BrownSpaceEngineering/EquiSat-EAGLE/projects/EQUiSat/ProgrammerBoard/OutputFiles/ProgrammerBoardV1_1_BRD.pdf

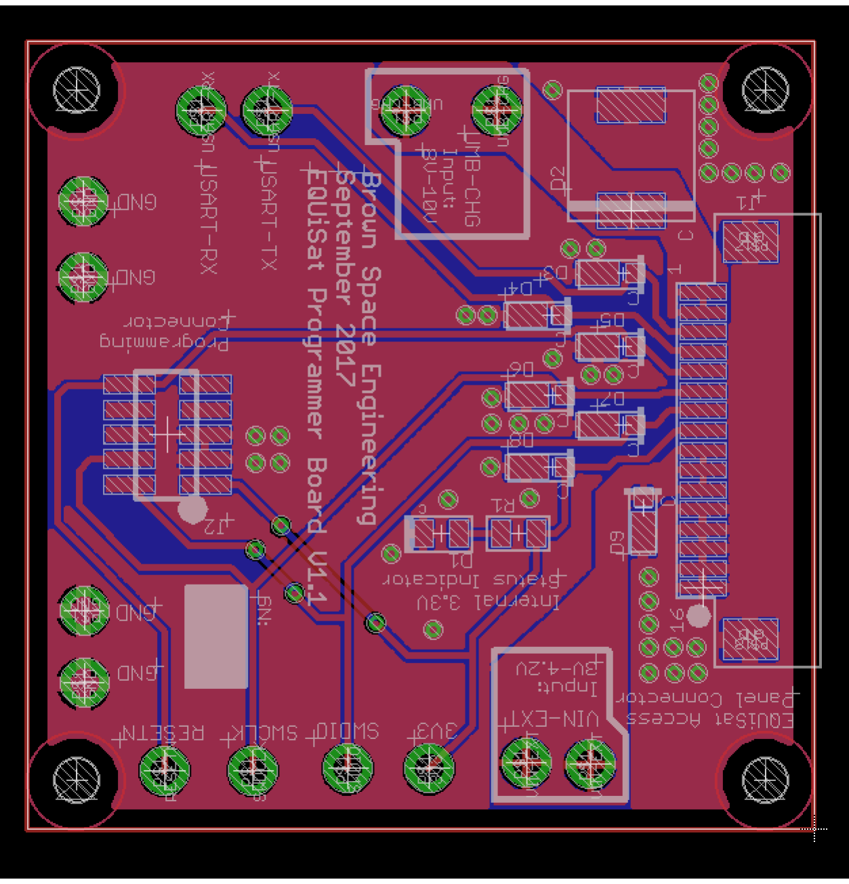
[picture p2: page 1]
