BrownSpaceEngineering/EquiSat-EAGLE/doc/EagleIDFExporterInstructions.pdf

## EAGLE

## IDF

## Exporter

## Instructions

1.

Open

.brd

file

in

the

EAGLE

application.

Run

EagleIDFExporter.ulp.

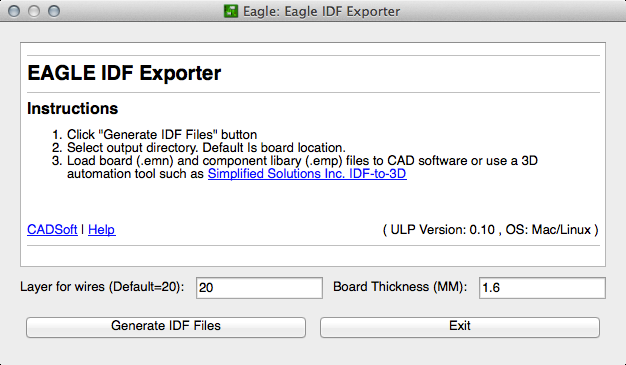
[picture p63: figure]

Update

“Layer

for

wires”

and

“Board

Thickness”

options if

you

do

not

want

to

use
the

default

values.

2.

Click

“Generate

IDF

Files.” You

will

prompted

to

select

the

directory

to

write

the
.emn

and

.emp

IDF

files.

Once

the

files

are

written

you

will

receive

a

confirmation

messages

for

the

files
written.

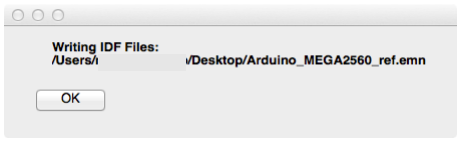
[picture p64: figure]

3.

After

writing

files

the

ULP

will

also

show

you

a

table

with the

packages written
out

to

the

files.

A

default

height

value

is

given

for

the

output

heights

of

the

packages
and

colored

in

yellow.

If

you

set

a

custom

height

the

value

will

be

shown

in

white.

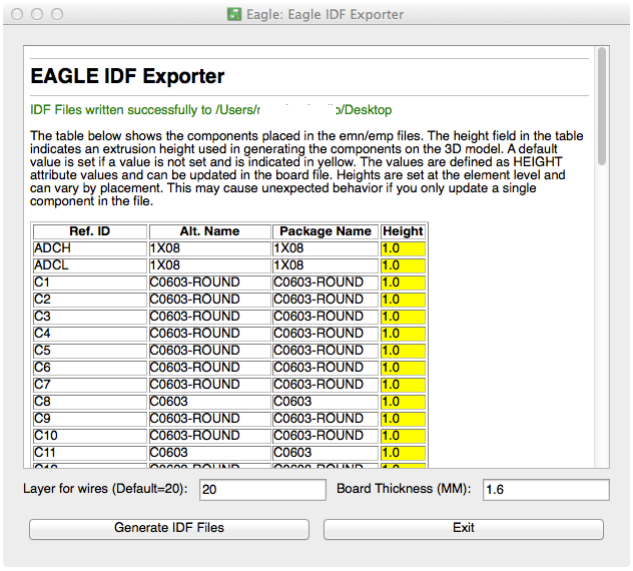
[picture p65: figure]

To

set

custom

heights

select

the

Attribute

Tool

and

then

click

on

a

package.

Create

a
new

attributed

named

HEIGHT

and

set

the

value

the

height

you

would

like

to
extrude

the

package

to.

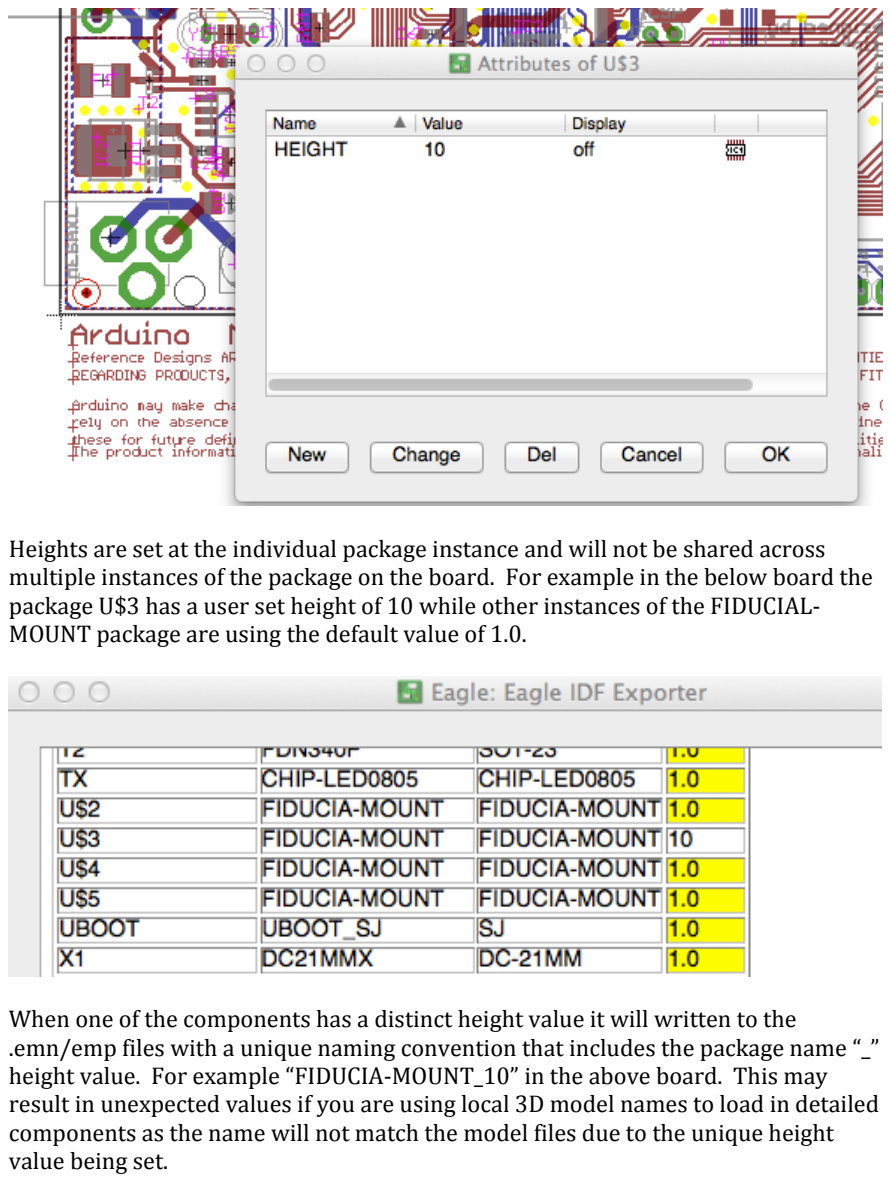
[picture p66: page 3]

Heights

are

set

at

the

individual

package

instance

and

will

not

be

shared

across
multiple

instances

of

the

package

on

the

board.

For

example

in

the

below

board

the
package

U$3

has

a

user

set

height

of

10

while

other

instances

of

the

FIDUCIAL-‐
MOUNT

package

are

using

the

default

value

of

1.0.

When

one

of

the

components

has

a

distinct

height

value

it

will

written

to

the
.emn/emp

files

with

a

unique

naming

convention

that

includes

the

package

name

“_”
height

value.

For

example

“FIDUCIA-‐MOUNT_10”

in

the

above

board.

This

may
result

in

unexpected

values

if

you

are

using

local

3D

model

names to

load

in

detailed
components

as

the

name

will

not

match

the

model

files

due

to

the

unique

height
value

being

set.
