BrownSpaceEngineering/EquiSat-EAGLE/projects/EQUiSat/ControlBoard/Gerbers/ProcessorTestBoardV2.TXT

%
M48
M72
T01C0.01575
T02C0.01969
T03C0.02000
T04C0.02400
T05C0.03150
T06C0.06000
T07C0.10000
T08C0.12500
%
T01
X55202Y103272
X113272Y135753
X163485Y111894
X177265Y84335
X199902Y103020
X223635Y78178
X191603Y58446
X203855Y146375
X176170Y196808
X162485Y212524
X171343Y231225
X194526Y213898
X209729Y212524
X207761Y227288
X236304Y207603
X146737Y229257
X126068Y197761
X133942Y195792
X104336Y209728
X67776Y225288
X44902Y205635
X66713Y191855
T02
X87217Y176312
X91217Y195312
X126217Y162312
X149217Y149312
X157217Y144312
X163217Y142312
X160217Y122312
X146737Y107209
X157217Y98312
X148217Y92312
X148217Y78312
X162217Y79312
X177217Y92312
X186217Y72312
X196217Y63312
X200217Y53312
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
