BrownSpaceEngineering/EquiSat-EAGLE/projects/EQUiSat/BatteryBoard/BatteryBoardV3OutputFiles/BatteryBoardV3_SCH.pdf

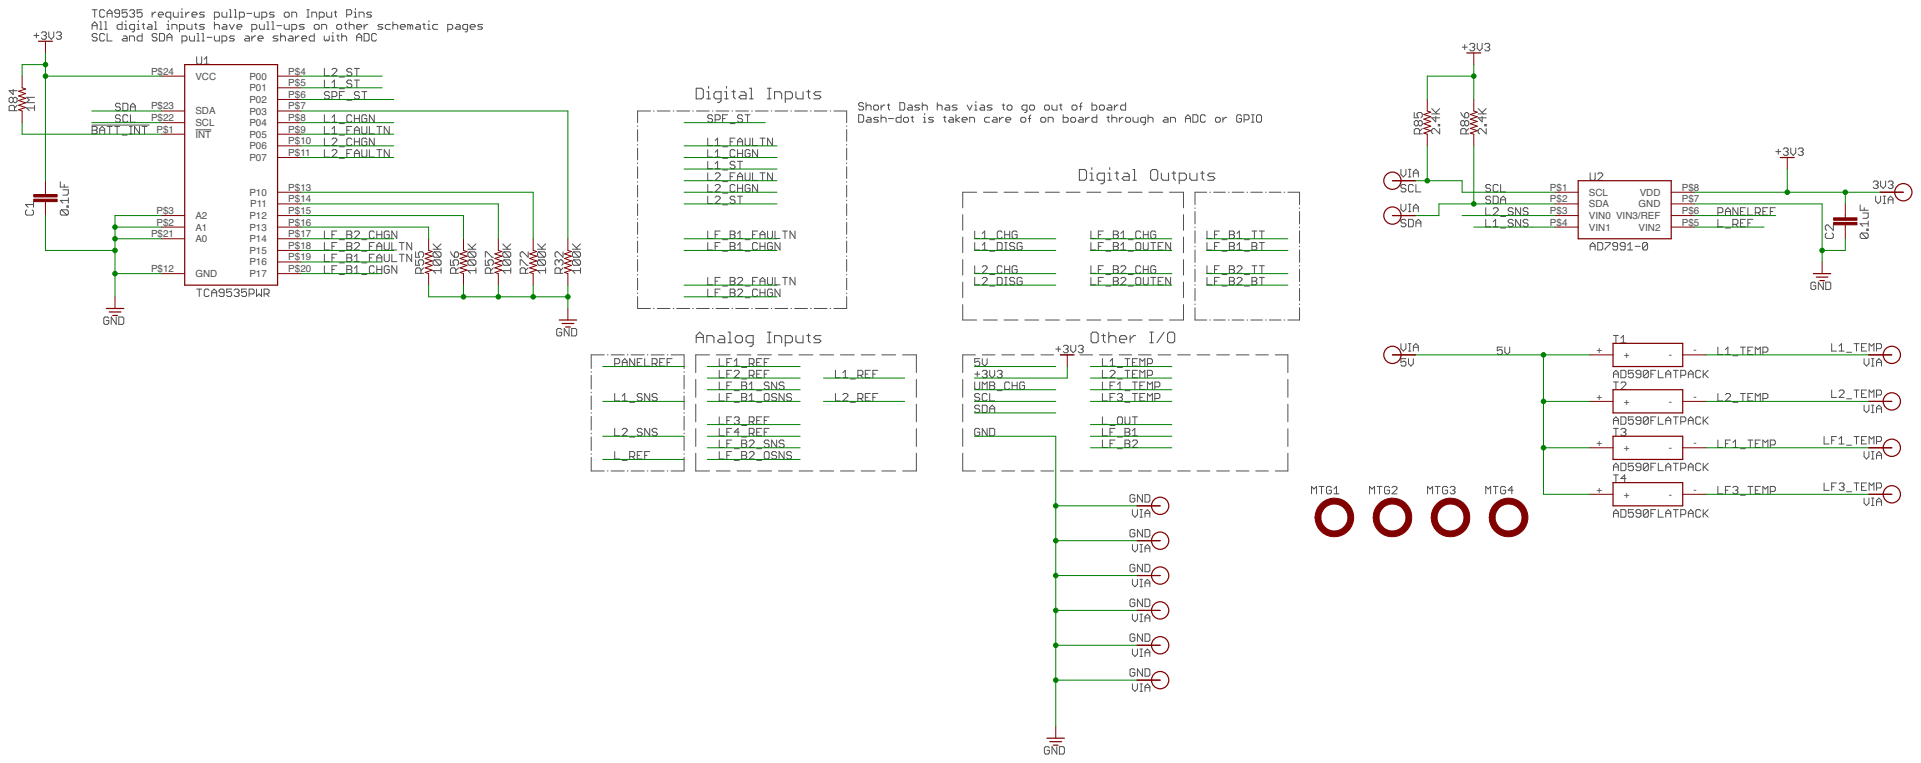
[picture p90: page 1]

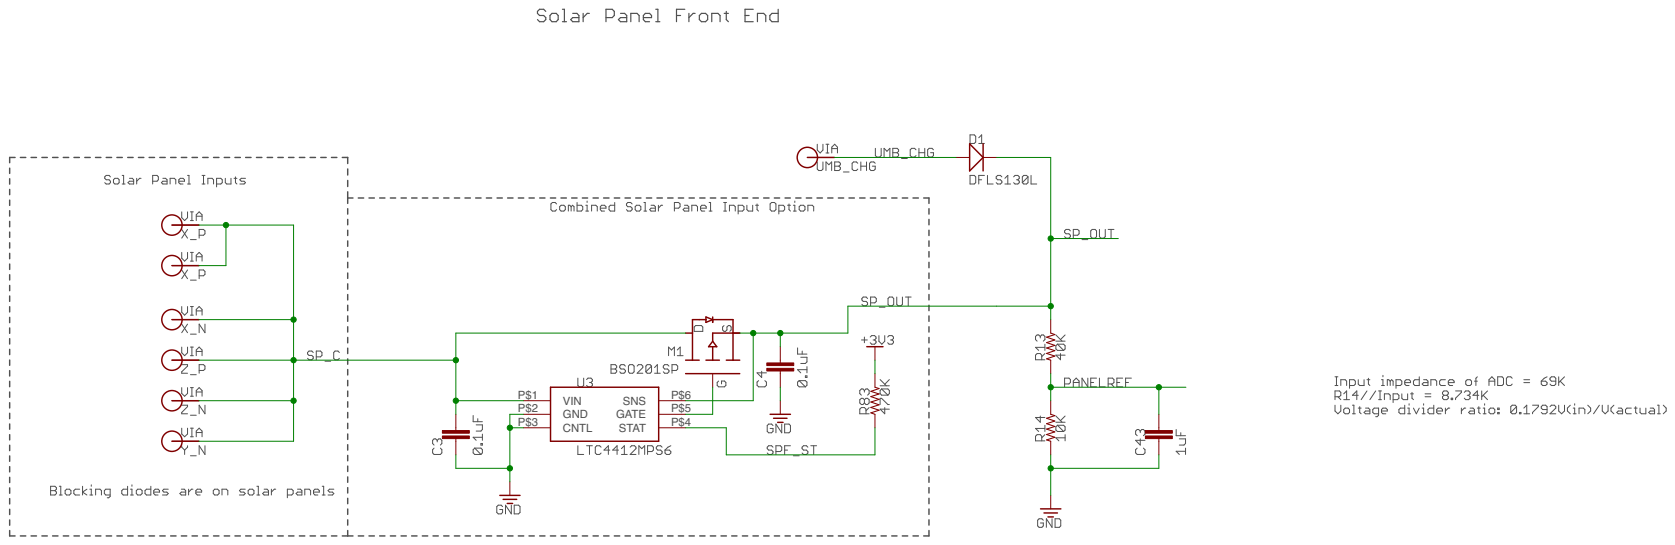
[picture p91: page 2]

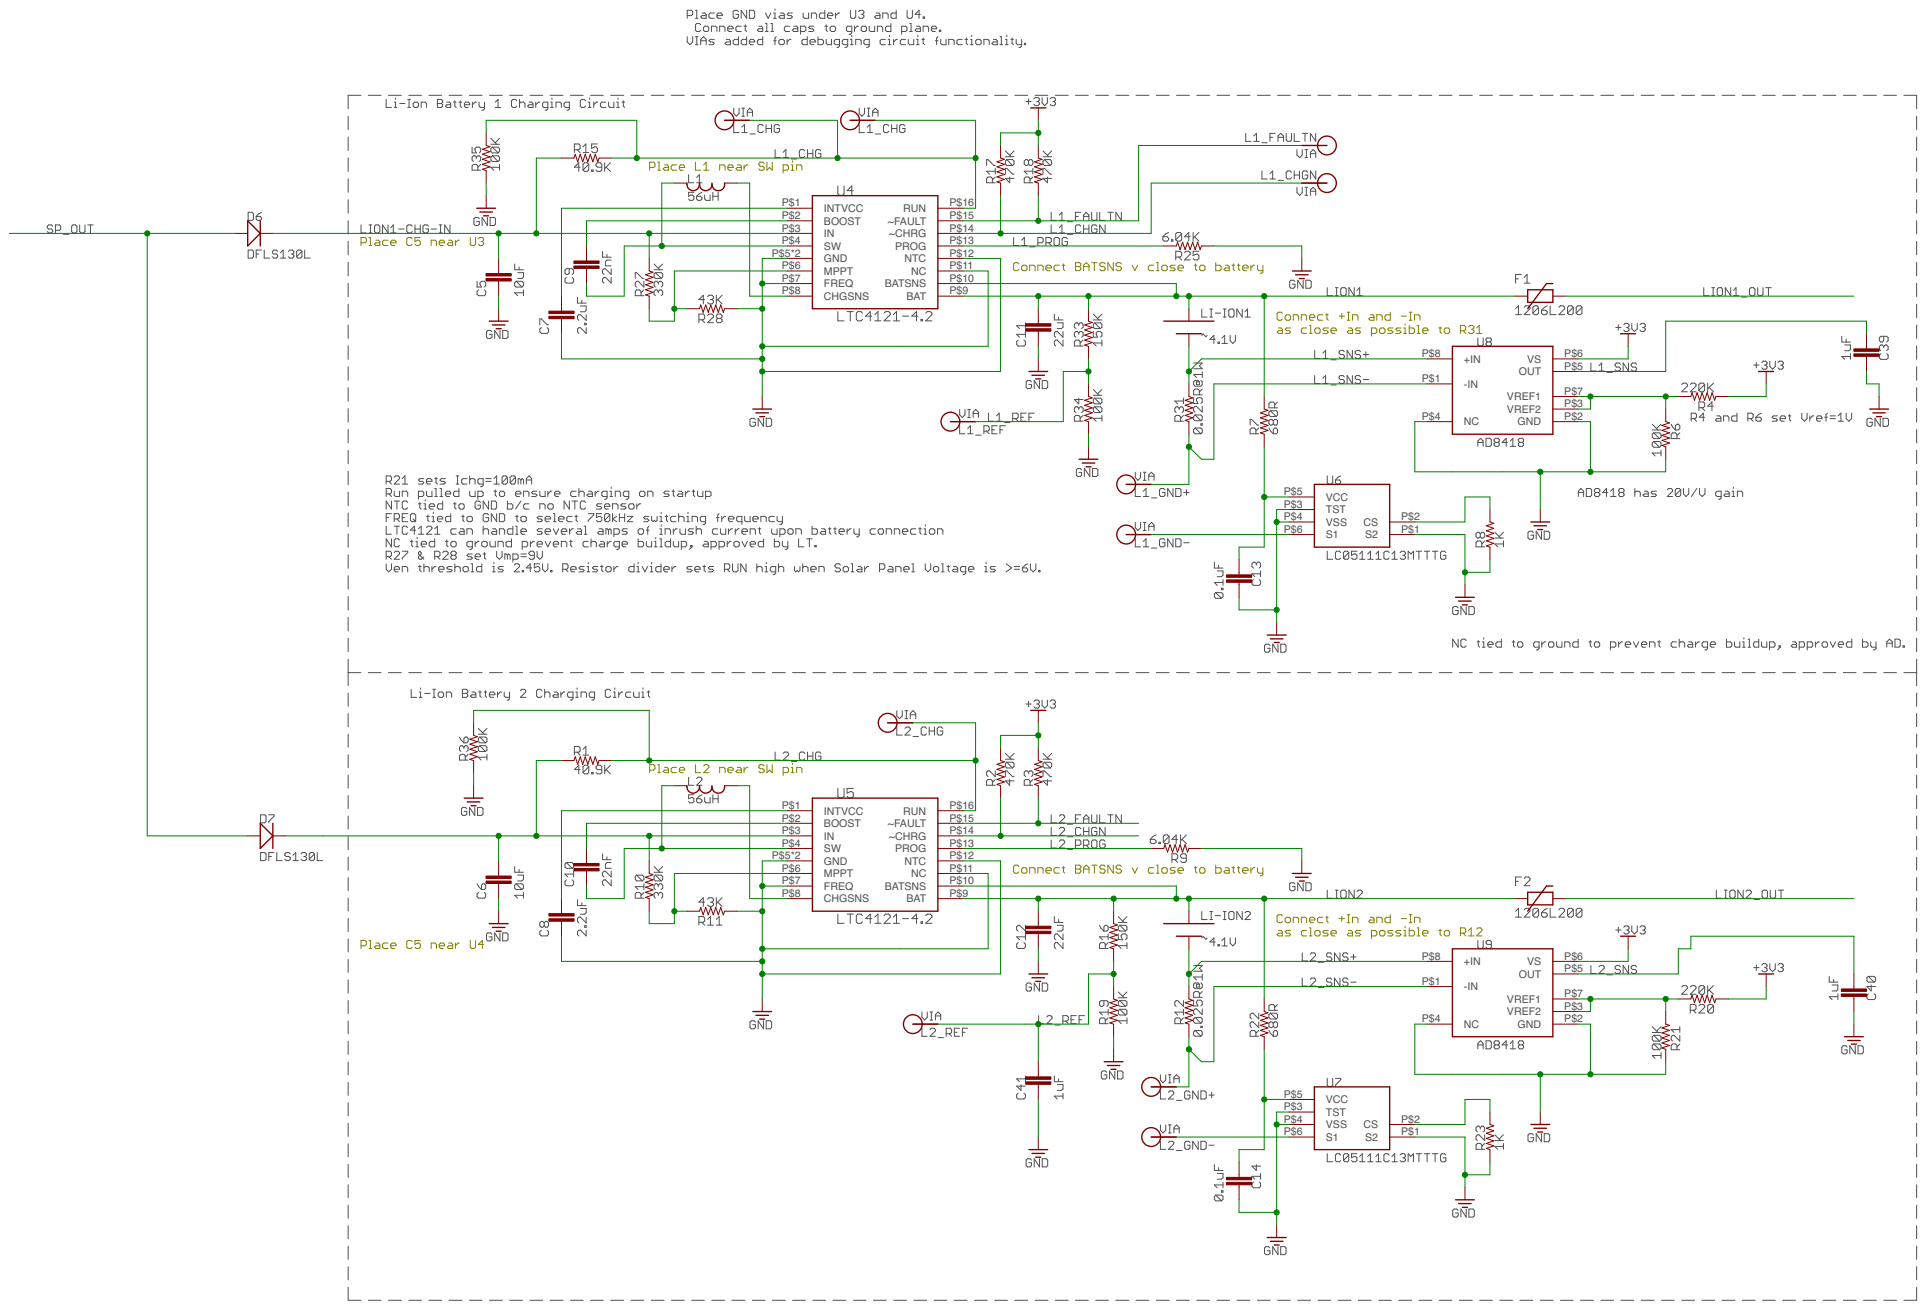
[picture p92: page 3]

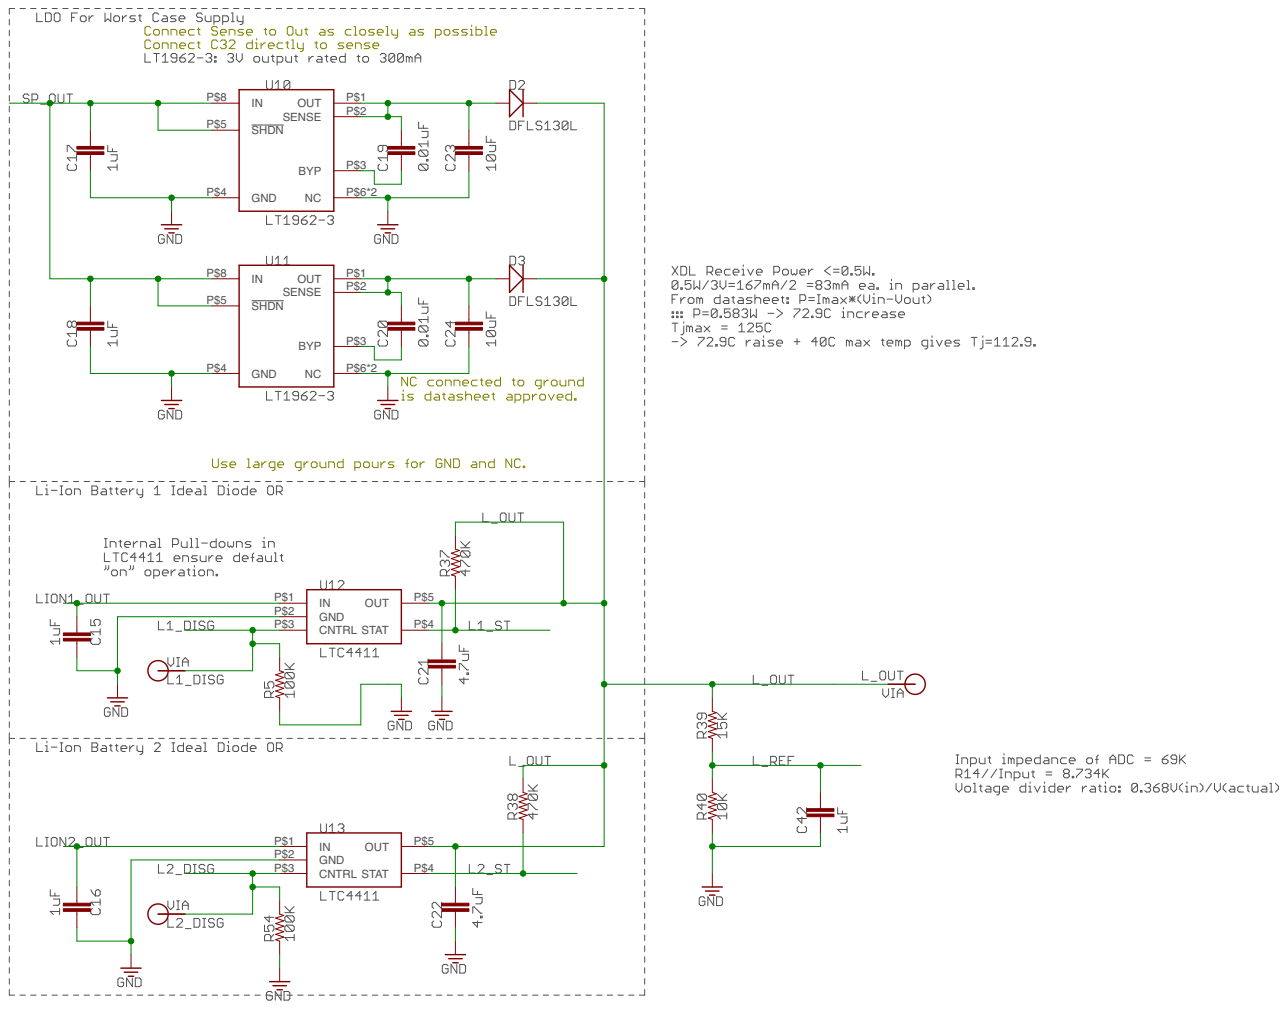
[picture p93: page 4]

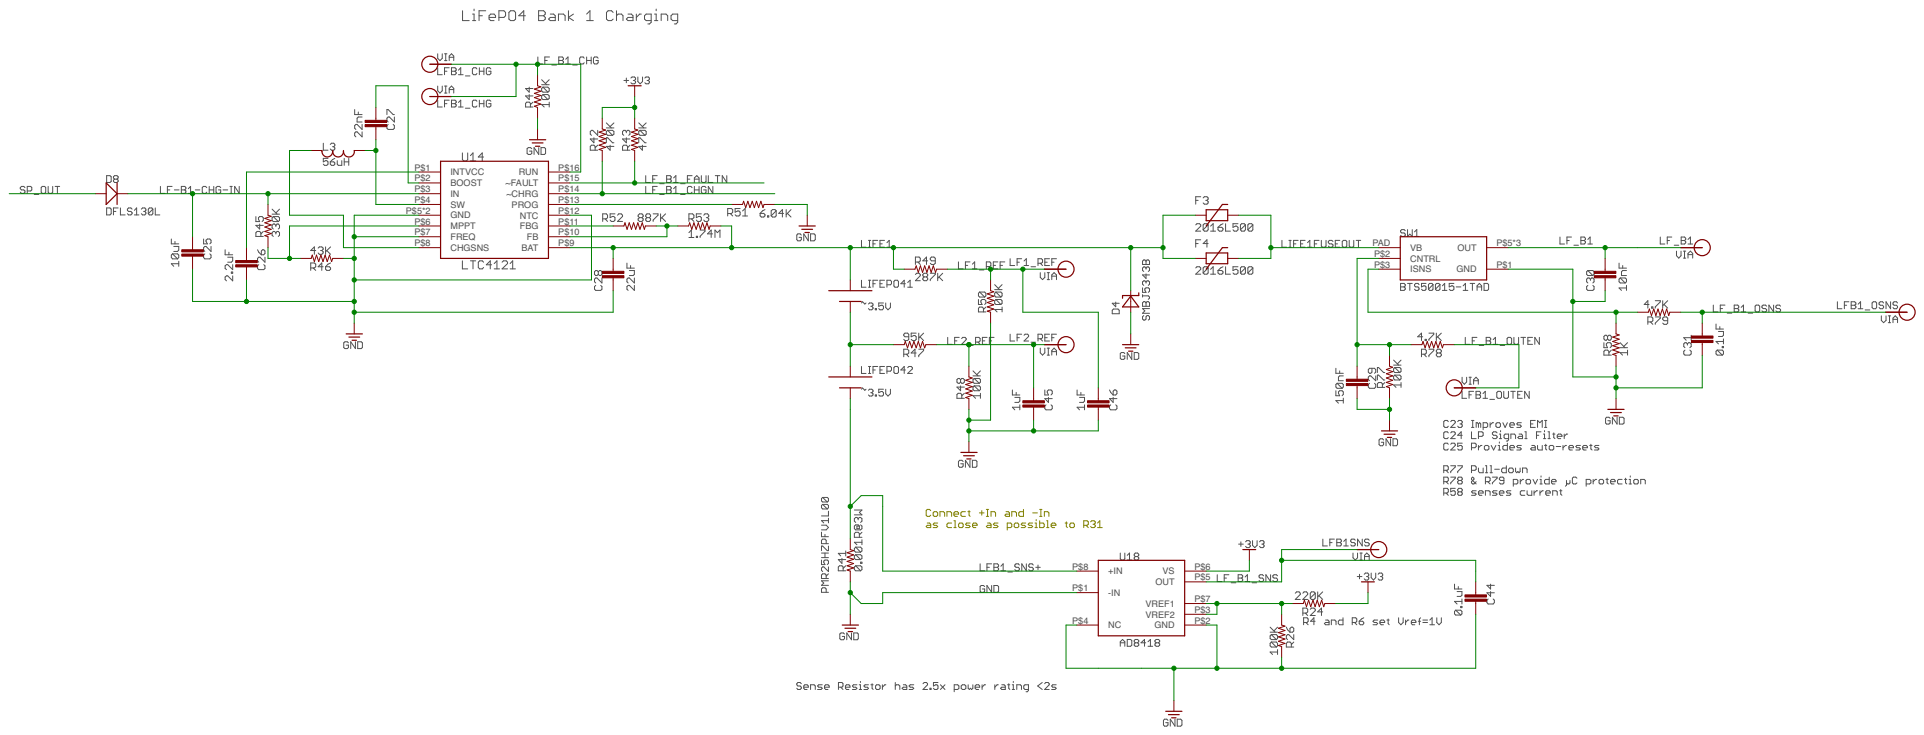
[picture p94: page 5]

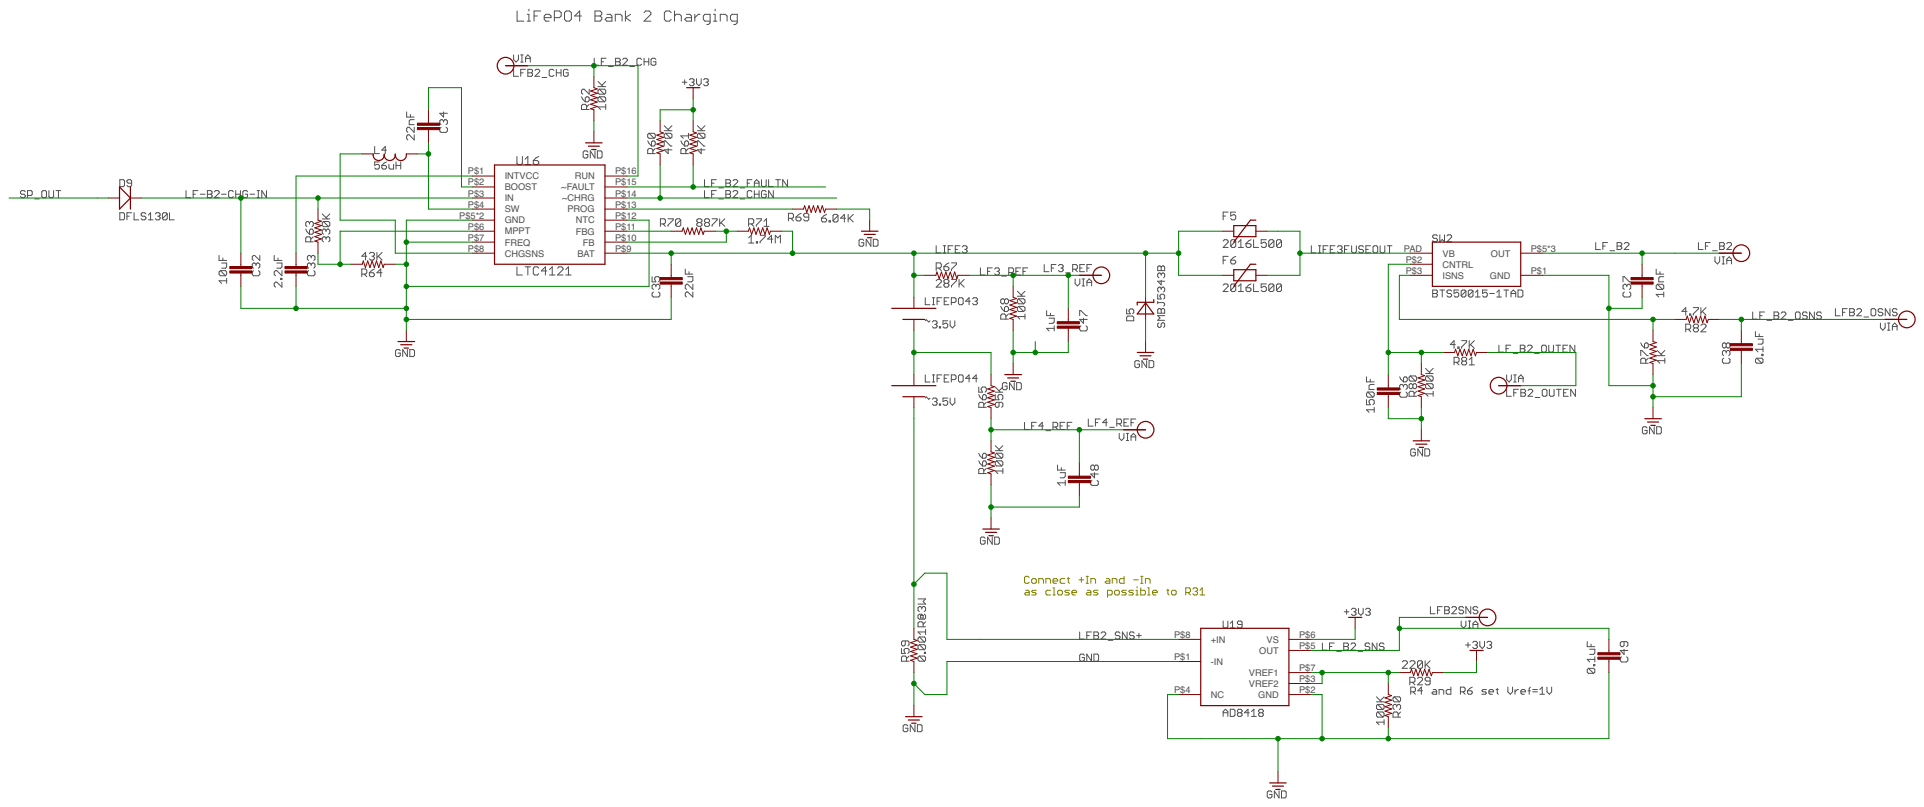
[picture p95: page 6]
