BrownSpaceEngineering/EquiSat-EAGLE/projects/EQUiSat/ProgrammerBoard/OutputFiles/ProgrammerBoardV1_1.pdf

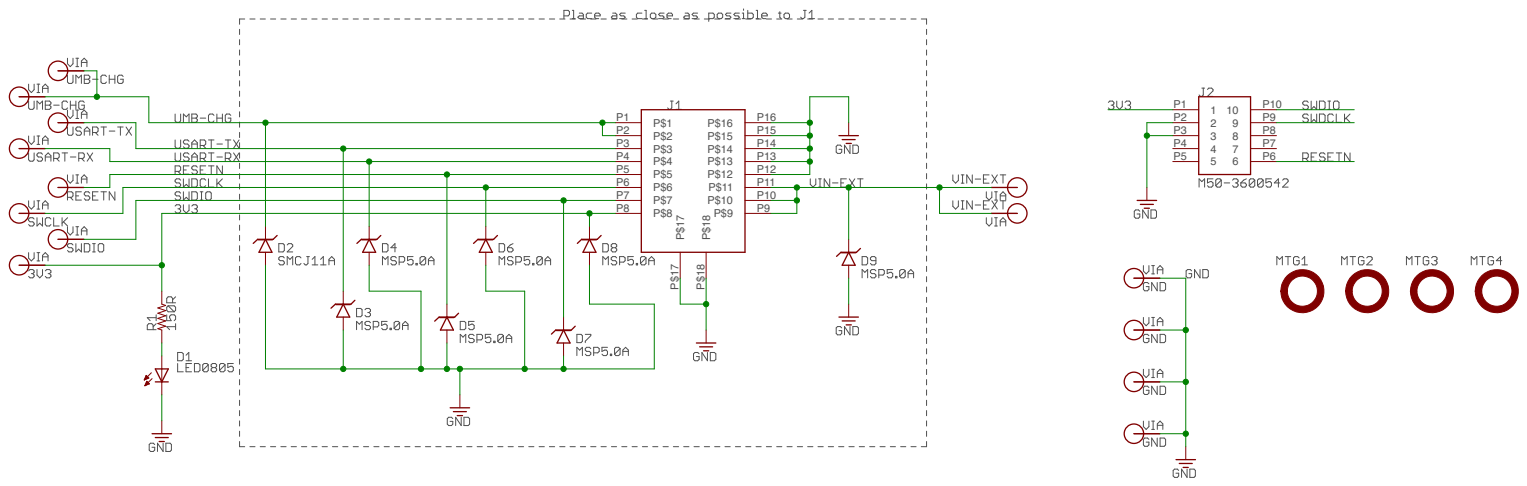
[picture p102: page 1]
