BrownSpaceEngineering/EquiSat-EAGLE/projects/EAGLETutorials/Completed Tutorial/Tutorial1.brd

## EAGLE design projects/EAGLETutorials/Completed Tutorial/Tutorial1.brd (2016-07-10)

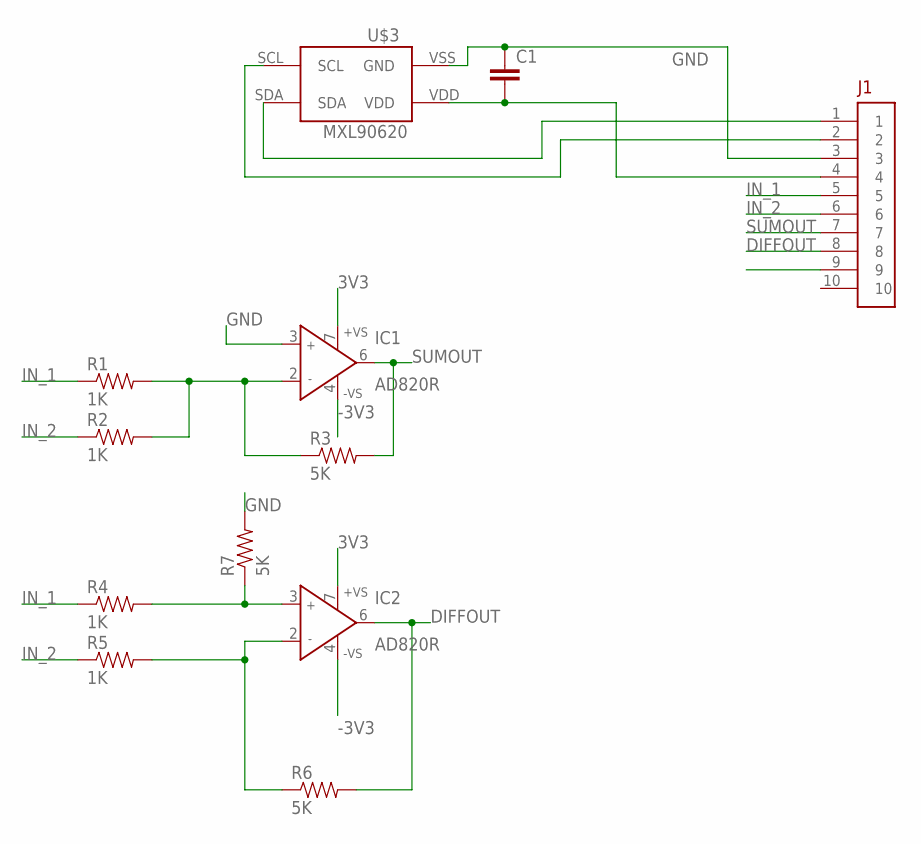
[picture p103: schematic Tutorial1.sch]

Parts:
C1: CAP0805; 0805
IC1, IC2: AD820R; SO8
J1: M50-3120545; 10PINFEMALE
R1, R2, R4, R5: 1K; 0805
R3, R6, R7: 5K; 0805
U$3: MXL90620

Connections:
3V3: C1.2, IC1.7 (+VS), IC2.7 (+VS), J1.4, U$3.VDD
-3V3: IC1.4 (-VS), IC2.4 (-VS), J1.9
DIFFOUT: IC2.6 (OUT), J1.8, R6.2
GND: C1.1, IC1.3 (IN+), J1.3, R7.2, U$3.VSS (GND)
IN_1: J1.5, R1.1, R4.1
IN_2: J1.6, R2.1, R5.1
unnamed: IC1.2 (IN-), R1.2, R2.2, R3.1
unnamed: J1.1, U$3.SDA
unnamed: J1.2, U$3.SCL
unnamed: IC2.2 (IN-), R5.2, R6.1
unnamed: IC2.3 (IN+), R4.2, R7.1
SUMOUT: IC1.6 (OUT), J1.7, R3.2

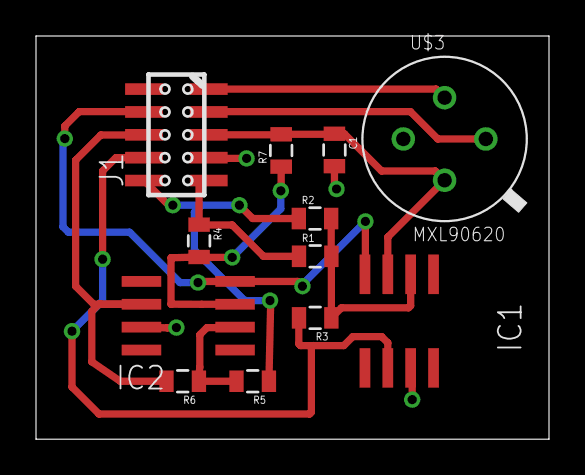
[picture p104: board Tutorial1.brd from above]

Board: 2 copper layers, 28.5 x 22.4 mm, 12 parts (0 on the bottom side), 12 nets.
