BrownSpaceEngineering/EquiSat-EAGLE/projects/EQUiSat/ControlBoard/CntrlBoardV3B.brd

## EAGLE design projects/EQUiSat/ControlBoard/CntrlBoardV3B.brd (2017-10-26)

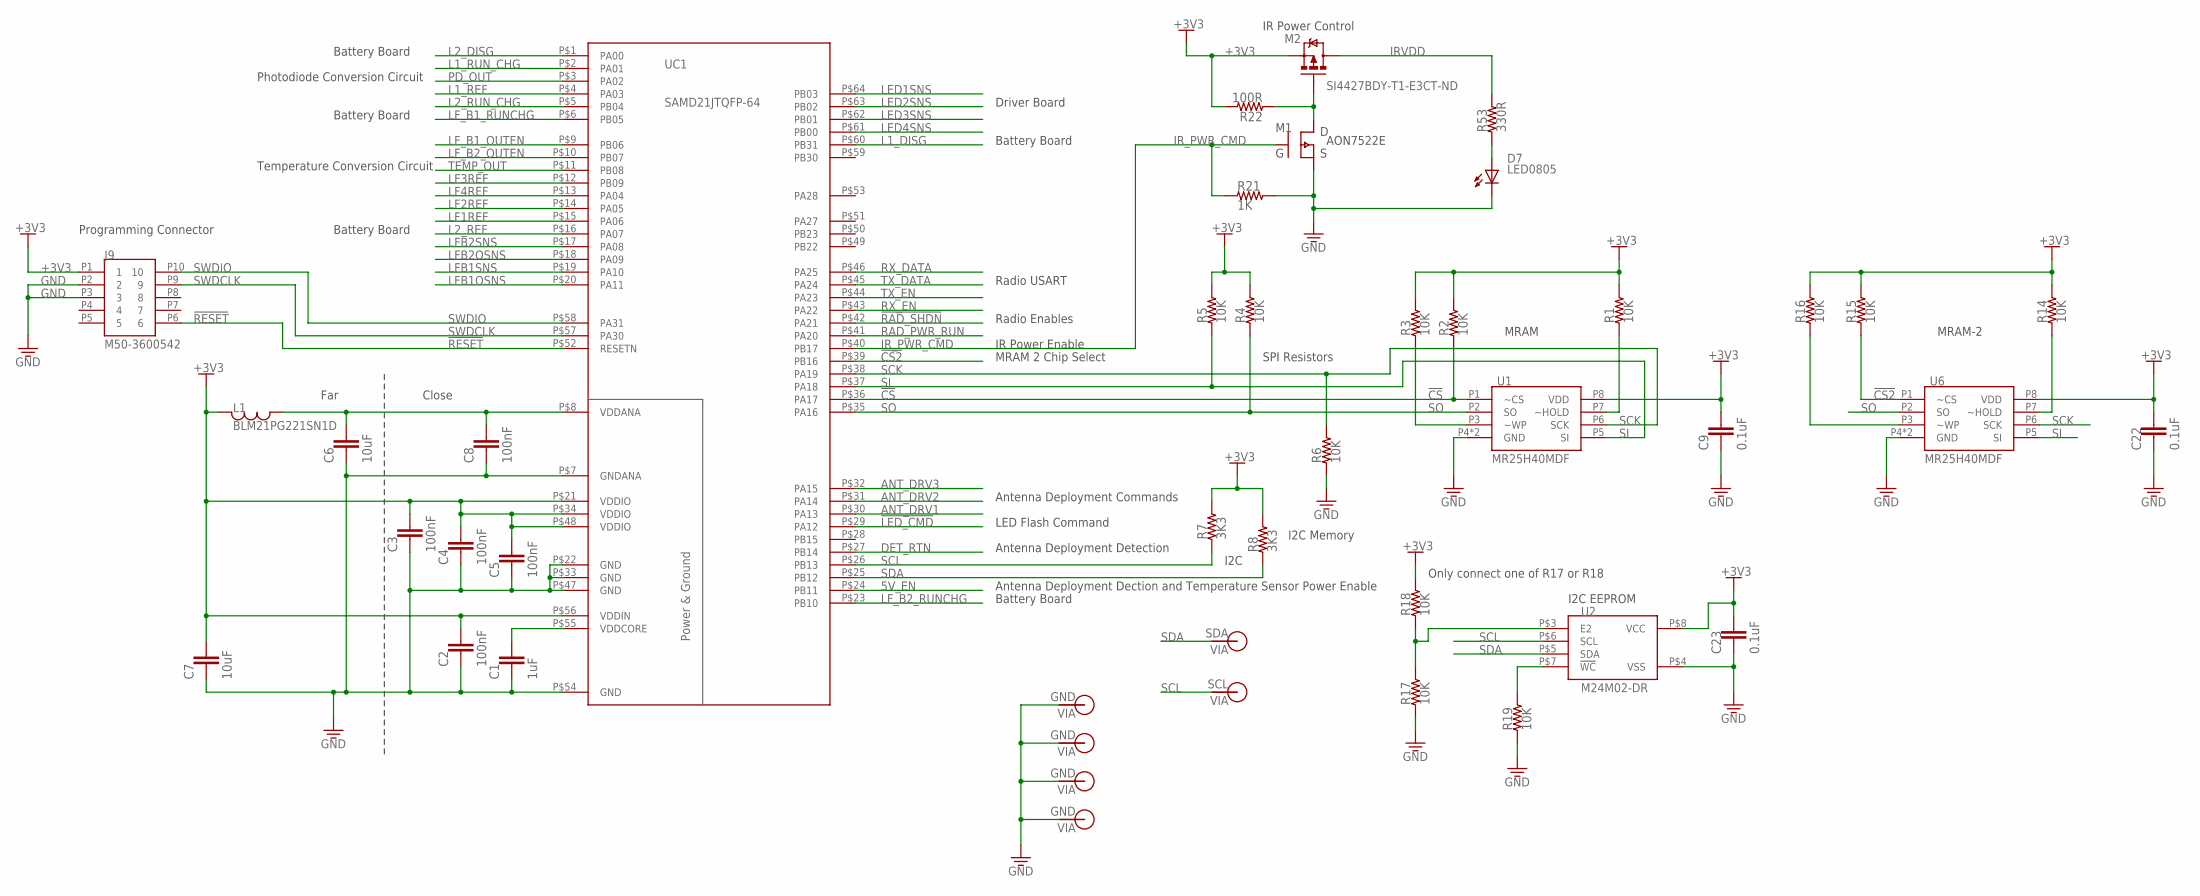
[picture p105: schematic CntrlBoardV3B.sch, sheet 1, µC, MRAM, I2C Memory, and Peripherals]

Parts:
C1: 1uF; 0805
C2, C3, C4, C5, C8: 100nF; 0805
C6, C7: 10uF; 0805
C9, C22, C23: 0.1uF; 0805
D7: LED0805; 0805-D
J9: M50-3600542; 10PINMALE
L1: BLM21PG221SN1D; 0805
M1: AON7522E; DFN-3X3-8
M2: SI4427BDY-T1-E3CT-ND; SO08
R1, R2, R3, R4, R5, R6, R14, R15, R16, R17, R18, R19: 10K; 0805
R7, R8: 3K3; 0805
R21: 1K; 0805
R22: 100R; 0805
R53: 330R; 0805
U1, U6: MR25H40MDF; 8PXMO-229
U2: M24M02-DR; SO-8
UC1: SAMD21JTQFP-64; TQFP-64
V4: SDA; VIA-60MIL-SQ
V5: SCL; VIA-60MIL-SQ
V9, V10, V11, V12: GND; VIA-60MIL-SQ

Connections:
5V_EN: UC1.P$24 (PB11); also elsewhere on the board
!CS2!: R15.1, U6.P1 (~CS), UC1.P$39 (PB16)
!CS!: R2.1, U1.P1 (~CS), UC1.P$36 (PA17)
!LED_CMD!: UC1.P$29 (PA12); also elsewhere on the board
!RAD_SHDN!: UC1.P$42 (PA21); also elsewhere on the board
!RESET!: J9.P6 (6), UC1.P$52 (RESETN); also elsewhere on the board
+3V3: C2.1, C3.1, C4.1, C5.1, C7.1, C9.1, C22.1, C23.1, J9.P1 (1), L1.1, M2.1 (S), M2.2 (S), M2.3 (S), R1.2, R2.2, R3.2, R4.2, R5.2, R7.2, R8.2, R14.2, R15.2, R16.2, R18.2, R22.2, U1.P8 (VDD), U2.P$8 (VCC), U6.P8 (VDD), UC1.P$21 (VDDIO), UC1.P$34 (VDDIO), UC1.P$48 (VDDIO), UC1.P$56 (VDDIN); also elsewhere on the board
ANT_DRV1: UC1.P$30 (PA13); also elsewhere on the board
ANT_DRV2: UC1.P$31 (PA14); also elsewhere on the board
ANT_DRV3: UC1.P$32 (PA15); also elsewhere on the board
DET_RTN: UC1.P$27 (PB14); also elsewhere on the board
GND: C1.2, C2.2, C3.2, C4.2, C5.2, C6.2, C7.2, C8.2, C9.2, C22.2, C23.2, D7.C, J9.P2 (2), J9.P3 (3), M1.P$1 (S), M1.P$2 (S), M1.P$3 (S), R6.1, R17.1, R19.1, R21.2, U1.P4 (GND), U1.P9 (GND), U2.P$4 (VSS), U6.P4 (GND), U6.P9 (GND), UC1.P$7 (GNDANA), UC1.P$22 (GND), UC1.P$33 (GND), UC1.P$47 (GND), UC1.P$54 (GND), V9.P$1, V10.P$1, V11.P$1, V12.P$1; also elsewhere on the board
IRVDD: M2.5 (D), M2.6 (D), M2.7 (D), M2.8 (D), R53.2; also elsewhere on the board
IR_PWR_CMD: M1.P$4 (G), R21.1, UC1.P$40 (PB17)
L1_DISG: UC1.P$60 (PB31); also elsewhere on the board
L1_REF: UC1.P$4 (PA03); also elsewhere on the board
L1_RUN_CHG: UC1.P$2 (PA01); also elsewhere on the board
L2_DISG: UC1.P$1 (PA00); also elsewhere on the board
L2_REF: UC1.P$16 (PA07); also elsewhere on the board
L2_RUN_CHG: UC1.P$5 (PB04); also elsewhere on the board
LED1SNS: UC1.P$64 (PB03); also elsewhere on the board
LED2SNS: UC1.P$63 (PB02); also elsewhere on the board
LED3SNS: UC1.P$62 (PB01); also elsewhere on the board
LED4SNS: UC1.P$61 (PB00); also elsewhere on the board
LF1REF: UC1.P$15 (PA06); also elsewhere on the board
LF2REF: UC1.P$14 (PA05); also elsewhere on the board
LF3REF: UC1.P$12 (PB09); also elsewhere on the board
LF4REF: UC1.P$13 (PA04); also elsewhere on the board
LFB1OSNS: UC1.P$20 (PA11); also elsewhere on the board
LFB1SNS: UC1.P$19 (PA10); also elsewhere on the board
LFB2OSNS: UC1.P$18 (PA09); also elsewhere on the board
LFB2SNS: UC1.P$17 (PA08); also elsewhere on the board
LF_B1_OUTEN: UC1.P$9 (PB06); also elsewhere on the board
LF_B1_RUNCHG: UC1.P$6 (PB05); also elsewhere on the board
LF_B2_OUTEN: UC1.P$10 (PB07); also elsewhere on the board
LF_B2_RUNCHG: UC1.P$23 (PB10); also elsewhere on the board
unnamed: C6.1, C8.1, L1.2, UC1.P$8 (VDDANA)
unnamed: C1.1, UC1.P$55 (VDDCORE)
unnamed: R3.1, U1.P3 (~WP)
unnamed: R1.1, U1.P7 (~HOLD)
unnamed: R16.1, U6.P3 (~WP)
unnamed: R14.1, U6.P7 (~HOLD)
unnamed: R17.2, R18.1, U2.P$3 (E2)
unnamed: R19.2, U2.P$7 (!WC!)
unnamed: M1.P$5 (D), M1.P$6 (D), M1.P$7 (D), M1.P$8 (D), M1.PAD (D), M2.4 (G), R22.1
unnamed: D7.A, R53.1
PD_OUT: UC1.P$3 (PA02); also elsewhere on the board
RAD_PWR_RUN: UC1.P$41 (PA20); also elsewhere on the board
RX_DATA: UC1.P$46 (PA25); also elsewhere on the board
RX_EN: UC1.P$43 (PA22); also elsewhere on the board
SCK: R6.2, U1.P6 (SCK), U6.P6 (SCK), UC1.P$38 (PA19)
SCL: R7.1, U2.P$6 (SCL), UC1.P$26 (PB13), V5.P$1; also elsewhere on the board
SDA: R8.1, U2.P$5 (SDA), UC1.P$25 (PB12), V4.P$1; also elsewhere on the board
SI: R5.1, U1.P5 (SI), U6.P5 (SI), UC1.P$37 (PA18)
SO: R4.1, U1.P2 (SO), U6.P2 (SO), UC1.P$35 (PA16)
SWDCLK: J9.P9 (9), UC1.P$57 (PA30); also elsewhere on the board
SWDIO: J9.P10 (10), UC1.P$58 (PA31); also elsewhere on the board
TEMP_OUT: UC1.P$11 (PB08); also elsewhere on the board
TX_DATA: UC1.P$45 (PA24); also elsewhere on the board
TX_EN: UC1.P$44 (PA23); also elsewhere on the board

Notes on the sheet:
Close
Far
Programming Connector
MRAM
I2C Memory
I2C
Battery Board
Temperature Conversion Circuit
Photodiode Conversion Circuit
Radio USART
IR Power Enable
Radio Enables
Antenna Deployment Commands
LED Flash Command
Antenna Deployment Detection
Antenna Deployment Dection and Temperature Sensor Power Enable
MRAM-2
MRAM 2 Chip Select
SPI Resistors
Only connect one of R17 or R18
I2C EEPROM
IR Power Control
Driver Board

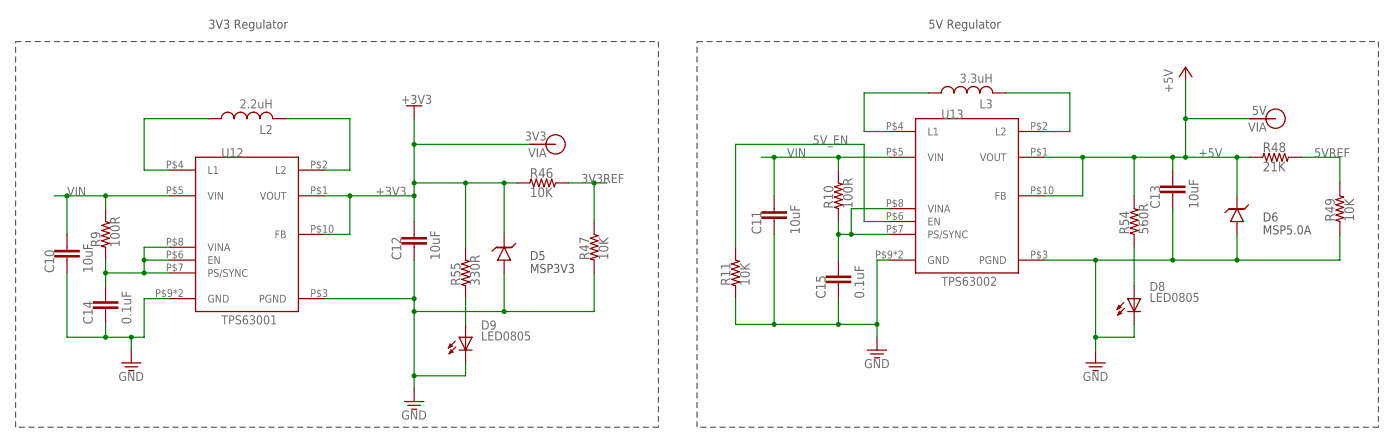
[picture p106: schematic CntrlBoardV3B.sch, sheet 2, Power Regulation]

Parts:
C10, C11, C12, C13: 10uF; 0805
C14, C15: 0.1uF; 0805
D5: MSP3V3; MICROSMP
D6: MSP5.0A; MICROSMP
D8, D9: LED0805; 0805-D
L2: 2.2uH; L3225M
L3: 3.3uH; L3225M
R9, R10: 100R; 0805
R11, R46, R47, R49: 10K; 0805
R48: 21K; 0805
R54: 560R; 0805
R55: 330R; 0805
U12: TPS63001; QFN10_POWERPAD
U13: TPS63002; QFN10_POWERPAD
V13: 3V3; VIA-60MIL-SQ
V14: 5V; VIA-60MIL-SQ

Connections:
3V3REF: R46.2, R47.2; also elsewhere on the board
5VREF: R48.2, R49.2; also elsewhere on the board
5V_EN: R11.2, U13.P$6 (EN); also elsewhere on the board
+3V3: C12.1, D5.C, R46.1, R55.2, U12.P$1 (VOUT), U12.P$10 (FB), V13.P$1; also elsewhere on the board
+5V: C13.1, D6.C, R48.1, R54.2, U13.P$1 (VOUT), U13.P$10 (FB), V14.P$1; also elsewhere on the board
GND: C10.2, C11.2, C12.2, C13.2, C14.2, C15.2, D5.A, D6.A, D8.C, D9.C, R11.1, R47.1, R49.1, U12.P$3 (PGND), U12.P$9 (GND), U12.PAD (GND), U13.P$3 (PGND), U13.P$9 (GND), U13.PAD (GND); also elsewhere on the board
unnamed: L2.1, U12.P$4 (L1)
unnamed: L2.2, U12.P$2 (L2)
unnamed: L3.1, U13.P$4 (L1)
unnamed: L3.2, U13.P$2 (L2)
unnamed: C14.1, R9.1, U12.P$6 (EN), U12.P$7 (PS/SYNC), U12.P$8 (VINA)
unnamed: C15.1, R10.1, U13.P$7 (PS/SYNC), U13.P$8 (VINA)
unnamed: D8.A, R54.1
unnamed: D9.A, R55.1
VIN: C10.1, C11.1, R9.2, R10.2, U12.P$5 (VIN), U13.P$5 (VIN); also elsewhere on the board

Notes on the sheet:
3V3 Regulator
5V Regulator

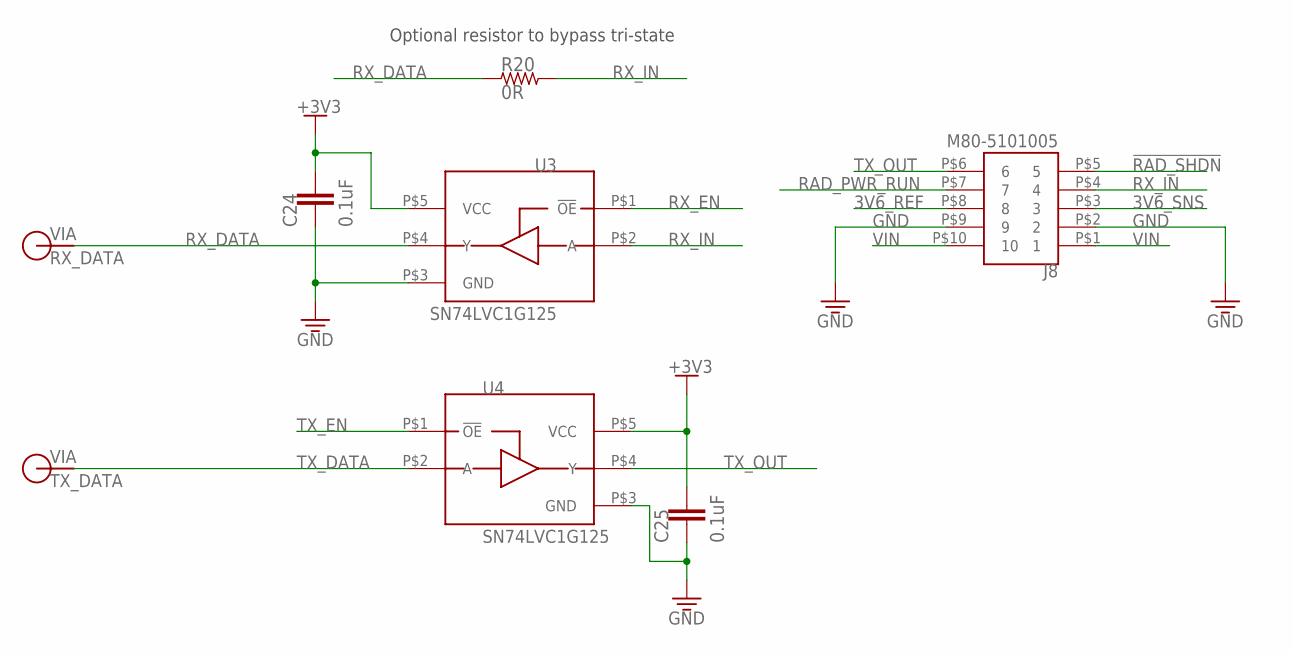
[picture p107: schematic CntrlBoardV3B.sch, sheet 3, Radio]

Parts:
C24, C25: 0.1uF; 0805
J8: M80-5101005; M80-510
R20: 0R; 0805
U3, U4: SN74LVC1G125; TSOT23-5
V1: RX_DATA; VIA-60MIL-SQ
V2: TX_DATA; VIA-60MIL-SQ

Connections:
3V6_REF: J8.P$8 (8); also elsewhere on the board
3V6_SNS: J8.P$3 (3); also elsewhere on the board
!RAD_SHDN!: J8.P$5 (5); also elsewhere on the board
+3V3: C24.1, C25.1, U3.P$5 (VCC), U4.P$5 (VCC); also elsewhere on the board
GND: C24.2, C25.2, J8.P$2 (2), J8.P$9 (9), U3.P$3 (GND), U4.P$3 (GND); also elsewhere on the board
RAD_PWR_RUN: J8.P$7 (7); also elsewhere on the board
RX_DATA: R20.1, U3.P$4 (Y), V1.P$1; also elsewhere on the board
RX_EN: U3.P$1 (!OE!); also elsewhere on the board
RX_IN: J8.P$4 (4), R20.2, U3.P$2 (A)
TX_DATA: U4.P$2 (A), V2.P$1; also elsewhere on the board
TX_EN: U4.P$1 (!OE!); also elsewhere on the board
TX_OUT: J8.P$6 (6), U4.P$4 (Y)
VIN: J8.P$1 (1), J8.P$10 (10); also elsewhere on the board

Notes on the sheet:
Optional resistor to bypass tri-state

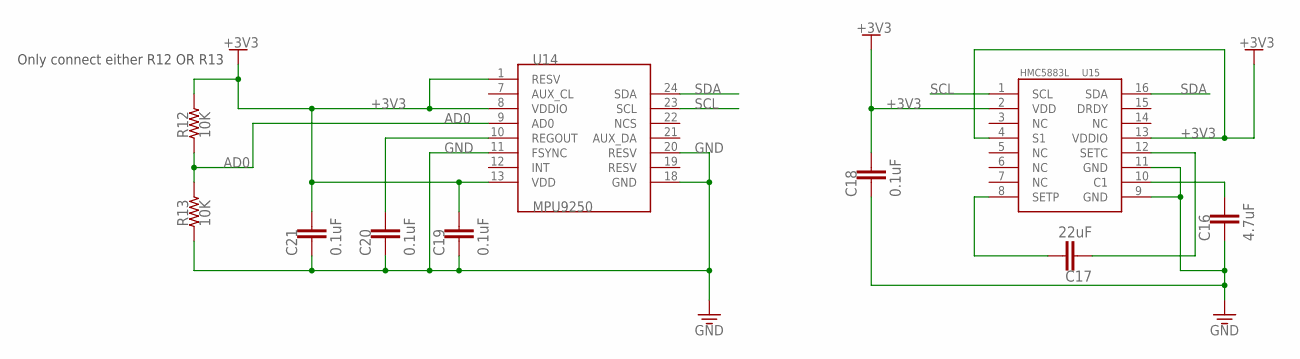
[picture p108: schematic CntrlBoardV3B.sch, sheet 4, Control Board Sensors]

Parts:
C16: 4.7uF; 0805
C17: 22uF; 0805
C18, C19, C20, C21: 0.1uF; 0805
R12, R13: 10K; 0805
U14: MPU9250; QFN-24-3X3
U15: HMC5883L

Connections:
+3V3: C18.1, C19.1, C21.1, R12.2, U14.1 (RESV), U14.8 (VDDIO), U14.13 (VDD), U15.2 (VDD), U15.4 (S1), U15.13 (VDDIO); also elsewhere on the board
AD0: R12.1, R13.2, U14.9 (AD0)
GND: C16.2, C18.2, C19.2, C20.2, C21.2, R13.1, U14.11 (FSYNC), U14.18 (GND), U14.20 (RESV), U15.9 (GND), U15.11 (GND); also elsewhere on the board
unnamed: C16.1, U15.10 (C1)
unnamed: C20.1, U14.10 (REGOUT)
unnamed: C17.2, U15.12 (SETC)
unnamed: C17.1, U15.8 (SETP)
SCL: U14.23 (SCL), U15.1 (SCL); also elsewhere on the board
SDA: U14.24 (SDA), U15.16 (SDA); also elsewhere on the board

Notes on the sheet:
Only connect either R12 OR R13

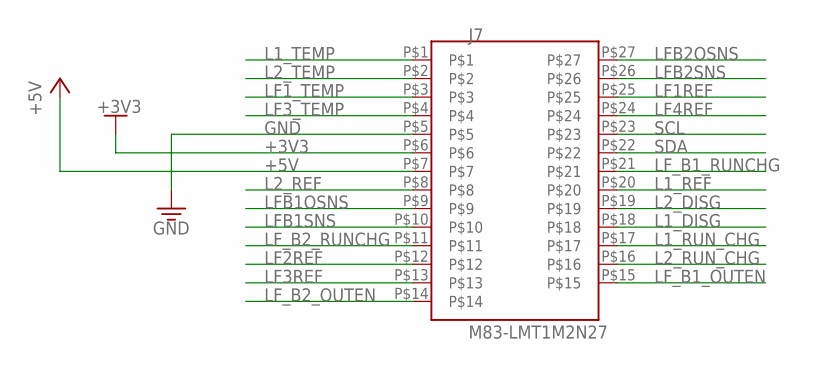
[picture p109: schematic CntrlBoardV3B.sch, sheet 5, Battery Board]

Parts:
J7: M83-LMT1M2N27

Connections:
+3V3: J7.P$6; also elsewhere on the board
+5V: J7.P$7; also elsewhere on the board
GND: J7.P$5; also elsewhere on the board
L1_DISG: J7.P$18; also elsewhere on the board
L1_REF: J7.P$20; also elsewhere on the board
L1_RUN_CHG: J7.P$17; also elsewhere on the board
L1_TEMP: J7.P$1; also elsewhere on the board
L2_DISG: J7.P$19; also elsewhere on the board
L2_REF: J7.P$8; also elsewhere on the board
L2_RUN_CHG: J7.P$16; also elsewhere on the board
L2_TEMP: J7.P$2; also elsewhere on the board
LF1REF: J7.P$25; also elsewhere on the board
LF1_TEMP: J7.P$3; also elsewhere on the board
LF2REF: J7.P$12; also elsewhere on the board
LF3REF: J7.P$13; also elsewhere on the board
LF3_TEMP: J7.P$4; also elsewhere on the board
LF4REF: J7.P$24; also elsewhere on the board
LFB1OSNS: J7.P$9; also elsewhere on the board
LFB1SNS: J7.P$10; also elsewhere on the board
LFB2OSNS: J7.P$27; also elsewhere on the board
LFB2SNS: J7.P$26; also elsewhere on the board
LF_B1_OUTEN: J7.P$15; also elsewhere on the board
LF_B1_RUNCHG: J7.P$21; also elsewhere on the board
LF_B2_OUTEN: J7.P$14; also elsewhere on the board
LF_B2_RUNCHG: J7.P$11; also elsewhere on the board
SCL: J7.P$23; also elsewhere on the board
SDA: J7.P$22; also elsewhere on the board

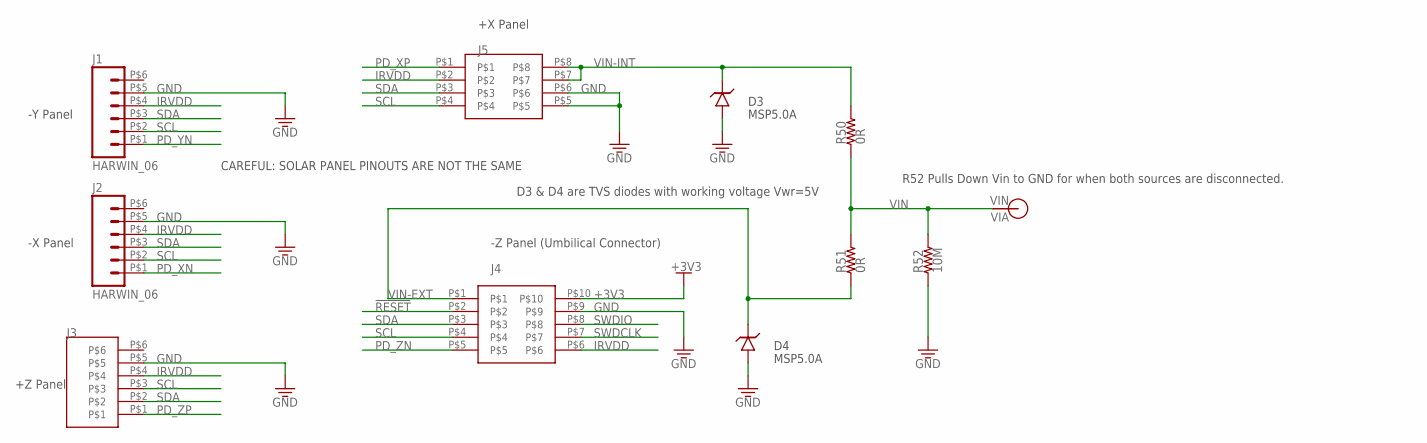
[picture p110: schematic CntrlBoardV3B.sch, sheet 6, Solar Panels]

Parts:
D3, D4: MSP5.0A; MICROSMP
J1, J2: HARWIN_06; HARWIN_DATAMATE_6
J3: M80-54006
J4: M80-54010
J5: M80-54008
R50, R51: 0R; 1210
R52: 10M; 0805
V3: VIN; VIA-60MIL-SQ

Connections:
!RESET!: J4.P$2; also elsewhere on the board
+3V3: J4.P$10; also elsewhere on the board
GND: D3.A, D4.A, J1.P$5 (5), J2.P$5 (5), J3.P$5, J4.P$9, J5.P$5, J5.P$6, R52.1; also elsewhere on the board
IRVDD: J1.P$4 (4), J2.P$4 (4), J3.P$4, J4.P$6, J5.P$2; also elsewhere on the board
PD_XN: J2.P$1 (1); also elsewhere on the board
PD_XP: J5.P$1; also elsewhere on the board
PD_YN: J1.P$1 (1); also elsewhere on the board
PD_ZN: J4.P$5; also elsewhere on the board
PD_ZP: J3.P$1; also elsewhere on the board
SCL: J1.P$2 (2), J2.P$2 (2), J3.P$3, J4.P$4, J5.P$4; also elsewhere on the board
SDA: J1.P$3 (3), J2.P$3 (3), J3.P$2, J4.P$3, J5.P$3; also elsewhere on the board
SWDCLK: J4.P$7; also elsewhere on the board
SWDIO: J4.P$8; also elsewhere on the board
VIN: R50.P$1 (1), R51.P$2 (2), R52.2, V3.P$1; also elsewhere on the board
VIN-EXT: D4.C, J4.P$1, R51.P$1 (1)
VIN-INT: D3.C, J5.P$7, J5.P$8, R50.P$2 (2)

Notes on the sheet:
-Y Panel
-X Panel
+Z Panel
+X Panel
-Z Panel (Umbilical Connector)
R52 Pulls Down Vin to GND for when both sources are disconnected.
D3 & D4 are TVS diodes with working voltage Vwr=5V
CAREFUL: SOLAR PANEL PINOUTS ARE NOT THE SAME

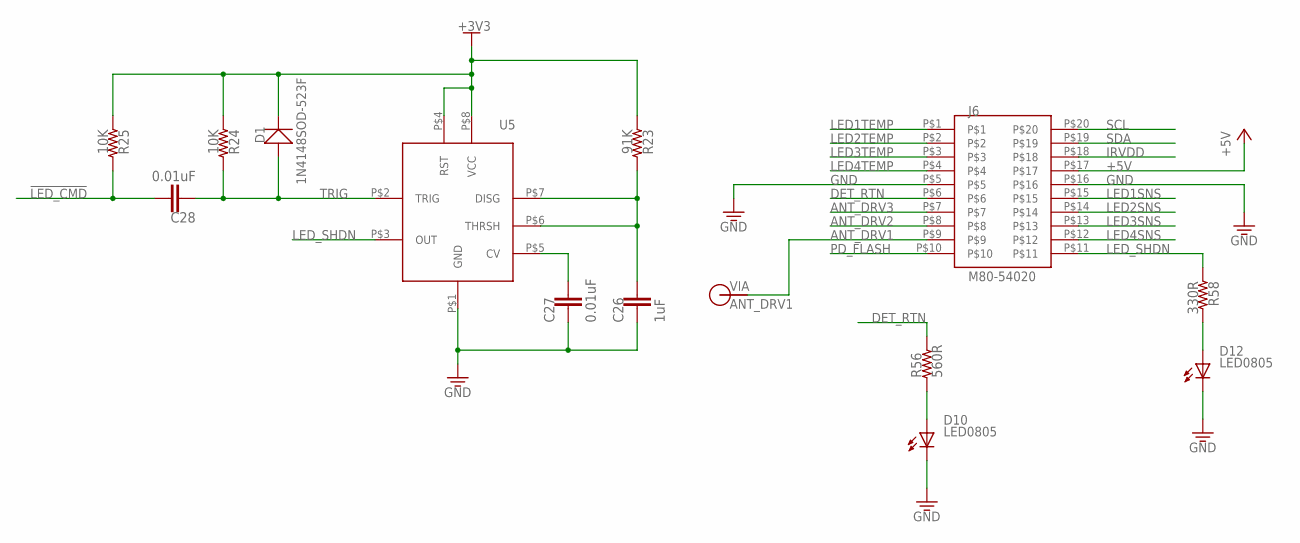
[picture p111: schematic CntrlBoardV3B.sch, sheet 7, Driver Board]

Parts:
C26: 1uF; 0805
C27, C28: 0.01uF; 0805
D1: 1N4148SOD-523F; SOD-523F
D10, D12: LED0805; 0805-D
J6: M80-54020
R23: 91K; 0805
R24, R25: 10K; 0805
R56: 560R; 0805
R58: 330R; 0805
U5: TLC555; SO-8
V6: ANT_DRV1; VIA-60MIL-SQ

Connections:
!LED_CMD!: C28.1, R25.2; also elsewhere on the board
+3V3: D1.C, R23.1, R24.1, R25.1, U5.P$4 (RST), U5.P$8 (VCC); also elsewhere on the board
+5V: J6.P$17; also elsewhere on the board
ANT_DRV1: J6.P$9, V6.P$1; also elsewhere on the board
ANT_DRV2: J6.P$8; also elsewhere on the board
ANT_DRV3: J6.P$7; also elsewhere on the board
DET_RTN: J6.P$6, R56.2; also elsewhere on the board
GND: C26.2, C27.2, D10.C, D12.C, J6.P$5, J6.P$16, U5.P$1 (GND); also elsewhere on the board
IRVDD: J6.P$18; also elsewhere on the board
LED1SNS: J6.P$15; also elsewhere on the board
LED1TEMP: J6.P$1; also elsewhere on the board
LED2SNS: J6.P$14; also elsewhere on the board
LED2TEMP: J6.P$2; also elsewhere on the board
LED3SNS: J6.P$13; also elsewhere on the board
LED3TEMP: J6.P$3; also elsewhere on the board
LED4SNS: J6.P$12; also elsewhere on the board
LED4TEMP: J6.P$4; also elsewhere on the board
LED_SHDN: J6.P$11, R58.1, U5.P$3 (OUT)
unnamed: C26.1, R23.2, U5.P$6 (THRSH), U5.P$7 (DISG)
unnamed: C27.1, U5.P$5 (CV)
unnamed: D10.A, R56.1
unnamed: D12.A, R58.2
PD_FLASH: J6.P$10; also elsewhere on the board
SCL: J6.P$20; also elsewhere on the board
SDA: J6.P$19; also elsewhere on the board
TRIG: C28.2, D1.A, R24.2, U5.P$2 (TRIG)

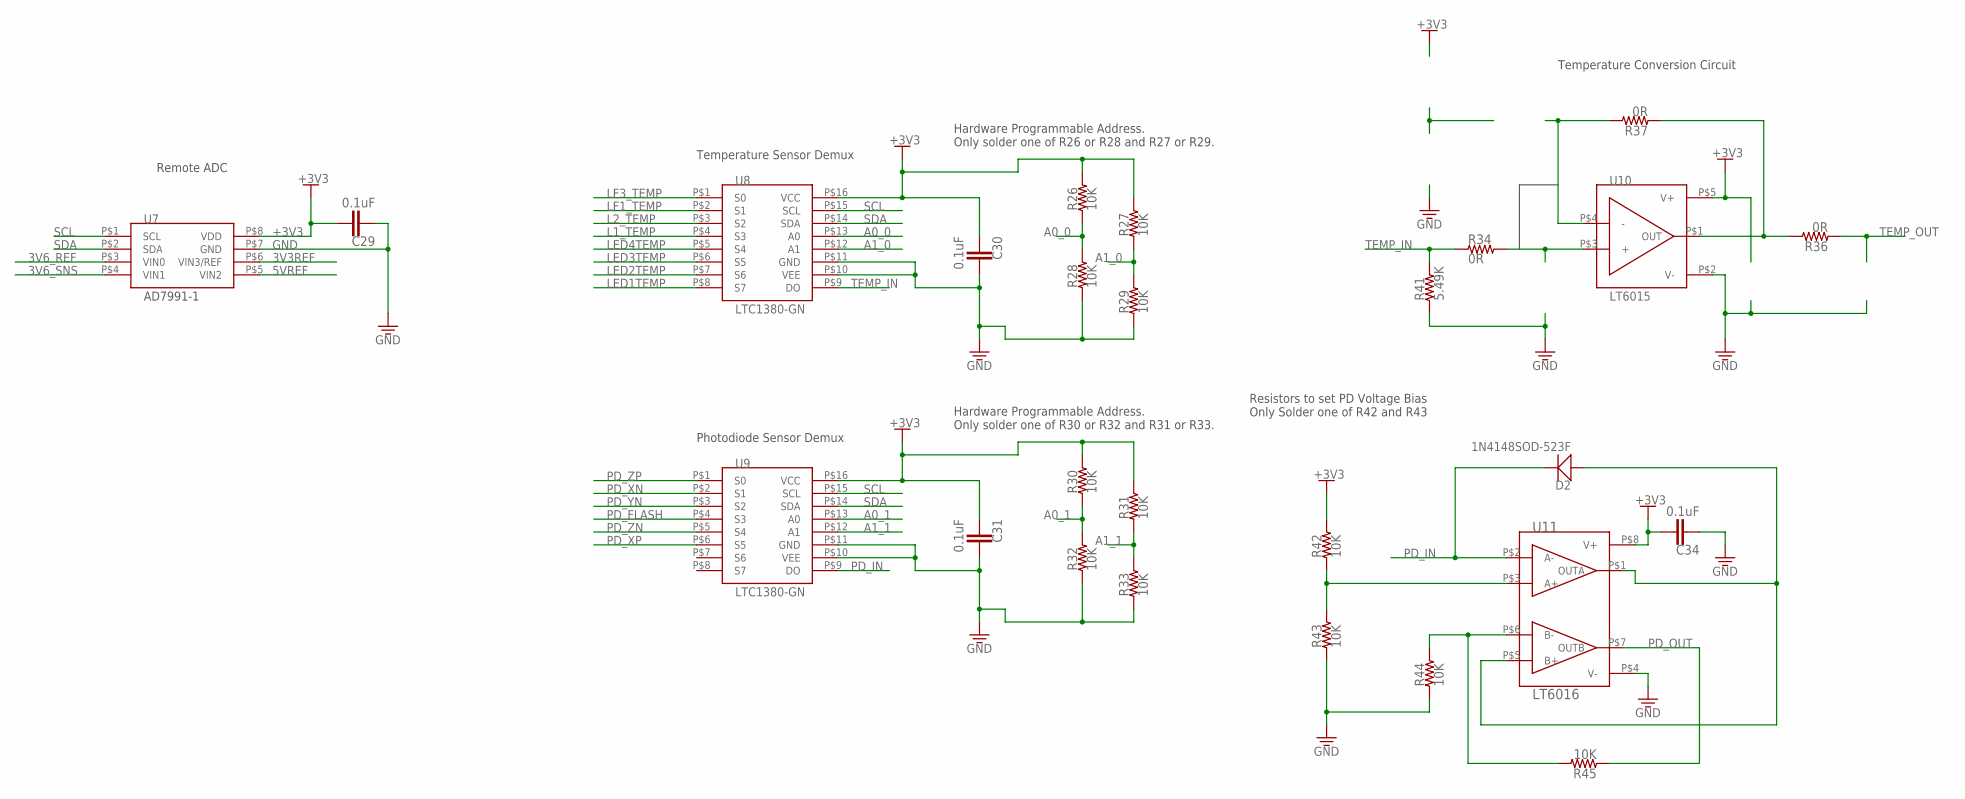
[picture p112: schematic CntrlBoardV3B.sch, sheet 8, Multiplexing, Conversion, and Remote ADC]

Parts:
C29, C30, C31, C34: 0.1uF; 0805
D2: 1N4148SOD-523F; SOD-523F
R26, R27, R28, R29, R30, R31, R32, R33, R42, R43, R44, R45: 10K; 0805
R34, R36, R37: 0R; 0805
R41: 5.49K; 0805
U7: AD7991-1; SOT-23-8
U8, U9: LTC1380-GN; SSOP-16-NARROW
U10: LT6015; TSOT23-5
U11: LT6016; MSOP-8

Connections:
3V3REF: U7.P$6 (VIN3/REF); also elsewhere on the board
3V6_REF: U7.P$3 (VIN0); also elsewhere on the board
3V6_SNS: U7.P$4 (VIN1); also elsewhere on the board
5VREF: U7.P$5 (VIN2); also elsewhere on the board
+3V3: C29.1, C30.2, C31.2, C34.1, R26.2, R27.2, R30.2, R31.2, R42.2, U7.P$8 (VDD), U8.P$16 (VCC), U9.P$16 (VCC), U10.P$5 (V+), U11.P$8 (V+); also elsewhere on the board
A0_0: R26.1, R28.2, U8.P$13 (A0)
A0_1: R30.1, R32.2, U9.P$13 (A0)
A1_0: R27.1, R29.2, U8.P$12 (A1)
A1_1: R31.1, R33.2, U9.P$12 (A1)
GND: C29.2, C30.1, C31.1, C34.2, R28.1, R29.1, R32.1, R33.1, R41.1, R43.1, R44.1, U7.P$7 (GND), U8.P$10 (VEE), U8.P$11 (GND), U9.P$10 (VEE), U9.P$11 (GND), U10.P$2 (V-), U11.P$4 (V-); also elsewhere on the board
L1_TEMP: U8.P$4 (S3); also elsewhere on the board
L2_TEMP: U8.P$3 (S2); also elsewhere on the board
LED1TEMP: U8.P$8 (S7); also elsewhere on the board
LED2TEMP: U8.P$7 (S6); also elsewhere on the board
LED3TEMP: U8.P$6 (S5); also elsewhere on the board
LED4TEMP: U8.P$5 (S4); also elsewhere on the board
LF1_TEMP: U8.P$2 (S1); also elsewhere on the board
LF3_TEMP: U8.P$1 (S0); also elsewhere on the board
unnamed: R34.2, U10.P$3 (+)
unnamed: R37.2, U10.P$4 (-)
unnamed: R36.2, R37.1, U10.P$1 (OUT)
unnamed: D2.A, U11.P$1 (OUTA), U11.P$5 (B+)
unnamed: R42.1, R43.2, U11.P$3 (A+)
unnamed: R44.2, R45.2, U11.P$6 (B-)
PD_FLASH: U9.P$4 (S3); also elsewhere on the board
PD_IN: D2.C, U9.P$9 (DO), U11.P$2 (A-)
PD_OUT: R45.1, U11.P$7 (OUTB); also elsewhere on the board
PD_XN: U9.P$2 (S1); also elsewhere on the board
PD_XP: U9.P$6 (S5); also elsewhere on the board
PD_YN: U9.P$3 (S2); also elsewhere on the board
PD_ZN: U9.P$5 (S4); also elsewhere on the board
PD_ZP: U9.P$1 (S0); also elsewhere on the board
SCL: U7.P$1 (SCL), U8.P$15 (SCL), U9.P$15 (SCL); also elsewhere on the board
SDA: U7.P$2 (SDA), U8.P$14 (SDA), U9.P$14 (SDA); also elsewhere on the board
TEMP_IN: R34.1, R41.2, U8.P$9 (DO)
TEMP_OUT: R36.1; also elsewhere on the board

Notes on the sheet:
Hardware Programmable Address. Only solder one of R26 or R28 and R27 or R29.
Temperature Sensor Demux
Hardware Programmable Address. Only solder one of R30 or R32 and R31 or R33.
Photodiode Sensor Demux
Temperature Conversion Circuit
Resistors to set PD Voltage Bias Only Solder one of R42 and R43
Remote ADC

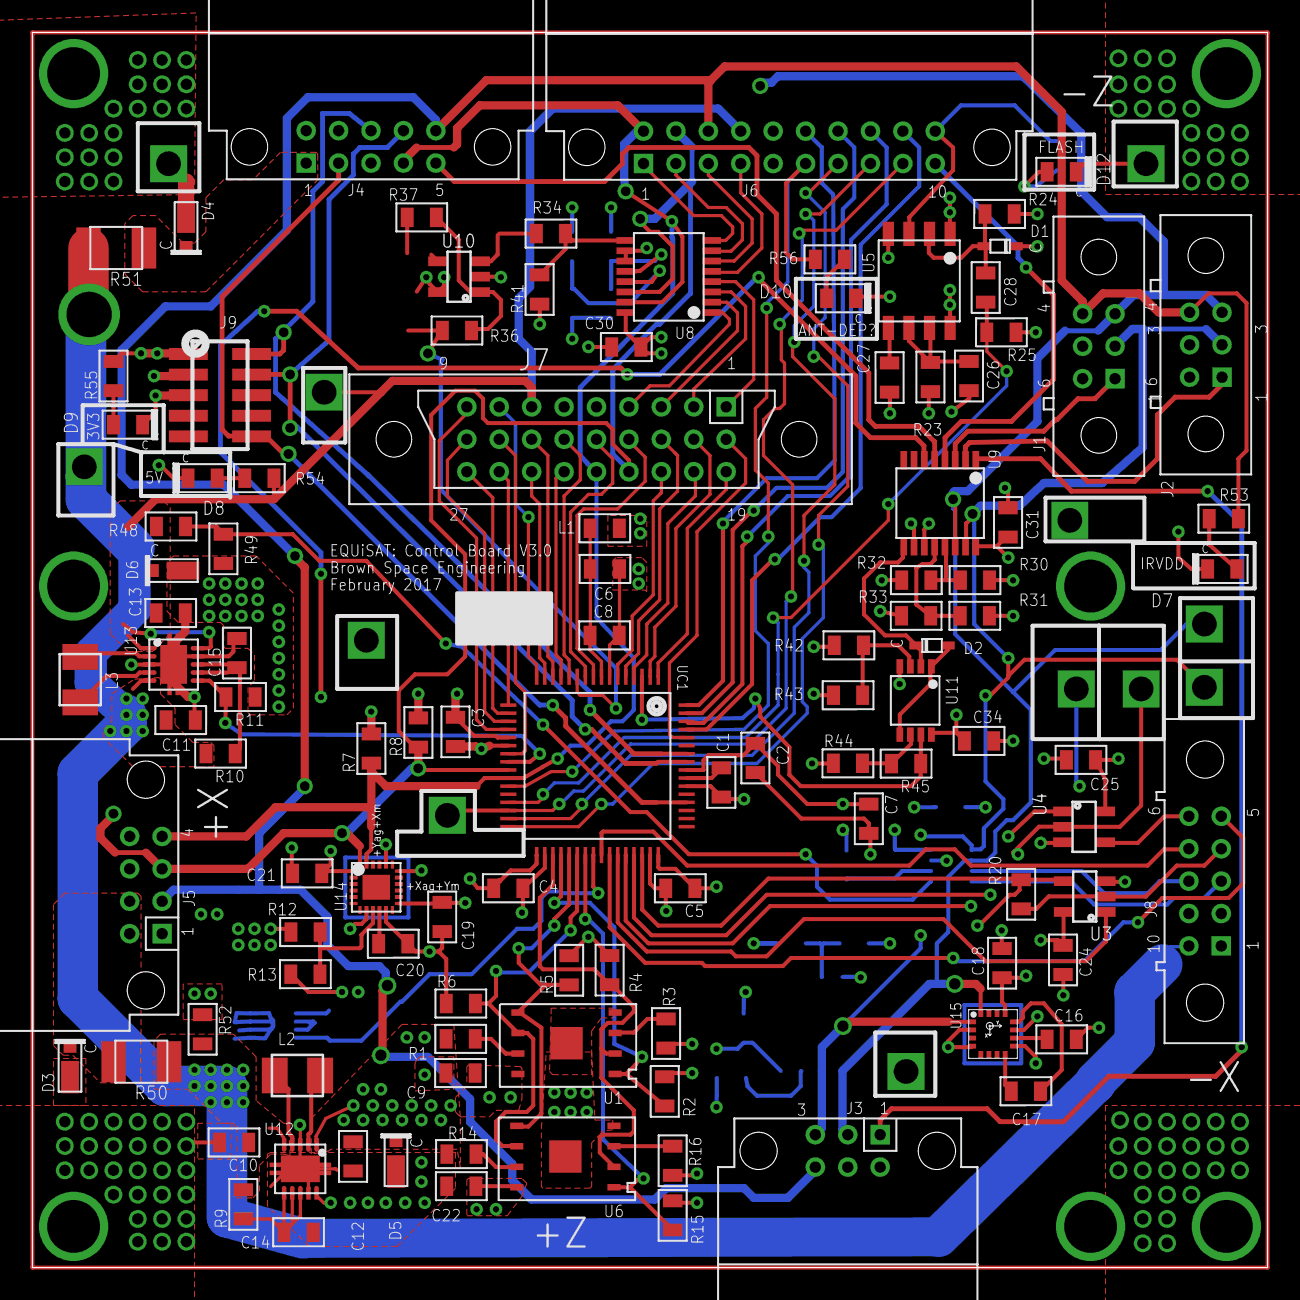
[picture p113: board CntrlBoardV3B.brd from above]

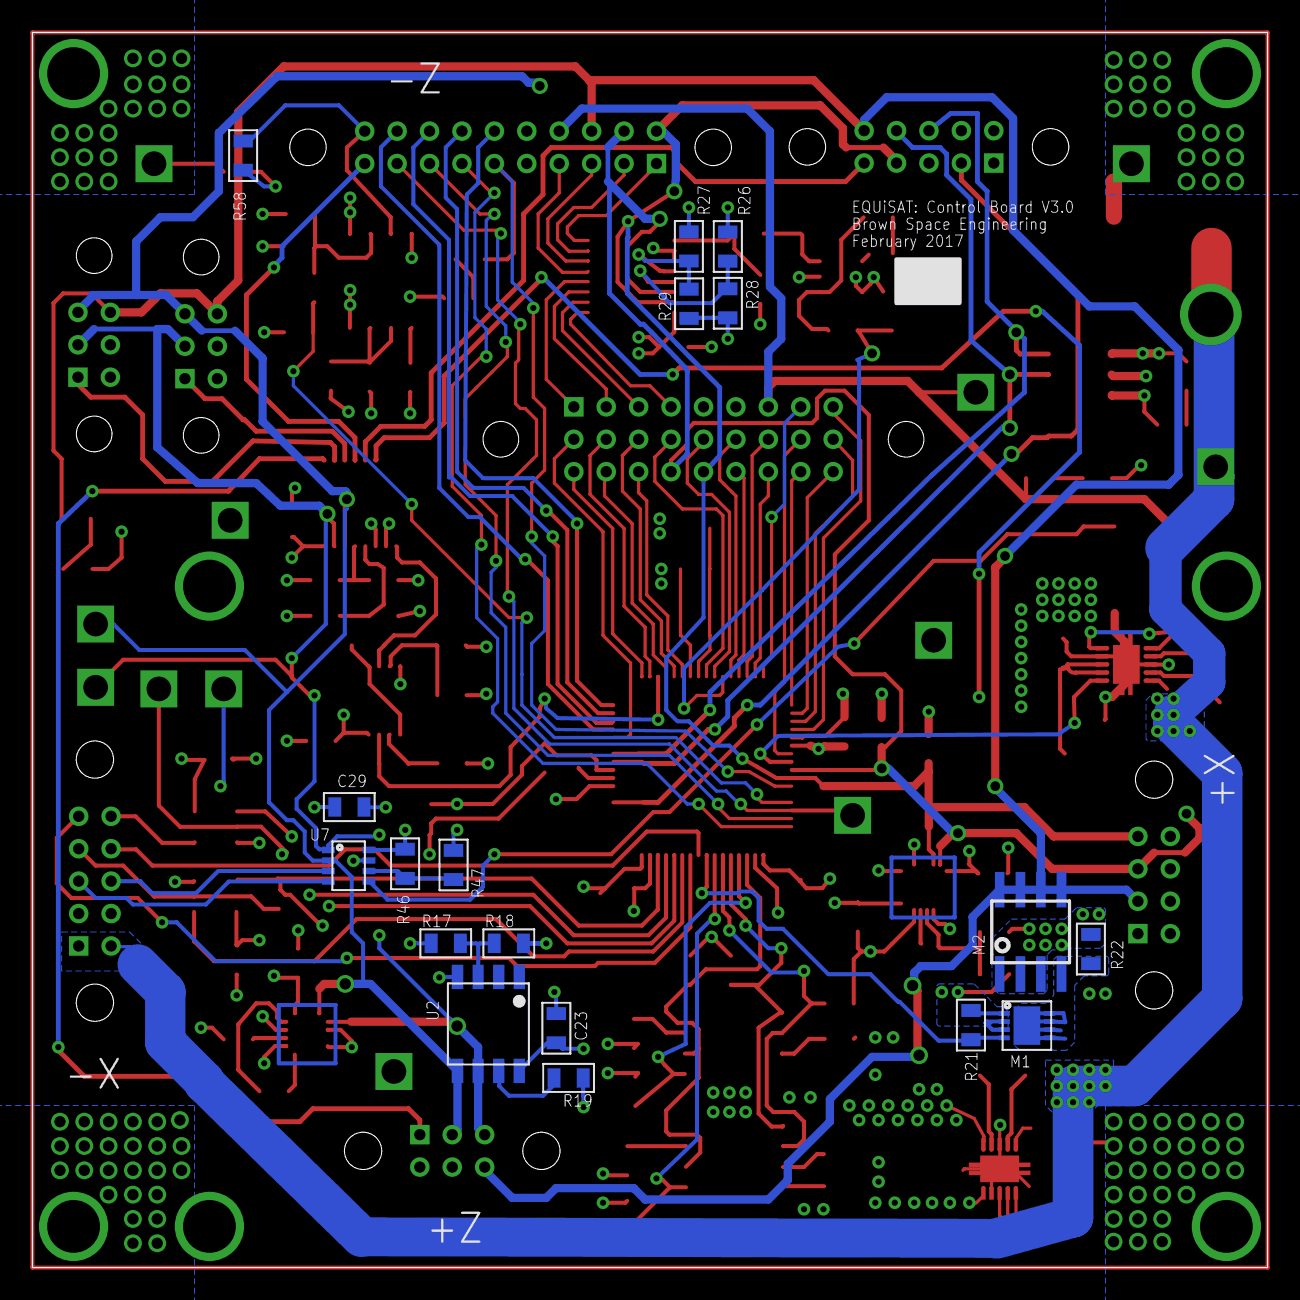
[picture p114: board CntrlBoardV3B.brd from below]

Board: 4 copper layers, 76.2 x 76.2 mm, 138 parts (18 on the bottom side), 115 nets.
