BrownSpaceEngineering/EquiSat-EAGLE/projects/EQUiSat/SolarPanels/AccessPanel/AccessPanelV4.brd

## EAGLE design projects/EQUiSat/SolarPanels/AccessPanel/AccessPanelV4.brd (2017-08-29)

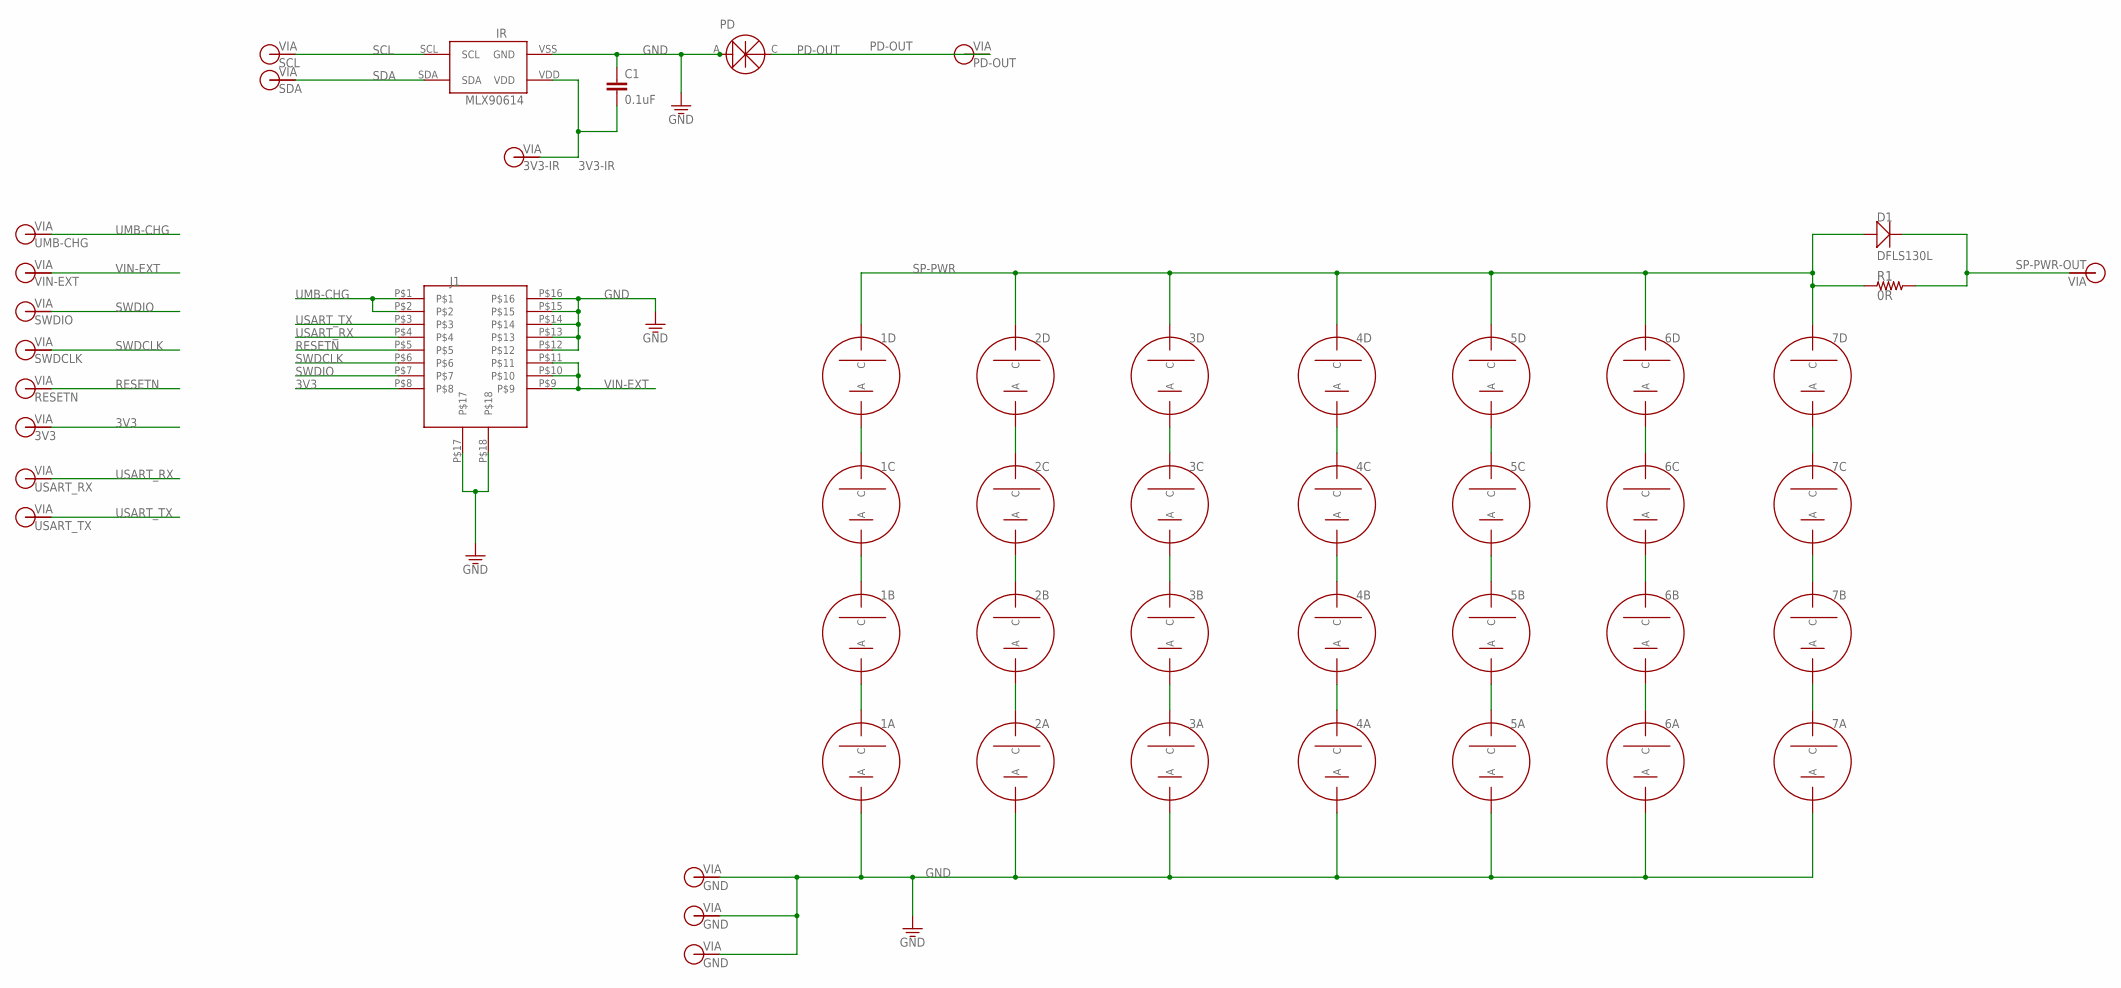
[picture p115: schematic AccessPanelV4.sch]

Parts:
1A, 1B, 1C, 1D, 2A, 2B, 2C, 2D, 3A, 3B, 3C, 3D, 4A, 4B, 4C, 4D, 5A, 5B, 5C, 5D, 6A, 6B, 6C, 6D, 7A, 7B, 7C, 7D: SOLARCELLV3; TRISOLX-V3
C1: 0.1uF; 0805
D1: DFLS130L; PWRDI-123
IR: MXL90614; MXL90620
J1: FFC-16; 68611614422
PD: TEMD6200
R1: 0R; 1210
SCL: SCL; VIA-60MIL
SDA: SDA; VIA-60MIL
V1: SP-PWR-OUT; VIA-60MIL
V2, V4, V5: GND; VIA-60MIL
V3: 3V3-IR; VIA-60MIL
V6: PD-OUT; VIA-60MIL
V7: UMB-CHG; VIA-60MIL
V8: VIN-EXT; VIA-60MIL
V9: SWDIO; VIA-60MIL
V10: SWDCLK; VIA-60MIL
V11: RESETN; VIA-60MIL
V14: USART_RX; VIA-60MIL
V15: USART_TX; VIA-60MIL
V16: 3V3; VIA-60MIL

Connections:
3V3: J1.P$8, V16.P$1
3V3-IR: C1.2, IR.VDD, V3.P$1
GND: 1A.ANODE (A), 2A.ANODE (A), 3A.ANODE (A), 4A.ANODE (A), 5A.ANODE (A), 6A.ANODE (A), 7A.ANODE (A), C1.1, IR.VSS (GND), J1.P$12, J1.P$13, J1.P$14, J1.P$15, J1.P$16, J1.P$17, J1.P$18, PD.A, V2.P$1, V4.P$1, V5.P$1
unnamed: 1C.CATHODE (C), 1D.ANODE (A)
unnamed: 2C.CATHODE (C), 2D.ANODE (A)
unnamed: 3C.CATHODE (C), 3D.ANODE (A)
unnamed: 4C.CATHODE (C), 4D.ANODE (A)
unnamed: 5C.CATHODE (C), 5D.ANODE (A)
unnamed: 1A.CATHODE (C), 1B.ANODE (A)
unnamed: 2A.CATHODE (C), 2B.ANODE (A)
unnamed: 3A.CATHODE (C), 3B.ANODE (A)
unnamed: 4A.CATHODE (C), 4B.ANODE (A)
unnamed: 5A.CATHODE (C), 5B.ANODE (A)
unnamed: 1B.CATHODE (C), 1C.ANODE (A)
unnamed: 2B.CATHODE (C), 2C.ANODE (A)
unnamed: 3B.CATHODE (C), 3C.ANODE (A)
unnamed: 4B.CATHODE (C), 4C.ANODE (A)
unnamed: 5B.CATHODE (C), 5C.ANODE (A)
unnamed: 6C.CATHODE (C), 6D.ANODE (A)
unnamed: 6A.CATHODE (C), 6B.ANODE (A)
unnamed: 6B.CATHODE (C), 6C.ANODE (A)
unnamed: 7C.CATHODE (C), 7D.ANODE (A)
unnamed: 7A.CATHODE (C), 7B.ANODE (A)
unnamed: 7B.CATHODE (C), 7C.ANODE (A)
PD-OUT: PD.C, V6.P$1
RESETN: J1.P$5, V11.P$1
SCL: IR.SCL, SCL.P$1
SDA: IR.SDA, SDA.P$1
SP-PWR: 1D.CATHODE (C), 2D.CATHODE (C), 3D.CATHODE (C), 4D.CATHODE (C), 5D.CATHODE (C), 6D.CATHODE (C), 7D.CATHODE (C), D1.A, R1.P$1 (1)
SP-PWR-OUT: D1.C, R1.P$2 (2), V1.P$1
SWDCLK: J1.P$6, V10.P$1
SWDIO: J1.P$7, V9.P$1
UMB-CHG: J1.P$1, J1.P$2, V7.P$1
USART_RX: J1.P$4, V14.P$1
USART_TX: J1.P$3, V15.P$1
VIN-EXT: J1.P$9, J1.P$10, J1.P$11, V8.P$1

Notes on the sheet:
GND
PD-OUT

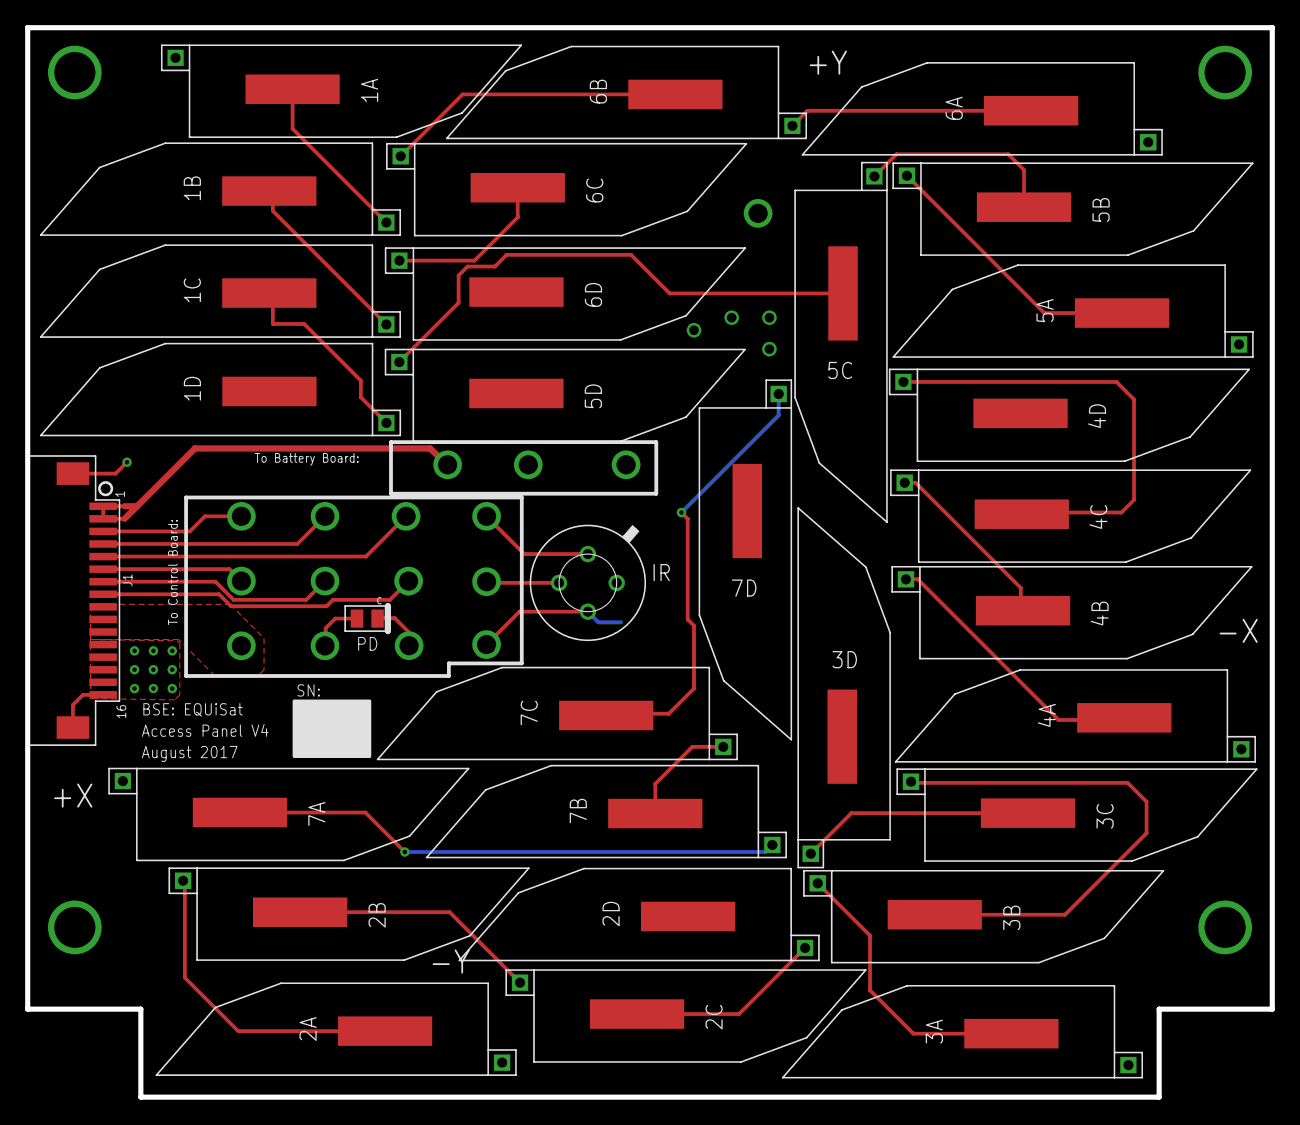
[picture p116: board AccessPanelV4.brd from above]

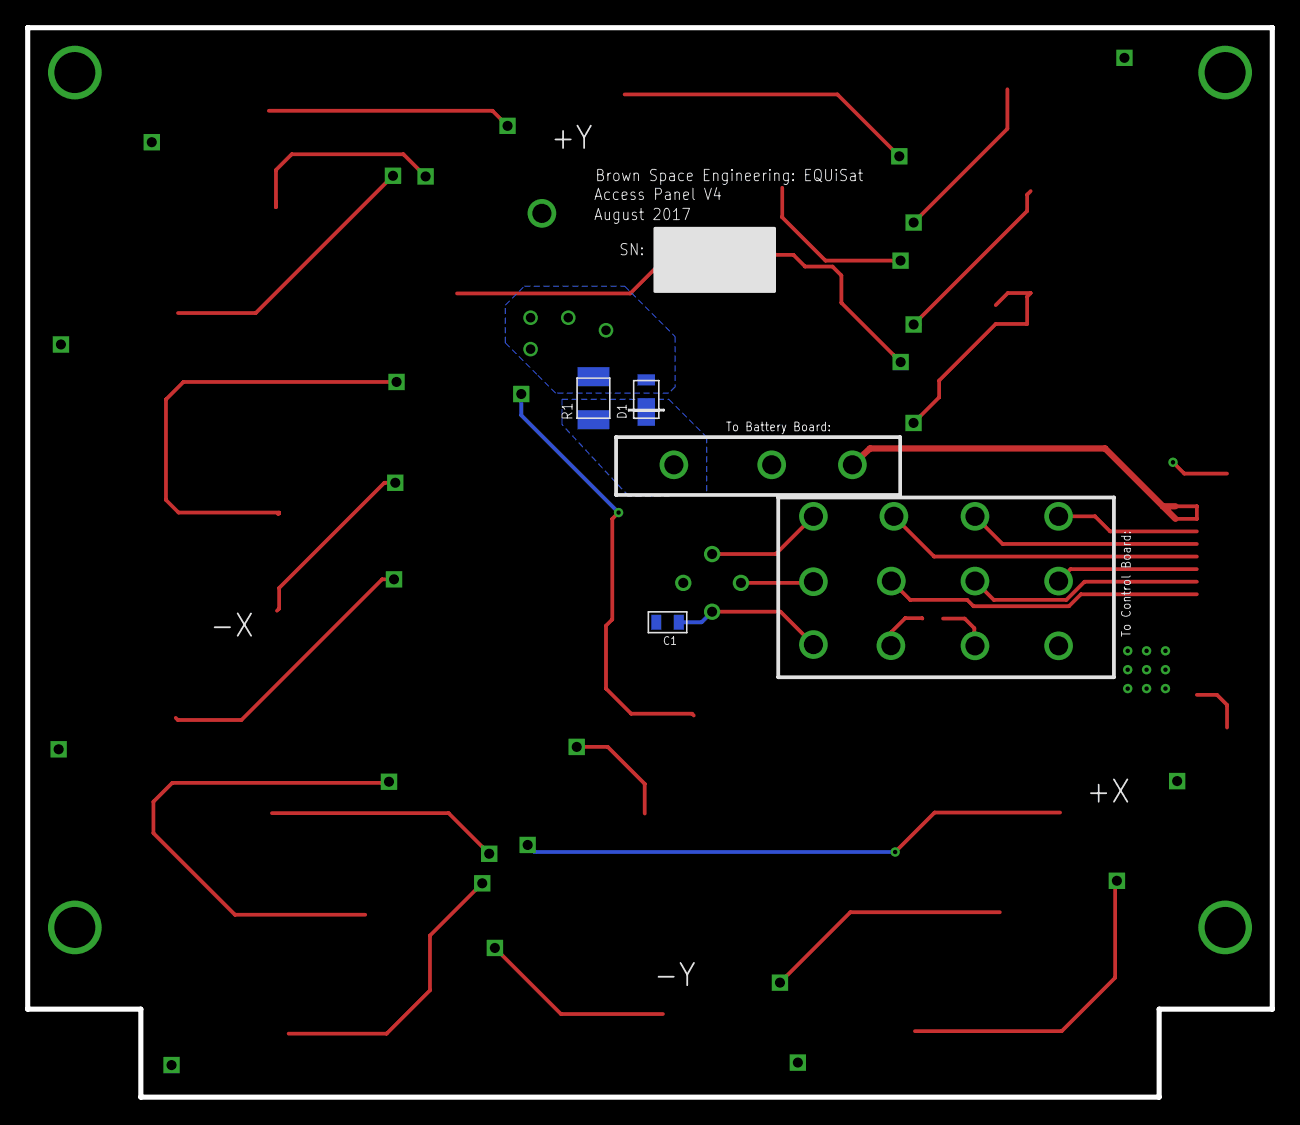
[picture p117: board AccessPanelV4.brd from below]

Board: 2 copper layers, 99.0 x 85.1 mm, 50 parts (3 on the bottom side), 36 nets.
