BrownSpaceEngineering/EquiSat-EAGLE/projects/EQUiSat/SolarPanels/Side Panel/SIDEPANELV4.brd

## EAGLE design projects/EQUiSat/SolarPanels/Side Panel/SIDEPANELV4.brd (2016-09-07)

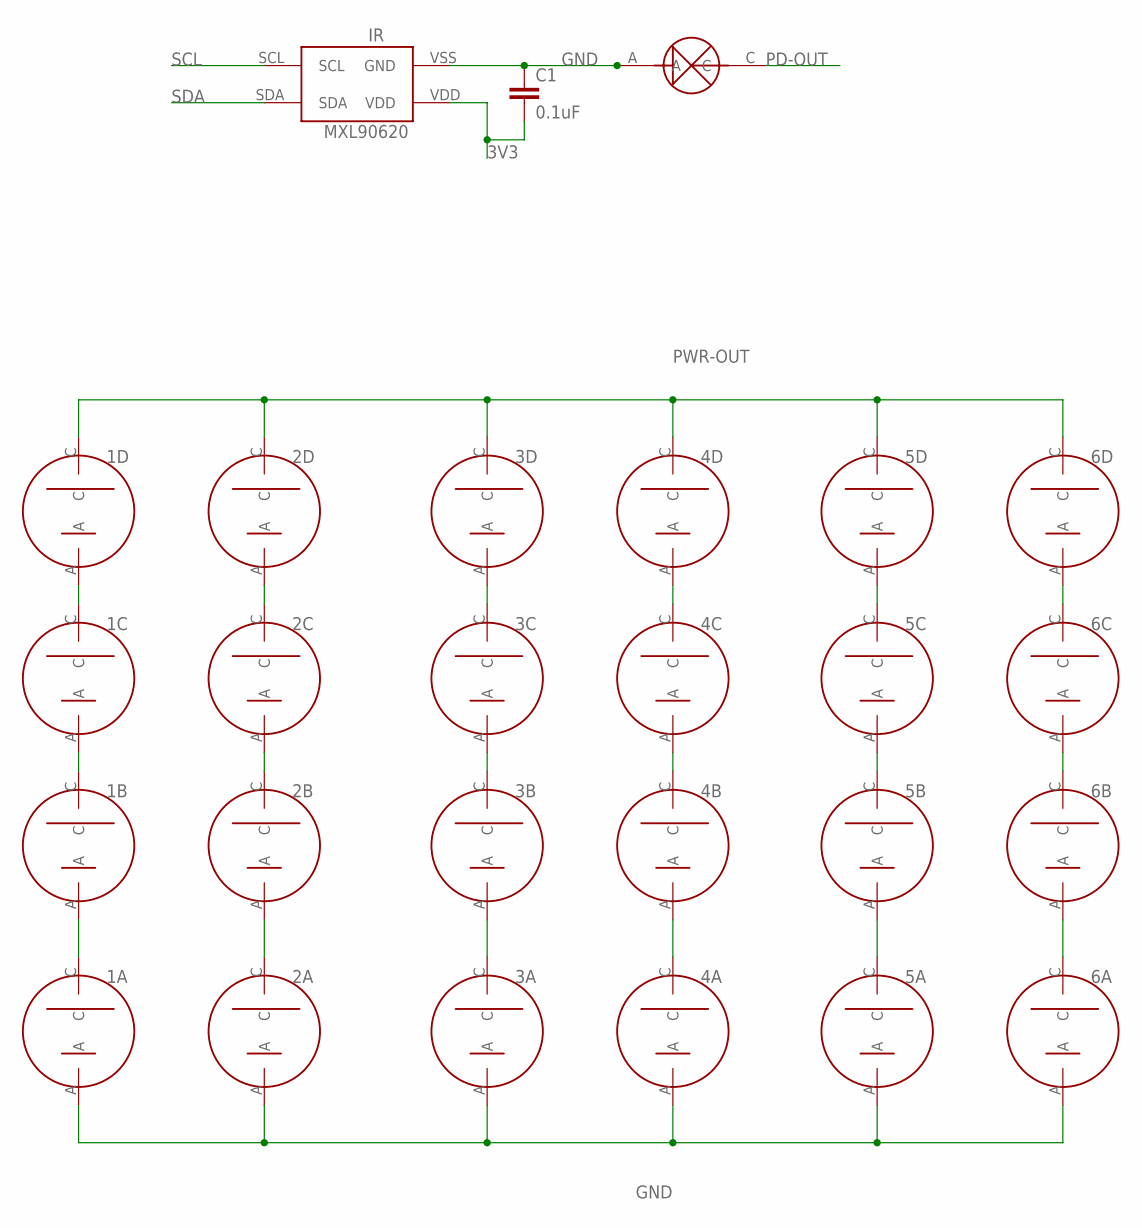
[picture p120: schematic SIDEPANELV4.sch]

Parts:
1A, 1B, 1C, 1D, 2A, 2B, 2C, 2D, 3A, 3B, 3C, 3D, 4A, 4B, 4C, 4D, 5A, 5B, 5C, 5D, 6A, 6B, 6C, 6D: NEWSOLARPANEL; SOLARCELL2
C1: 0.1uF; 0805
IR: MXL90620
PD: PHOTODETECTOR; PHOTODECTORDEVICE2

Connections:
2C: 2B.C, 2C.A
3V3: C1.2, IR.VDD
GND: 1A.A, 2A.A, 3A.A, 4A.A, 5A.A, 6A.A, C1.1, IR.VSS (GND), PD.A
unnamed: 1C.C, 1D.A
unnamed: 2C.C, 2D.A
unnamed: 3C.C, 3D.A
unnamed: 4C.C, 4D.A
unnamed: 5C.C, 5D.A
unnamed: 6C.C, 6D.A
unnamed: 6B.C, 6C.A
unnamed: 6A.C, 6B.A
unnamed: 5B.C, 5C.A
unnamed: 5A.C, 5B.A
unnamed: 4A.C, 4B.A
unnamed: 4B.C, 4C.A
unnamed: 3B.C, 3C.A
unnamed: 1B.C, 1C.A
unnamed: 1A.C, 1B.A
unnamed: 2A.C, 2B.A
unnamed: 3A.C, 3B.A
PD-OUT: PD.C
PWR-OUT: 1D.C, 2D.C, 3D.C, 4D.C, 5D.C, 6D.C
SCL: IR.SCL
SDA: IR.SDA

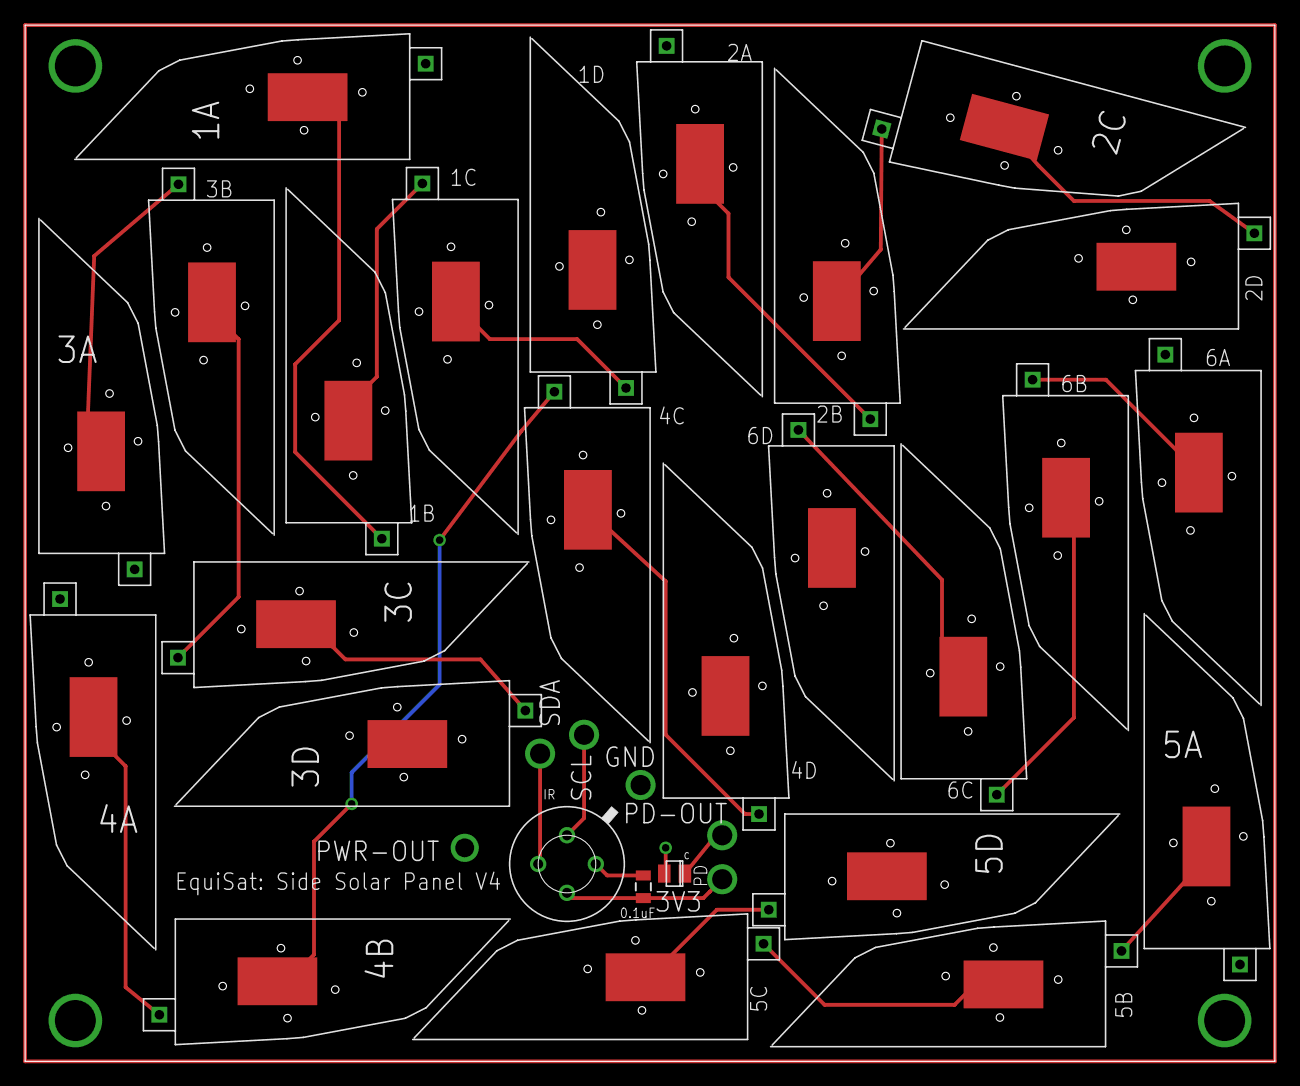
[picture p121: board SIDEPANELV4.brd from above]

Board: 2 copper layers, 99.5 x 82.5 mm, 27 parts (0 on the bottom side), 21 nets.
