BrownSpaceEngineering/EquiSat-EAGLE/projects/EQUiSat/ControlBoard/EngineeringModelBoard.brd

## EAGLE design projects/EQUiSat/ControlBoard/EngineeringModelBoard.brd (2016-07-10)

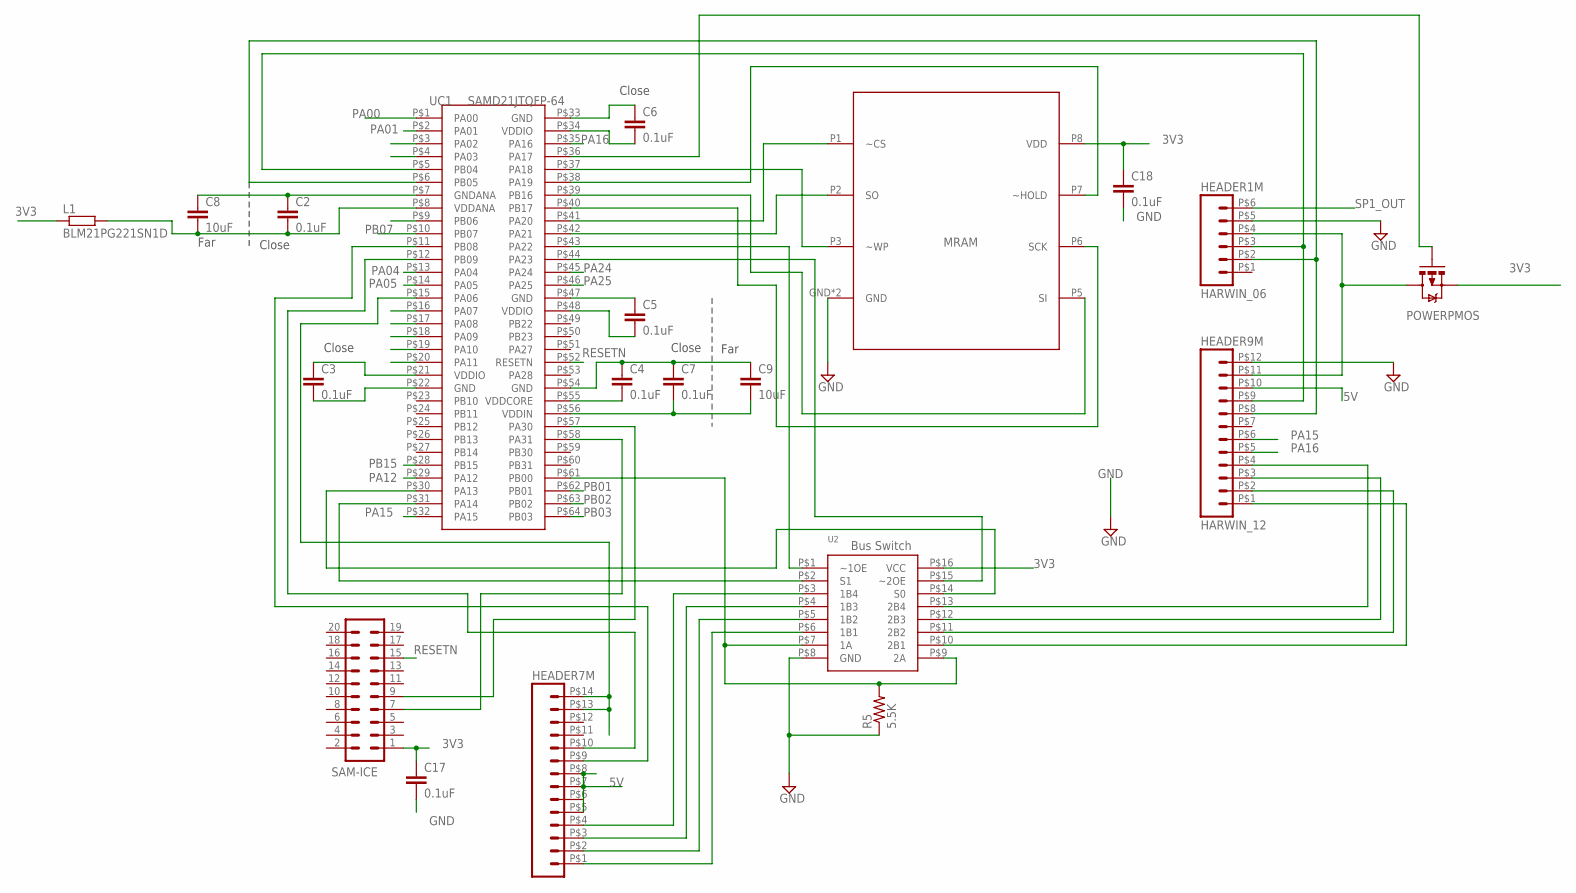
[picture p122: schematic EngineeringModelBoard.sch, sheet 1, µC and Programming]

Parts:
C2, C3, C4, C5, C6, C7, C17, C18: 0.1uF; 0805; MPN 0603YC104JAT2A
C8, C9: 10uF; 0805; MPN 08056D106KAT2A
HEADER1M: HARWIN_06; HARWIN_DATAMATE_6
HEADER7M: HARWIN_14; HARWIN_DATAMATE_14
HEADER9M: HARWIN_12; HARWIN_DATAMATE_12
L1: BLM21PG221SN1D; R0805; MPN BLM21PG221SN1D
R5: 5.5K; 0805
SAM-ICE: IDC_JTAG_CONNECTOR; 2X10
U2: SN74CBTLV3253; SOIC16R
U$3: MRAM; 8PXMO-229
U$14: POWERPMOS; SO08
UC1: SAMD21JTQFP-64; TQFP-64

Connections:
3V3: C3.1, C5.2, C6.2, C7.2, C9.2, C17.1, C18.1, L1.1, SAM-ICE.1, U2.P$16 (VCC), U$3.P8 (VDD), U$14.1 (S), U$14.2 (S), U$14.3 (S), UC1.P$21 (VDDIO), UC1.P$34 (VDDIO), UC1.P$48 (VDDIO), UC1.P$56 (VDDIN); also elsewhere on the board
3V3D: HEADER1M.P$4 (4), HEADER9M.P$11 (11), U$14.5 (D), U$14.6 (D), U$14.7 (D), U$14.8 (D)
5V: HEADER7M.P$5 (5), HEADER7M.P$6 (6), HEADER7M.P$7 (7), HEADER7M.P$8 (8), HEADER9M.P$10 (10); also elsewhere on the board
GND: C2.1, C4.1, C5.1, C6.1, C7.1, C8.1, C9.1, C17.2, C18.2, HEADER1M.P$5 (5), HEADER9M.P$12 (12), R5.1, U2.P$8 (GND), U$3.GND, U$3.P4 (GND), UC1.P$7 (GNDANA), UC1.P$33 (GND), UC1.P$47 (GND), UC1.P$54 (GND); also elsewhere on the board
unnamed: U$3.P1 (~CS), UC1.P$41 (PA20)
unnamed: U$3.P2 (SO), UC1.P$42 (PA21)
unnamed: U$3.P3 (~WP), UC1.P$37 (PA18)
unnamed: HEADER9M.P$1 (1), U2.P$10 (2B1)
unnamed: HEADER9M.P$2 (2), U2.P$11 (2B2)
unnamed: HEADER9M.P$3 (3), U2.P$12 (2B3)
unnamed: HEADER9M.P$4 (4), U2.P$13 (2B4)
unnamed: HEADER7M.P$1 (1), U2.P$6 (1B1)
unnamed: HEADER7M.P$2 (2), U2.P$5 (1B2)
unnamed: HEADER7M.P$3 (3), U2.P$4 (1B3)
unnamed: HEADER7M.P$4 (4), U2.P$3 (1B4)
unnamed: U2.P$14 (S0), UC1.P$30 (PA13)
unnamed: U2.P$2 (S1), UC1.P$31 (PA14)
unnamed: U2.P$1 (~1OE), UC1.P$43 (PA22)
unnamed: U2.P$15 (~2OE), UC1.P$44 (PA23)
unnamed: U$3.P7 (~HOLD), UC1.P$38 (PA19)
unnamed: U$3.P6 (SCK), UC1.P$40 (PB17)
unnamed: C3.2, UC1.P$22 (GND)
unnamed: U$3.P5 (SI), UC1.P$39 (PB16)
unnamed: C2.2, C8.2, L1.2, UC1.P$8 (VDDANA)
unnamed: C4.2, UC1.P$55 (VDDCORE)
unnamed: U$14.4 (G), UC1.P$36 (PA17)
PA00: UC1.P$1 (PA00); also elsewhere on the board
PA01: UC1.P$2 (PA01); also elsewhere on the board
PA02: UC1.P$3 (PA02)
PA03: UC1.P$4 (PA03)
PA04: UC1.P$13 (PA04); also elsewhere on the board
PA05: UC1.P$14 (PA05); also elsewhere on the board
PA06: HEADER7M.P$13 (13), HEADER7M.P$14 (14), UC1.P$15 (PA06)
PA07: UC1.P$16 (PA07)
PA08: UC1.P$17 (PA08)
PA09: UC1.P$18 (PA09)
PA10: UC1.P$19 (PA10)
PA11: UC1.P$20 (PA11)
PA12: UC1.P$29 (PA12); also elsewhere on the board
PA15: HEADER9M.P$6 (6), UC1.P$32 (PA15)
PA16: HEADER9M.P$5 (5), UC1.P$35 (PA16)
PA24: UC1.P$45 (PA24); also elsewhere on the board
PA25: UC1.P$46 (PA25); also elsewhere on the board
PA30: SAM-ICE.9, UC1.P$57 (PA30)
PA31: SAM-ICE.7, UC1.P$58 (PA31)
PB00: R5.2, U2.P$7 (1A), U2.P$9 (2A), UC1.P$61 (PB00)
PB01: UC1.P$62 (PB01); also elsewhere on the board
PB02: UC1.P$63 (PB02); also elsewhere on the board
PB03: UC1.P$64 (PB03); also elsewhere on the board
PB04: HEADER1M.P$3 (3), HEADER9M.P$9 (9), UC1.P$5 (PB04)
PB05: HEADER1M.P$2 (2), HEADER9M.P$8 (8), UC1.P$6 (PB05)
PB06: UC1.P$9 (PB06)
PB07: UC1.P$10 (PB07); also elsewhere on the board
PB08: HEADER7M.P$9 (9), UC1.P$11 (PB08)
PB09: HEADER7M.P$10 (10), UC1.P$12 (PB09)
PB15: UC1.P$28 (PB15); also elsewhere on the board
RESETN: SAM-ICE.15, UC1.P$52 (RESETN)
SP1_OUT: HEADER1M.P$6 (6)

Notes on the sheet:
Close
Far
MRAM
Bus Switch

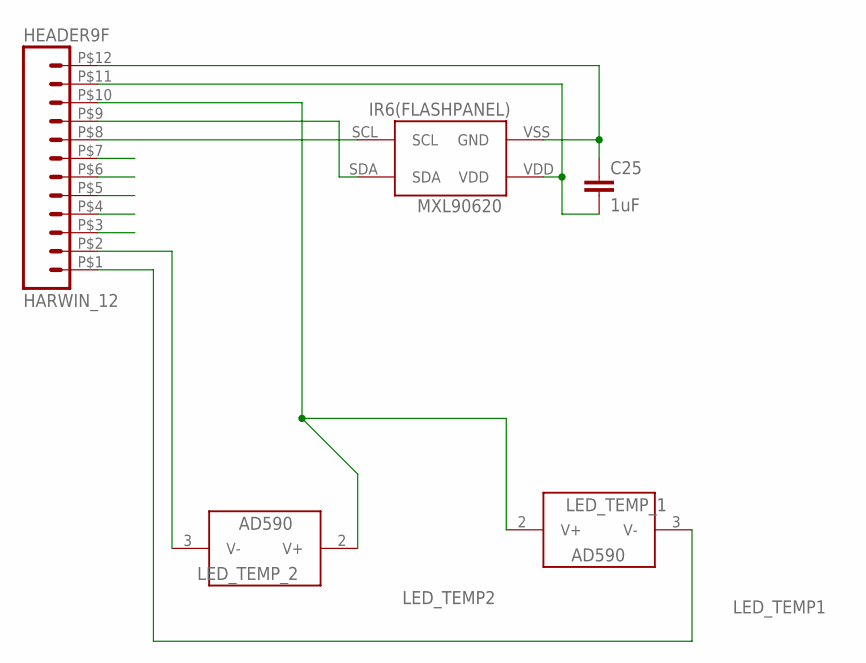
[picture p123: schematic EngineeringModelBoard.sch, sheet 2, Flash Panel]

Parts:
C25: 1uF; 0805; MPN 0805ZC105KAT2A
HEADER9F: HARWIN_12; HARWIN_DATAMATE_12
IR6(FLASHPANEL): MXL90620
LED_TEMP_1, LED_TEMP_2: AD590-SOIC-8; 8SOIC; MPN AD590JRZ

Connections:
3V3IR: C25.2, HEADER9F.P$11 (11), IR6(FLASHPANEL).VDD
GNDIR: C25.1, HEADER9F.P$12 (12), IR6(FLASHPANEL).VSS (GND)
H9.1: HEADER9F.P$1 (1), LED_TEMP_1.3 (V-)
H9.2: HEADER9F.P$2 (2), LED_TEMP_2.3 (V-)
H9.3: HEADER9F.P$3 (3)
H9.4: HEADER9F.P$4 (4)
H9.5: HEADER9F.P$5 (5)
H9.6: HEADER9F.P$6 (6)
H9.7: HEADER9F.P$7 (7)
H9.10: HEADER9F.P$10 (10), LED_TEMP_1.2 (V+), LED_TEMP_2.2 (V+)
SCLIR: HEADER9F.P$8 (8), IR6(FLASHPANEL).SCL
SDAIR: HEADER9F.P$9 (9), IR6(FLASHPANEL).SDA

Notes on the sheet:
LED_TEMP1
LED_TEMP2

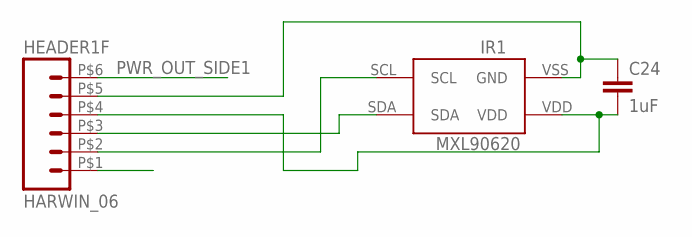
[picture p124: schematic EngineeringModelBoard.sch, sheet 3, Side 1]

Parts:
C24: 1uF; 0805; MPN 0805ZC105KAT2A
HEADER1F: HARWIN_06; HARWIN_DATAMATE_6
IR1: MXL90620

Connections:
H1.1: HEADER1F.P$1 (1)
H1.2: HEADER1F.P$2 (2), IR1.SCL
H1.3: HEADER1F.P$3 (3), IR1.SDA
H1.4: C24.2, HEADER1F.P$4 (4), IR1.VDD
H1.5: C24.1, HEADER1F.P$5 (5), IR1.VSS (GND)
PWR_OUT_SIDE1: HEADER1F.P$6 (6)
