BrownSpaceEngineering/EquiSat-EAGLE/projects/EQUiSat/ControlBoard/EngineeringModelBoard.brd

## EAGLE design projects/EQUiSat/ControlBoard/EngineeringModelBoard.brd (continued)

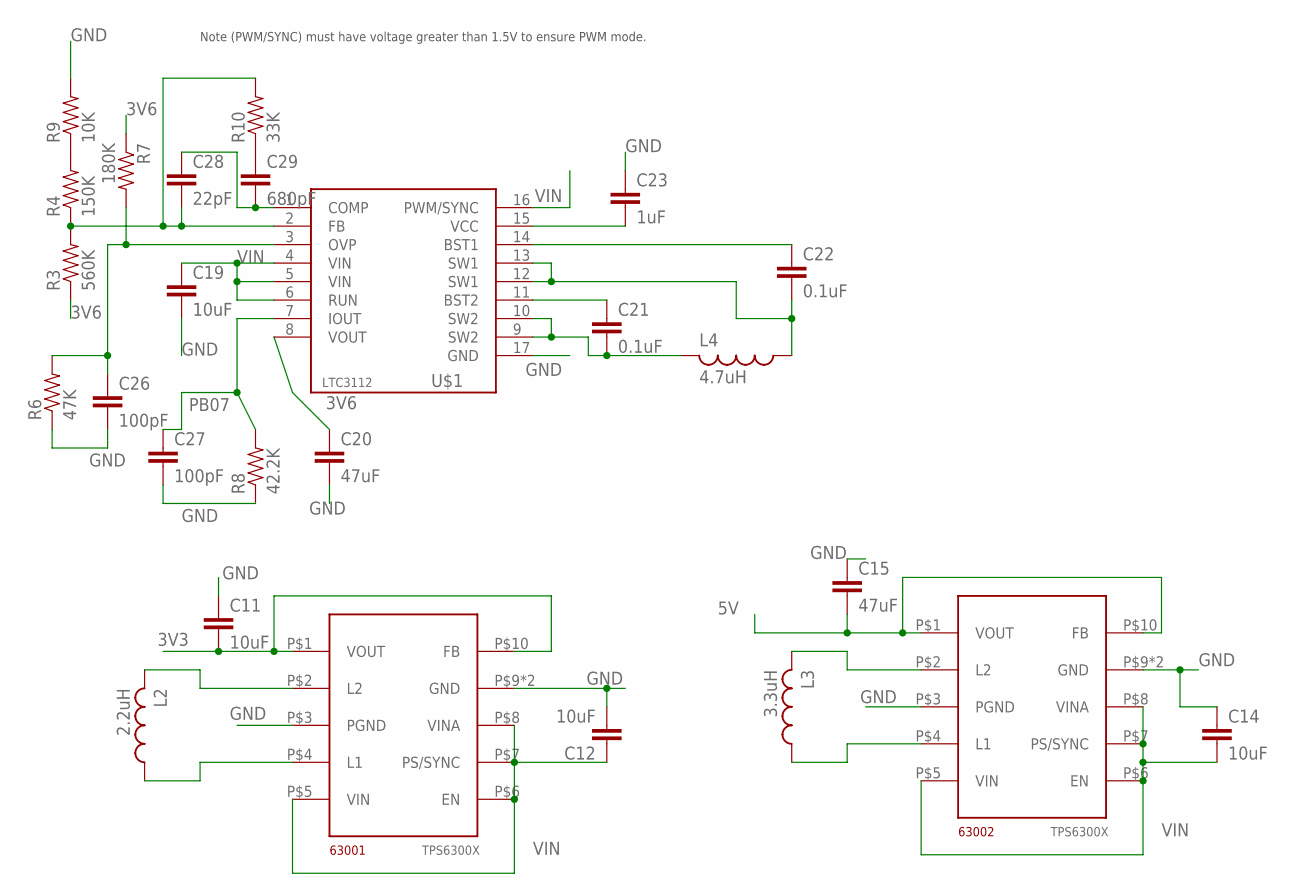
[picture p125: schematic EngineeringModelBoard.sch, sheet 4, Power Regulation]

Parts:
63001, 63002: TPS6300X; QFN10_POWERPAD
C11, C12, C19: 10uF; 0603-CAP
C14: 10uF; 0603-CAP; MPN C1608X5R1A225K080AC
C15: 47uF; 0603-CAP; MPN EMK107B7474KA-T
C20: 47uF; 0805; MPN EMK107B7474KA-T
C21, C22: 0.1uF; 0603-CAP; MPN 0603YC104JAT2A
C23: 1uF; 0603-CAP
C26, C27: 100pF; 0805; MPN 08051A101J4T4A
C28: 22pF; 0805; MPN 08051A220JAT2A
C29: 680pF; 0805; MPN 08055C681KAT2A
L2: 2.2uH; L3225M
L3: 3.3uH; L3225M; MPN JMK212BJ335KG-T
L4: 4.7uH; L3225M
R3: 560K; 0805; MPN MC01W08051560K
R4: 150K; 0805
R6: 47K; 0805
R7: 180K; 0805; MPN ERJ-6GEYJ184V
R8: 42.2K; 0805
R9: 10K; 0805
R10: 33K; 0805
U$1: LTC3112; DHD16; MPN LTC3112EFE#PBF

Connections:
3V3: 63001.P$1 (VOUT), 63001.P$10 (FB), C11.2; also elsewhere on the board
3V6: C20.1, R3.1, R7.1, U$1.8 (VOUT); also elsewhere on the board
5V: 63002.P$1 (VOUT), 63002.P$10 (FB), C15.2; also elsewhere on the board
GND: 63001.P$3 (PGND), 63001.P$9 (GND), 63001.PAD (GND), 63002.P$3 (PGND), 63002.P$9 (GND), 63002.PAD (GND), C11.1, C12.2, C14.1, C15.1, C19.2, C20.2, C23.1, C26.2, C27.2, R6.1, R8.1, R9.2, U$1.17 (GND); also elsewhere on the board
unnamed: C21.1, U$1.11 (BST2)
unnamed: C22.1, U$1.14 (BST1)
unnamed: C23.2, U$1.15 (VCC)
unnamed: C22.2, L4.1, U$1.12 (SW1), U$1.13 (SW1)
unnamed: 63002.P$2 (L2), L3.2
unnamed: 63002.P$4 (L1), L3.1
unnamed: 63001.P$2 (L2), L2.2
unnamed: 63001.P$4 (L1), L2.1
unnamed: C21.2, L4.2, U$1.9 (SW2), U$1.10 (SW2)
unnamed: C28.2, R3.2, R4.1, R10.2, U$1.2 (FB)
unnamed: C26.1, R6.2, R7.2, U$1.3 (OVP)
unnamed: C29.1, R10.1
unnamed: C28.1, C29.2, U$1.1 (COMP)
unnamed: R4.2, R9.1
PB07: C27.1, R8.2, U$1.7 (IOUT); also elsewhere on the board
VIN: 63001.P$5 (VIN), 63001.P$6 (EN), 63001.P$7 (PS/SYNC), 63001.P$8 (VINA), 63002.P$5 (VIN), 63002.P$6 (EN), 63002.P$7 (PS/SYNC), 63002.P$8 (VINA), C12.1, C14.2, C19.1, U$1.4 (VIN), U$1.5 (VIN), U$1.6 (RUN), U$1.16 (PWM/SYNC); also elsewhere on the board

Notes on the sheet:
Note (PWM/SYNC) must have voltage greater than 1.5V to ensure PWM mode.

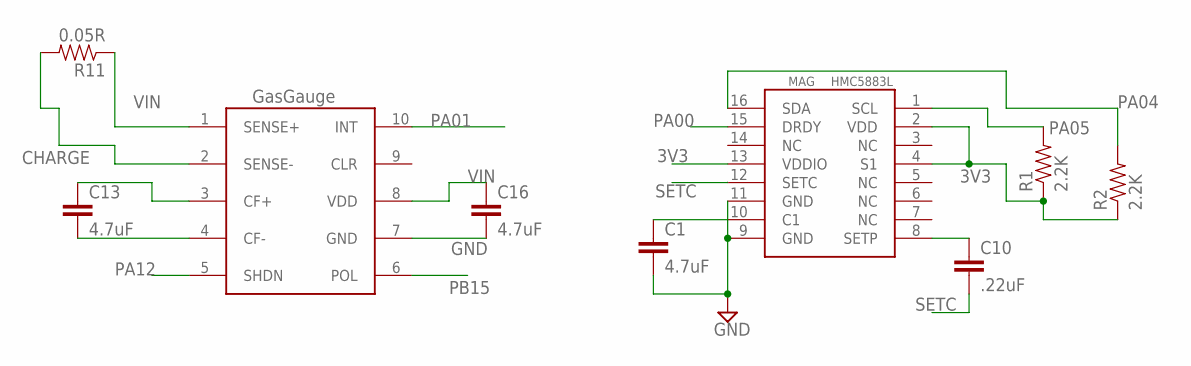
[picture p126: schematic EngineeringModelBoard.sch, sheet 5, Sensors]

Parts:
C1, C13, C16: 4.7uF; 0805; MPN 08056D475KAT2A
C10: .22uF; 0805; MPN 08053C224KAT2A
MAG: HMC5883L; MPN HMC5883L-TR
R1, R2: 2.2K; 0805; MPN SR1-0805-222
R11: 0.05R; 0805
U$2: LTC4150; MSOP10; MPN LTC4150CMS#PBF

Connections:
3V3: MAG.2 (VDD), MAG.4 (S1), MAG.13 (VDDIO), R1.1, R2.1; also elsewhere on the board
CHARGE: R11.2, U$2.2 (SENSE-)
GND: C1.2, C16.2, MAG.9 (GND), MAG.11 (GND), U$2.7 (GND); also elsewhere on the board
unnamed: C1.1, MAG.10 (C1)
unnamed: C10.1, MAG.8 (SETP)
unnamed: C13.1, U$2.3 (CF+)
unnamed: C13.2, U$2.4 (CF-)
PA00: MAG.15 (DRDY); also elsewhere on the board
PA01: U$2.10 (INT); also elsewhere on the board
PA04: MAG.16 (SDA), R2.2; also elsewhere on the board
PA05: MAG.1 (SCL), R1.2; also elsewhere on the board
PA12: U$2.5 (SHDN); also elsewhere on the board
PB15: U$2.6 (POL); also elsewhere on the board
SETC: C10.2, MAG.12 (SETC)
VIN: C16.1, R11.1, U$2.1 (SENSE+), U$2.8 (VDD); also elsewhere on the board

Notes on the sheet:
GasGauge

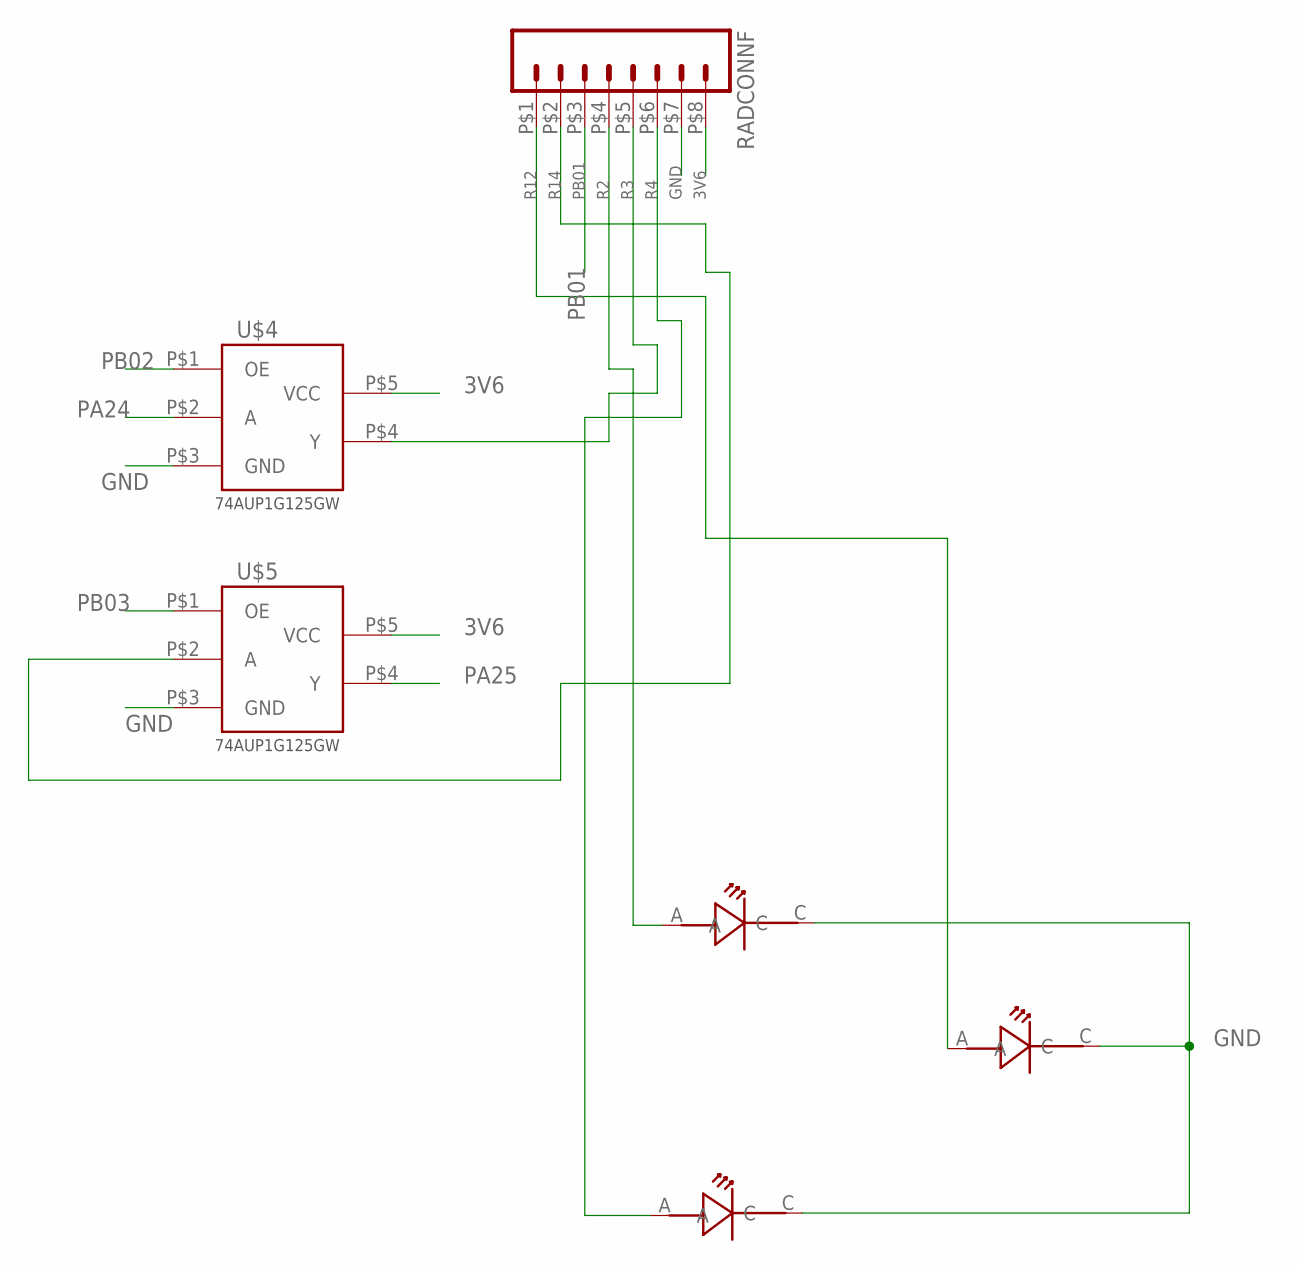
[picture p127: schematic EngineeringModelBoard.sch, sheet 6, Radio]

Parts:
RADCONNF: HARWIN_08; HARWIN_DATAMATE_08
U$4, U$5: 74AUP1G125GW; TSSOP-5; MPN 74AUP1G125GW
U$11, U$12, U$13: LT-T673-Q1R2-25-Z; PLCC-2

Connections:
3V6: RADCONNF.P$8 (8), U$4.P$5 (VCC), U$5.P$5 (VCC); also elsewhere on the board
GND: RADCONNF.P$7 (7), U$4.P$3 (GND), U$5.P$3 (GND), U$11.C, U$12.C, U$13.C; also elsewhere on the board
PA24: U$4.P$2 (A); also elsewhere on the board
PA25: U$5.P$4 (Y); also elsewhere on the board
PB01: RADCONNF.P$3 (3); also elsewhere on the board
PB02: U$4.P$1 (OE); also elsewhere on the board
PB03: U$5.P$1 (OE); also elsewhere on the board
R2: RADCONNF.P$4 (4), U$13.A
R3: RADCONNF.P$5 (5), U$4.P$4 (Y)
R4: RADCONNF.P$6 (6), U$12.A
R12: RADCONNF.P$1 (1), U$11.A
R14: RADCONNF.P$2 (2), U$5.P$2 (A)

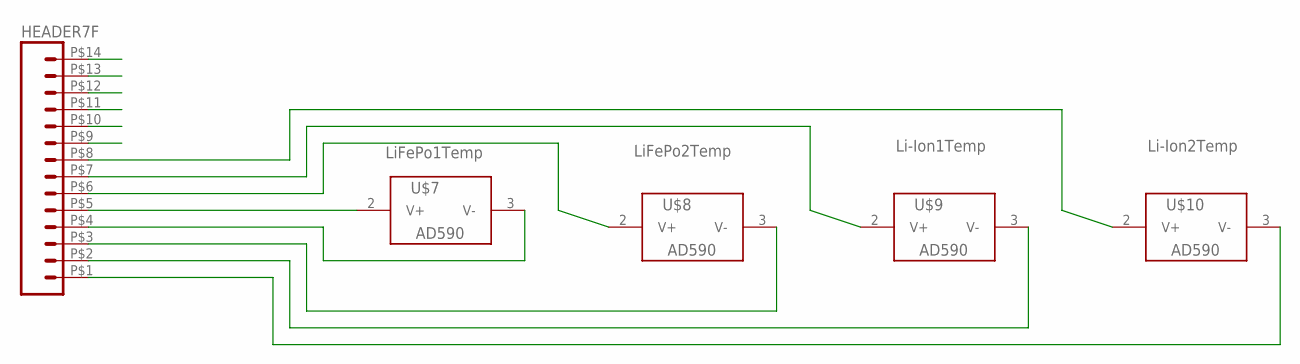
[picture p128: schematic EngineeringModelBoard.sch, sheet 7, Batteries]

Parts:
HEADER7F: HARWIN_14; HARWIN_DATAMATE_14
U$7, U$8, U$9, U$10: AD590-SOIC-8; 8SOIC; MPN AD590JRZ

Connections:
H7.1: HEADER7F.P$1 (1), U$10.3 (V-)
H7.2: HEADER7F.P$2 (2), U$9.3 (V-)
H7.3: HEADER7F.P$3 (3), U$8.3 (V-)
H7.4: HEADER7F.P$4 (4), U$7.3 (V-)
H7.5: HEADER7F.P$5 (5), U$7.2 (V+)
H7.6: HEADER7F.P$6 (6), U$8.2 (V+)
H7.7: HEADER7F.P$7 (7), U$9.2 (V+)
H7.8: HEADER7F.P$8 (8), U$10.2 (V+)
H7.9: HEADER7F.P$9 (9)
H7.10: HEADER7F.P$10 (10)
H7.11: HEADER7F.P$11 (11)
H7.12: HEADER7F.P$12 (12)
H7.13: HEADER7F.P$13 (13)
H7.14: HEADER7F.P$14 (14)

Notes on the sheet:
LiFePo1Temp
LiFePo2Temp
Li-Ion1Temp
Li-Ion2Temp

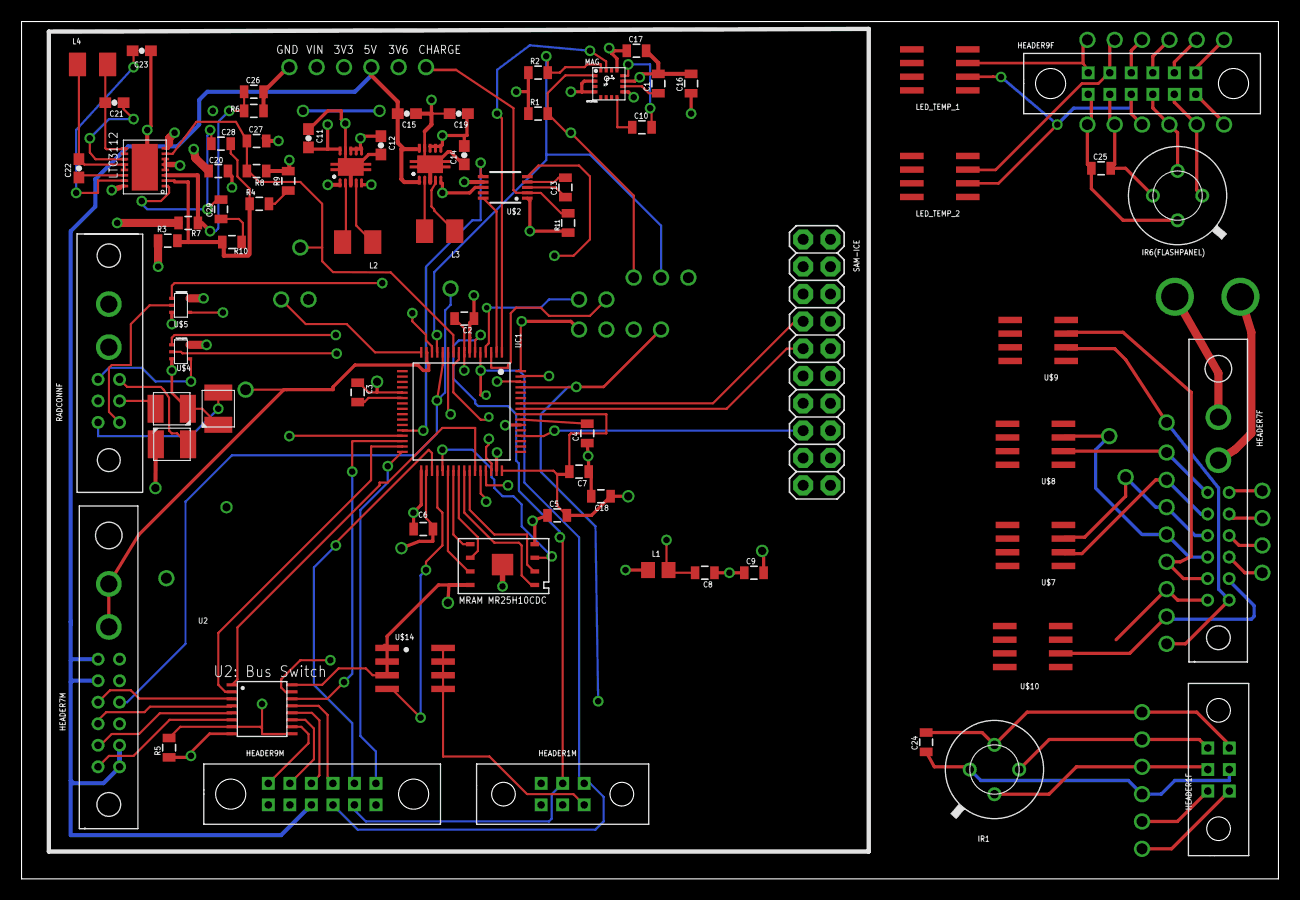
[picture p129: board EngineeringModelBoard.brd from above]

Board: 4 copper layers, 116.8 x 79.7 mm, 74 parts (0 on the bottom side), 95 nets.
