BrownSpaceEngineering/EquiSat-EAGLE/projects/EQUiSat/RomeBoard/RomeBoardV1.2.brd

## EAGLE design projects/EQUiSat/RomeBoard/RomeBoardV1.2.brd (2018-07-19)

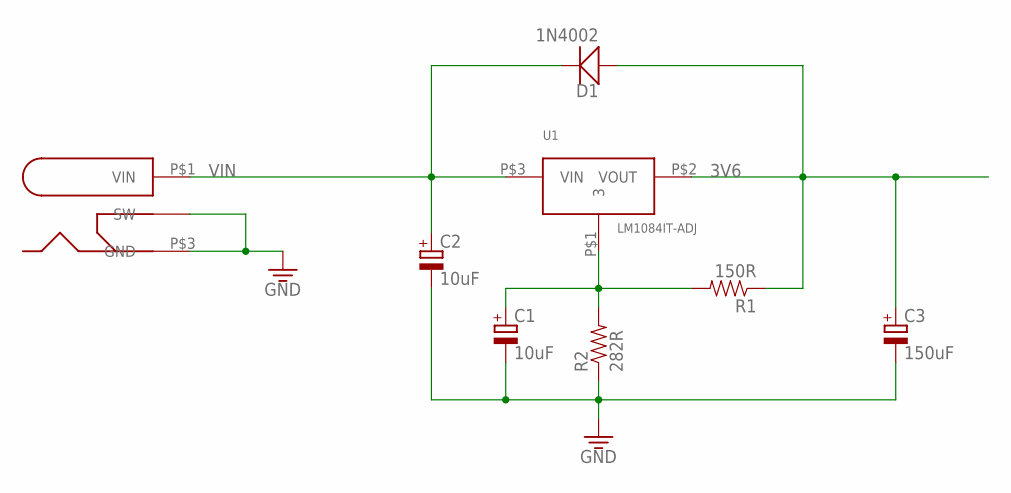
[picture p130: schematic RomeBoardV1.2.sch, sheet 1, Power and Regulation]

Parts:
C1, C2: 10uF; E2,5-7
C3: 150uF; E5-13
D1: 1N4002; DO-201AD
R1: 150R; AXIAL-0.4
R2: 282R; AXIAL-0.4
U1: LM1084IT-ADJ; TO-220-507302B00000G
U$2: PJ-002A

Connections:
3V6: C3.+, D1.P$1 (A), R1.1, U1.P$2 (VOUT); also elsewhere on the board
GND: C1.-, C2.-, C3.-, R2.1, U$2.P$2 (SW), U$2.P$3 (GND); also elsewhere on the board
unnamed: C1.+, R1.2, R2.2, U1.P$1 (3)
VIN: C2.+, D1.P$2 (C), U1.P$3 (VIN), U$2.P$1 (VIN); also elsewhere on the board

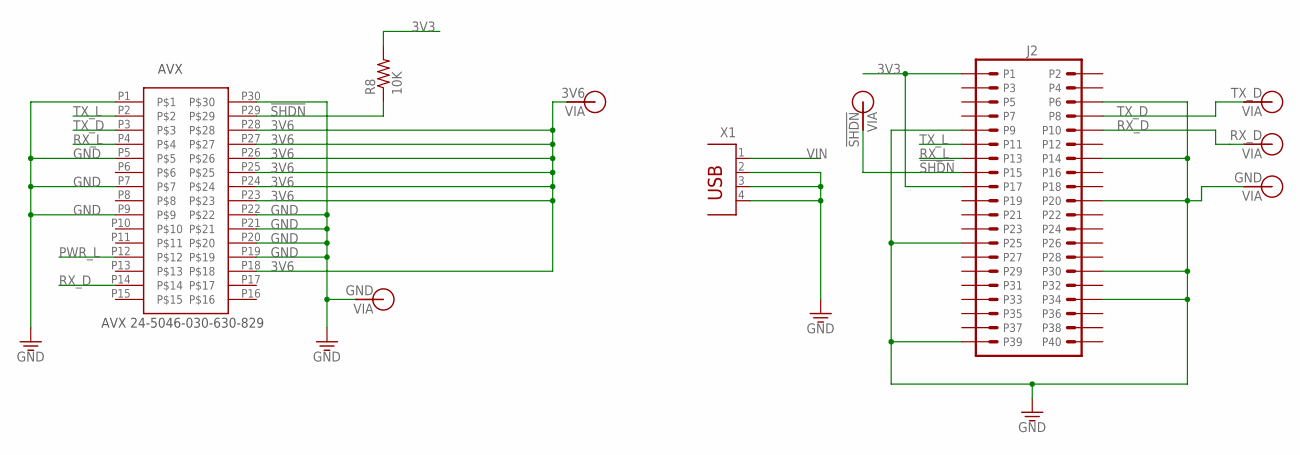
[picture p131: schematic RomeBoardV1.2.sch, sheet 2, Connectors]

Parts:
AVX: AVX-24-5046-030-630-829; AVX-24-5046-630-829
J2: RASPBERRY-PI-HEADER; HEADER-20X02
R8: 10K; AXIAL-0.4
V1: TX_D; VIA-60MIL
V2: RX_D; VIA-60MIL
V3: GND; VIA-60MIL
V4: GND; VIA-120MIL
V5: 3V6; VIA-120MIL
V6: !SHDN; VIA-60MIL
X1: PN87520

Connections:
3V3: J2.P1, J2.P17, R8.2
3V6: AVX.P18, AVX.P23, AVX.P24, AVX.P25, AVX.P26, AVX.P27, AVX.P28, V5.P$1; also elsewhere on the board
!SHDN: AVX.P29, J2.P15, R8.1, V6.P$1
GND: AVX.P1, AVX.P5, AVX.P7, AVX.P9, AVX.P19, AVX.P20, AVX.P21, AVX.P22, AVX.P30, J2.P6, J2.P9, J2.P14, J2.P20, J2.P25, J2.P30, J2.P34, J2.P39, V3.P$1, V4.P$1, X1.2, X1.3, X1.4; also elsewhere on the board
PWR_L: AVX.P12; also elsewhere on the board
RX_D: AVX.P14, J2.P10, V2.P$1
RX_L: AVX.P4, J2.P13; also elsewhere on the board
TX_D: AVX.P3, J2.P8, V1.P$1
TX_L: AVX.P2, J2.P11; also elsewhere on the board
VIN: X1.1; also elsewhere on the board

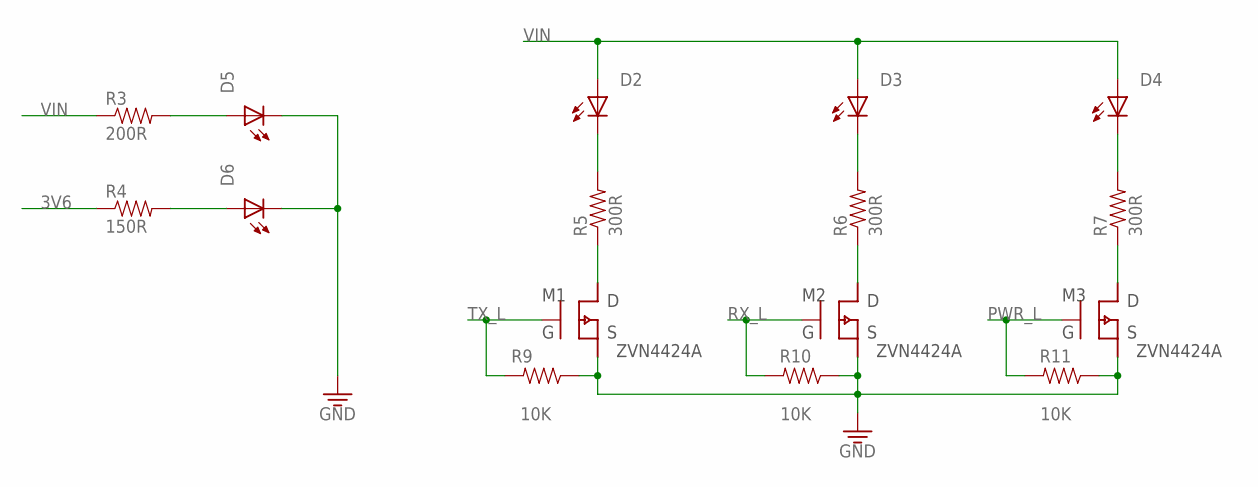
[picture p132: schematic RomeBoardV1.2.sch, sheet 3, LEDs]

Parts:
D2, D3, D4, D5, D6: LEDTHRU-HOLE-CONNECTOR; 1X2-POL
M1, M2, M3: ZVN4424A; TO-923-MOS
R3: 200R; AXIAL-0.4
R4: 150R; AXIAL-0.4
R5, R6, R7: 300R; AXIAL-0.4
R9, R10, R11: 10K; AXIAL-0.4

Connections:
3V6: R4.1; also elsewhere on the board
GND: D5.2 (C), D6.2 (C), M1.3 (S), M2.3 (S), M3.3 (S), R9.1, R10.1, R11.1; also elsewhere on the board
unnamed: D5.1 (A), R3.2
unnamed: D6.1 (A), R4.2
unnamed: D3.2 (C), R6.2
unnamed: M1.1 (D), R5.1
unnamed: M2.1 (D), R6.1
unnamed: M3.1 (D), R7.1
unnamed: D4.2 (C), R7.2
unnamed: D2.2 (C), R5.2
PWR_L: M3.2 (G), R11.2; also elsewhere on the board
RX_L: M2.2 (G), R10.2; also elsewhere on the board
TX_L: M1.2 (G), R9.2; also elsewhere on the board
VIN: D2.1 (A), D3.1 (A), D4.1 (A), R3.1; also elsewhere on the board

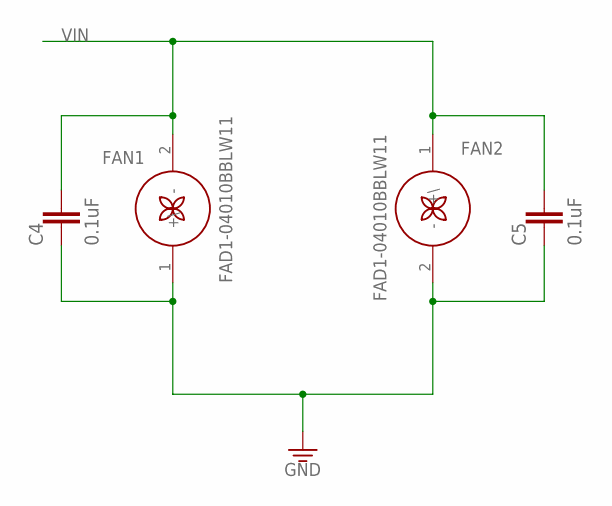
[picture p133: schematic RomeBoardV1.2.sch, sheet 4, Fans]

Parts:
C4, C5: 0.1uF; C050-025X075
FAN1, FAN2: FAD1-04010BBLW11; 1X2-POL

Connections:
GND: C4.2, C5.2, FAN1.1 (+\), FAN2.2 (-); also elsewhere on the board
VIN: C4.1, C5.1, FAN1.2 (-), FAN2.1 (+\); also elsewhere on the board

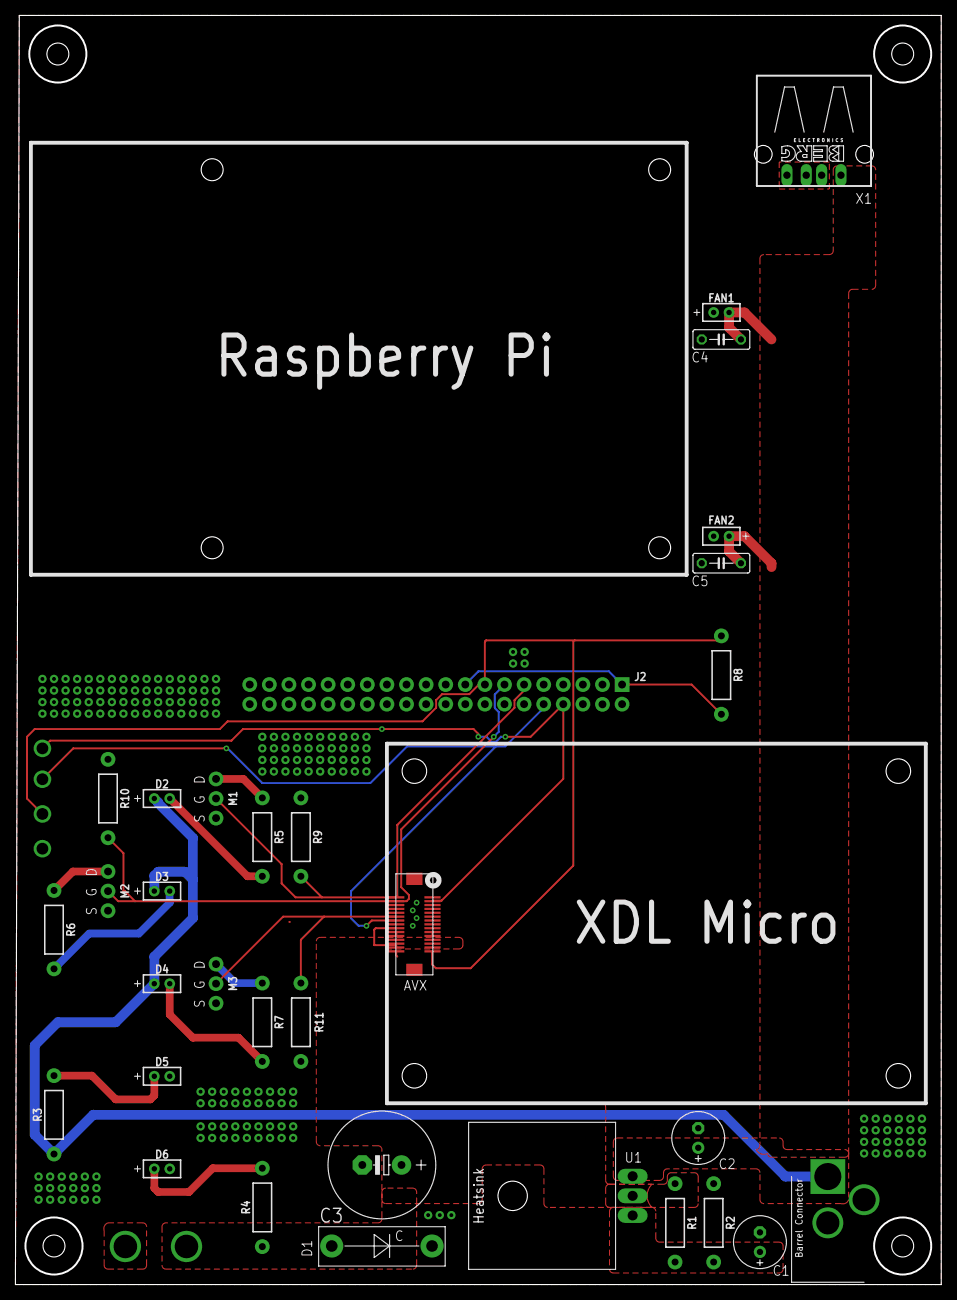
[picture p134: board RomeBoardV1.2.brd from above]

Board: 2 copper layers, 120.0 x 164.5 mm, 38 parts (0 on the bottom side), 19 nets.
