BrownSpaceEngineering/EquiSat-EAGLE/projects/EQUiSat/BatteryBoard/BatteryBoardV2.brd

## EAGLE design projects/EQUiSat/BatteryBoard/BatteryBoardV2.brd (2019-03-11, an earlier design)

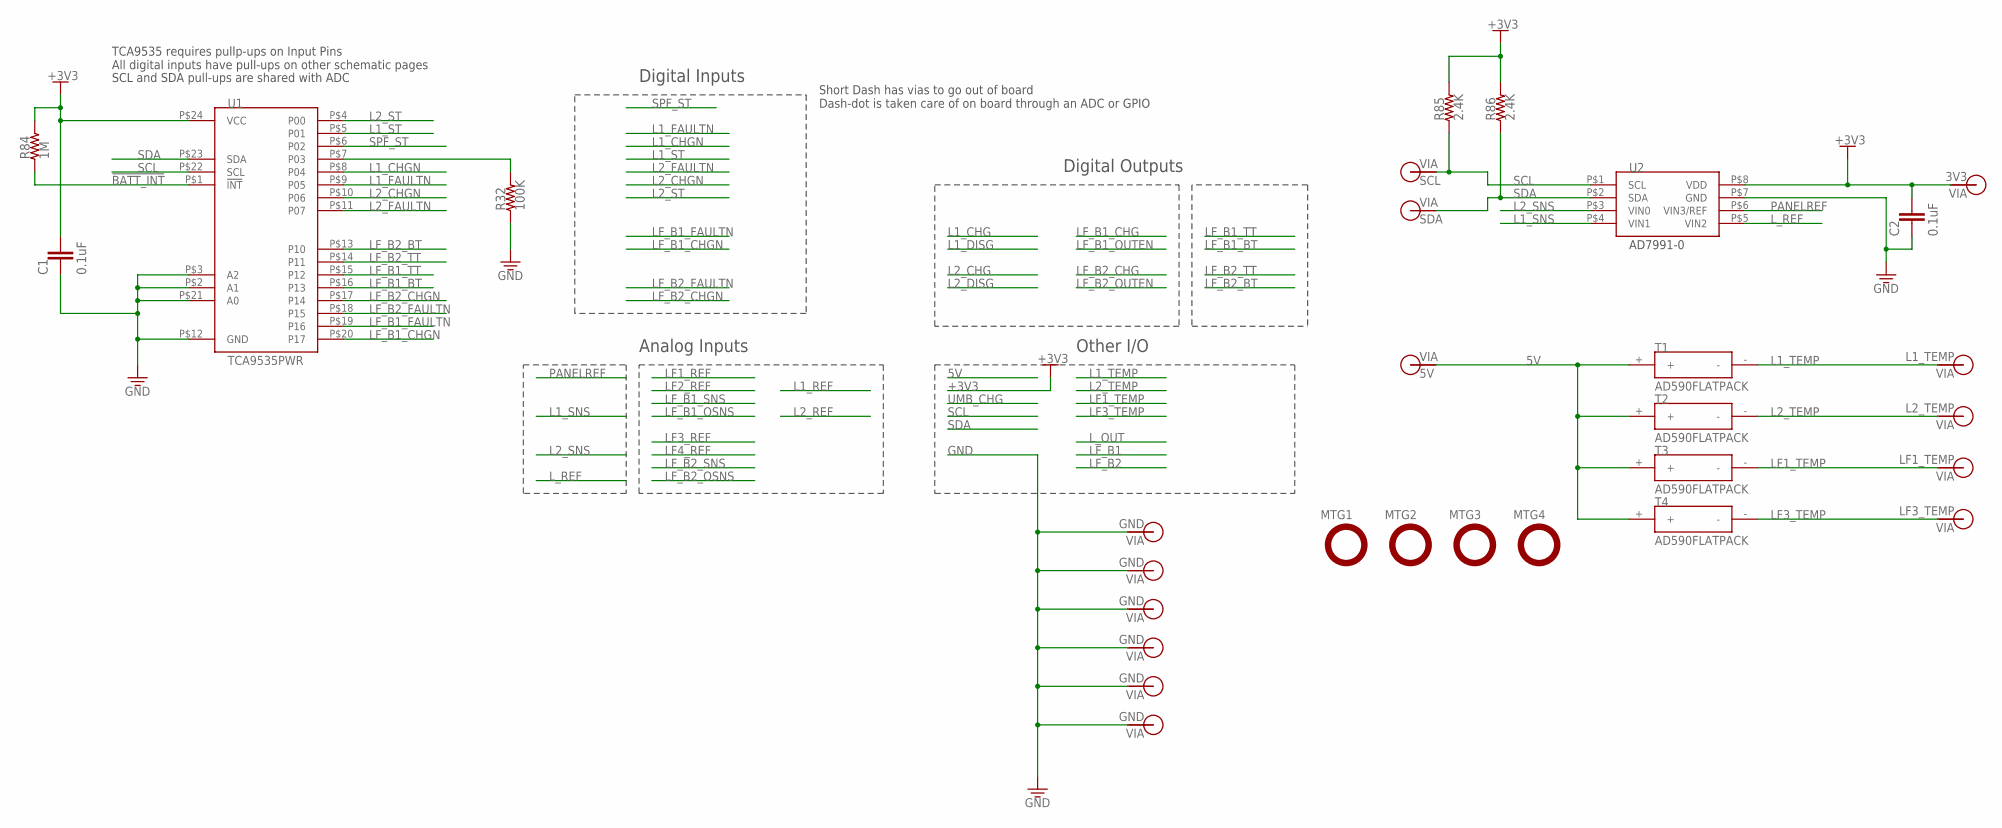
[picture p135: schematic BatteryBoardV2.sch, sheet 1, Data and I/O]

Parts:
C1, C2: 0.1uF; 0805
MTG1, MTG2, MTG3, MTG4: MTG-NPTH-#2-CLOSE; #2-CLOSE-NPTH
R32: 100K; 0805
R84: 1M; 0805
R85, R86: 2.4K; 0805
T1, T2, T3, T4: AD590FLATPACK; FLATPACK
U1: TCA9535PWR; TSSOP-24
U2: AD7991-0; SOT-23-8
V1, V2, V4: GND; VIA-120MIL
V3, V28, V36: GND; VIA-60MIL-SQ
V5: SCL; VIA-60MIL
V6: SDA; VIA-60MIL
V7: 5V; VIA-60MIL
V8: L1_TEMP; VIA-60MIL
V9: L2_TEMP; VIA-60MIL
V10: LF1_TEMP; VIA-60MIL
V11: LF3_TEMP; VIA-60MIL
V12: 3V3; VIA-60MIL

Connections:
5V: T1.+, T2.+, T3.+, T4.+, V7.P$1
!BATT_INT!: R84.1, U1.P$1 (!INT!)
+3V3: C1.1, C2.1, R84.2, R85.2, R86.2, U1.P$24 (VCC), U2.P$8 (VDD), V12.P$1; also elsewhere on the board
GND: C1.2, C2.2, R32.1, U1.P$2 (A1), U1.P$3 (A2), U1.P$12 (GND), U1.P$21 (A0), U2.P$7 (GND), V1.P$1, V2.P$1, V3.P$1, V4.P$1, V28.P$1, V36.P$1; also elsewhere on the board
L1_CHGN: U1.P$8 (P04); also elsewhere on the board
L1_FAULTN: U1.P$9 (P05); also elsewhere on the board
L1_SNS: U2.P$4 (VIN1); also elsewhere on the board
L1_ST: U1.P$5 (P01); also elsewhere on the board
L1_TEMP: T1.-, V8.P$1
L2_CHGN: U1.P$10 (P06); also elsewhere on the board
L2_FAULTN: U1.P$11 (P07); also elsewhere on the board
L2_SNS: U2.P$3 (VIN0); also elsewhere on the board
L2_ST: U1.P$4 (P00); also elsewhere on the board
L2_TEMP: T2.-, V9.P$1
LF1_TEMP: T3.-, V10.P$1
LF3_TEMP: T4.-, V11.P$1
LF_B1_BT: U1.P$16 (P13); also elsewhere on the board
LF_B1_CHGN: U1.P$20 (P17); also elsewhere on the board
LF_B1_FAULTN: U1.P$19 (P16); also elsewhere on the board
LF_B1_TT: U1.P$15 (P12); also elsewhere on the board
LF_B2_BT: U1.P$13 (P10); also elsewhere on the board
LF_B2_CHGN: U1.P$17 (P14); also elsewhere on the board
LF_B2_FAULTN: U1.P$18 (P15); also elsewhere on the board
LF_B2_TT: U1.P$14 (P11); also elsewhere on the board
L_REF: U2.P$5 (VIN2); also elsewhere on the board
unnamed: R32.2, U1.P$7 (P03)
PANELREF: U2.P$6 (VIN3/REF); also elsewhere on the board
SCL: R85.1, U1.P$22 (SCL), U2.P$1 (SCL), V5.P$1
SDA: R86.1, U1.P$23 (SDA), U2.P$2 (SDA), V6.P$1
SPF_ST: U1.P$6 (P02); also elsewhere on the board

Notes on the sheet:
Digital Inputs
Digital Outputs
Analog Inputs
Other I/O
Short Dash has vias to go out of board Dash-dot is taken care of on board through an ADC or GPIO
SCL and SDA pull-ups are shared with ADC
TCA9535 requires pullp-ups on Input Pins All digital inputs have pull-ups on other schematic pages

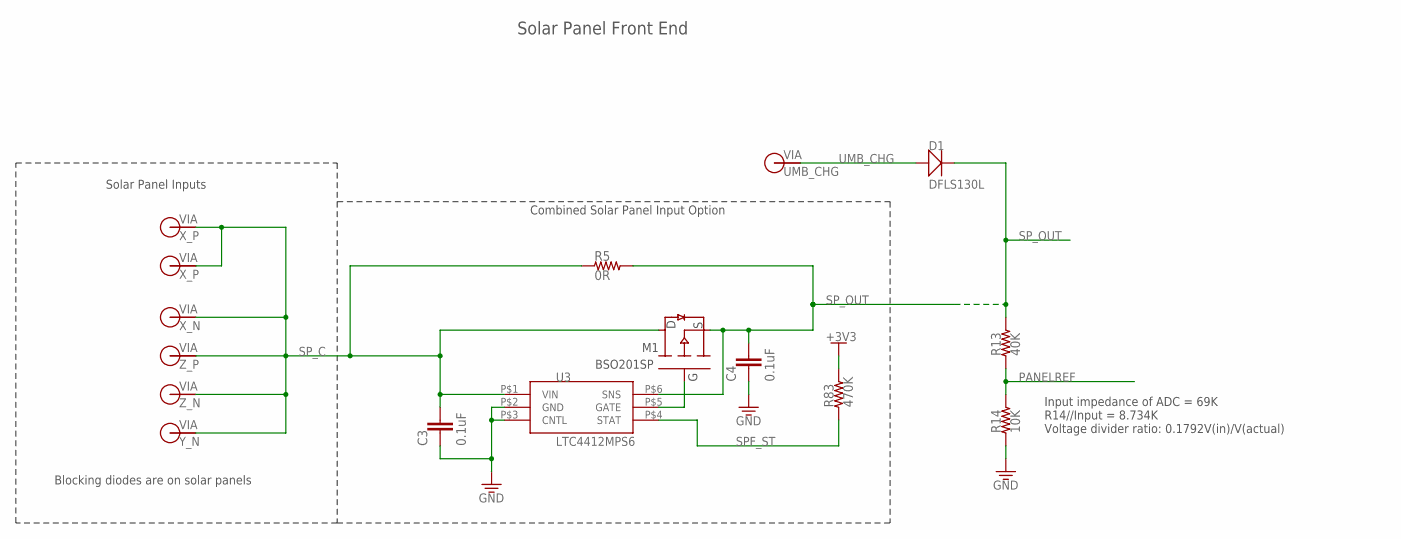
[picture p136: schematic BatteryBoardV2.sch, sheet 2, Solar Panel Front End]

Parts:
C3, C4: 0.1uF; 0805
D1: DFLS130L; PWRDI-123
M1: BSO201SP; SO-8
R5: 0R; 0805
R13: 40K; 0805
R14: 10K; 0805
R83: 470K; 0805
U3: LTC4412MPS6; TSOT23-6
V13: X_P; VIA-60MIL
V14: X_P; VIA-60MIL-SQ
V15: X_N; VIA-60MIL
V16: Z_P; VIA-60MIL
V17: Z_N; VIA-60MIL
V18: Y_N; VIA-60MIL
V19: UMB_CHG; VIA-60MIL

Connections:
+3V3: R83.2; also elsewhere on the board
GND: C3.2, C4.2, R14.1, U3.P$2 (GND), U3.P$3 (CNTL); also elsewhere on the board
unnamed: M1.P$4 (G), U3.P$5 (GATE)
PANELREF: R13.1, R14.2; also elsewhere on the board
SPF_ST: R83.1, U3.P$4 (STAT); also elsewhere on the board
SP_C: C3.1, M1.P$5 (D), M1.P$6 (D), M1.P$7 (D), M1.P$8 (D), R5.1, U3.P$1 (VIN), V13.P$1, V14.P$1, V15.P$1, V16.P$1, V17.P$1, V18.P$1
SP_OUT: C4.1, D1.C, M1.P$1 (S), M1.P$2 (S), M1.P$3 (S), R5.2, R13.2, U3.P$6 (SNS); also elsewhere on the board
UMB_CHG: D1.A, V19.P$1

Notes on the sheet:
Solar Panel Inputs
Combined Solar Panel Input Option
Solar Panel Front End
Blocking diodes are on solar panels
Input impedance of ADC = 69K R14//Input = 8.734K Voltage divider ratio: 0.1792V(in)/V(actual)

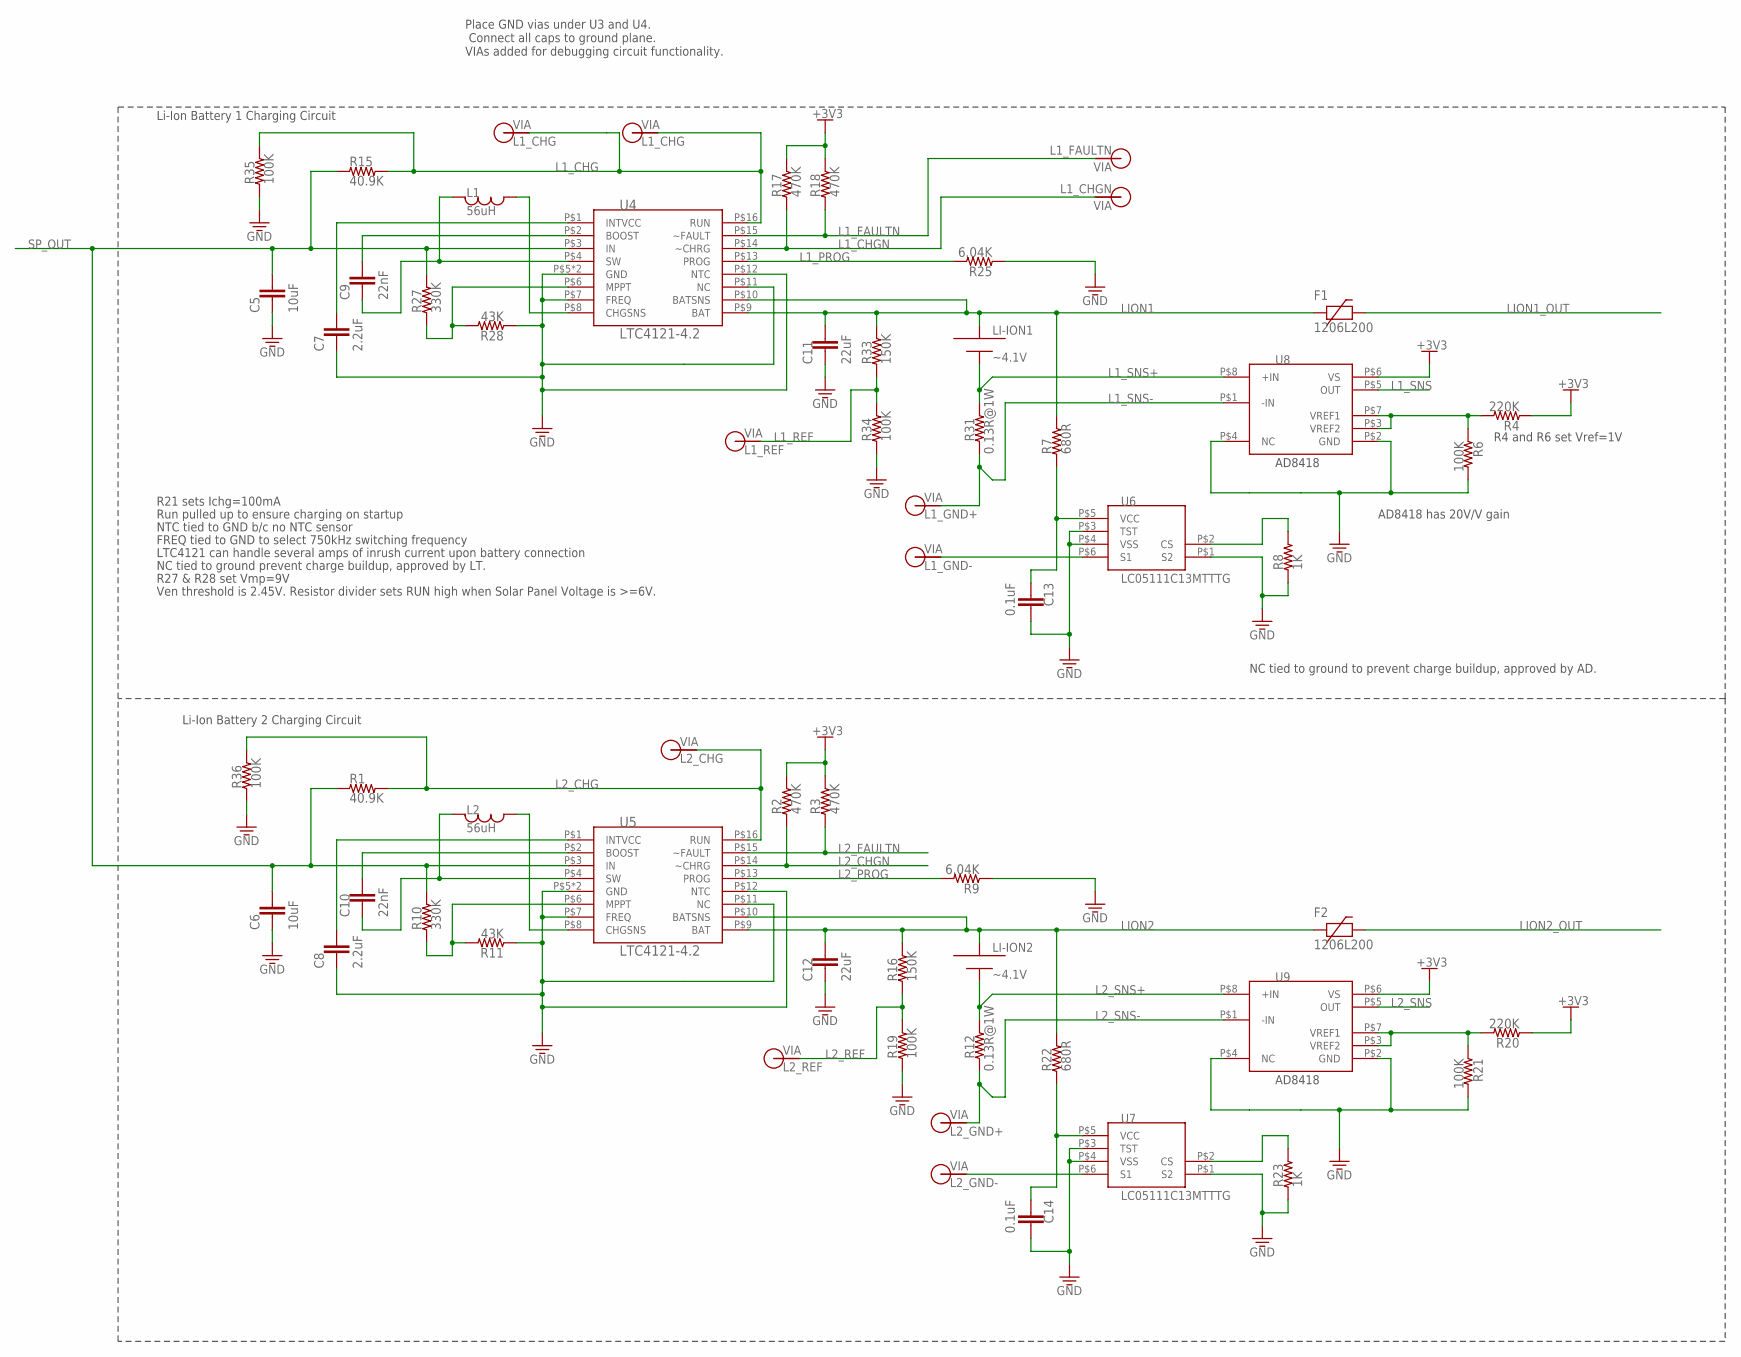
[picture p137: schematic BatteryBoardV2.sch, sheet 3, Li-Ion Charging]

Parts:
C5, C6: 10uF; 0805
C7, C8: 2.2uF; 0805
C9, C10: 22nF; 0805
C11, C12: 22uF; 0805
C13, C14: 0.1uF; 0805
F1, F2: 1206L200; 1206
L1, L2: 56uH; 1812
LI-ION1, LI-ION2: ~4.1V; EQUISAT-BATTERY-VA
R1, R15: 40.9K; 0805
R2, R3, R17, R18: 470K; 0805
R4, R20: 220K; 0805
R6, R19, R21, R34, R35, R36: 100K; 0805
R7, R22: 680R; 0805
R8, R23: 1K; 0805
R9, R25: 6.04K; 0805
R10, R27: 330K; 0805
R11, R28: 43K; 0805
R12, R31: 0.13R@1W; 1210
R16, R33: 150K; 0805
U4, U5: LTC4121-4.2; QFN-16-PAD
U6, U7: LC05111C13MTTTG; WDFN6
U8, U9: AD8418; MSOP-8
V20: L1_CHG; VIA-60MIL
V21: L1_REF; VIA-60MIL
V22: L1_GND+; VIA-60MIL
V23: L1_GND-; VIA-60MIL
V24: L2_GND+; VIA-60MIL
V25: L2_GND-; VIA-60MIL
V26: L1_FAULTN; VIA-60MIL-SQ
V27: L1_CHGN; VIA-60MIL-SQ
V31: L2_REF; VIA-60MIL
V33: L2_CHG; VIA-60MIL
V48: L1_CHG; VIA-60MIL-SQ

Connections:
+3V3: R2.2, R3.2, R4.1, R17.2, R18.2, R20.1, U8.P$6 (VS), U9.P$6 (VS); also elsewhere on the board
GND: C5.2, C6.2, C7.2, C8.2, C11.2, C12.2, C13.1, C14.1, R6.2, R8.1, R9.1, R11.1, R19.1, R21.2, R23.1, R25.1, R28.1, R34.1, R35.1, R36.1, U4.P$5 (GND), U4.P$7 (FREQ), U4.P$11 (NC), U4.P$12 (NTC), U4.P$17 (GND), U5.P$5 (GND), U5.P$7 (FREQ), U5.P$11 (NC), U5.P$12 (NTC), U5.P$17 (GND), U6.P$1 (S2), U6.P$3 (TST), U6.P$4 (VSS), U7.P$1 (S2), U7.P$3 (TST), U7.P$4 (VSS), U8.P$2 (GND), U8.P$4 (NC), U9.P$2 (GND), U9.P$4 (NC); also elsewhere on the board
L1_CHG: R15.2, R35.2, U4.P$16 (RUN), V20.P$1, V48.P$1
L1_CHGN: R17.1, U4.P$14 (~CHRG), V27.P$1; also elsewhere on the board
L1_FAULTN: R18.1, U4.P$15 (~FAULT), V26.P$1; also elsewhere on the board
L1_PROG: R25.2, U4.P$13 (PROG)
L1_REF: R33.1, R34.2, V21.P$1
L1_SNS: U8.P$5 (OUT); also elsewhere on the board
L1_SNS+: LI-ION1.MINUS, R31.P$2 (2), U8.P$8 (+IN)
L1_SNS-: R31.P$1 (1), U8.P$1 (-IN), V22.P$1
L2_CHG: R1.2, R36.2, U5.P$16 (RUN), V33.P$1
L2_CHGN: R2.1, U5.P$14 (~CHRG); also elsewhere on the board
L2_FAULTN: R3.1, U5.P$15 (~FAULT); also elsewhere on the board
L2_PROG: R9.2, U5.P$13 (PROG)
L2_REF: R16.1, R19.2, V31.P$1
L2_SNS: U9.P$5 (OUT); also elsewhere on the board
L2_SNS+: LI-ION2.MINUS, R12.P$2 (2), U9.P$8 (+IN)
L2_SNS-: R12.P$1 (1), U9.P$1 (-IN), V24.P$1
LION1: C11.1, F1.1, LI-ION1.PLUS, R7.2, R33.2, U4.P$9 (BAT), U4.P$10 (BATSNS)
LION1_OUT: F1.2; also elsewhere on the board
LION2: C12.1, F2.1, LI-ION2.PLUS, R16.2, R22.2, U5.P$9 (BAT), U5.P$10 (BATSNS)
LION2_OUT: F2.2; also elsewhere on the board
unnamed: C10.2, L2.P$1, U5.P$4 (SW)
unnamed: C9.2, L1.P$1, U4.P$4 (SW)
unnamed: C9.1, U4.P$2 (BOOST)
unnamed: C7.1, U4.P$1 (INTVCC)
unnamed: C10.1, U5.P$2 (BOOST)
unnamed: U6.P$6 (S1), V23.P$1
unnamed: C8.1, U5.P$1 (INTVCC)
unnamed: L1.P$2, U4.P$8 (CHGSNS)
unnamed: R27.1, R28.2, U4.P$6 (MPPT)
unnamed: R4.2, R6.1, U8.P$3 (VREF2), U8.P$7 (VREF1)
unnamed: C13.2, R7.1, U6.P$5 (VCC)
unnamed: R8.2, U6.P$2 (CS)
unnamed: R10.1, R11.2, U5.P$6 (MPPT)
unnamed: L2.P$2, U5.P$8 (CHGSNS)
unnamed: R20.2, R21.1, U9.P$3 (VREF2), U9.P$7 (VREF1)
unnamed: U7.P$6 (S1), V25.P$1
unnamed: R23.2, U7.P$2 (CS)
unnamed: C14.2, R22.1, U7.P$5 (VCC)
SP_OUT: C5.1, C6.1, R1.1, R10.2, R15.1, R27.2, U4.P$3 (IN), U5.P$3 (IN); also elsewhere on the board

Notes on the sheet:
FREQ tied to GND to select 750kHz switching frequency
R21 sets Ichg=100mA
R27 & R28 set Vmp=9V
Place GND vias under U3 and U4. Connect all caps to ground plane. VIAs added for debugging circuit functionality.
Li-Ion Battery 1 Charging Circuit
Li-Ion Battery 2 Charging Circuit
Run pulled up to ensure charging on startup
NTC tied to GND b/c no NTC sensor
LTC4121 can handle several amps of inrush current upon battery connection
NC tied to ground prevent charge buildup, approved by LT.
R4 and R6 set Vref=1V
NC tied to ground to prevent charge buildup, approved by AD.
AD8418 has 20V/V gain
Ven threshold is 2.45V. Resistor divider sets RUN high when Solar Panel Voltage is >=6V.
