BrownSpaceEngineering/EquiSat-EAGLE/projects/EQUiSat/BatteryBoard/BatteryBoardV2.brd

## EAGLE design projects/EQUiSat/BatteryBoard/BatteryBoardV2.brd (continued)

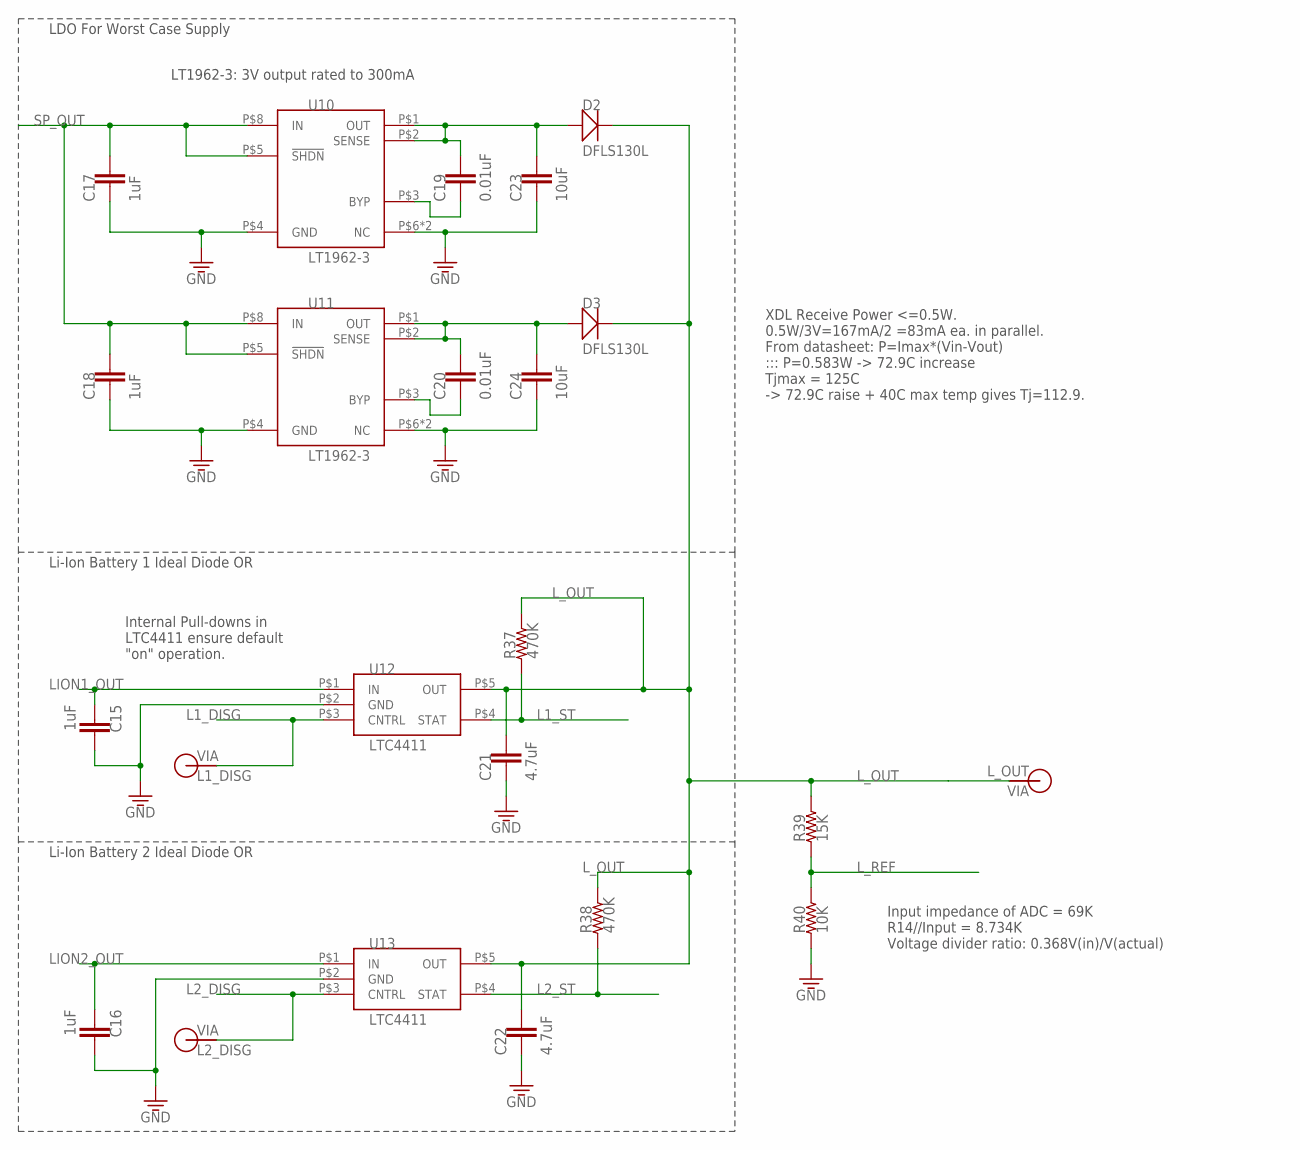
[picture p138: schematic BatteryBoardV2.sch, sheet 4, Li-Ion Diode Or'ing]

Parts:
C15, C16, C17, C18: 1uF; 0805
C19, C20: 0.01uF; 0805
C21, C22: 4.7uF; 0805
C23, C24: 10uF; 0805
D2, D3: DFLS130L; PWRDI-123
R37, R38: 470K; 0805
R39: 15K; 0805
R40: 10K; 0805
U10, U11: LT1962-3; MSOP-8
U12, U13: LTC4411; TSOT23-5
V29: L1_DISG; VIA-60MIL
V30: L2_DISG; VIA-60MIL
V34: L_OUT; VIA-120MIL

Connections:
GND: C15.1, C16.1, C17.2, C18.2, C21.2, C22.2, C23.2, C24.2, R40.1, U10.P$4 (GND), U10.P$6 (NC), U10.P$7 (NC), U11.P$4 (GND), U11.P$6 (NC), U11.P$7 (NC), U12.P$2 (GND), U13.P$2 (GND); also elsewhere on the board
L1_DISG: U12.P$3 (CNTRL), V29.P$1
L1_ST: R37.1, U12.P$4 (STAT); also elsewhere on the board
L2_DISG: U13.P$3 (CNTRL), V30.P$1
L2_ST: R38.1, U13.P$4 (STAT); also elsewhere on the board
LION1_OUT: C15.2, U12.P$1 (IN); also elsewhere on the board
LION2_OUT: C16.2, U13.P$1 (IN); also elsewhere on the board
L_OUT: C21.1, C22.1, D2.C, D3.C, R37.2, R38.2, R39.2, U12.P$5 (OUT), U13.P$5 (OUT), V34.P$1
L_REF: R39.1, R40.2; also elsewhere on the board
unnamed: C20.1, C24.1, D3.A, U11.P$1 (OUT), U11.P$2 (SENSE)
unnamed: C19.1, C23.1, D2.A, U10.P$1 (OUT), U10.P$2 (SENSE)
unnamed: C20.2, U11.P$3 (BYP)
unnamed: C19.2, U10.P$3 (BYP)
SP_OUT: C17.1, C18.1, U10.P$5 (!SHDN!), U10.P$8 (IN), U11.P$5 (!SHDN!), U11.P$8 (IN); also elsewhere on the board

Notes on the sheet:
Internal Pull-downs in LTC4411 ensure default "on" operation.
Li-Ion Battery 1 Ideal Diode OR
Li-Ion Battery 2 Ideal Diode OR
LDO For Worst Case Supply
LT1962-3: 3V output rated to 300mA
XDL Receive Power <=0.5W. 0.5W/3V=167mA/2 =83mA ea. in parallel. From datasheet: P=Imax*(Vin-Vout) ::: P=0.583W -> 72.9C increase Tjmax = 125C -> 72.9C raise + 40C max temp gives Tj=112.9.
Input impedance of ADC = 69K R14//Input = 8.734K Voltage divider ratio: 0.368V(in)/V(actual)

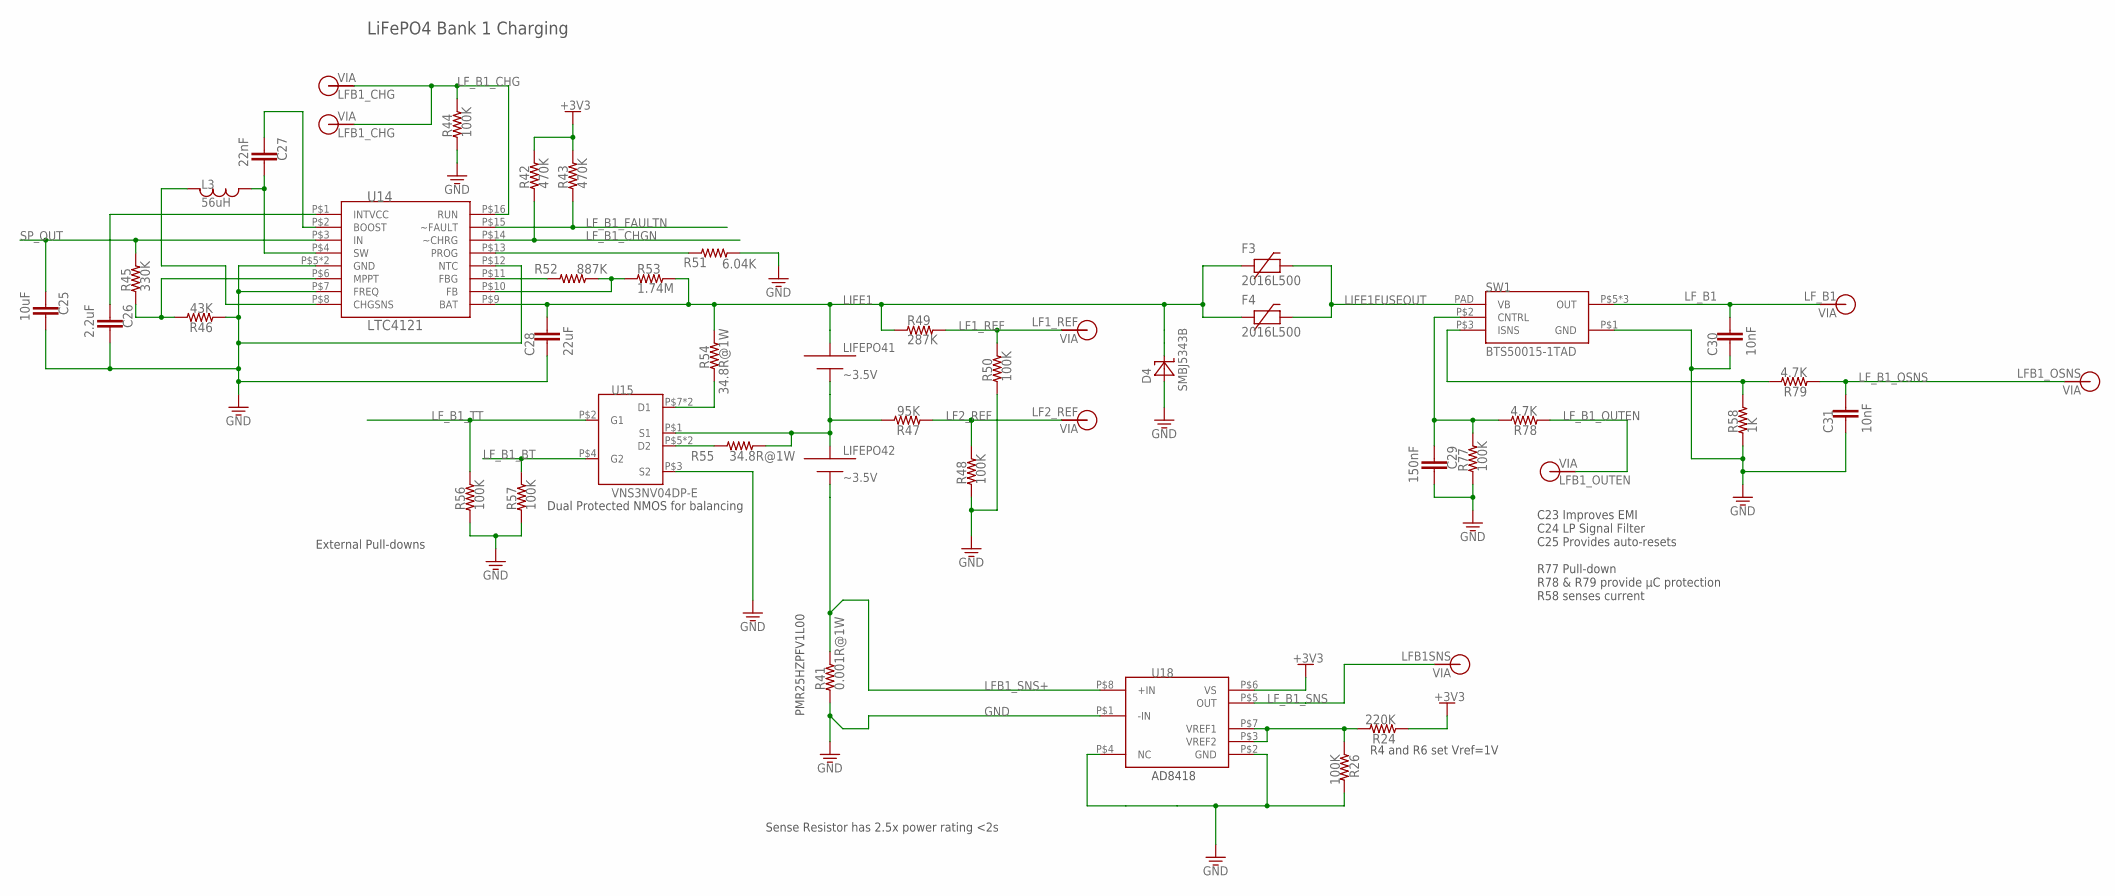
[picture p139: schematic BatteryBoardV2.sch, sheet 5, LiFePO4 Bank 1 Charging]

Parts:
C25: 10uF; 0805
C26: 2.2uF; 0805
C27: 22nF; 0805
C28: 22uF; 0805
C29: 150nF; 0805
C30, C31: 10nF; 0805
D4: SMBJ5343B; DO214AA
F3, F4: 2016L500; 2016
L3: 56uH; 1812
LIFEPO41: ~3.5V; EQUISAT-BATTERY-VA
LIFEPO42: ~3.5V; EQUISAT-BATTERY-VB
R24: 220K; 0805
R26, R44, R48, R50, R56, R57, R77: 100K; 0805
R41: 0.001R@1W; 1210
R42, R43: 470K; 0805
R45: 330K; 0805
R46: 43K; 0805
R47: 95K; 0805
R49: 287K; 0805
R51: 6.04K; 0805
R52: 887K; 0805
R53: 1.74M; 0805
R54, R55: 34.8R@1W; 1210
R58: 1K; 0805
R78, R79: 4.7K; 0805
SW1: BTS50015-1TAD; TO-263-7-8
U14: LTC4121; QFN-16-PAD
U15: VNS3NV04DP-E; SO-8
U18: AD8418; MSOP-8
V32: LFB1_CHG; VIA-60MIL-SQ
V35: LFB1_CHG; VIA-60MIL
V40: LFB1SNS; VIA-60MIL
V41: LF1_REF; VIA-60MIL
V42: LF2_REF; VIA-60MIL
V43: LFB1_OUTEN; VIA-60MIL
V45: LF_B1; VIA-120MIL
V46: LFB1_OSNS; VIA-60MIL

Connections:
+3V3: R24.1, R42.2, R43.2, U18.P$6 (VS); also elsewhere on the board
GND: C25.1, C26.1, C28.2, C29.1, C30.2, C31.2, D4.A, R26.2, R41.P$1 (1), R44.1, R46.1, R48.1, R50.1, R51.2, R56.1, R57.1, R58.1, R77.1, SW1.P$1 (GND), U14.P$5 (GND), U14.P$7 (FREQ), U14.P$12 (NTC), U14.P$17 (GND), U15.P$3 (S2), U18.P$1 (-IN), U18.P$2 (GND), U18.P$4 (NC); also elsewhere on the board
LF1_REF: R49.2, R50.2, V41.P$1
LF2_REF: R47.1, R48.2, V42.P$1
LFB1_SNS+: LIFEPO42.MINUS, R41.P$2 (2), U18.P$8 (+IN)
LF_B1: C30.1, SW1.P$5 (OUT), SW1.P$6 (OUT), SW1.P$7 (OUT), V45.P$1
LF_B1_BT: R57.2, U15.P$4 (G2); also elsewhere on the board
LF_B1_CHG: R44.2, U14.P$16 (RUN), V32.P$1, V35.P$1
LF_B1_CHGN: R42.1, U14.P$14 (~CHRG); also elsewhere on the board
LF_B1_FAULTN: R43.1, U14.P$15 (~FAULT); also elsewhere on the board
LF_B1_OSNS: C31.1, R79.1, V46.P$1
LF_B1_OUTEN: R78.1, V43.P$1
LF_B1_SNS: U18.P$5 (OUT), V40.P$1
LF_B1_TT: R56.2, U15.P$2 (G1); also elsewhere on the board
LIFE1: C28.1, D4.C, F3.P$1, F4.P$1, LIFEPO41.PLUS, R49.1, R53.2, R54.P$2 (2), U14.P$9 (BAT)
LIFE1FUSEOUT: F3.P$2, F4.P$2, SW1.PAD (VB)
LIFE2: LIFEPO41.MINUS, LIFEPO42.PLUS, R47.2, R55.P$1 (1), U15.P$1 (S1)
unnamed: R51.1, U14.P$13 (PROG)
unnamed: R24.2, R26.1, U18.P$3 (VREF2), U18.P$7 (VREF1)
unnamed: R54.P$1 (1), U15.P$7 (D1), U15.P$8 (D1)
unnamed: R55.P$2 (2), U15.P$5 (D2), U15.P$6 (D2)
unnamed: R52.1, U14.P$11 (FBG)
unnamed: R45.1, R46.2, U14.P$6 (MPPT)
unnamed: R52.2, R53.1, U14.P$10 (FB)
unnamed: C26.2, U14.P$1 (INTVCC)
unnamed: C27.1, L3.P$2, U14.P$4 (SW)
unnamed: C27.2, U14.P$2 (BOOST)
unnamed: L3.P$1, U14.P$8 (CHGSNS)
unnamed: C29.2, R77.2, R78.2, SW1.P$2 (CNTRL)
unnamed: R58.2, R79.2, SW1.P$3 (ISNS)
SP_OUT: C25.2, R45.2, U14.P$3 (IN); also elsewhere on the board

Notes on the sheet:
LiFePO4 Bank 1 Charging
External Pull-downs
Dual Protected NMOS for balancing
C23 Improves EMI C24 LP Signal Filter C25 Provides auto-resets R77 Pull-down R78 & R79 provide µC protection R58 senses current
R4 and R6 set Vref=1V
PMR25HZPFV1L00
Sense Resistor has 2.5x power rating <2s

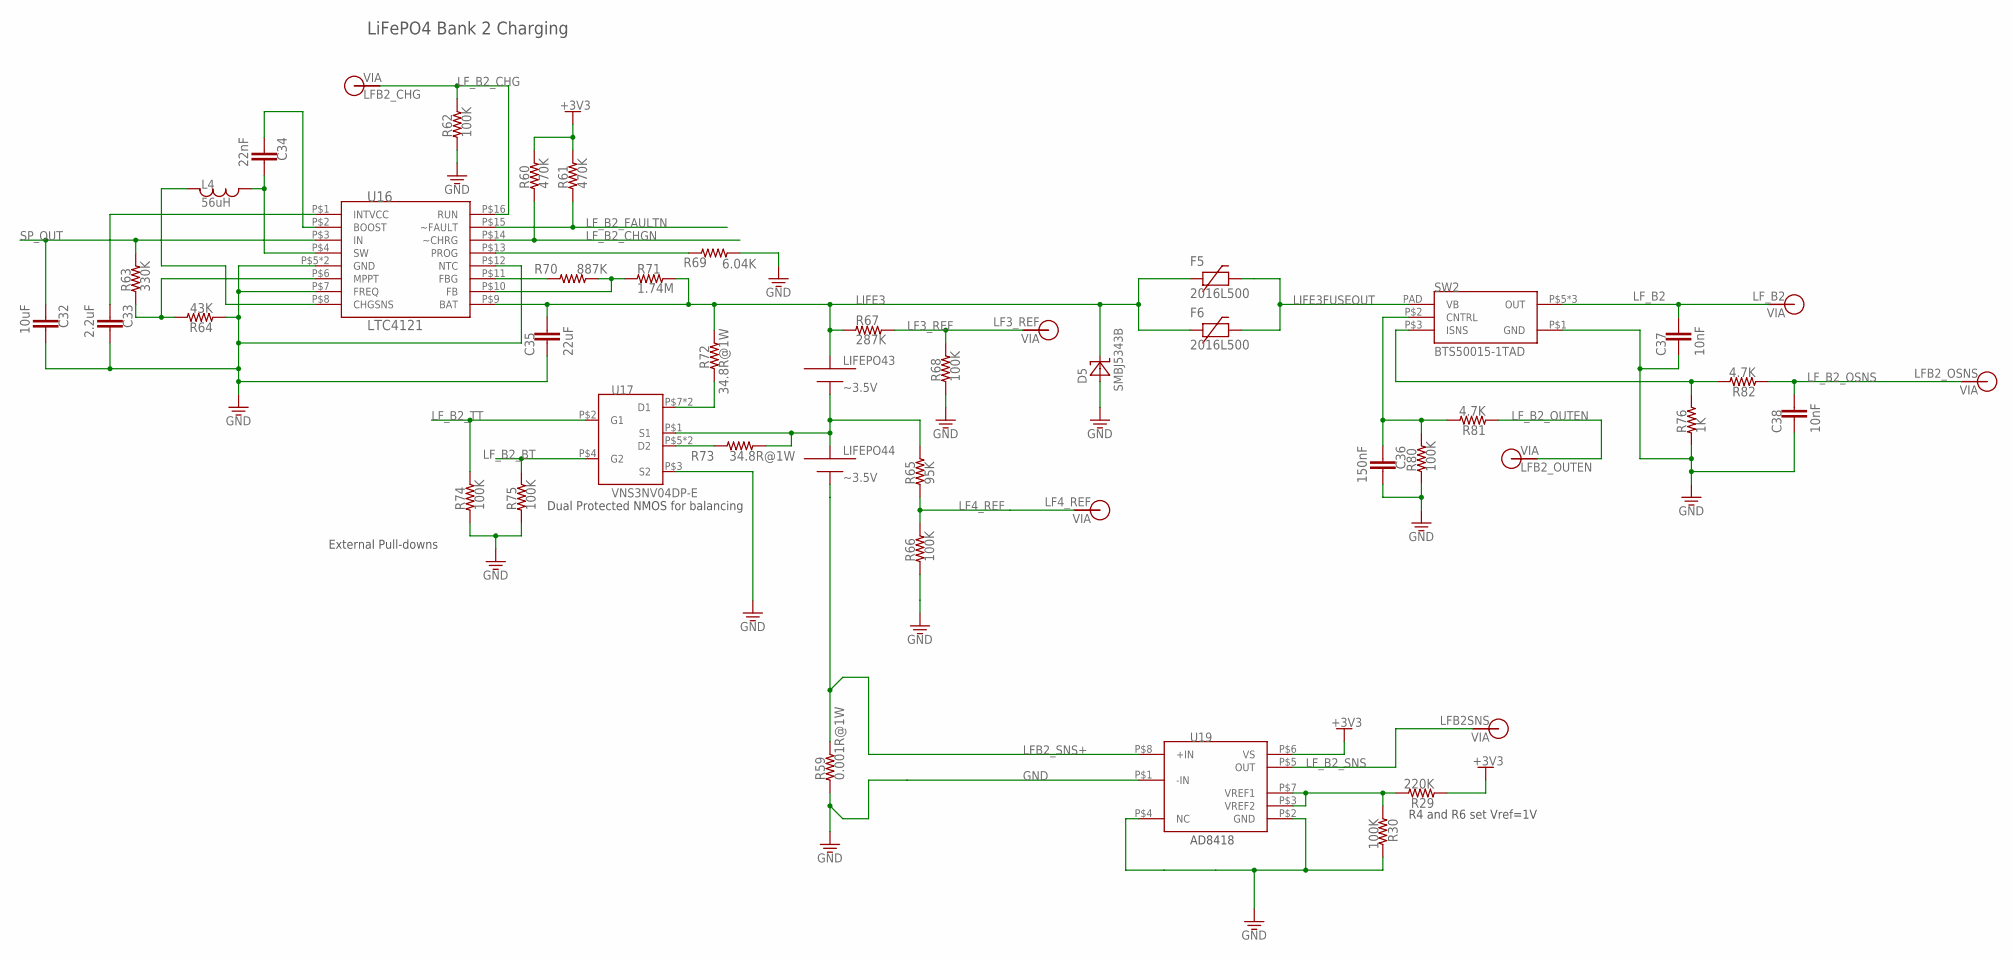
[picture p140: schematic BatteryBoardV2.sch, sheet 6, LiFePO4 Bank 2 Charging]

Parts:
C32: 10uF; 0805
C33: 2.2uF; 0805
C34: 22nF; 0805
C35: 22uF; 0805
C36: 150nF; 0805
C37, C38: 10nF; 0805
D5: SMBJ5343B; DO214AA
F5, F6: 2016L500; 2016
L4: 56uH; 1812
LIFEPO43: ~3.5V; EQUISAT-BATTERY-VA
LIFEPO44: ~3.5V; EQUISAT-BATTERY-VB
R29: 220K; 0805
R30, R62, R66, R68, R74, R75, R80: 100K; 0805
R59: 0.001R@1W; 1210
R60, R61: 470K; 0805
R63: 330K; 0805
R64: 43K; 0805
R65: 95K; 0805
R67: 287K; 0805
R69: 6.04K; 0805
R70: 887K; 0805
R71: 1.74M; 0805
R72, R73: 34.8R@1W; 1210
R76: 1K; 0805
R81, R82: 4.7K; 0805
SW2: BTS50015-1TAD; TO-263-7-8
U16: LTC4121; QFN-16-PAD
U17: VNS3NV04DP-E; SO-8
U19: AD8418; MSOP-8
V44: LFB2SNS; VIA-60MIL
V47: LFB2_CHG; VIA-60MIL
V49: LF3_REF; VIA-60MIL
V50: LF4_REF; VIA-60MIL
V51: LFB2_OUTEN; VIA-60MIL
V53: LF_B2; VIA-120MIL
V99: LFB2_OSNS; VIA-60MIL

Connections:
+3V3: R29.1, R60.2, R61.2, U19.P$6 (VS); also elsewhere on the board
GND: C32.1, C33.1, C35.2, C36.1, C37.2, C38.2, D5.A, R30.2, R59.P$1 (1), R62.1, R64.1, R66.1, R68.1, R69.2, R74.1, R75.1, R76.1, R80.1, SW2.P$1 (GND), U16.P$5 (GND), U16.P$7 (FREQ), U16.P$12 (NTC), U16.P$17 (GND), U17.P$3 (S2), U19.P$1 (-IN), U19.P$2 (GND), U19.P$4 (NC); also elsewhere on the board
LF3_REF: R67.2, R68.2, V49.P$1
LF4_REF: R65.1, R66.2, V50.P$1
LFB2_SNS+: LIFEPO44.MINUS, R59.P$2 (2), U19.P$8 (+IN)
LF_B2: C37.1, SW2.P$5 (OUT), SW2.P$6 (OUT), SW2.P$7 (OUT), V53.P$1
LF_B2_BT: R75.2, U17.P$4 (G2); also elsewhere on the board
LF_B2_CHG: R62.2, U16.P$16 (RUN), V47.P$1
LF_B2_CHGN: R60.1, U16.P$14 (~CHRG); also elsewhere on the board
LF_B2_FAULTN: R61.1, U16.P$15 (~FAULT); also elsewhere on the board
LF_B2_OSNS: C38.1, R82.1, V99.P$1
LF_B2_OUTEN: R81.1, V51.P$1
LF_B2_SNS: U19.P$5 (OUT), V44.P$1
LF_B2_TT: R74.2, U17.P$2 (G1); also elsewhere on the board
LIFE3: C35.1, D5.C, F5.P$1, F6.P$1, LIFEPO43.PLUS, R67.1, R71.2, R72.P$2 (2), U16.P$9 (BAT)
LIFE3FUSEOUT: F5.P$2, F6.P$2, SW2.PAD (VB)
LIFE4: LIFEPO43.MINUS, LIFEPO44.PLUS, R65.2, R73.P$1 (1), U17.P$1 (S1)
unnamed: R29.2, R30.1, U19.P$3 (VREF2), U19.P$7 (VREF1)
unnamed: R63.1, R64.2, U16.P$6 (MPPT)
unnamed: R69.1, U16.P$13 (PROG)
unnamed: R70.1, U16.P$11 (FBG)
unnamed: R70.2, R71.1, U16.P$10 (FB)
unnamed: C33.2, U16.P$1 (INTVCC)
unnamed: C34.1, L4.P$2, U16.P$4 (SW)
unnamed: C34.2, U16.P$2 (BOOST)
unnamed: L4.P$1, U16.P$8 (CHGSNS)
unnamed: R72.P$1 (1), U17.P$7 (D1), U17.P$8 (D1)
unnamed: R73.P$2 (2), U17.P$5 (D2), U17.P$6 (D2)
unnamed: R76.2, R82.2, SW2.P$3 (ISNS)
unnamed: C36.2, R80.2, R81.2, SW2.P$2 (CNTRL)
SP_OUT: C32.2, R63.2, U16.P$3 (IN); also elsewhere on the board

Notes on the sheet:
LiFePO4 Bank 2 Charging
External Pull-downs
Dual Protected NMOS for balancing
R4 and R6 set Vref=1V

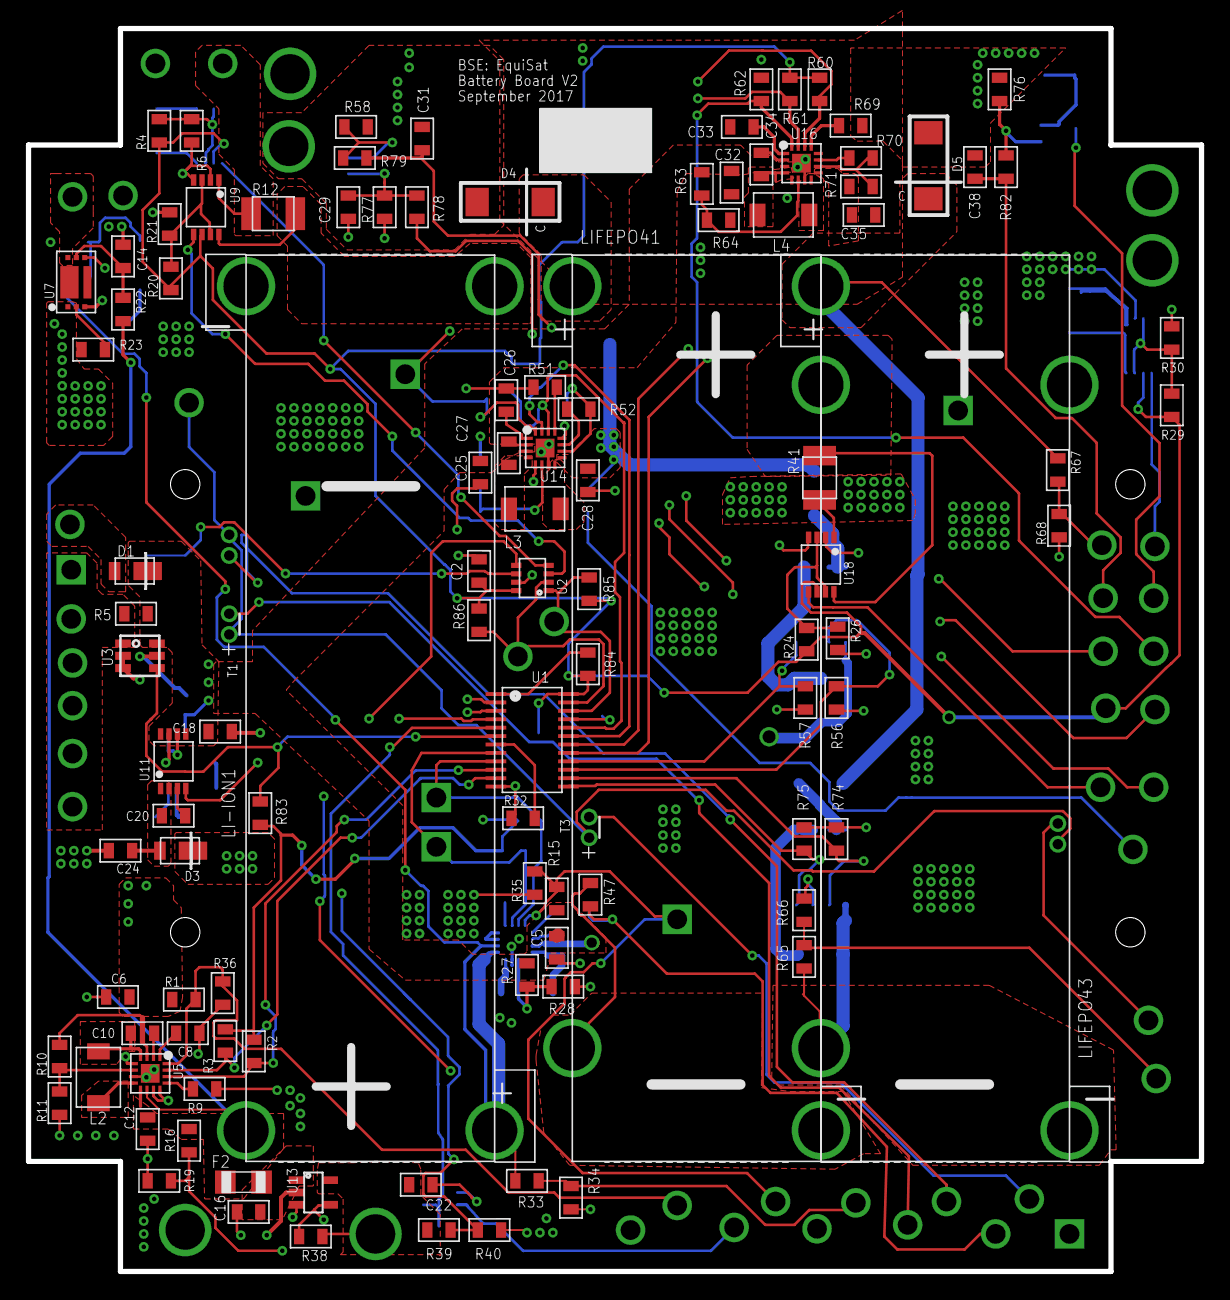
[picture p141: board BatteryBoardV2.brd from above]

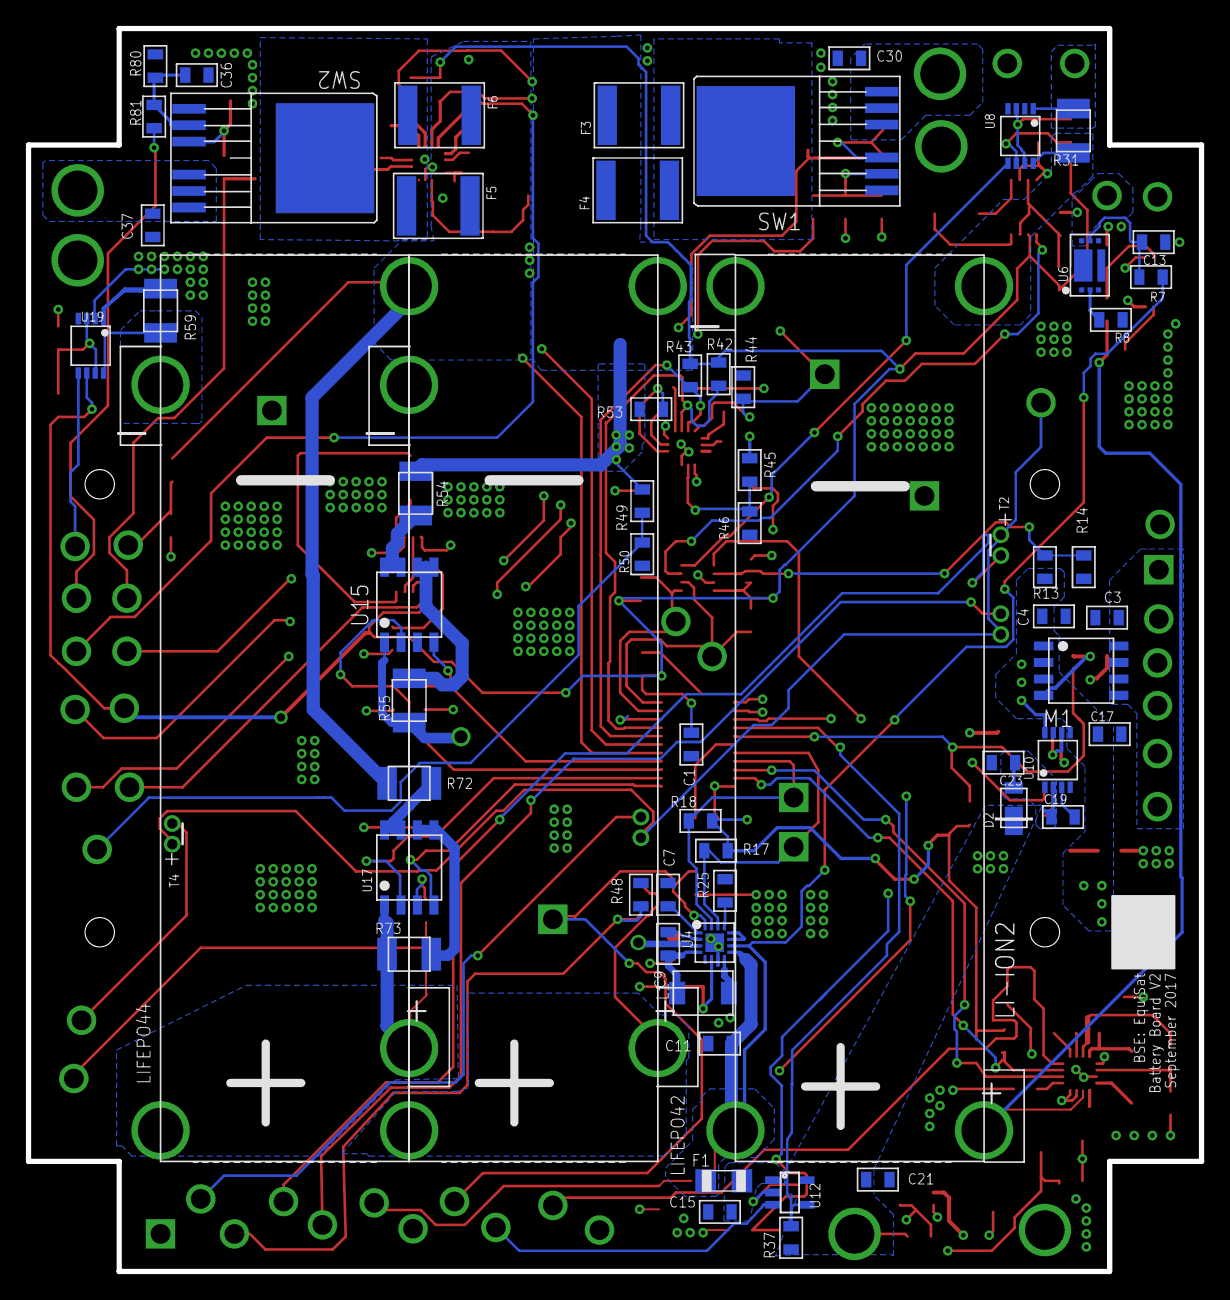
[picture p142: board BatteryBoardV2.brd from below]

Board: 4 copper layers, 90.6 x 96.0 mm, 225 parts (63 on the bottom side), 121 nets.
