BrownSpaceEngineering/EquiSat-EAGLE/projects/EQUiSat/ProgrammerBoard/ProgrammerBoardV1_1.brd

## EAGLE design projects/EQUiSat/ProgrammerBoard/ProgrammerBoardV1_1.brd (2017-09-05)

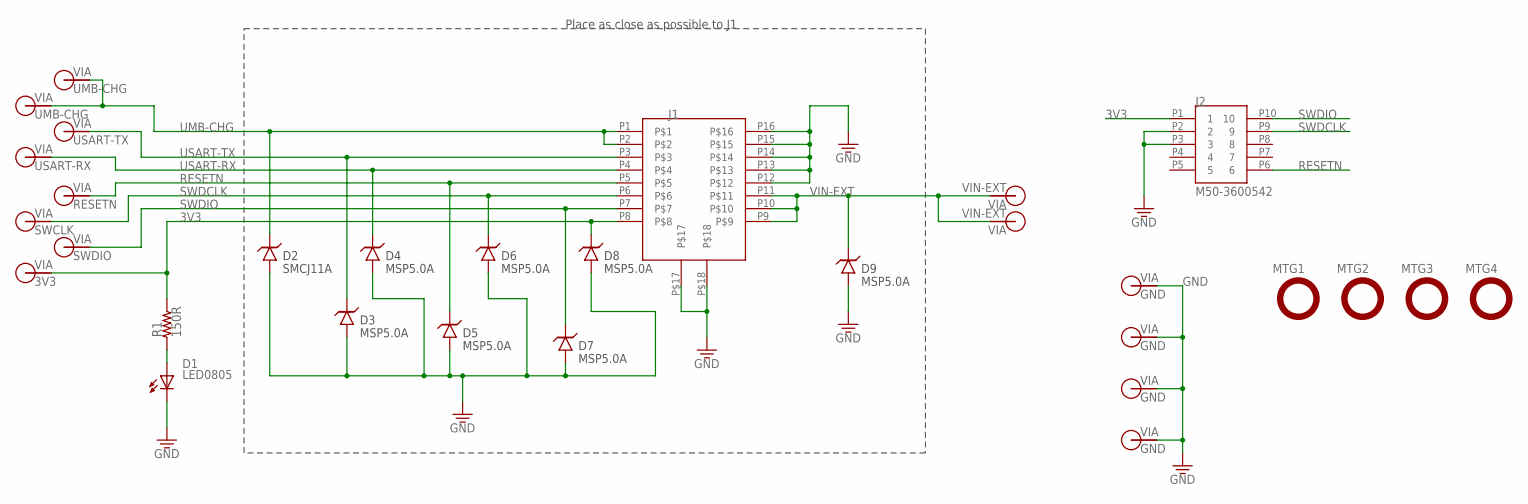
[picture p143: schematic ProgrammerBoardV1_1.sch]

Parts:
D1: LED0805; 0805-D
D2: SMCJ11A; DO-214AB
D3, D4, D5, D6, D7, D8, D9: MSP5.0A; MICROSMP
J1: FFC-16REVERSE; 68611614422-REVERSE
J2: M50-3600542; 10PINMALE
MTG1, MTG2, MTG3, MTG4: MTG-NPTH-M2; M2-NPTH
R1: 150R; 0805
V1, V2, V3, V4: GND; VIA-60MIL
V5: SWDIO; VIA-60MIL
V6, V7: UMB-CHG; VIA-60MIL
V8: RESETN; VIA-60MIL
V9: SWCLK; VIA-60MIL
V10: 3V3; VIA-60MIL
V11, V12: VIN-EXT; VIA-60MIL
V13: USART-RX; VIA-60MIL
V14: USART-TX; VIA-60MIL

Connections:
3V3: D8.C, J1.P8, J2.P1 (1), R1.2, V10.P$1
GND: D1.C, D2.A, D3.A, D4.A, D5.A, D6.A, D7.A, D8.A, D9.A, J1.P12, J1.P13, J1.P14, J1.P15, J1.P16, J1.P$17, J1.P$18, J2.P2 (2), J2.P3 (3), V1.P$1, V2.P$1, V3.P$1, V4.P$1
unnamed: D1.A, R1.1
RESETN: D5.C, J1.P5, J2.P6 (6), V8.P$1
SWDCLK: D6.C, J1.P6, J2.P9 (9), V9.P$1
SWDIO: D7.C, J1.P7, J2.P10 (10), V5.P$1
UMB-CHG: D2.C, J1.P1, J1.P2, V6.P$1, V7.P$1
USART-RX: D4.C, J1.P4, V13.P$1
USART-TX: D3.C, J1.P3, V14.P$1
VIN-EXT: D9.C, J1.P9, J1.P10, J1.P11, V11.P$1, V12.P$1

Notes on the sheet:
Place as close as possible to J1

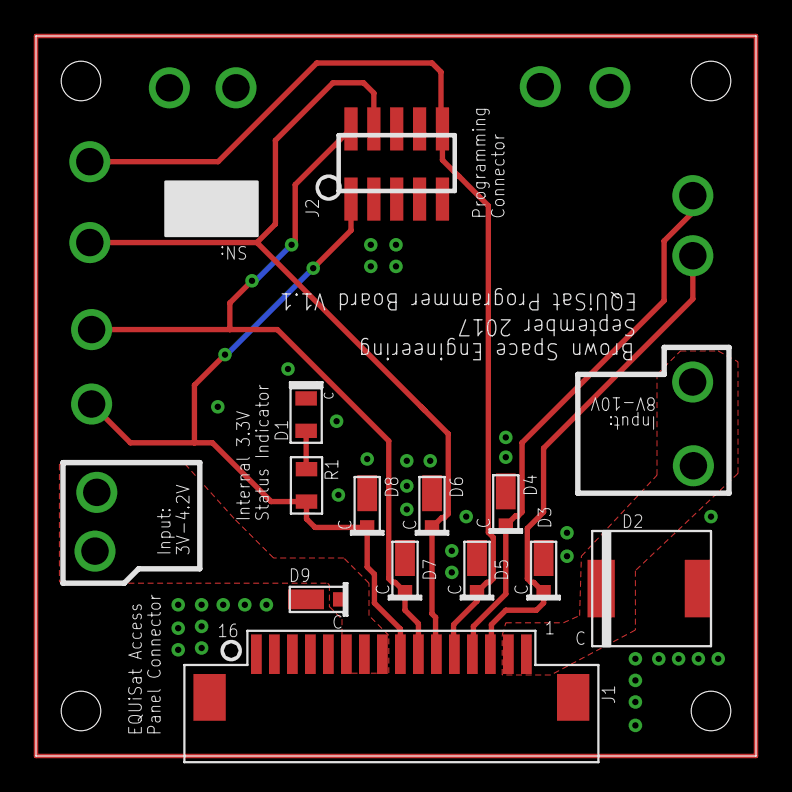
[picture p144: board ProgrammerBoardV1_1.brd from above]

Board: 2 copper layers, 40.0 x 40.0 mm, 30 parts (0 on the bottom side), 10 nets.
