BrownSpaceEngineering/EquiSat-EAGLE/projects/EQUiSat/DriverBoard/LEDDriverBoardV1_0.brd

## EAGLE design projects/EQUiSat/DriverBoard/LEDDriverBoardV1_0.brd (continued)

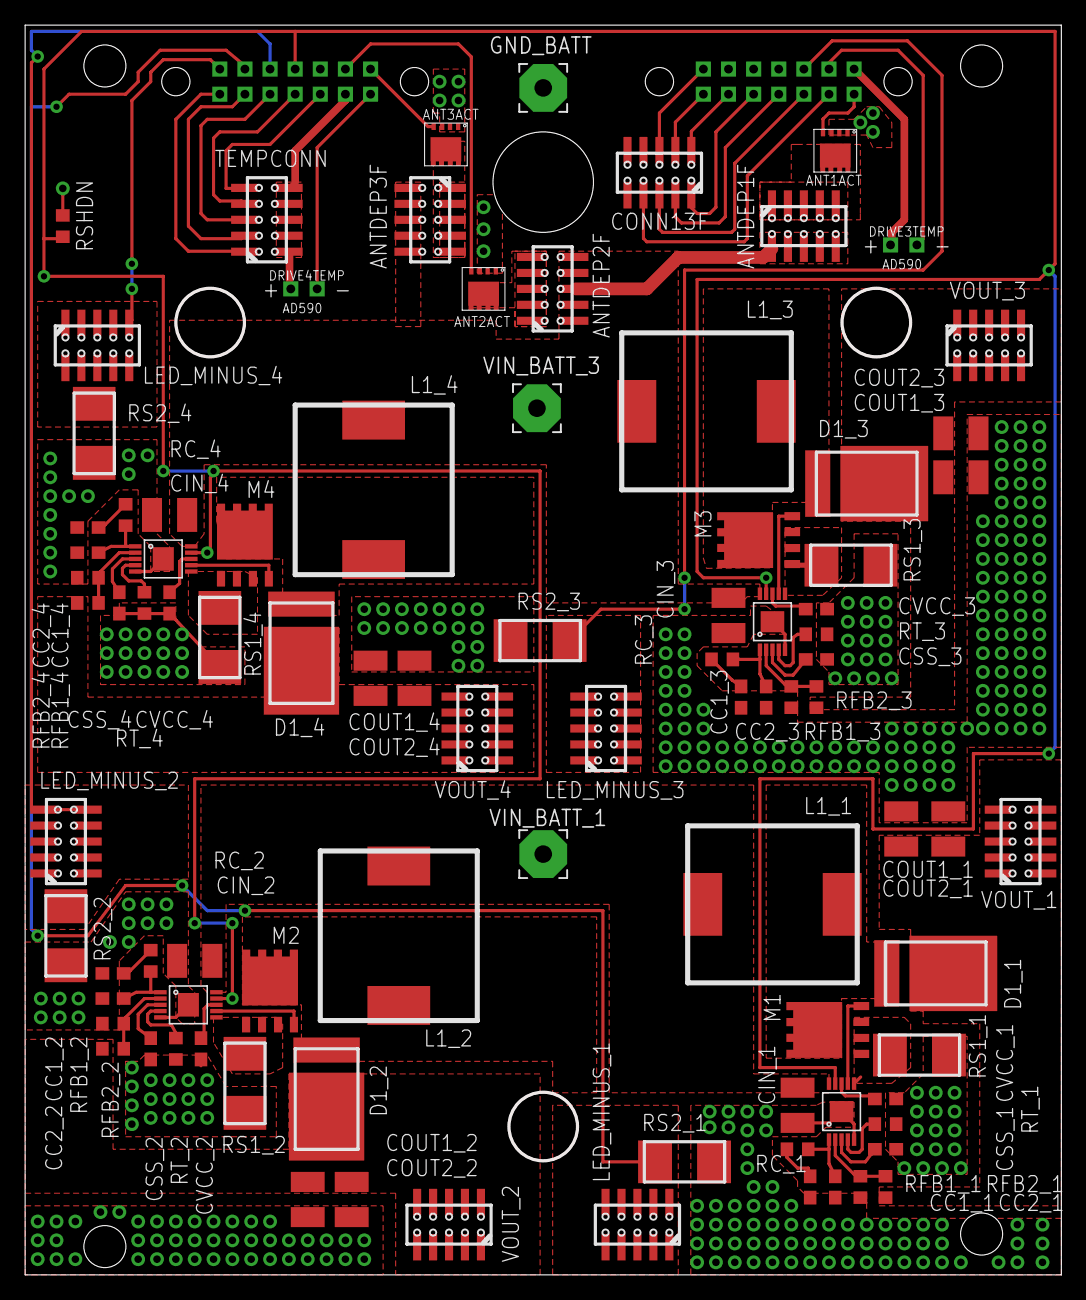
[picture p146: board LEDDriverBoardV1_0.brd from above]

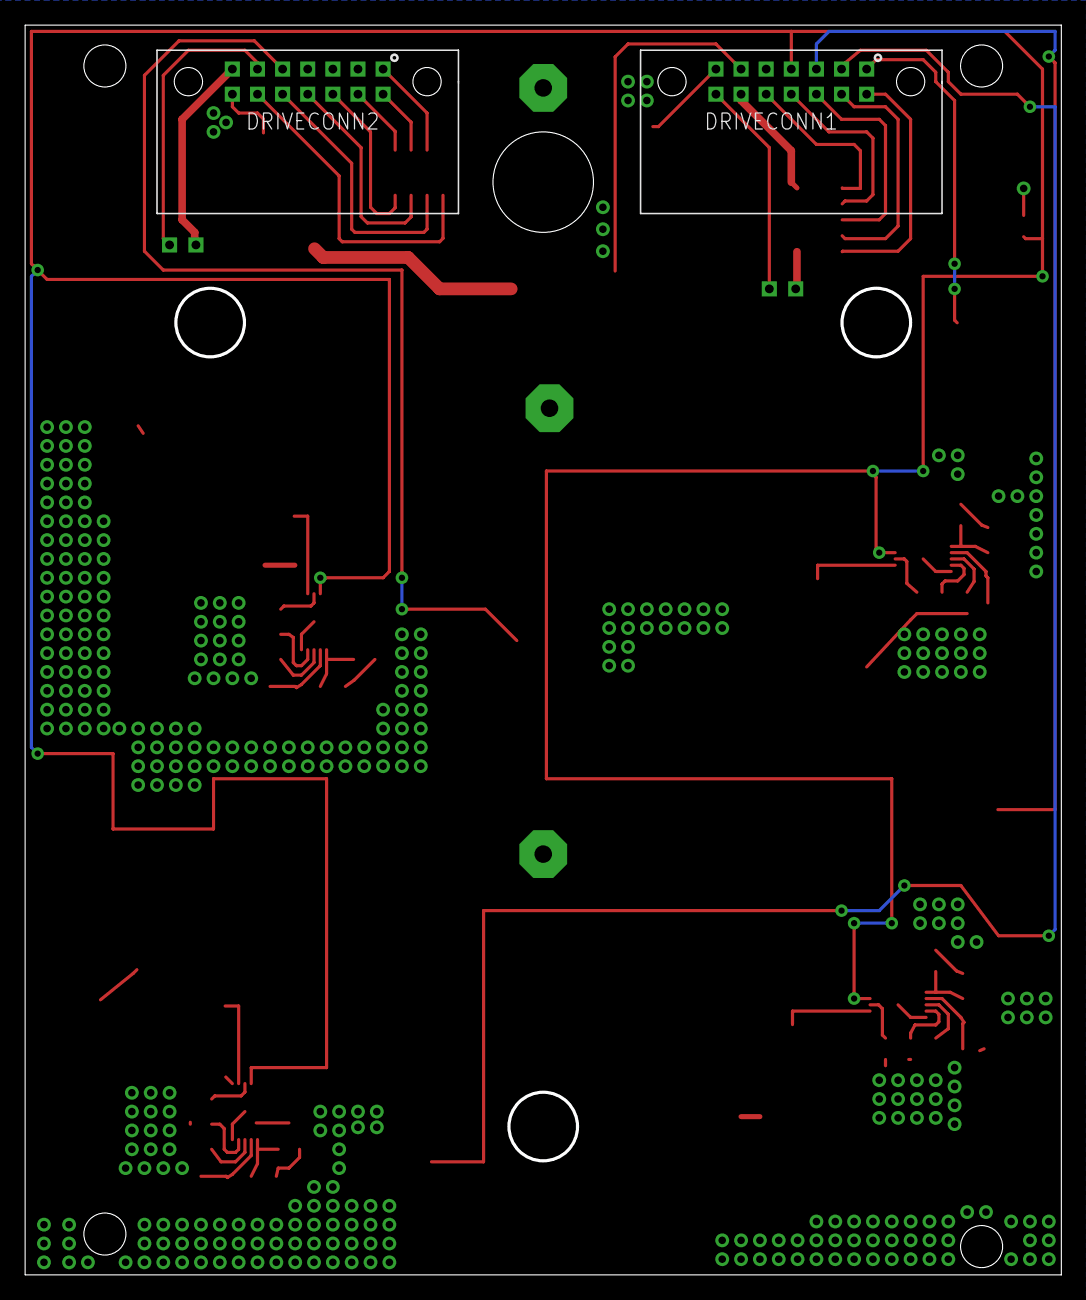
[picture p147: board LEDDriverBoardV1_0.brd from below]

Board: 2 copper layers, 82.5 x 99.5 mm, 92 parts (2 on the bottom side), 69 nets.
