BrownSpaceEngineering/EquiSat-EAGLE/projects/EQUiSat/ProgrammerBoard/ProgrammerBoardV1.brd

## EAGLE design projects/EQUiSat/ProgrammerBoard/ProgrammerBoardV1.brd (2017-08-08, an earlier design)

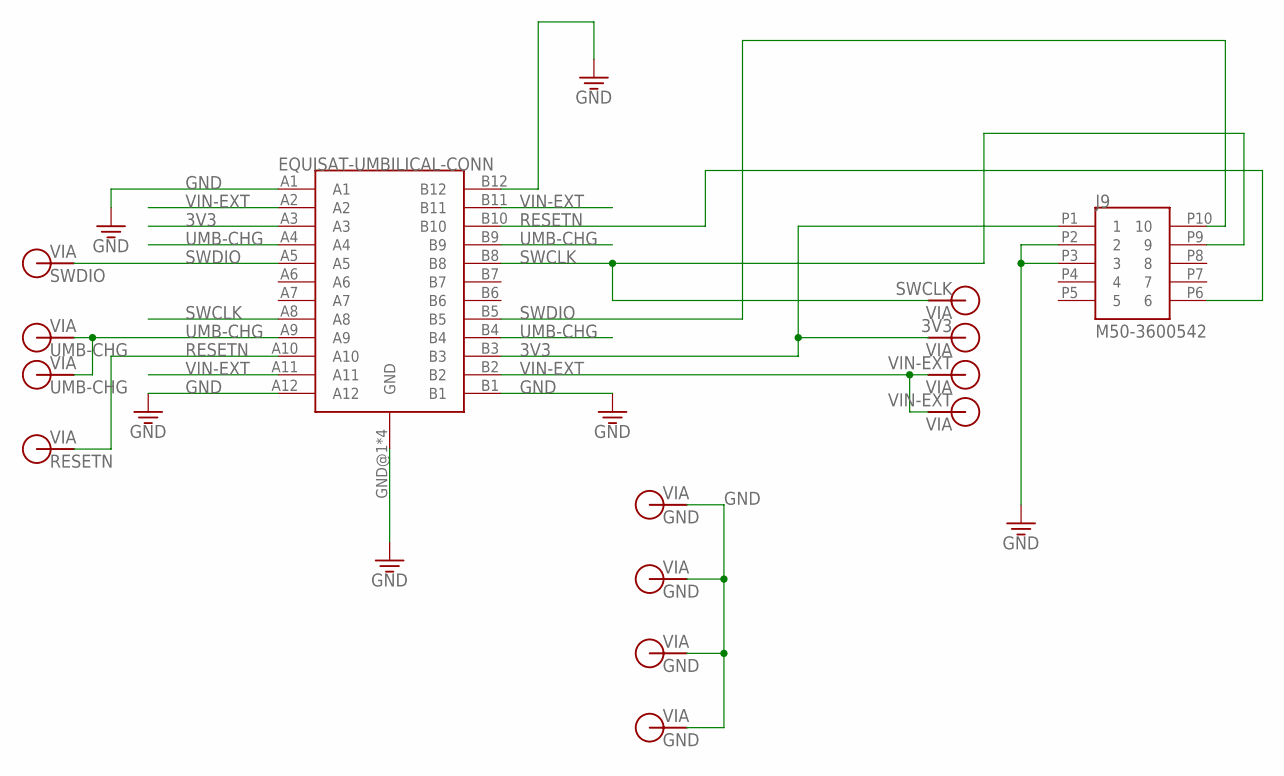
[picture p148: schematic ProgrammerBoardV1.sch]

Parts:
J9: M50-3600542; 10PINMALE
U$1: EQUISAT-UMBILICAL-CONN; USB-C-RCPT-SMT
V1, V2, V3, V4: GND; VIA-60MIL
V5: SWDIO; VIA-60MIL
V6, V7: UMB-CHG; VIA-60MIL
V8: RESETN; VIA-60MIL
V9: SWCLK; VIA-60MIL
V10: 3V3; VIA-60MIL
V11, V12: VIN-EXT; VIA-60MIL

Connections:
3V3: J9.P1 (1), U$1.A3, U$1.B3, V10.P$1
GND: J9.P2 (2), J9.P3 (3), U$1.A1, U$1.A12, U$1.B1, U$1.B12, U$1.GND@1 (GND), U$1.GND@2 (GND), U$1.GND@3 (GND), U$1.GND@4 (GND), V1.P$1, V2.P$1, V3.P$1, V4.P$1
RESETN: J9.P6 (6), U$1.A10, U$1.B10, V8.P$1
SWCLK: J9.P9 (9), U$1.A8, U$1.B8, V9.P$1
SWDIO: J9.P10 (10), U$1.A5, U$1.B5, V5.P$1
UMB-CHG: U$1.A4, U$1.A9, U$1.B4, U$1.B9, V6.P$1, V7.P$1
VIN-EXT: U$1.A2, U$1.A11, U$1.B2, U$1.B11, V11.P$1, V12.P$1

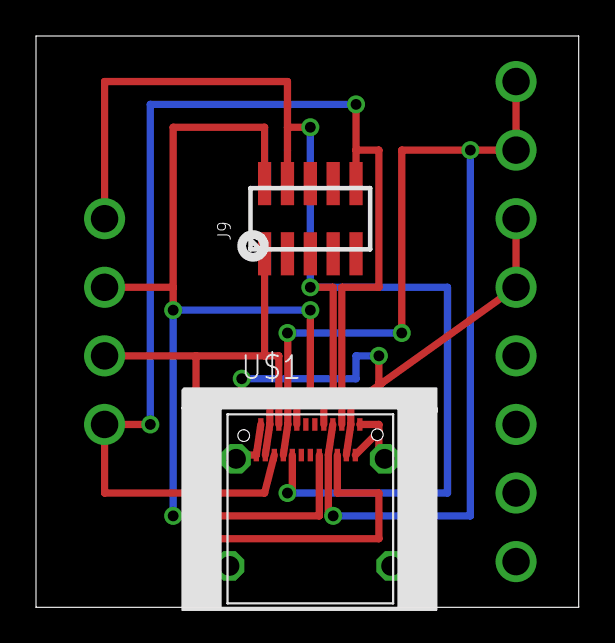
[picture p149: board ProgrammerBoardV1.brd from above]

Board: 2 copper layers, 30.1 x 31.7 mm, 14 parts (0 on the bottom side), 7 nets.
