BrownSpaceEngineering/EquiSat-EAGLE/projects/EQUiSat/FlashPanel/FlashPanelV6_0.brd

## EAGLE design projects/EQUiSat/FlashPanel/FlashPanelV6_0.brd (2016-07-10, an earlier design)

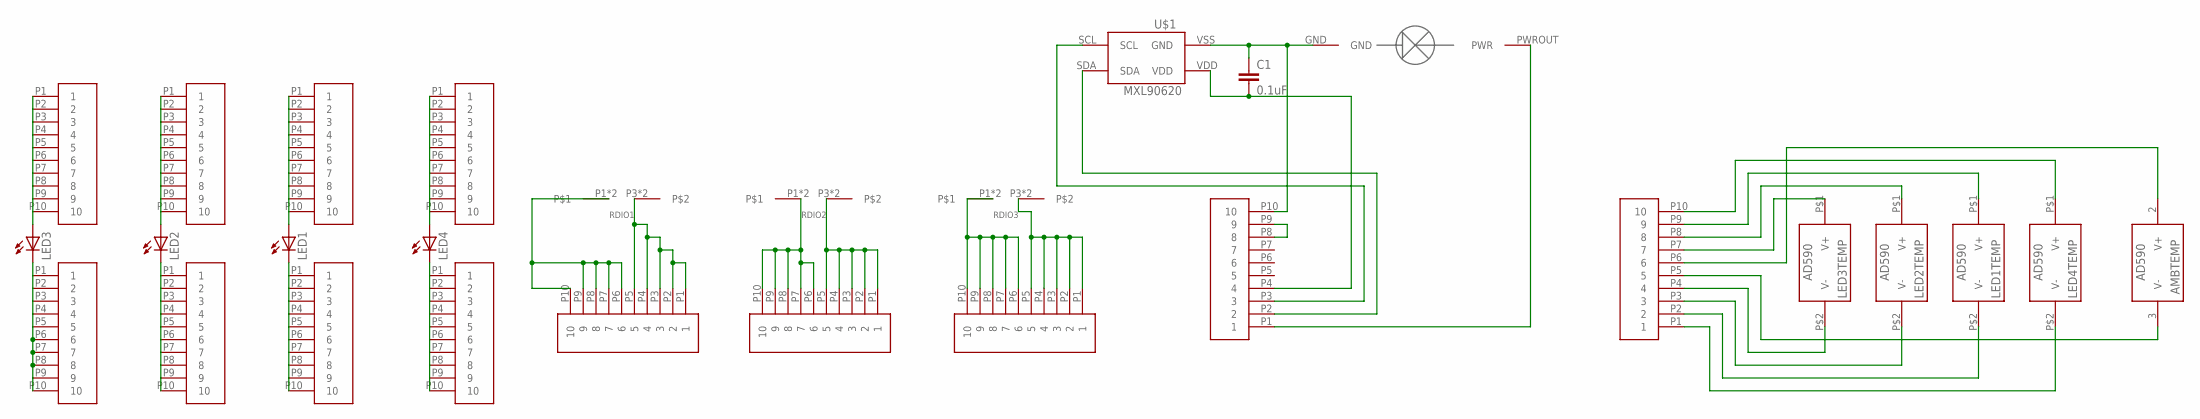
[picture p150: schematic FlashPanelV6_0.sch]

Parts:
AMBTEMP: AD590; 8SOIC
ANTDEP1M, ANTDEP2M, ANTDEP3M: 10PINMALE
C1: 0.1uF; 0805
CONN13M: 10PINMALE
LED1, LED2, LED3, LED4: CXM27
LED1+M, LED1-M, LED2+M, LED2-M, LED3+M, LED3-M, LED4+M, LED4-M: 10PINMALE
LED1TEMP, LED2TEMP, LED3TEMP, LED4TEMP: AD590-TH; AD590TH
RDIO1, RDIO2, RDIO3: RDIO; RDIO_DPLY
TEMPCONNM: 10PINMALE
U$1: MXL90620
U$2: PHOTODETECTBOTTOM

Connections:
3V3: C1.2, CONN13M.P4 (4), U$1.VDD
GND: C1.1, CONN13M.P10 (10), U$1.VSS (GND), U$2.GND
unnamed: LED3.ANODE (A), LED3+M.P1 (1), LED3+M.P2 (2), LED3+M.P3 (3), LED3+M.P4 (4), LED3+M.P5 (5), LED3+M.P6 (6), LED3+M.P7 (7), LED3+M.P8 (8), LED3+M.P9 (9), LED3+M.P10 (10)
unnamed: LED3.CATHODE (C), LED3-M.P1 (1), LED3-M.P2 (2), LED3-M.P3 (3), LED3-M.P4 (4), LED3-M.P5 (5), LED3-M.P6 (6), LED3-M.P7 (7), LED3-M.P8 (8), LED3-M.P9 (9), LED3-M.P10 (10)
unnamed: LED2.CATHODE (C), LED2+M.P1 (1), LED2+M.P2 (2), LED2+M.P3 (3), LED2+M.P4 (4), LED2+M.P5 (5), LED2+M.P6 (6), LED2+M.P7 (7), LED2+M.P8 (8), LED2+M.P9 (9), LED2+M.P10 (10)
unnamed: LED2.ANODE (A), LED2-M.P1 (1), LED2-M.P2 (2), LED2-M.P3 (3), LED2-M.P4 (4), LED2-M.P5 (5), LED2-M.P6 (6), LED2-M.P7 (7), LED2-M.P8 (8), LED2-M.P9 (9), LED2-M.P10 (10)
unnamed: LED1.CATHODE (C), LED1+M.P1 (1), LED1+M.P2 (2), LED1+M.P3 (3), LED1+M.P4 (4), LED1+M.P5 (5), LED1+M.P6 (6), LED1+M.P7 (7), LED1+M.P8 (8), LED1+M.P9 (9), LED1+M.P10 (10)
unnamed: LED1.ANODE (A), LED1-M.P1 (1), LED1-M.P2 (2), LED1-M.P3 (3), LED1-M.P4 (4), LED1-M.P5 (5), LED1-M.P6 (6), LED1-M.P7 (7), LED1-M.P8 (8), LED1-M.P9 (9), LED1-M.P10 (10)
unnamed: LED4.CATHODE (C), LED4-M.P1 (1), LED4-M.P2 (2), LED4-M.P3 (3), LED4-M.P4 (4), LED4-M.P5 (5), LED4-M.P6 (6), LED4-M.P7 (7), LED4-M.P8 (8), LED4-M.P9 (9), LED4-M.P10 (10)
unnamed: LED4.ANODE (A), LED4+M.P1 (1), LED4+M.P2 (2), LED4+M.P3 (3), LED4+M.P4 (4), LED4+M.P5 (5), LED4+M.P6 (6), LED4+M.P7 (7), LED4+M.P8 (8), LED4+M.P9 (9), LED4+M.P10 (10)
unnamed: ANTDEP1M.P1 (1), ANTDEP1M.P2 (2), ANTDEP1M.P3 (3), ANTDEP1M.P4 (4), ANTDEP1M.P5 (5), RDIO1.P3, RDIO1.P4
unnamed: ANTDEP2M.P6 (6), ANTDEP2M.P7 (7), ANTDEP2M.P8 (8), ANTDEP2M.P9 (9), ANTDEP2M.P10 (10), RDIO2.P1, RDIO2.P2
unnamed: ANTDEP2M.P1 (1), ANTDEP2M.P2 (2), ANTDEP2M.P3 (3), ANTDEP2M.P4 (4), ANTDEP2M.P5 (5), RDIO2.P3, RDIO2.P4
unnamed: ANTDEP3M.P6 (6), ANTDEP3M.P7 (7), ANTDEP3M.P8 (8), ANTDEP3M.P9 (9), ANTDEP3M.P10 (10), RDIO3.P1, RDIO3.P2
unnamed: ANTDEP3M.P1 (1), ANTDEP3M.P2 (2), ANTDEP3M.P3 (3), ANTDEP3M.P4 (4), ANTDEP3M.P5 (5), RDIO3.P3, RDIO3.P4
unnamed: LED4TEMP.P$2 (V-), TEMPCONNM.P1 (1)
unnamed: LED1TEMP.P$2 (V-), TEMPCONNM.P2 (2)
unnamed: LED2TEMP.P$2 (V-), TEMPCONNM.P3 (3)
unnamed: LED3TEMP.P$2 (V-), TEMPCONNM.P4 (4)
unnamed: LED4TEMP.P$1 (V+), TEMPCONNM.P10 (10)
unnamed: LED1TEMP.P$1 (V+), TEMPCONNM.P9 (9)
unnamed: LED2TEMP.P$1 (V+), TEMPCONNM.P8 (8)
unnamed: LED3TEMP.P$1 (V+), TEMPCONNM.P7 (7)
unnamed: AMBTEMP.3 (V-), TEMPCONNM.P5 (5)
unnamed: AMBTEMP.2 (V+), TEMPCONNM.P6 (6)
PDOUT: CONN13M.P1 (1), U$2.PWROUT (PWR)
RDIO1: ANTDEP1M.P6 (6), ANTDEP1M.P7 (7), ANTDEP1M.P8 (8), ANTDEP1M.P9 (9), ANTDEP1M.P10 (10), RDIO1.P1, RDIO1.P2
SCL: CONN13M.P3 (3), U$1.SCL
SDA: CONN13M.P2 (2), U$1.SDA
TEST: CONN13M.P8 (8), CONN13M.P9 (9)

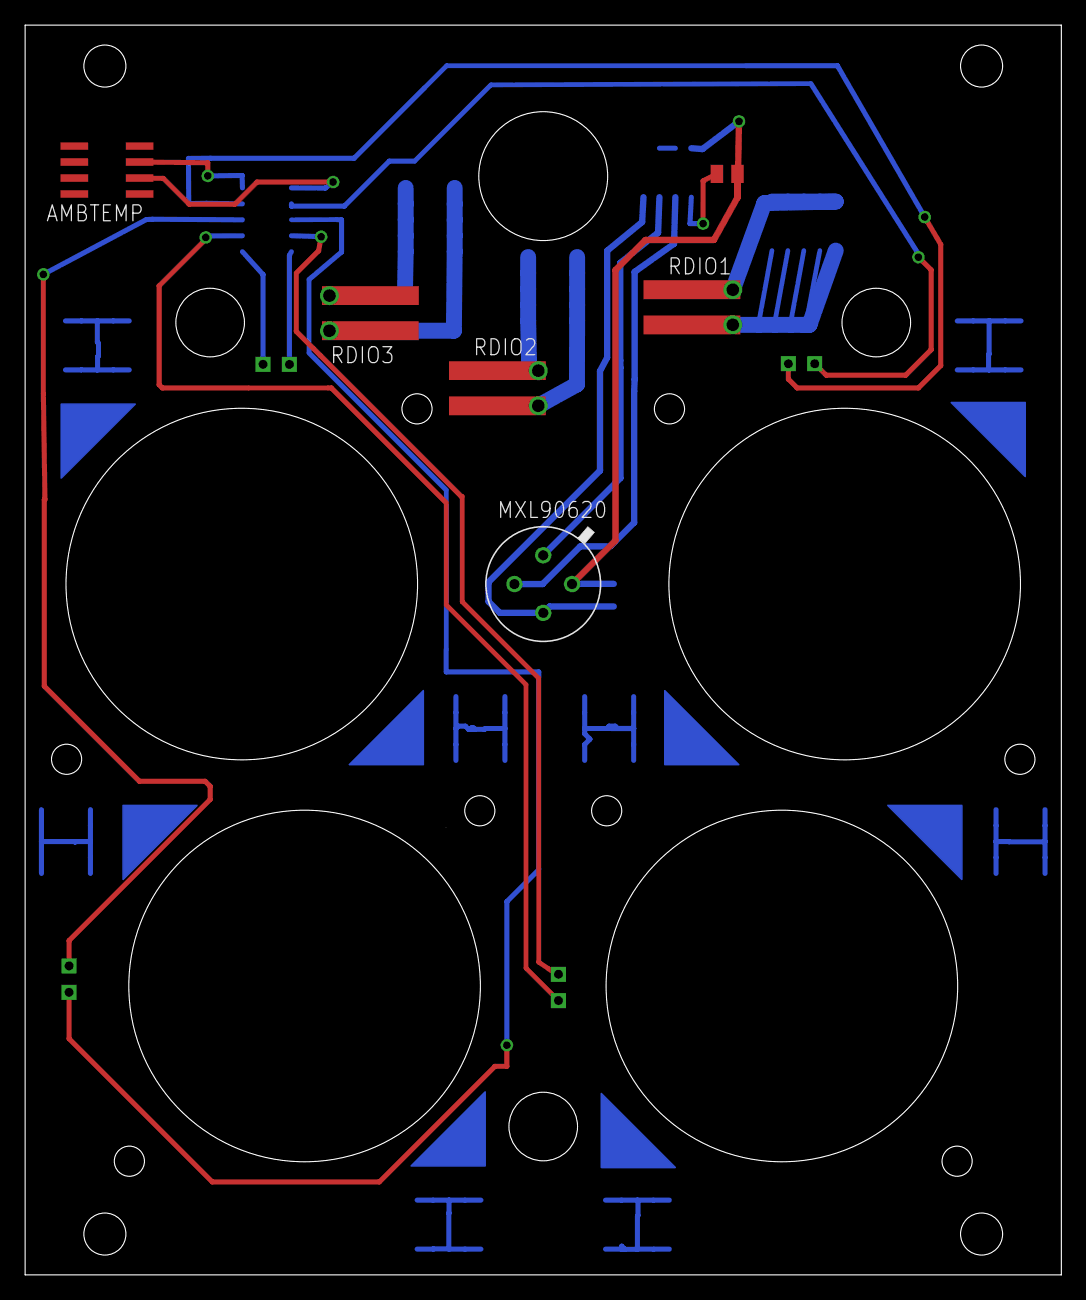
[picture p151: board FlashPanelV6_0.brd from above]

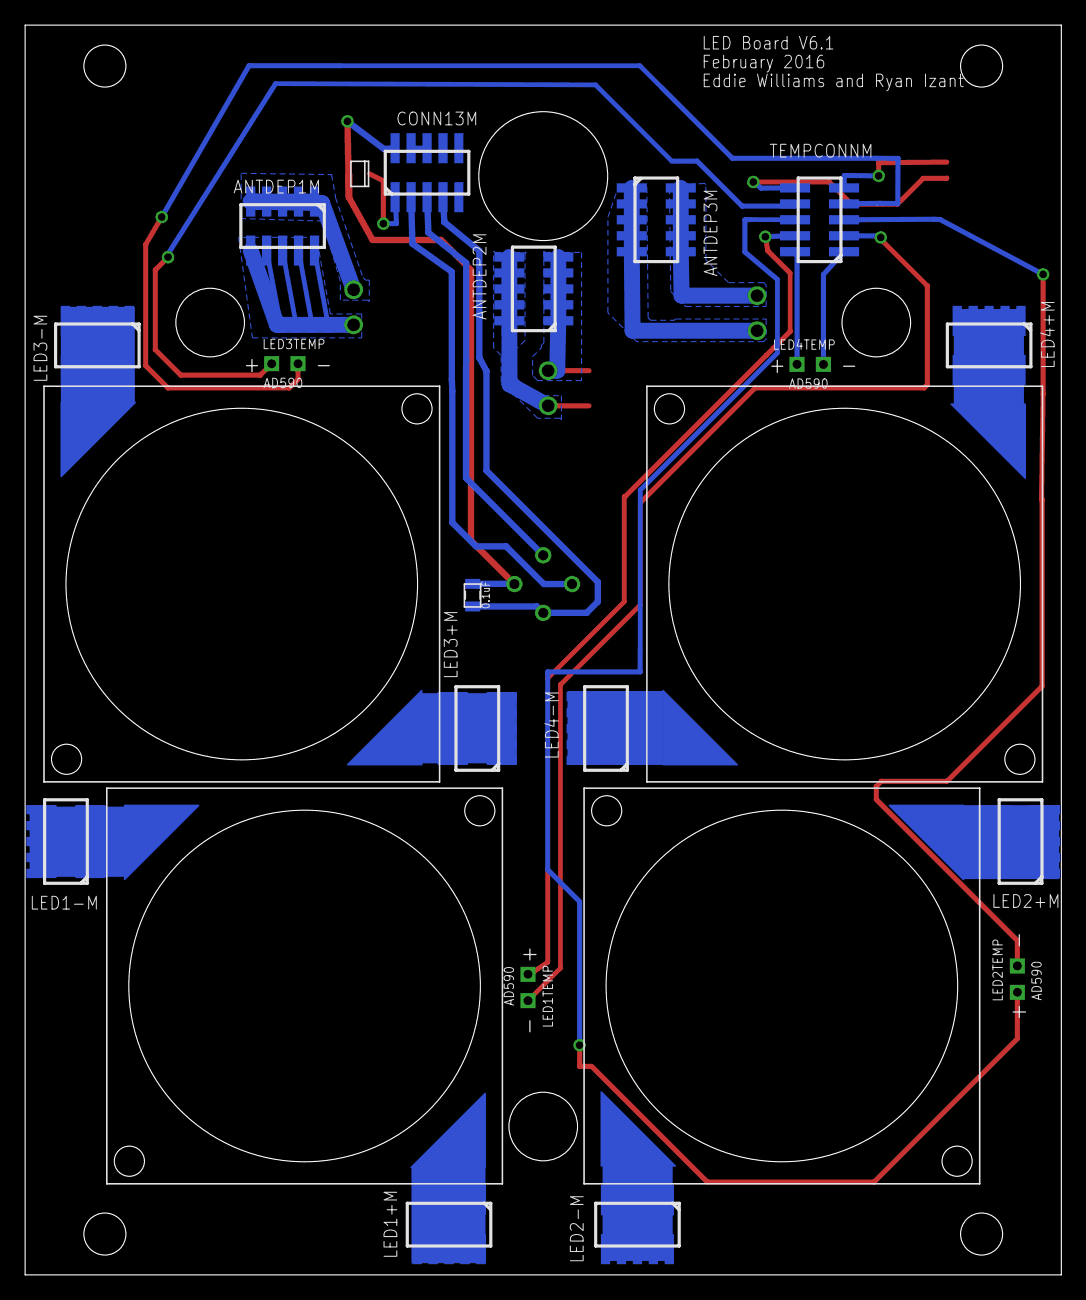
[picture p152: board FlashPanelV6_0.brd from below]

Board: 2 copper layers, 82.5 x 99.5 mm, 28 parts (26 on the bottom side), 30 nets.
