BrownSpaceEngineering/EquiSat-EAGLE/projects/FutureSat/MotherBoardV1/MotherBoard.brd

## EAGLE design projects/FutureSat/MotherBoardV1/MotherBoard.brd (2019-03-11)

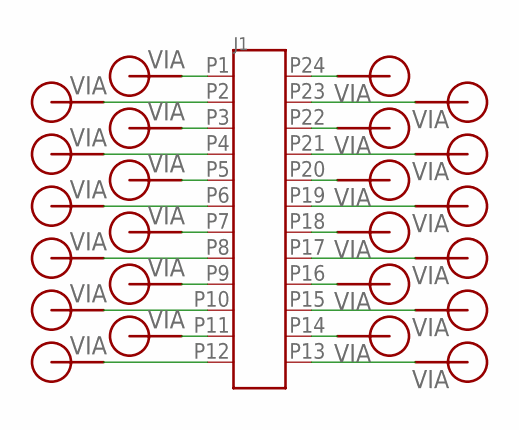
[picture p153: schematic MotherBoard.sch]

Parts:
J1: EBM12DRXH
V1, V2, V3, V4, V5, V6, V7, V8, V9, V10, V11, V12, V13, V14, V15, V16, V17, V18, V19, V20, V21, V22, V23, V24: VIA60MIL-SQ; VIA-60MIL-SQ

Connections:
unnamed: J1.P1, V1.P$1
unnamed: J1.P2, V2.P$1
unnamed: J1.P3, V3.P$1
unnamed: J1.P4, V4.P$1
unnamed: J1.P5, V5.P$1
unnamed: J1.P6, V6.P$1
unnamed: J1.P7, V7.P$1
unnamed: J1.P8, V8.P$1
unnamed: J1.P9, V9.P$1
unnamed: J1.P10, V10.P$1
unnamed: J1.P11, V11.P$1
unnamed: J1.P12, V12.P$1
unnamed: J1.P13, V13.P$1
unnamed: J1.P14, V14.P$1
unnamed: J1.P15, V15.P$1
unnamed: J1.P16, V16.P$1
unnamed: J1.P17, V17.P$1
unnamed: J1.P18, V18.P$1
unnamed: J1.P19, V19.P$1
unnamed: J1.P20, V20.P$1
unnamed: J1.P21, V21.P$1
unnamed: J1.P22, V22.P$1
unnamed: J1.P23, V23.P$1
unnamed: J1.P24, V24.P$1

Board: 2 copper layers, 25 parts (0 on the bottom side), 24 nets, no tracks yet.
