BrownSpaceEngineering/EquiSat-EAGLE/projects/EQUiSat/ControlBoard/ProcessorTestBoardV1_0.brd

## EAGLE design projects/EQUiSat/ControlBoard/ProcessorTestBoardV1_0.brd (2016-07-10, an earlier design)

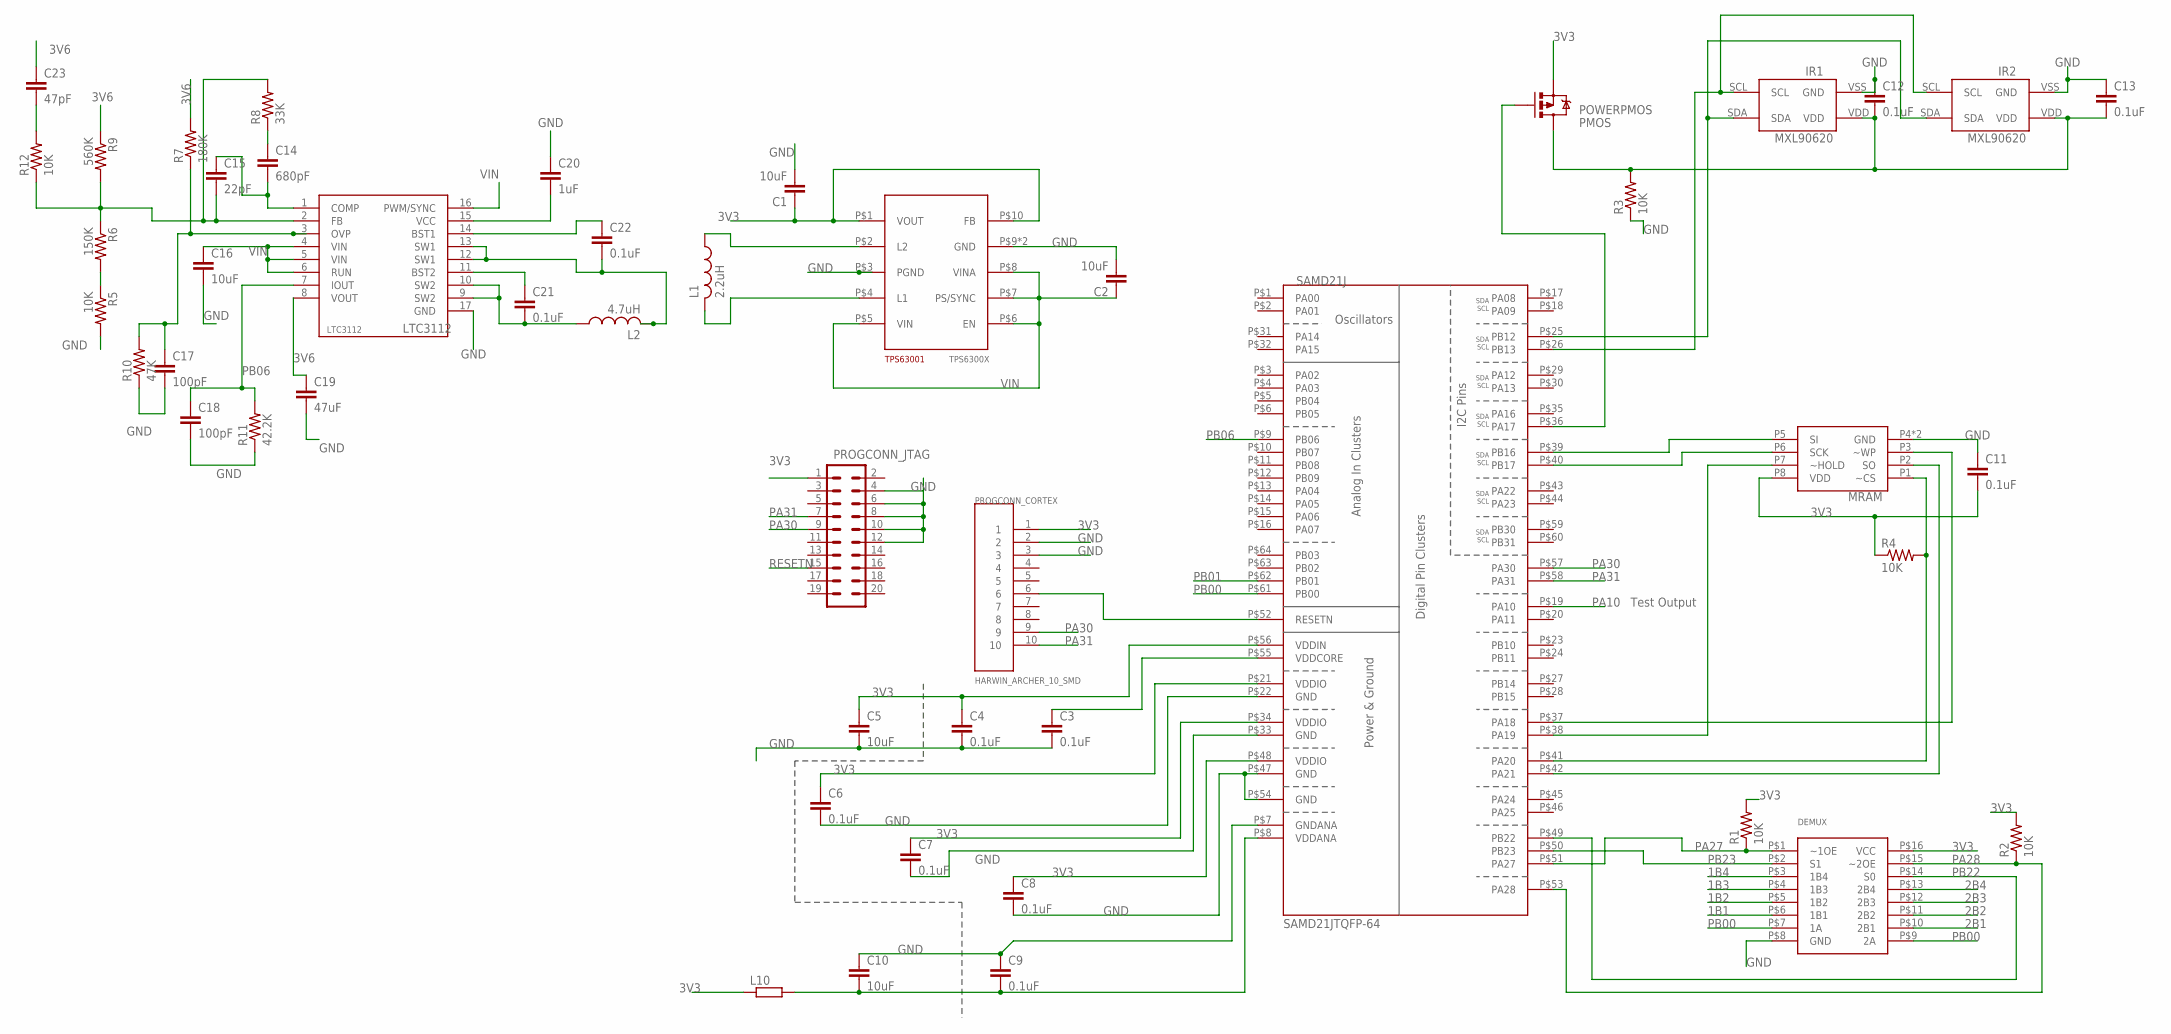
[picture p154: schematic ProcessorTestBoardV1_0.sch]

Parts:
C1, C2, C5, C10, C16: 10uF; 0805
C3, C4, C6, C7, C8, C9, C11, C12, C13, C21, C22: 0.1uF; 0805
C14: 680pF; 0805
C15: 22pF; 0805
C17, C18: 100pF; 0805
C19: 47uF; 0805
C20: 1uF; 0805
C23: 47pF; 0805
DEMUX: SN74CBTLV3253; SOIC16R
IR1, IR2: MXL90620
L1: 2.2uH; L3225M
L2: 4.7uH; L3225M
L10: R-EU_R0805; R0805
LTC3112: LTC3112; DHD16
MRAM: MR25H10CDC; 8PXMO-229
PMOS: POWERPMOS; SO08
PROGCONN_CORTEX: HARWIN_ARCHER_10_SMD
PROGCONN_JTAG: IDC_JTAG_CONNECTOR; 2X10
R1, R2, R3, R4, R5, R12: 10K; 0805
R6: 150K; 0805
R7: 180K; 0805
R8: 33K; 0805
R9: 560K; 0805
R10: 47K; 0805
R11: 42.2K; 0805
SAMD21J: SAMD21JTQFP-64; TQFP-64
TPS63001: TPS6300X; QFN10_POWERPAD

Connections:
1B1: DEMUX.P$6 (1B1)
1B2: DEMUX.P$5 (1B2)
1B3: DEMUX.P$4 (1B3)
1B4: DEMUX.P$3 (1B4)
2B1: DEMUX.P$10 (2B1)
2B2: DEMUX.P$11 (2B2)
2B3: DEMUX.P$12 (2B3)
2B4: DEMUX.P$13 (2B4)
3V3: C1.1, C4.1, C5.1, C6.1, C7.1, C8.1, C11.2, DEMUX.P$16 (VCC), L10.1, MRAM.P8 (VDD), PMOS.1 (S), PMOS.2 (S), PMOS.3 (S), PROGCONN_CORTEX.1, PROGCONN_JTAG.1, R1.2, R2.2, R4.1, SAMD21J.P$21 (VDDIO), SAMD21J.P$34 (VDDIO), SAMD21J.P$48 (VDDIO), SAMD21J.P$56 (VDDIN), TPS63001.P$1 (VOUT), TPS63001.P$10 (FB)
3V6: C19.1, C23.1, LTC3112.8 (VOUT), R7.2, R9.1
COMP: C14.2, C15.1, LTC3112.1 (COMP)
FB: C15.2, LTC3112.2 (FB), R6.1, R8.2, R9.2, R12.1
GND: C1.2, C2.2, C3.2, C4.2, C5.2, C6.2, C7.2, C8.2, C9.1, C10.1, C11.1, C12.1, C13.1, C16.2, C17.2, C18.2, C19.2, C20.1, DEMUX.P$8 (GND), IR1.VSS (GND), IR2.VSS (GND), LTC3112.17 (GND), MRAM.P4 (GND), MRAM.P9 (GND), PROGCONN_CORTEX.2, PROGCONN_CORTEX.3, PROGCONN_JTAG.4, PROGCONN_JTAG.6, PROGCONN_JTAG.8, PROGCONN_JTAG.10, PROGCONN_JTAG.12, R3.1, R5.2, R10.1, R11.1, SAMD21J.P$7 (GNDANA), SAMD21J.P$22 (GND), SAMD21J.P$33 (GND), SAMD21J.P$47 (GND), SAMD21J.P$54 (GND), TPS63001.P$3 (PGND), TPS63001.P$9 (GND), TPS63001.PAD (GND)
unnamed: C12.2, C13.2, IR1.VDD, IR2.VDD, PMOS.5 (D), PMOS.6 (D), PMOS.7 (D), PMOS.8 (D), R3.2
unnamed: L1.2, TPS63001.P$4 (L1)
unnamed: L1.1, TPS63001.P$2 (L2)
unnamed: C14.1, R8.1
unnamed: C23.2, R12.2
unnamed: R5.1, R6.2
unnamed: C3.1, SAMD21J.P$55 (VDDCORE)
unnamed: C9.2, C10.2, L10.2, SAMD21J.P$8 (VDDANA)
unnamed: C20.2, LTC3112.15 (VCC)
unnamed: C22.1, LTC3112.14 (BST1)
unnamed: C22.2, L2.2, LTC3112.12 (SW1), LTC3112.13 (SW1)
unnamed: C21.2, L2.1, LTC3112.9 (SW2), LTC3112.10 (SW2)
unnamed: C21.1, LTC3112.11 (BST2)
OVP: C17.1, LTC3112.3 (OVP), R7.1, R10.2
PA10: SAMD21J.P$19 (PA10)
PA17: PMOS.4 (G), SAMD21J.P$36 (PA17)
PA27: DEMUX.P$1 (~1OE), R1.1, SAMD21J.P$51 (PA27)
PA28: DEMUX.P$15 (~2OE), R2.1, SAMD21J.P$53 (PA28)
PA30: PROGCONN_CORTEX.9, PROGCONN_JTAG.9, SAMD21J.P$57 (PA30)
PA31: PROGCONN_CORTEX.10, PROGCONN_JTAG.7, SAMD21J.P$58 (PA31)
PB00: DEMUX.P$7 (1A), DEMUX.P$9 (2A), SAMD21J.P$61 (PB00)
PB01: SAMD21J.P$62 (PB01)
PB06: C18.1, LTC3112.7 (IOUT), R11.2, SAMD21J.P$9 (PB06)
PB22: DEMUX.P$14 (S0), SAMD21J.P$49 (PB22)
PB23: DEMUX.P$2 (S1), SAMD21J.P$50 (PB23)
RESETN: PROGCONN_CORTEX.6, PROGCONN_JTAG.15, SAMD21J.P$52 (RESETN)
SCK: MRAM.P6 (SCK), SAMD21J.P$40 (PB17)
SCL: IR1.SCL, IR2.SCL, SAMD21J.P$26 (PB13)
SDA: IR1.SDA, IR2.SDA, SAMD21J.P$25 (PB12)
SI: MRAM.P5 (SI), SAMD21J.P$39 (PB16)
SO: MRAM.P2 (SO), SAMD21J.P$42 (PA21)
VIN: C2.1, C16.1, LTC3112.4 (VIN), LTC3112.5 (VIN), LTC3112.6 (RUN), LTC3112.16 (PWM/SYNC), TPS63001.P$5 (VIN), TPS63001.P$6 (EN), TPS63001.P$7 (PS/SYNC), TPS63001.P$8 (VINA)
~CS: MRAM.P1 (~CS), R4.2, SAMD21J.P$41 (PA20)
~HOLD: MRAM.P7 (~HOLD), SAMD21J.P$38 (PA19)
~WP: MRAM.P3 (~WP), SAMD21J.P$37 (PA18)

Notes on the sheet:
Test Output

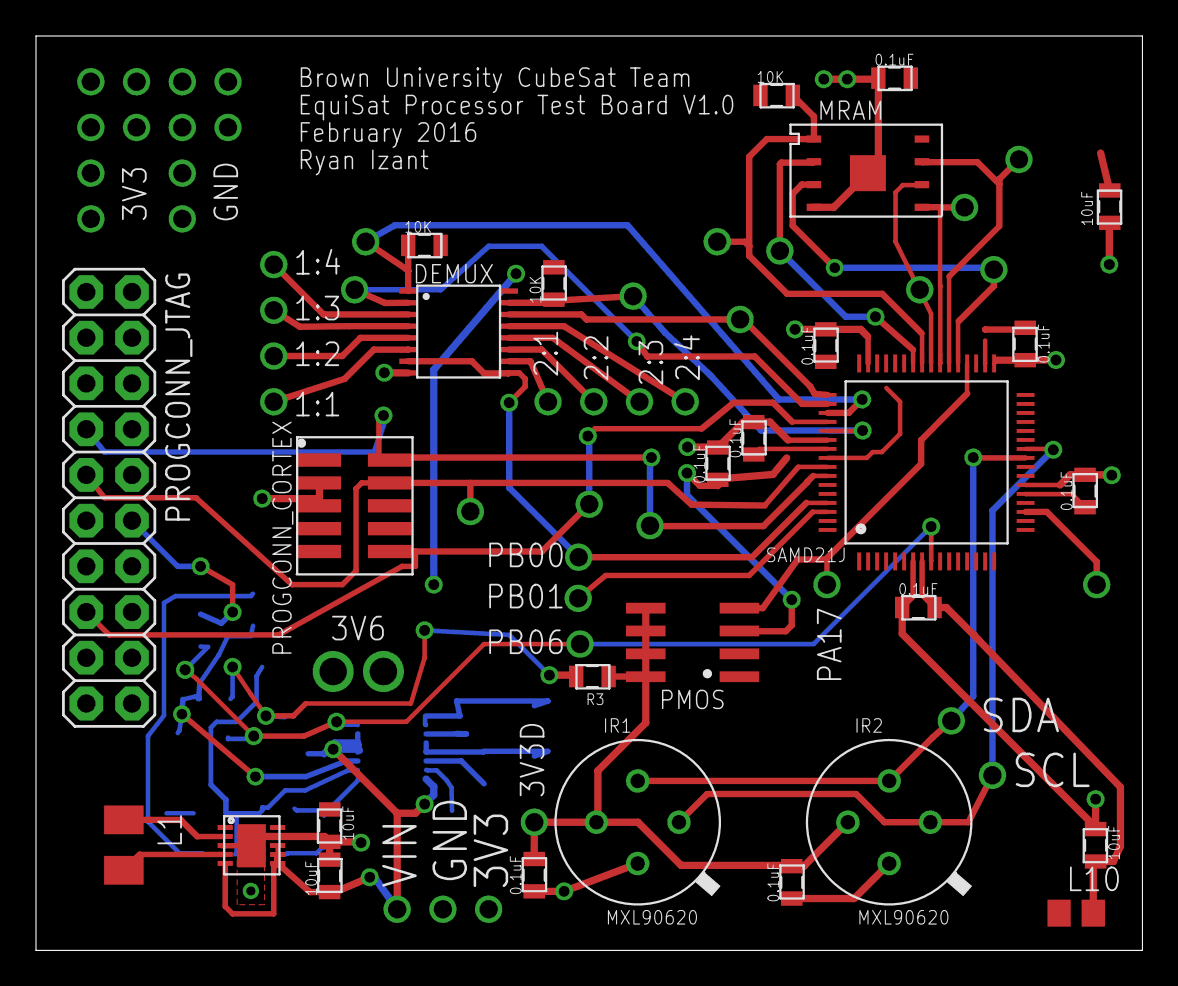
[picture p155: board ProcessorTestBoardV1_0.brd from above]

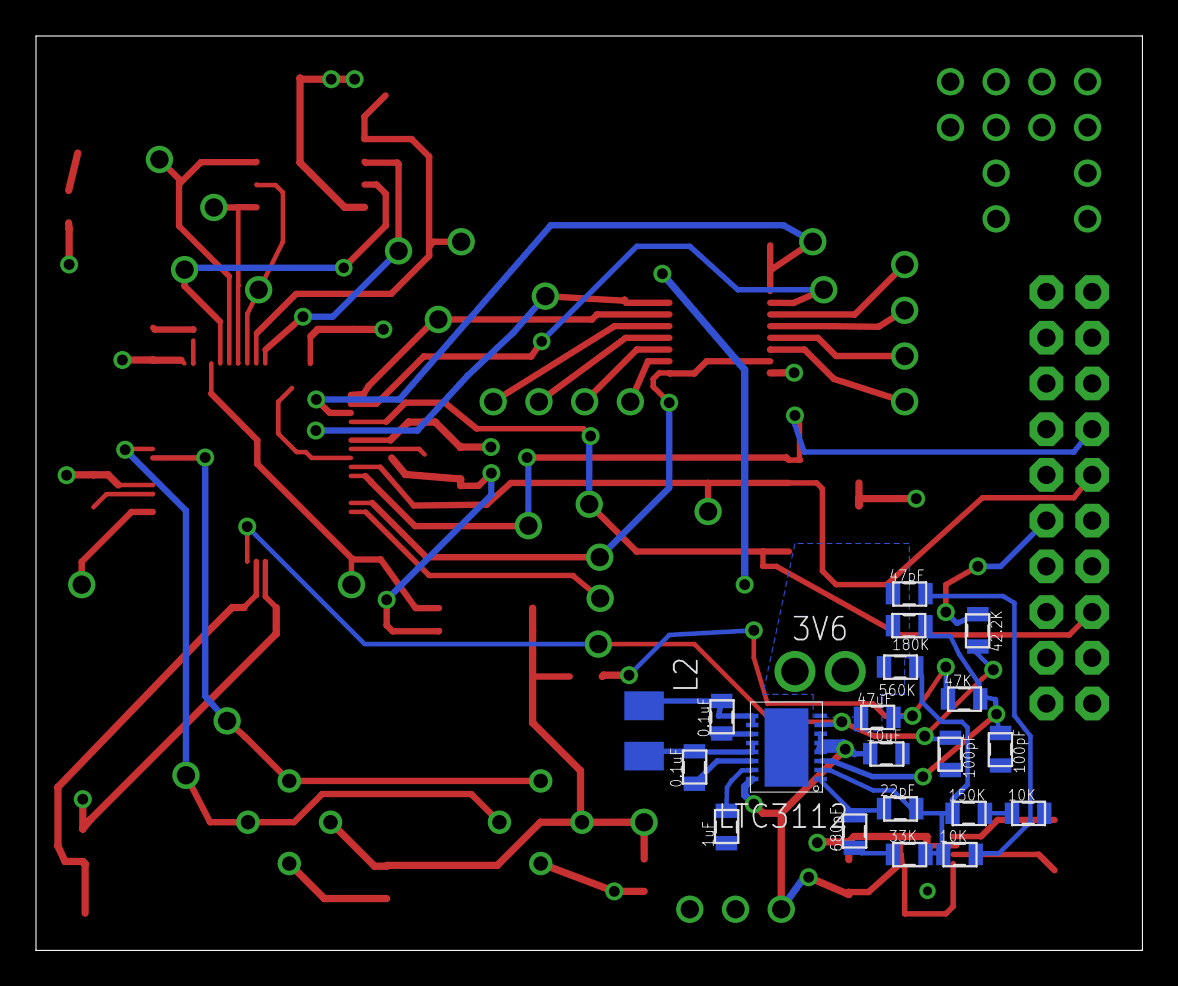
[picture p156: board ProcessorTestBoardV1_0.brd from below]

Board: 2 copper layers, 61.5 x 50.8 mm, 48 parts (20 on the bottom side), 38 nets.
