BrownSpaceEngineering/EquiSat-EAGLE/projects/EQUiSat/FlashPanel/FlashPanelV6_2.brd

## EAGLE design projects/EQUiSat/FlashPanel/FlashPanelV6_2.brd (2017-02-14)

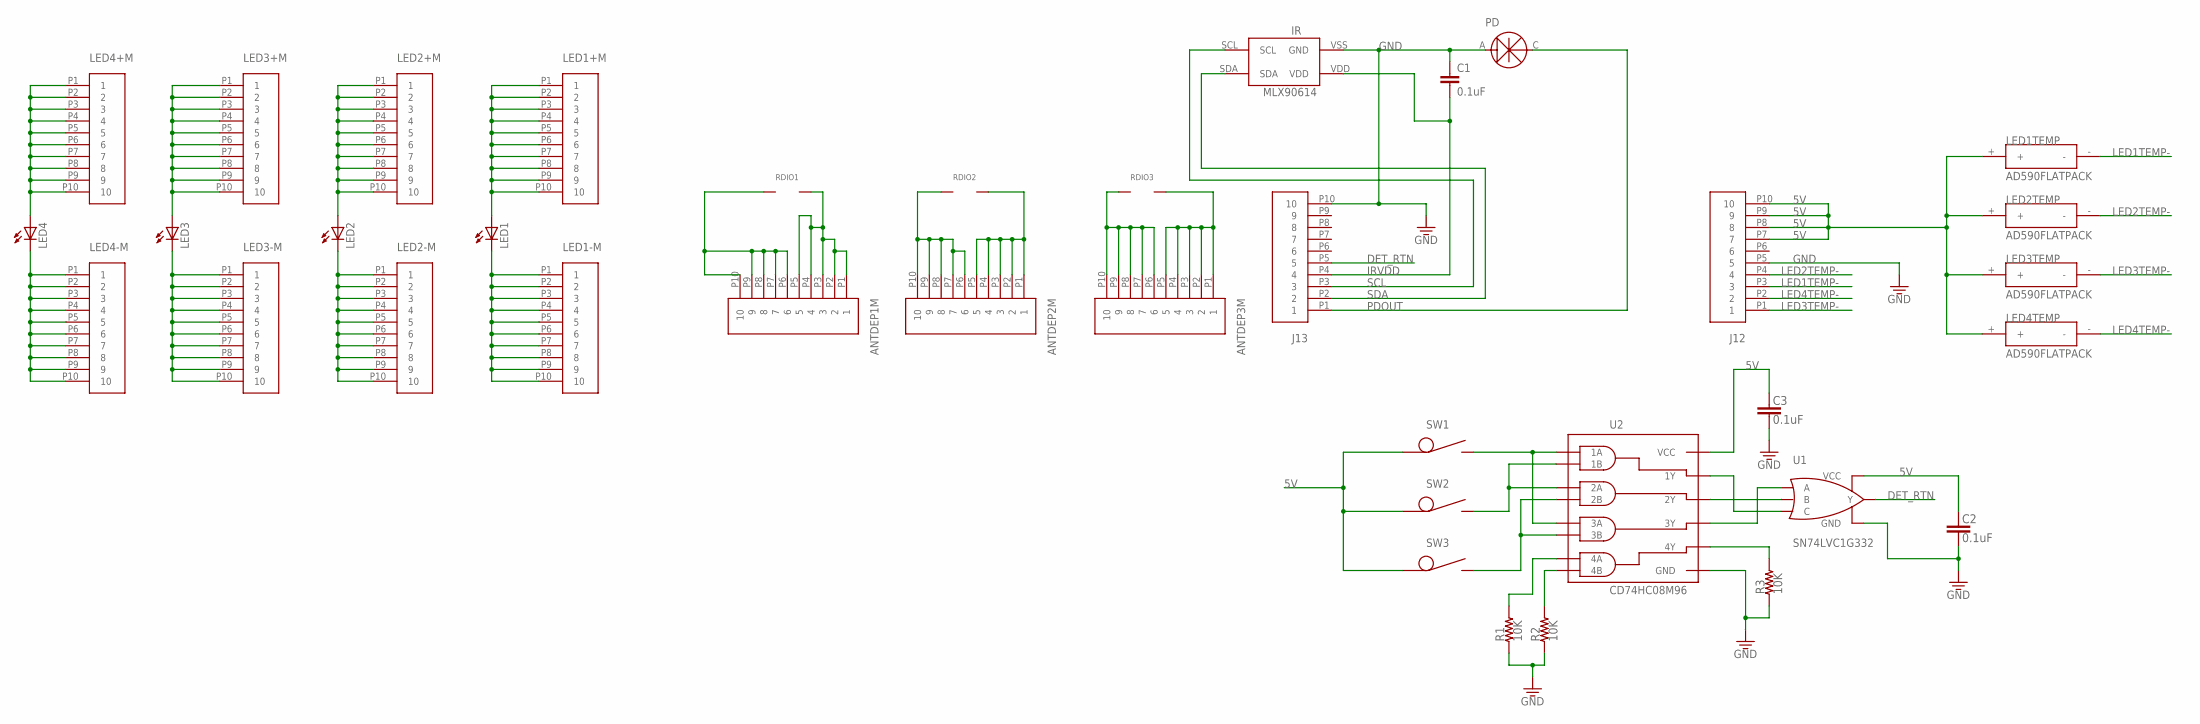
[picture p157: schematic FlashPanelV6_2.sch]

Parts:
ANTDEP1M, ANTDEP2M, ANTDEP3M: 10PINMALE
C1, C2, C3: 0.1uF; 0805
IR: MXL90614; MXL90620
J12, J13: 10PINMALE
LED1, LED2, LED3, LED4: CXM27
LED1+M, LED1-M, LED2+M, LED2-M, LED3+M, LED3-M, LED4+M, LED4-M: 10PINMALE
LED1TEMP, LED2TEMP, LED3TEMP, LED4TEMP: AD590FLATPACK; FLATPACK
PD: TEMD6200
R1, R2, R3: 10K; 0805
RDIO1, RDIO2, RDIO3: RDIO; RDIO_DPLY
SW1, SW2, SW3: SW-DETECT; SW-SPRING
U1: SN74LVC1G332; DCK-6
U2: CD74HC08M96; SOIC-14

Connections:
5V: C2.1, C3.1, J12.P7 (7), J12.P8 (8), J12.P9 (9), J12.P10 (10), LED1TEMP.+, LED2TEMP.+, LED3TEMP.+, LED4TEMP.+, SW1.P$1, SW2.P$1, SW3.P$1, U1.P$5 (VCC), U2.P$14 (VCC)
DET_RTN: J13.P5 (5), U1.P$4 (Y)
GND: C1.1, C2.2, C3.2, IR.VSS (GND), J12.P5 (5), J13.P10 (10), PD.A, R1.1, R2.1, R3.1, U1.P$2 (GND), U2.P$7 (GND)
IRVDD: C1.2, IR.VDD, J13.P4 (4)
LED1M: LED1.CATHODE (C), LED1-M.P1 (1), LED1-M.P2 (2), LED1-M.P3 (3), LED1-M.P4 (4), LED1-M.P5 (5), LED1-M.P6 (6), LED1-M.P7 (7), LED1-M.P8 (8), LED1-M.P9 (9), LED1-M.P10 (10)
LED1P: LED1.ANODE (A), LED1+M.P1 (1), LED1+M.P2 (2), LED1+M.P3 (3), LED1+M.P4 (4), LED1+M.P5 (5), LED1+M.P6 (6), LED1+M.P7 (7), LED1+M.P8 (8), LED1+M.P9 (9), LED1+M.P10 (10)
LED1TEMP-: J12.P3 (3), LED1TEMP.-
LED2M: LED2.CATHODE (C), LED2-M.P1 (1), LED2-M.P2 (2), LED2-M.P3 (3), LED2-M.P4 (4), LED2-M.P5 (5), LED2-M.P6 (6), LED2-M.P7 (7), LED2-M.P8 (8), LED2-M.P9 (9), LED2-M.P10 (10)
LED2P: LED2.ANODE (A), LED2+M.P1 (1), LED2+M.P2 (2), LED2+M.P3 (3), LED2+M.P4 (4), LED2+M.P5 (5), LED2+M.P6 (6), LED2+M.P7 (7), LED2+M.P8 (8), LED2+M.P9 (9), LED2+M.P10 (10)
LED2TEMP-: J12.P4 (4), LED2TEMP.-
LED3M: LED3.CATHODE (C), LED3-M.P1 (1), LED3-M.P2 (2), LED3-M.P3 (3), LED3-M.P4 (4), LED3-M.P5 (5), LED3-M.P6 (6), LED3-M.P7 (7), LED3-M.P8 (8), LED3-M.P9 (9), LED3-M.P10 (10)
LED3P: LED3.ANODE (A), LED3+M.P1 (1), LED3+M.P2 (2), LED3+M.P3 (3), LED3+M.P4 (4), LED3+M.P5 (5), LED3+M.P6 (6), LED3+M.P7 (7), LED3+M.P8 (8), LED3+M.P9 (9), LED3+M.P10 (10)
LED3TEMP-: J12.P1 (1), LED3TEMP.-
LED4M: LED4.CATHODE (C), LED4-M.P1 (1), LED4-M.P2 (2), LED4-M.P3 (3), LED4-M.P4 (4), LED4-M.P5 (5), LED4-M.P6 (6), LED4-M.P7 (7), LED4-M.P8 (8), LED4-M.P9 (9), LED4-M.P10 (10)
LED4P: LED4.ANODE (A), LED4+M.P1 (1), LED4+M.P2 (2), LED4+M.P3 (3), LED4+M.P4 (4), LED4+M.P5 (5), LED4+M.P6 (6), LED4+M.P7 (7), LED4+M.P8 (8), LED4+M.P9 (9), LED4+M.P10 (10)
LED4TEMP-: J12.P2 (2), LED4TEMP.-
unnamed: U1.P$6 (C), U2.P$3 (1Y)
unnamed: U1.P$3 (B), U2.P$6 (2Y)
unnamed: U1.P$1 (A), U2.P$8 (3Y)
unnamed: SW1.P$2, U2.P$1 (1A), U2.P$9 (3A)
unnamed: SW2.P$2, U2.P$2 (1B), U2.P$4 (2A)
unnamed: SW3.P$2, U2.P$5 (2B), U2.P$10 (3B)
unnamed: R2.2, U2.P$13 (4B)
unnamed: R1.2, U2.P$12 (4A)
unnamed: R3.2, U2.P$11 (4Y)
PDOUT: J13.P1 (1), PD.C
RDIO1+: ANTDEP1M.P6 (6), ANTDEP1M.P7 (7), ANTDEP1M.P8 (8), ANTDEP1M.P9 (9), ANTDEP1M.P10 (10), RDIO1.P3, RDIO1.P4
RDIO1-: ANTDEP1M.P1 (1), ANTDEP1M.P2 (2), ANTDEP1M.P3 (3), ANTDEP1M.P4 (4), ANTDEP1M.P5 (5), RDIO1.P1, RDIO1.P2
RDIO2+: ANTDEP2M.P6 (6), ANTDEP2M.P7 (7), ANTDEP2M.P8 (8), ANTDEP2M.P9 (9), ANTDEP2M.P10 (10), RDIO2.P3, RDIO2.P4
RDIO2-: ANTDEP2M.P1 (1), ANTDEP2M.P2 (2), ANTDEP2M.P3 (3), ANTDEP2M.P4 (4), ANTDEP2M.P5 (5), RDIO2.P1, RDIO2.P2
RDIO3+: ANTDEP3M.P6 (6), ANTDEP3M.P7 (7), ANTDEP3M.P8 (8), ANTDEP3M.P9 (9), ANTDEP3M.P10 (10), RDIO3.P3, RDIO3.P4
RDIO3-: ANTDEP3M.P1 (1), ANTDEP3M.P2 (2), ANTDEP3M.P3 (3), ANTDEP3M.P4 (4), ANTDEP3M.P5 (5), RDIO3.P1, RDIO3.P2
SCL: IR.SCL, J13.P3 (3)
SDA: IR.SDA, J13.P2 (2)
