BrownSpaceEngineering/EquiSat-EAGLE/projects/EQUiSat/FlashPanel/FlashPanelV6_2.brd

## EAGLE design projects/EQUiSat/FlashPanel/FlashPanelV6_2.brd (continued)

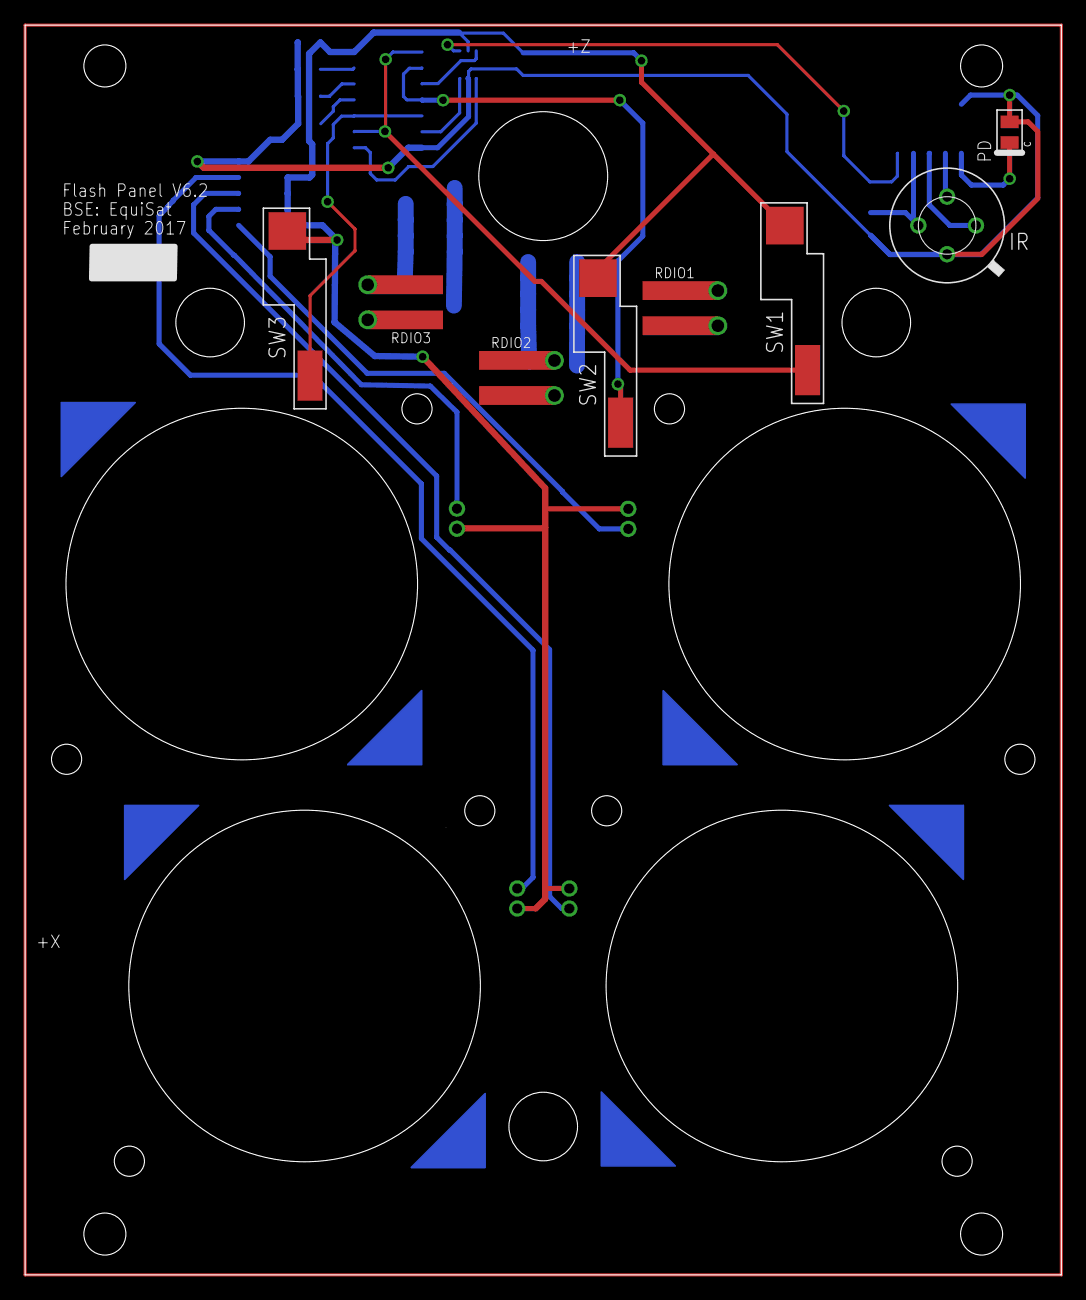
[picture p158: board FlashPanelV6_2.brd from above]

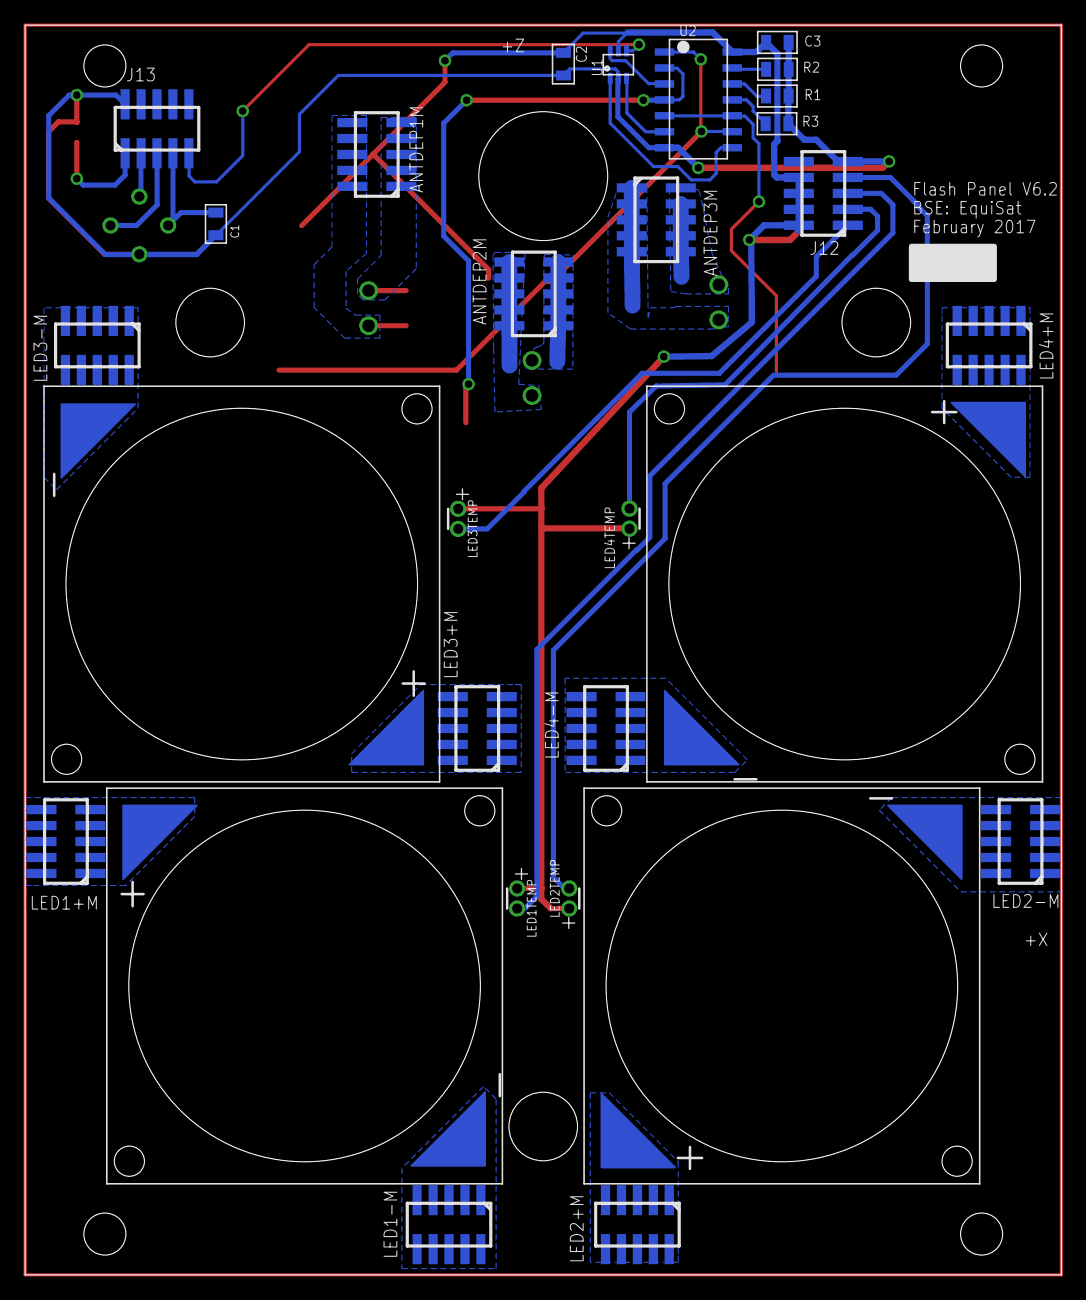
[picture p159: board FlashPanelV6_2.brd from below]

Board: 2 copper layers, 82.5 x 99.5 mm, 37 parts (25 on the bottom side), 34 nets.
