BrownSpaceEngineering/EquiSat-EAGLE/projects/EQUiSat/BatteryBoard/BatteryBoardV1.brd

## EAGLE design projects/EQUiSat/BatteryBoard/BatteryBoardV1.brd (2016-12-04, an earlier design)

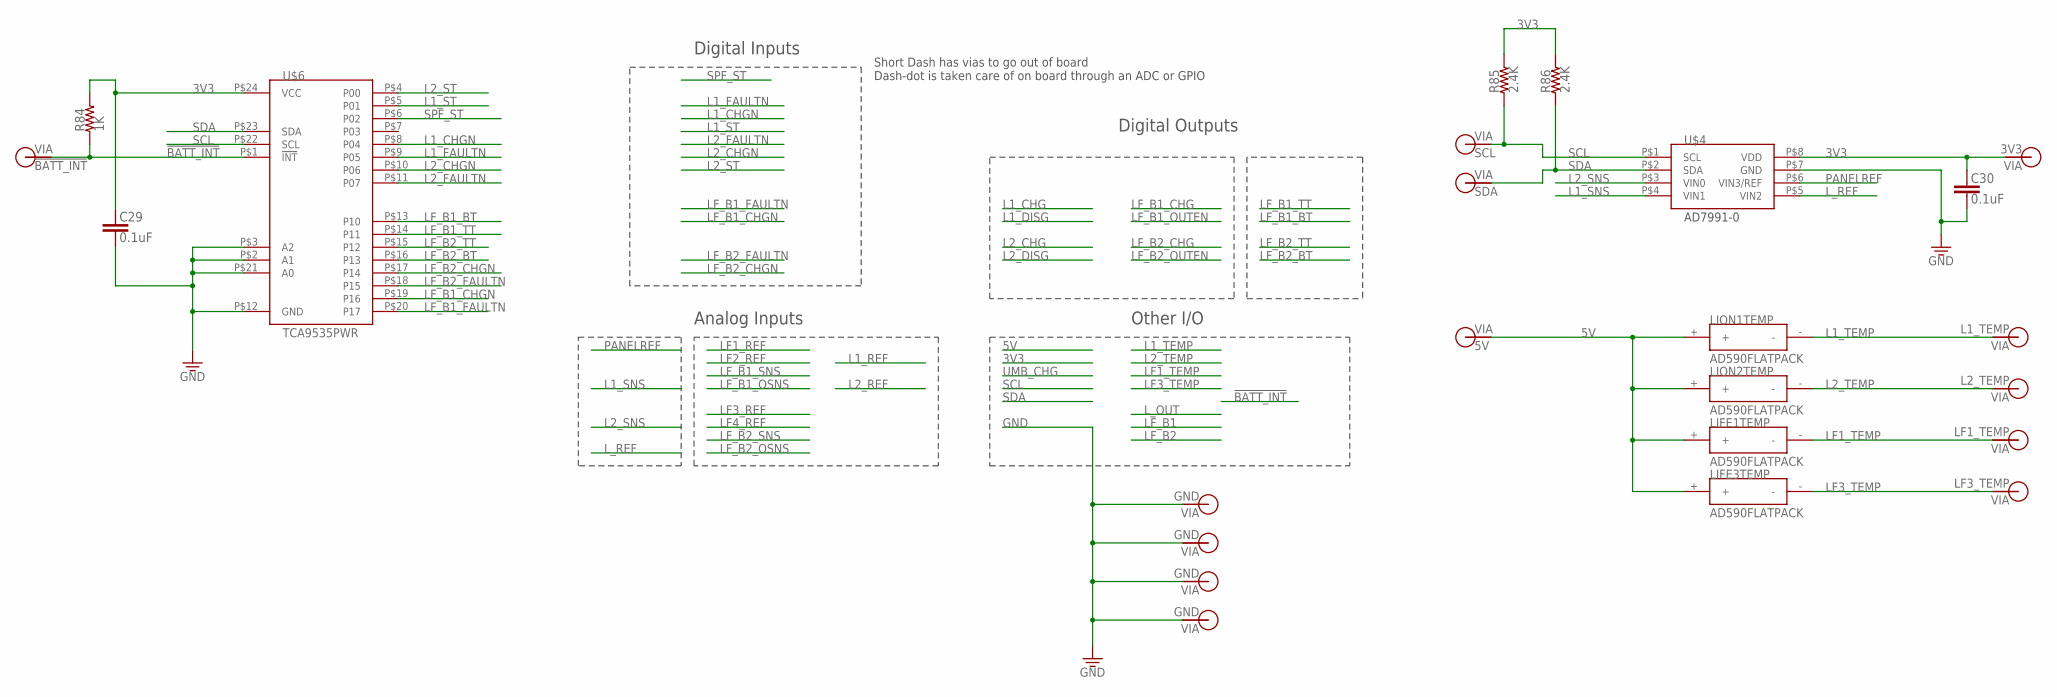
[picture p160: schematic BatteryBoardV1.sch, sheet 1, Data and I/O]

Parts:
C29, C30: 0.1uF; 0805
LIFE1TEMP, LIFE3TEMP: AD590FLATPACK; FLATPACK
LION1TEMP, LION2TEMP: AD590FLATPACK; FLATPACK
R84: 1K; 0805
R85, R86: 2.4K; 0805
U$4: AD7991-0; SOT-23-8
U$6: TCA9535PWR; TSSOP-24
V9: 5V; VIA-60MIL
V11: !BATT_INT!; VIA-60MIL
V12: GND; VIA-60MIL-SQ
V13, V22, V23: GND; VIA-120MIL
V24: L1_TEMP; VIA-60MIL
V32: L2_TEMP; VIA-60MIL
V37: LF1_TEMP; VIA-60MIL
V50: LF3_TEMP; VIA-60MIL
V51: 3V3; VIA-60MIL
V52: SCL; VIA-60MIL
V53: SDA; VIA-60MIL

Connections:
3V3: C29.1, C30.1, R84.2, R85.2, R86.2, U$4.P$8 (VDD), U$6.P$24 (VCC), V51.P$1; also elsewhere on the board
5V: LIFE1TEMP.+, LIFE3TEMP.+, LION1TEMP.+, LION2TEMP.+, V9.P$1
!BATT_INT!: R84.1, U$6.P$1 (!INT!), V11.P$1
GND: C29.2, C30.2, U$4.P$7 (GND), U$6.P$2 (A1), U$6.P$3 (A2), U$6.P$12 (GND), U$6.P$21 (A0), V12.P$1, V13.P$1, V22.P$1, V23.P$1; also elsewhere on the board
L1_CHGN: U$6.P$8 (P04); also elsewhere on the board
L1_FAULTN: U$6.P$9 (P05); also elsewhere on the board
L1_SNS: U$4.P$4 (VIN1); also elsewhere on the board
L1_ST: U$6.P$5 (P01); also elsewhere on the board
L1_TEMP: LION1TEMP.-, V24.P$1
L2_CHGN: U$6.P$10 (P06); also elsewhere on the board
L2_FAULTN: U$6.P$11 (P07); also elsewhere on the board
L2_SNS: U$4.P$3 (VIN0); also elsewhere on the board
L2_ST: U$6.P$4 (P00); also elsewhere on the board
L2_TEMP: LION2TEMP.-, V32.P$1
LF1_TEMP: LIFE1TEMP.-, V37.P$1
LF3_TEMP: LIFE3TEMP.-, V50.P$1
LF_B1_BT: U$6.P$13 (P10); also elsewhere on the board
LF_B1_CHGN: U$6.P$19 (P16); also elsewhere on the board
LF_B1_FAULTN: U$6.P$20 (P17); also elsewhere on the board
LF_B1_TT: U$6.P$14 (P11); also elsewhere on the board
LF_B2_BT: U$6.P$16 (P13); also elsewhere on the board
LF_B2_CHGN: U$6.P$17 (P14); also elsewhere on the board
LF_B2_FAULTN: U$6.P$18 (P15); also elsewhere on the board
LF_B2_TT: U$6.P$15 (P12); also elsewhere on the board
L_REF: U$4.P$5 (VIN2); also elsewhere on the board
PANELREF: U$4.P$6 (VIN3/REF); also elsewhere on the board
SCL: R85.1, U$4.P$1 (SCL), U$6.P$22 (SCL), V52.P$1
SDA: R86.1, U$4.P$2 (SDA), U$6.P$23 (SDA), V53.P$1
SPF_ST: U$6.P$6 (P02); also elsewhere on the board

Notes on the sheet:
Digital Inputs
Digital Outputs
Analog Inputs
Other I/O
Short Dash has vias to go out of board Dash-dot is taken care of on board through an ADC or GPIO

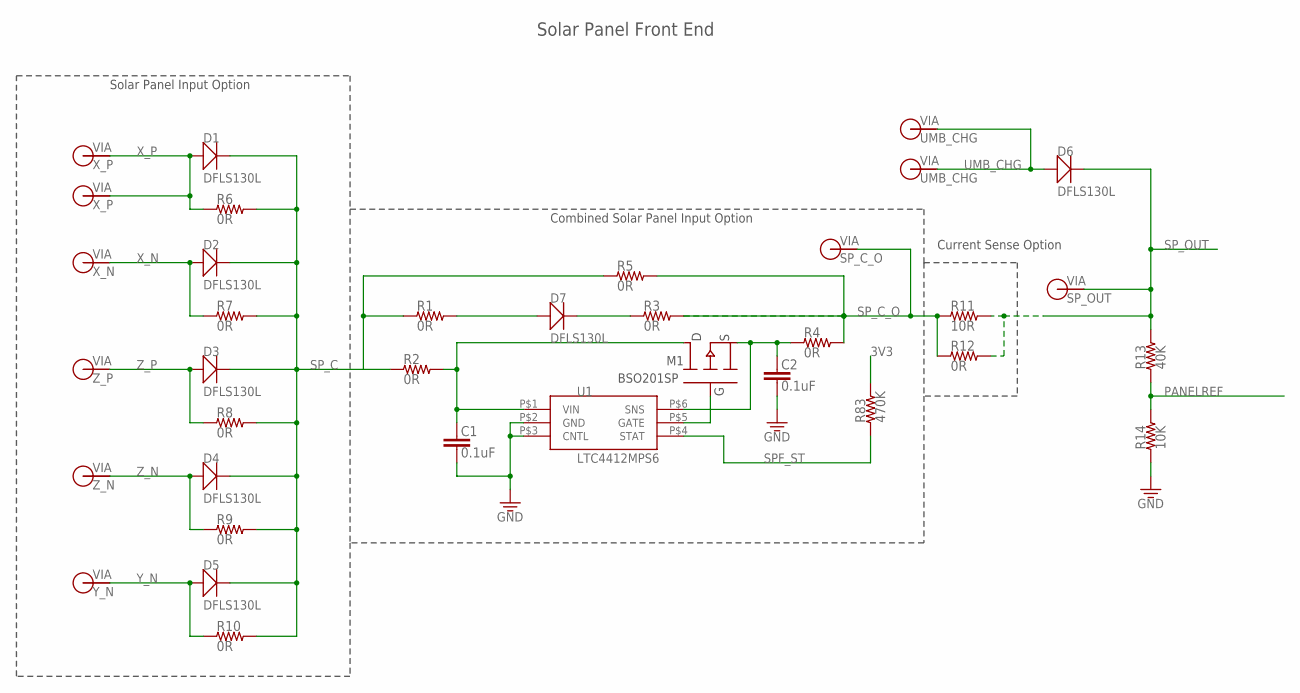
[picture p161: schematic BatteryBoardV1.sch, sheet 2, Solar Panel Front End]

Parts:
C1, C2: 0.1uF; 0805
D1, D2, D3, D4, D5, D6, D7: DFLS130L; PWRDI-123
M1: BSO201SP; SO-8
R1, R2, R3, R4, R5, R6, R7, R8, R9, R10, R12: 0R; 0805
R11: 10R; 0805
R13: 40K; 0805
R14: 10K; 0805
R83: 470K; 0805
U1: LTC4412MPS6; TSOT23-6
V1: UMB_CHG; VIA-60MIL
V2: X_P; VIA-60MIL
V3: X_N; VIA-60MIL
V4: Z_P; VIA-60MIL
V5: Z_N; VIA-60MIL
V6: Y_N; VIA-60MIL
V7: SP_C_O; VIA-60MIL-SQ
V8: SP_OUT; VIA-60MIL-SQ
V39: UMB_CHG; VIA-60MIL-SQ
V49: X_P; VIA-60MIL-SQ

Connections:
3V3: R83.2; also elsewhere on the board
GND: C1.2, C2.2, R14.1, U1.P$2 (GND), U1.P$3 (CNTL); also elsewhere on the board
unnamed: M1.P$4 (G), U1.P$5 (GATE)
unnamed: C2.1, M1.P$1 (S), M1.P$2 (S), M1.P$3 (S), R4.1, U1.P$6 (SNS)
unnamed: D7.A, R1.2
unnamed: D7.C, R3.1
unnamed: C1.1, M1.P$5 (D), M1.P$6 (D), M1.P$7 (D), M1.P$8 (D), R2.2, U1.P$1 (VIN)
PANELREF: R13.1, R14.2; also elsewhere on the board
SPF_ST: R83.1, U1.P$4 (STAT); also elsewhere on the board
SP_C: D1.C, D2.C, D3.C, D4.C, D5.C, R1.1, R2.1, R5.1, R6.2, R7.2, R8.2, R9.2, R10.2
SP_C_O: R3.2, R4.2, R5.2, R11.1, R12.1, V7.P$1
SP_OUT: D6.C, R11.2, R12.2, R13.2, V8.P$1; also elsewhere on the board
UMB_CHG: D6.A, V1.P$1, V39.P$1
X_N: D2.A, R7.1, V3.P$1
X_P: D1.A, R6.1, V2.P$1, V49.P$1
Y_N: D5.A, R10.1, V6.P$1
Z_N: D4.A, R9.1, V5.P$1
Z_P: D3.A, R8.1, V4.P$1

Notes on the sheet:
Solar Panel Input Option
Combined Solar Panel Input Option
Current Sense Option
Solar Panel Front End

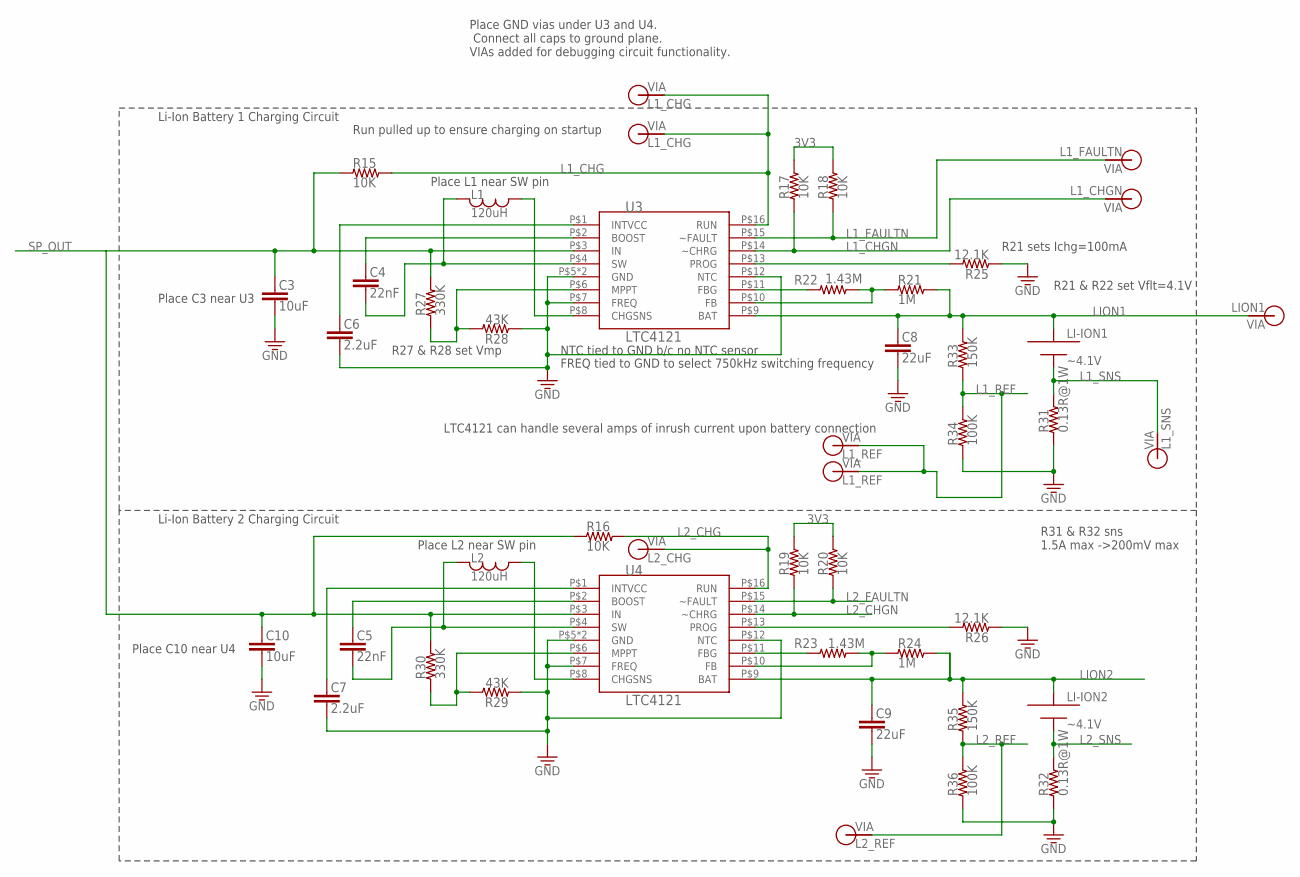
[picture p162: schematic BatteryBoardV1.sch, sheet 3, Li-Ion Charging]

Parts:
C3, C10: 10uF; 0805
C4, C5: 22nF; 0805
C6, C7: 2.2uF; 0805
C8, C9: 22uF; 0805
L1, L2: 120uH; 1812
LI-ION1, LI-ION2: ~4.1V; EQUISAT-BATTERY-VA
R15, R16, R17, R18, R19, R20: 10K; 0805
R21, R24: 1M; 0805
R22, R23: 1.43M; 0805
R25, R26: 12.1K; 0805
R27, R30: 330K; 0805
R28, R29: 43K; 0805
R31, R32: 0.13R@1W; 1210
R33, R35: 150K; 0805
R34, R36: 100K; 0805
U3, U4: LTC4121; QFN-16-PAD
V10: L1_CHG; VIA-60MIL
V25: L1_REF; VIA-60MIL
V29: L2_REF; VIA-60MIL
V33: L2_CHG; VIA-60MIL
V40: L1_CHG; VIA-60MIL-SQ
V41: L1_FAULTN; VIA-60MIL-SQ
V42: L1_CHGN; VIA-60MIL-SQ
V43: L1_SNS; VIA-60MIL-SQ
V44: L1_REF; VIA-60MIL-SQ
V45: LION1; VIA-60MIL-SQ

Connections:
3V3: R17.2, R18.2, R19.2, R20.2; also elsewhere on the board
GND: C3.2, C6.2, C7.2, C8.2, C9.2, C10.2, R25.1, R26.1, R28.1, R29.1, R31.P$1 (1), R32.P$1 (1), R34.1, R36.1, U3.P$5 (GND), U3.P$7 (FREQ), U3.P$12 (NTC), U3.P$17 (GND), U4.P$5 (GND), U4.P$7 (FREQ), U4.P$12 (NTC), U4.P$17 (GND); also elsewhere on the board
L1_CHG: R15.2, U3.P$16 (RUN), V10.P$1, V40.P$1
L1_CHGN: R17.1, U3.P$14 (~CHRG), V42.P$1; also elsewhere on the board
L1_FAULTN: R18.1, U3.P$15 (~FAULT), V41.P$1; also elsewhere on the board
L1_REF: R33.1, R34.2, V25.P$1, V44.P$1
L1_SNS: LI-ION1.MINUS, R31.P$2 (2), V43.P$1; also elsewhere on the board
L2_CHG: R16.2, U4.P$16 (RUN), V33.P$1
L2_CHGN: R19.1, U4.P$14 (~CHRG); also elsewhere on the board
L2_FAULTN: R20.1, U4.P$15 (~FAULT); also elsewhere on the board
L2_REF: R35.1, R36.2, V29.P$1
L2_SNS: LI-ION2.MINUS, R32.P$2 (2); also elsewhere on the board
LION1: C8.1, LI-ION1.PLUS, R21.2, R33.2, U3.P$9 (BAT), V45.P$1; also elsewhere on the board
LION2: C9.1, LI-ION2.PLUS, R24.2, R35.2, U4.P$9 (BAT); also elsewhere on the board
unnamed: C4.2, L1.P$1, U3.P$4 (SW)
unnamed: C4.1, U3.P$2 (BOOST)
unnamed: C5.1, U4.P$2 (BOOST)
unnamed: C5.2, L2.P$1, U4.P$4 (SW)
unnamed: C7.1, U4.P$1 (INTVCC)
unnamed: C6.1, U3.P$1 (INTVCC)
unnamed: R23.1, U4.P$11 (FBG)
unnamed: R23.2, R24.1, U4.P$10 (FB)
unnamed: R22.1, U3.P$11 (FBG)
unnamed: R21.1, R22.2, U3.P$10 (FB)
unnamed: L1.P$2, U3.P$8 (CHGSNS)
unnamed: R25.2, U3.P$13 (PROG)
unnamed: R26.2, U4.P$13 (PROG)
unnamed: R29.2, R30.1, U4.P$6 (MPPT)
unnamed: R27.1, R28.2, U3.P$6 (MPPT)
unnamed: L2.P$2, U4.P$8 (CHGSNS)
SP_OUT: C3.1, C10.1, R15.1, R16.1, R27.2, R30.2, U3.P$3 (IN), U4.P$3 (IN); also elsewhere on the board

Notes on the sheet:
FREQ tied to GND to select 750kHz switching frequency
R21 sets Ichg=100mA
R21 & R22 set Vflt=4.1V
R27 & R28 set Vmp
Place C3 near U3
Place C10 near U4
Place L2 near SW pin
Place L1 near SW pin
Place GND vias under U3 and U4. Connect all caps to ground plane. VIAs added for debugging circuit functionality.
Li-Ion Battery 1 Charging Circuit
Li-Ion Battery 2 Charging Circuit
Run pulled up to ensure charging on startup
NTC tied to GND b/c no NTC sensor
R31 & R32 sns 1.5A max ->200mV max
LTC4121 can handle several amps of inrush current upon battery connection

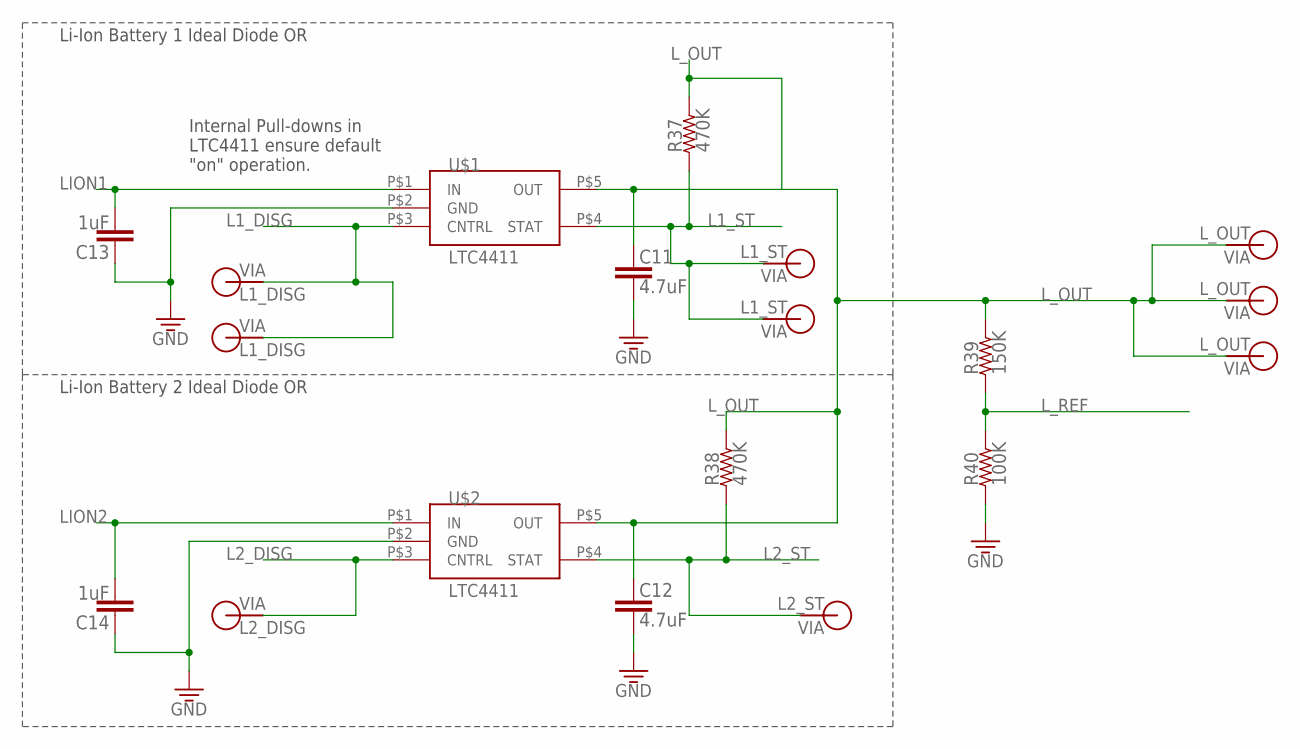
[picture p163: schematic BatteryBoardV1.sch, sheet 4, Li-Ion Diode Or'ing]

Parts:
C11, C12: 4.7uF; 0805
C13, C14: 1uF; 0805
R37, R38: 470K; 0805
R39: 150K; 0805
R40: 100K; 0805
U$1, U$2: LTC4411; TSOT23-5
V30, V54: L_OUT; VIA-120MIL
V34: L1_DISG; VIA-60MIL
V35: L2_DISG; VIA-60MIL
V36: L1_ST; VIA-60MIL
V38: L2_ST; VIA-60MIL
V46: L1_DISG; VIA-60MIL-SQ
V47: L1_ST; VIA-60MIL-SQ
V48: L_OUT; VIA-60MIL-SQ

Connections:
GND: C11.2, C12.2, C13.1, C14.1, R40.1, U$1.P$2 (GND), U$2.P$2 (GND); also elsewhere on the board
L1_DISG: U$1.P$3 (CNTRL), V34.P$1, V46.P$1
L1_ST: R37.1, U$1.P$4 (STAT), V36.P$1, V47.P$1; also elsewhere on the board
L2_DISG: U$2.P$3 (CNTRL), V35.P$1
L2_ST: R38.1, U$2.P$4 (STAT), V38.P$1; also elsewhere on the board
LION1: C13.2, U$1.P$1 (IN); also elsewhere on the board
LION2: C14.2, U$2.P$1 (IN); also elsewhere on the board
L_OUT: C11.1, C12.1, R37.2, R38.2, R39.2, U$1.P$5 (OUT), U$2.P$5 (OUT), V30.P$1, V48.P$1, V54.P$1
L_REF: R39.1, R40.2; also elsewhere on the board

Notes on the sheet:
Internal Pull-downs in LTC4411 ensure default "on" operation.
Li-Ion Battery 1 Ideal Diode OR
Li-Ion Battery 2 Ideal Diode OR

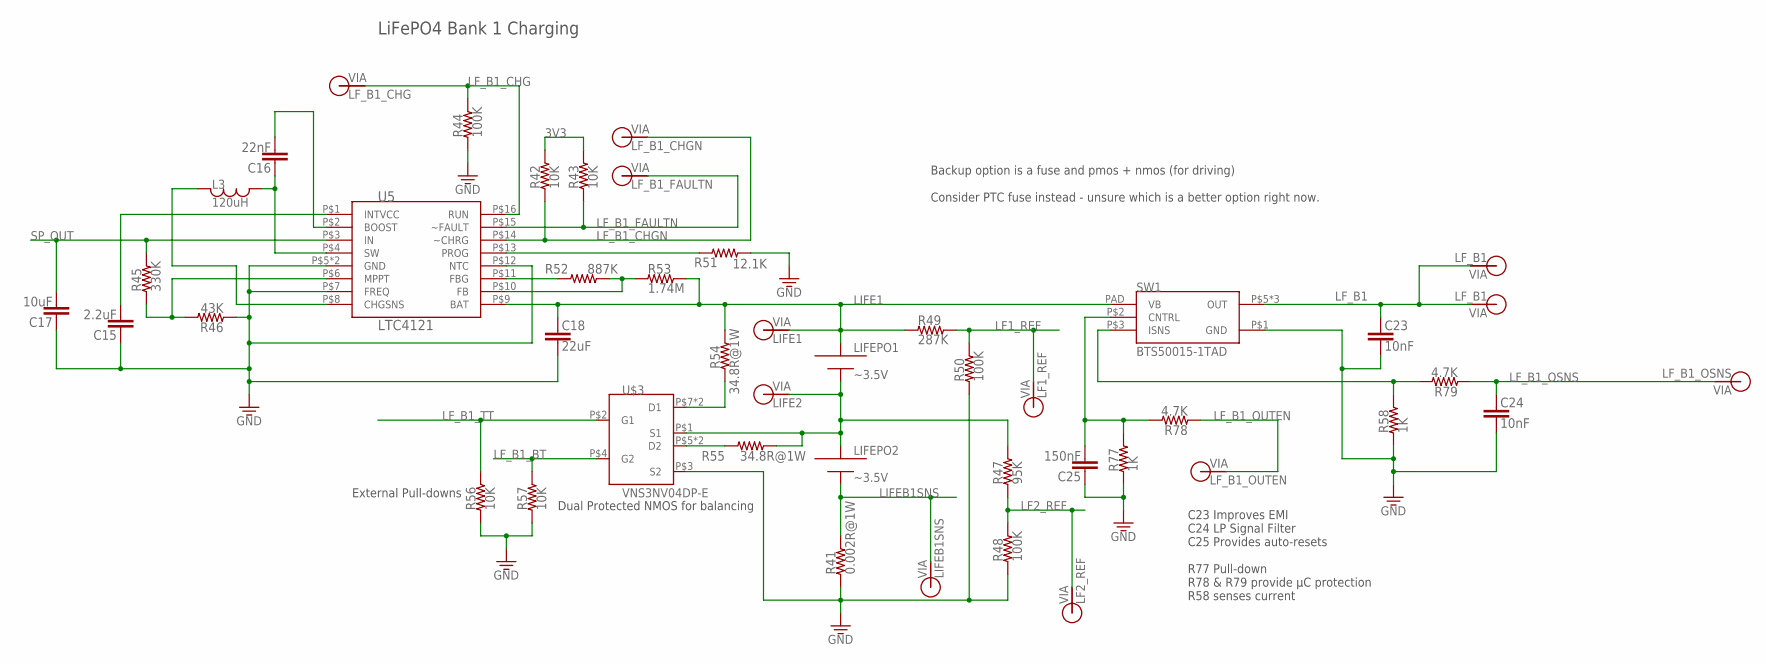
[picture p164: schematic BatteryBoardV1.sch, sheet 5, LiFePO4 Bank 1 Charging]

Parts:
C15: 2.2uF; 0805
C16: 22nF; 0805
C17: 10uF; 0805
C18: 22uF; 0805
C23, C24: 10nF; 0805
C25: 150nF; 0805
L3: 120uH; 1812
LIFEPO1: ~3.5V; EQUISAT-BATTERY-VA
LIFEPO2: ~3.5V; EQUISAT-BATTERY-VB
R41: 0.002R@1W; 1210
R42, R43, R56, R57: 10K; 0805
R44, R48, R50: 100K; 0805
R45: 330K; 0805
R46: 43K; 0805
R47: 95K; 0805
R49: 287K; 0805
R51: 12.1K; 0805
R52: 887K; 0805
R53: 1.74M; 0805
R54, R55: 34.8R@1W; 1210
R58, R77: 1K; 0805
R78, R79: 4.7K; 0805
SW1: BTS50015-1TAD; TO-263-7-8
U5: LTC4121; QFN-16-PAD
U$3: VNS3NV04DP-E; SO-8
V14: LIFEB1SNS; VIA-60MIL
V15: LF_B1_CHG; VIA-60MIL
V16: LIFE2; VIA-60MIL-SQ
V17: LIFE1; VIA-60MIL-SQ
V18: LF_B1_CHGN; VIA-60MIL
V19: LF_B1_FAULTN; VIA-60MIL
V20: LF_B1_OUTEN; VIA-60MIL
V21, V26: LF_B1; VIA-120MIL
V31: LF_B1_OSNS; VIA-60MIL
V58: LF1_REF; VIA-60MIL
V59: LF2_REF; VIA-60MIL

Connections:
3V3: R42.2, R43.2; also elsewhere on the board
GND: C15.1, C17.1, C18.2, C23.2, C24.2, C25.1, R41.P$1 (1), R44.1, R46.1, R48.1, R50.1, R51.2, R56.1, R57.1, R58.1, R77.1, SW1.P$1 (GND), U5.P$5 (GND), U5.P$7 (FREQ), U5.P$12 (NTC), U5.P$17 (GND), U$3.P$3 (S2); also elsewhere on the board
LF1_REF: R49.2, R50.2, V58.P$1
LF2_REF: R47.1, R48.2, V59.P$1
LF_B1: C23.1, SW1.P$5 (OUT), SW1.P$6 (OUT), SW1.P$7 (OUT), V21.P$1, V26.P$1
LF_B1_BT: R57.2, U$3.P$4 (G2); also elsewhere on the board
LF_B1_CHG: R44.2, U5.P$16 (RUN), V15.P$1
LF_B1_CHGN: R42.1, U5.P$14 (~CHRG), V18.P$1; also elsewhere on the board
LF_B1_FAULTN: R43.1, U5.P$15 (~FAULT), V19.P$1; also elsewhere on the board
LF_B1_OSNS: C24.1, R79.1, V31.P$1
LF_B1_OUTEN: R78.1, V20.P$1
LF_B1_TT: R56.2, U$3.P$2 (G1); also elsewhere on the board
LIFE1: C18.1, LIFEPO1.PLUS, R49.1, R53.2, R54.P$2 (2), SW1.PAD (VB), U5.P$9 (BAT), V17.P$1
LIFE2: LIFEPO1.MINUS, LIFEPO2.PLUS, R47.2, R55.P$1 (1), U$3.P$1 (S1), V16.P$1
LIFEB1SNS: LIFEPO2.MINUS, R41.P$2 (2), V14.P$1
unnamed: R51.1, U5.P$13 (PROG)
unnamed: R54.P$1 (1), U$3.P$7 (D1), U$3.P$8 (D1)
unnamed: R55.P$2 (2), U$3.P$5 (D2), U$3.P$6 (D2)
unnamed: R52.1, U5.P$11 (FBG)
unnamed: R45.1, R46.2, U5.P$6 (MPPT)
unnamed: R52.2, R53.1, U5.P$10 (FB)
unnamed: C15.2, U5.P$1 (INTVCC)
unnamed: C16.1, L3.P$2, U5.P$4 (SW)
unnamed: C16.2, U5.P$2 (BOOST)
unnamed: L3.P$1, U5.P$8 (CHGSNS)
unnamed: C25.2, R77.2, R78.2, SW1.P$2 (CNTRL)
unnamed: R58.2, R79.2, SW1.P$3 (ISNS)
SP_OUT: C17.2, R45.2, U5.P$3 (IN); also elsewhere on the board

Notes on the sheet:
LiFePO4 Bank 1 Charging
External Pull-downs
Dual Protected NMOS for balancing
Backup option is a fuse and pmos + nmos (for driving) Consider PTC fuse instead - unsure which is a better option right now.
C23 Improves EMI C24 LP Signal Filter C25 Provides auto-resets R77 Pull-down R78 & R79 provide µC protection R58 senses current

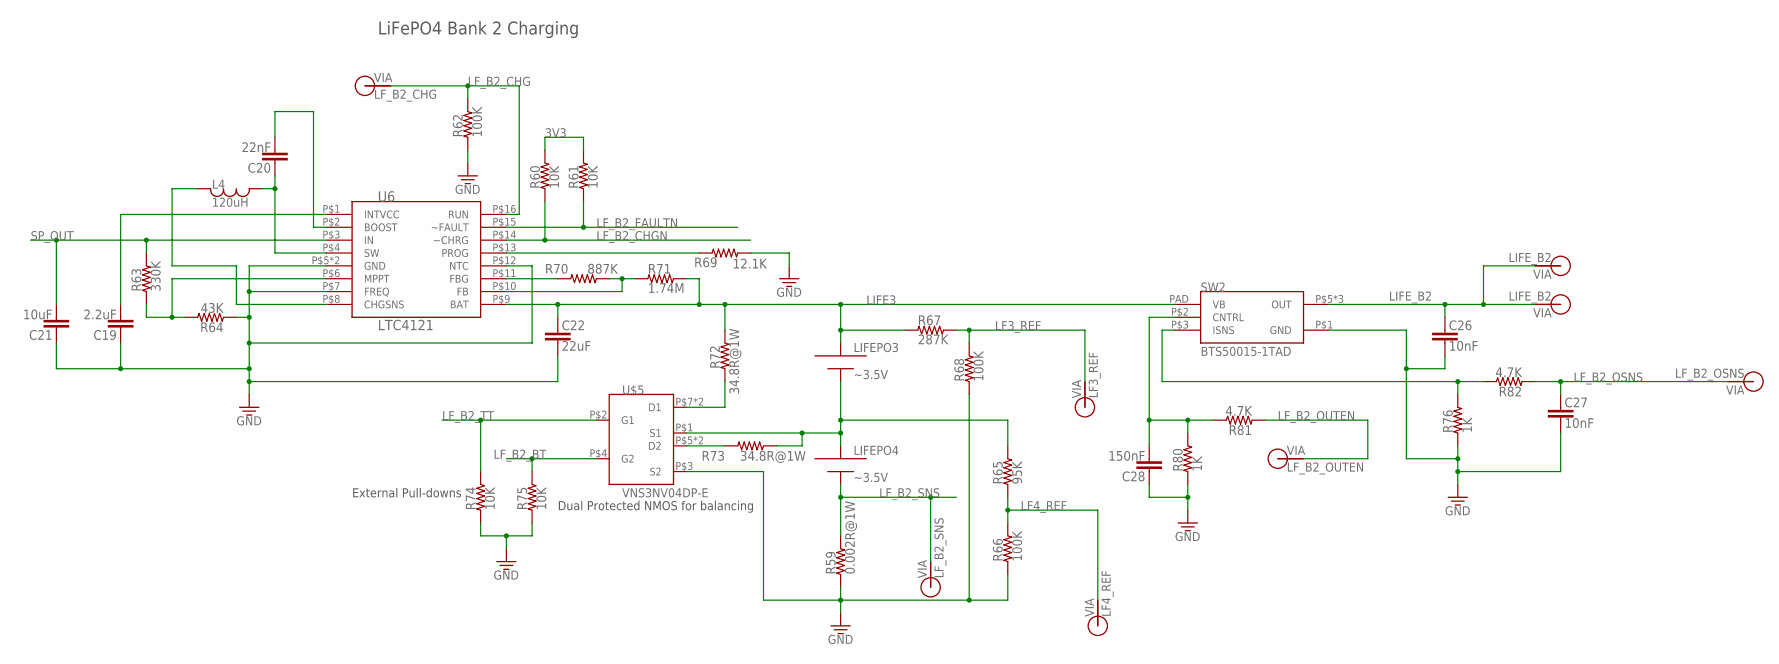
[picture p165: schematic BatteryBoardV1.sch, sheet 6, LiFePO4 Bank 2 Charging]

Parts:
C19: 2.2uF; 0805
C20: 22nF; 0805
C21: 10uF; 0805
C22: 22uF; 0805
C26, C27: 10nF; 0805
C28: 150nF; 0805
L4: 120uH; 1812
LIFEPO3: ~3.5V; EQUISAT-BATTERY-VA
LIFEPO4: ~3.5V; EQUISAT-BATTERY-VB
R59: 0.002R@1W; 1210
R60, R61, R74, R75: 10K; 0805
R62, R66, R68: 100K; 0805
R63: 330K; 0805
R64: 43K; 0805
R65: 95K; 0805
R67: 287K; 0805
R69: 12.1K; 0805
R70: 887K; 0805
R71: 1.74M; 0805
R72, R73: 34.8R@1W; 1210
R76, R80: 1K; 0805
R81, R82: 4.7K; 0805
SW2: BTS50015-1TAD; TO-263-7-8
U6: LTC4121; QFN-16-PAD
U$5: VNS3NV04DP-E; SO-8
V27, V28: LIFE_B2; VIA-120MIL
V56: LF_B2_OUTEN; VIA-60MIL
V57: LF_B2_CHG; VIA-60MIL
V60: LF_B2_SNS; VIA-60MIL
V61: LF4_REF; VIA-60MIL
V62: LF3_REF; VIA-60MIL
V63: LF_B2_OSNS; VIA-60MIL

Connections:
3V3: R60.2, R61.2; also elsewhere on the board
GND: C19.1, C21.1, C22.2, C26.2, C27.2, C28.1, R59.P$1 (1), R62.1, R64.1, R66.1, R68.1, R69.2, R74.1, R75.1, R76.1, R80.1, SW2.P$1 (GND), U6.P$5 (GND), U6.P$7 (FREQ), U6.P$12 (NTC), U6.P$17 (GND), U$5.P$3 (S2); also elsewhere on the board
LF3_REF: R67.2, R68.2, V62.P$1
LF4_REF: R65.1, R66.2, V61.P$1
LF_B2_BT: R75.2, U$5.P$4 (G2); also elsewhere on the board
LF_B2_CHG: R62.2, U6.P$16 (RUN), V57.P$1
LF_B2_CHGN: R60.1, U6.P$14 (~CHRG); also elsewhere on the board
LF_B2_FAULTN: R61.1, U6.P$15 (~FAULT); also elsewhere on the board
LF_B2_OSNS: C27.1, R82.1, V63.P$1
LF_B2_OUTEN: R81.1, V56.P$1
LF_B2_SNS: LIFEPO4.MINUS, R59.P$2 (2), V60.P$1
LF_B2_TT: R74.2, U$5.P$2 (G1); also elsewhere on the board
LIFE3: C22.1, LIFEPO3.PLUS, R67.1, R71.2, R72.P$2 (2), SW2.PAD (VB), U6.P$9 (BAT)
LIFE4: LIFEPO3.MINUS, LIFEPO4.PLUS, R65.2, R73.P$1 (1), U$5.P$1 (S1)
LIFE_B2: C26.1, SW2.P$5 (OUT), SW2.P$6 (OUT), SW2.P$7 (OUT), V27.P$1, V28.P$1
unnamed: R63.1, R64.2, U6.P$6 (MPPT)
unnamed: R69.1, U6.P$13 (PROG)
unnamed: R70.1, U6.P$11 (FBG)
unnamed: R70.2, R71.1, U6.P$10 (FB)
unnamed: C19.2, U6.P$1 (INTVCC)
unnamed: C20.1, L4.P$2, U6.P$4 (SW)
unnamed: C20.2, U6.P$2 (BOOST)
unnamed: L4.P$1, U6.P$8 (CHGSNS)
unnamed: R72.P$1 (1), U$5.P$7 (D1), U$5.P$8 (D1)
unnamed: R73.P$2 (2), U$5.P$5 (D2), U$5.P$6 (D2)
unnamed: R76.2, R82.2, SW2.P$3 (ISNS)
unnamed: C28.2, R80.2, R81.2, SW2.P$2 (CNTRL)
SP_OUT: C21.2, R63.2, U6.P$3 (IN); also elsewhere on the board

Notes on the sheet:
LiFePO4 Bank 2 Charging
External Pull-downs
Dual Protected NMOS for balancing

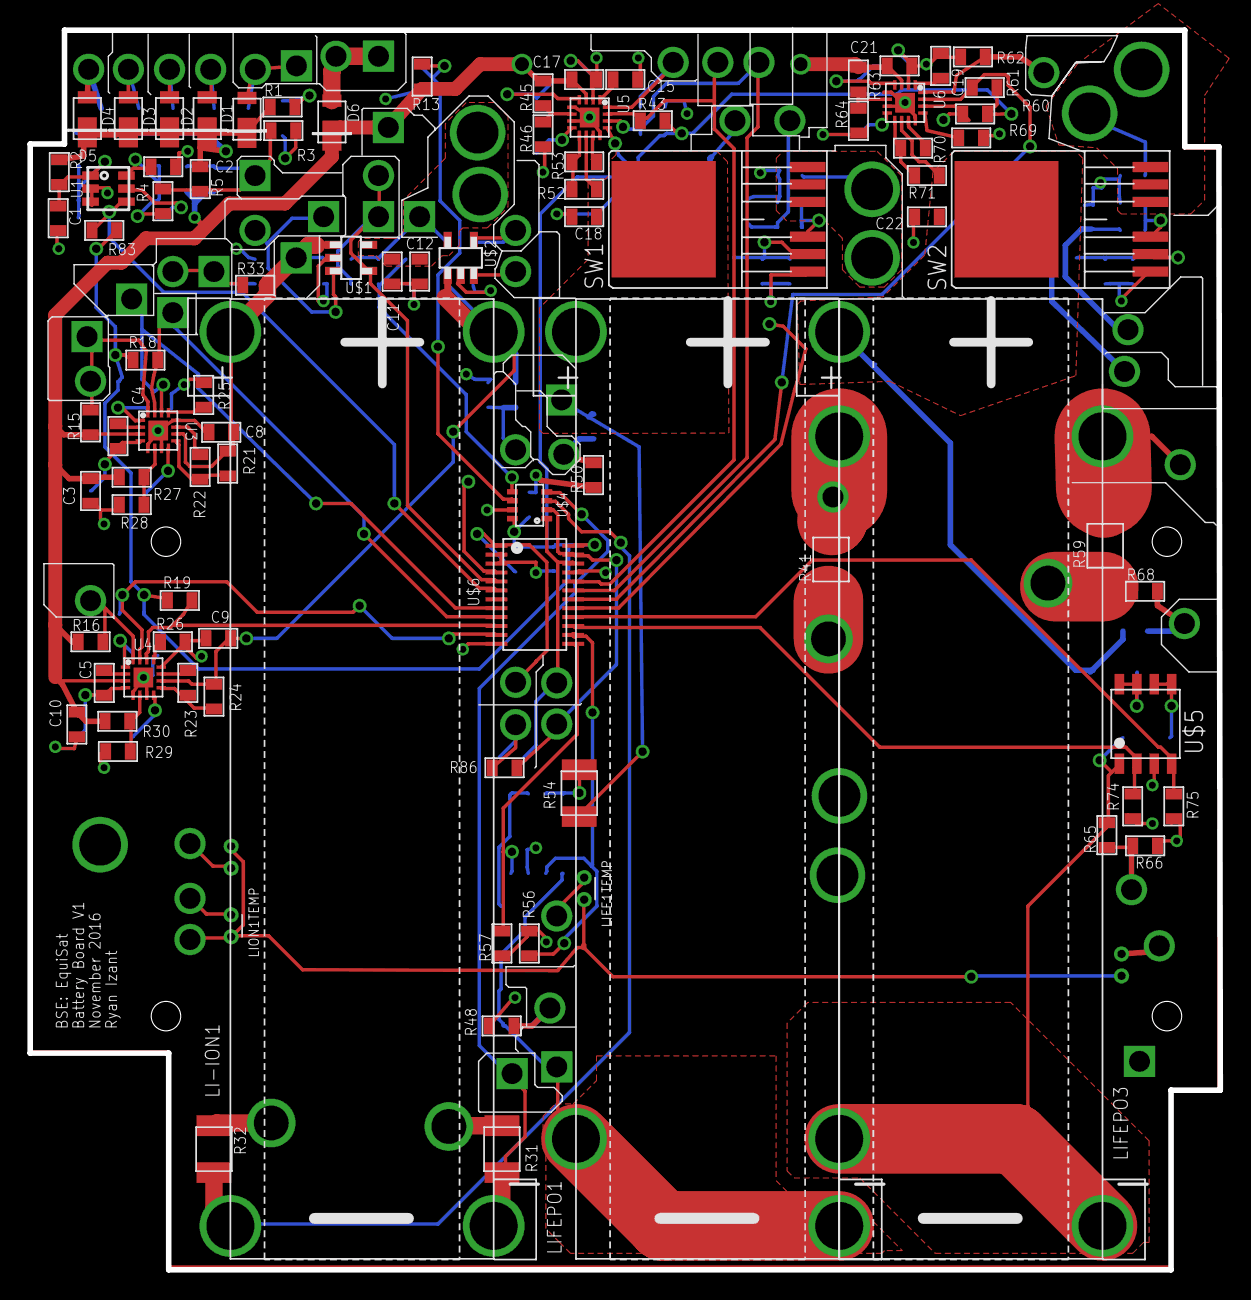
[picture p166: board BatteryBoardV1.brd from above]

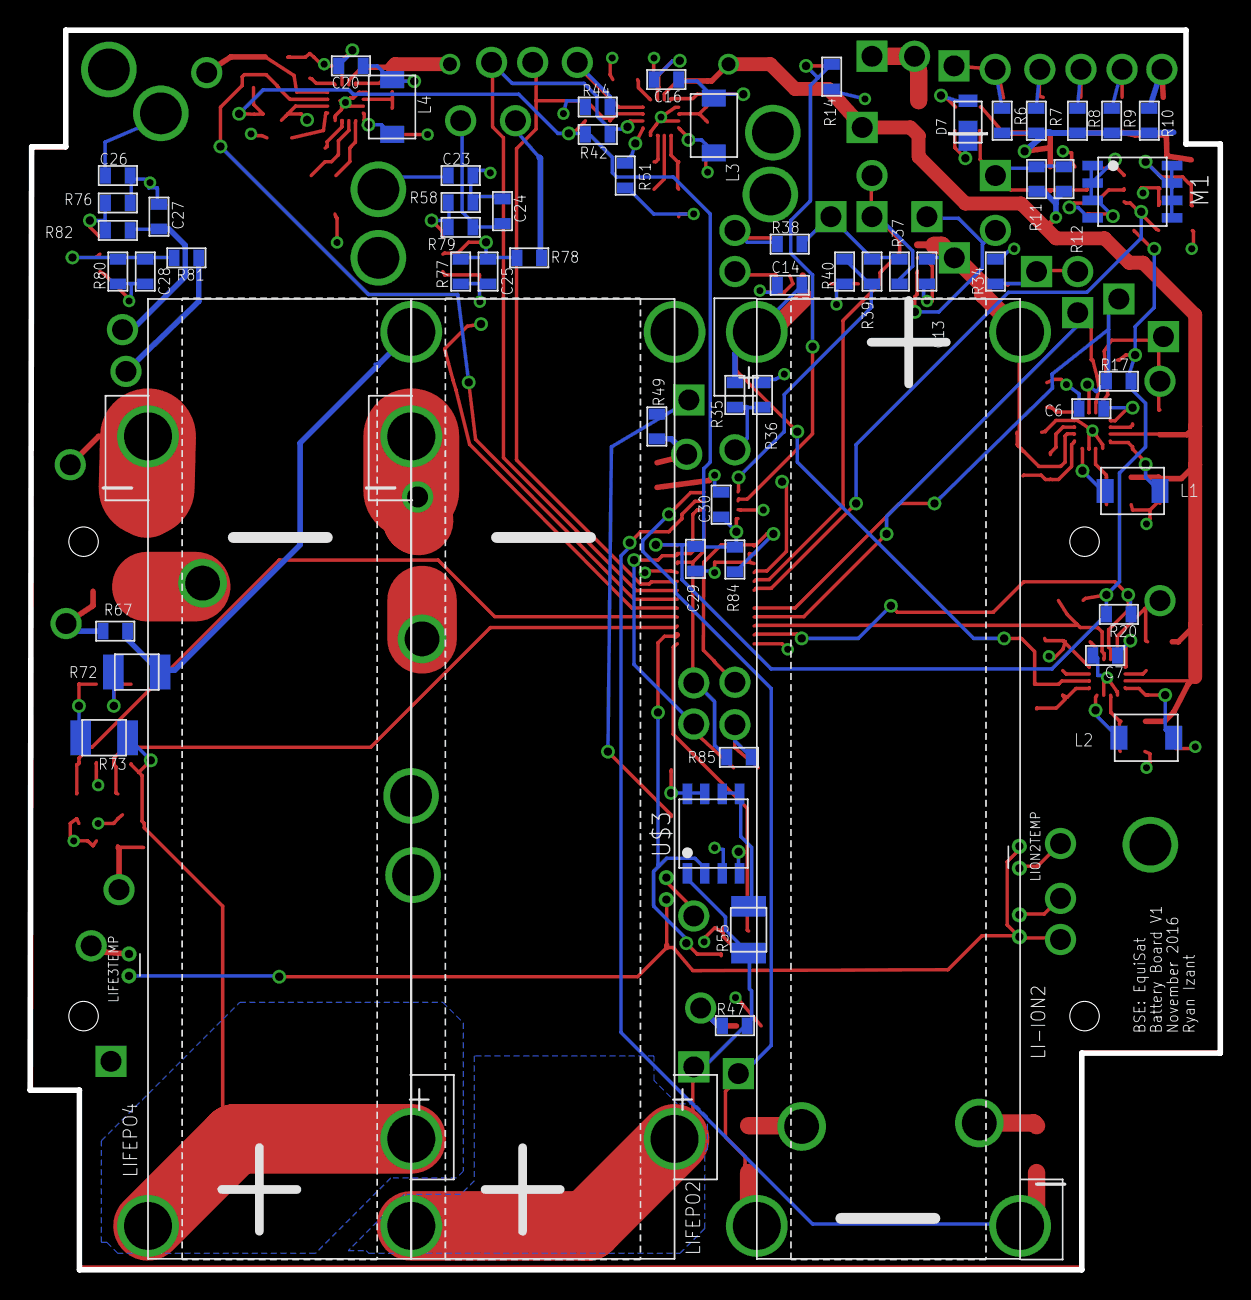
[picture p167: board BatteryBoardV1.brd from below]

Board: 4 copper layers, 86.8 x 90.4 mm, 213 parts (62 on the bottom side), 110 nets.
