BrownSpaceEngineering/EquiSat-EAGLE/projects/PracticeBoard/PracticeBoardV1.sch

## EAGLE design projects/PracticeBoard/PracticeBoardV1.sch (2017-08-31)

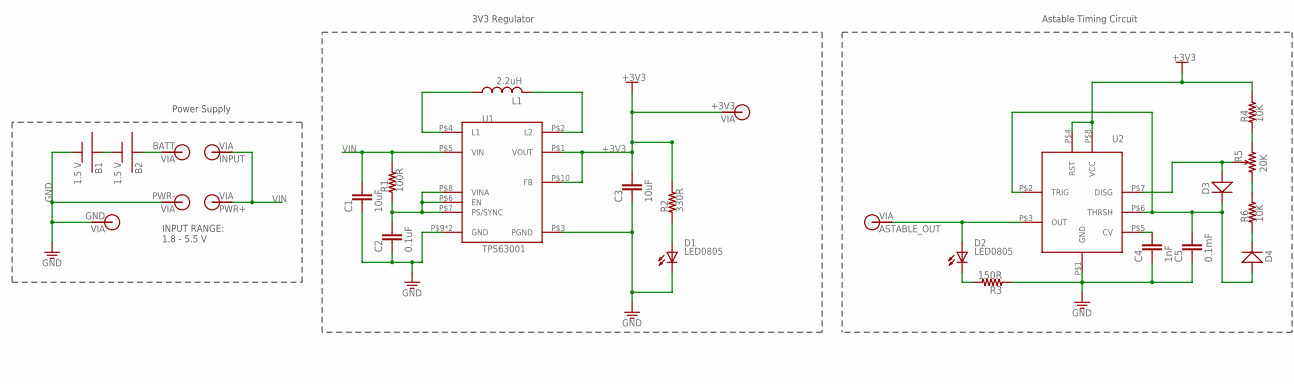
[picture p168: schematic PracticeBoardV1.sch, part in row 1, column 1]

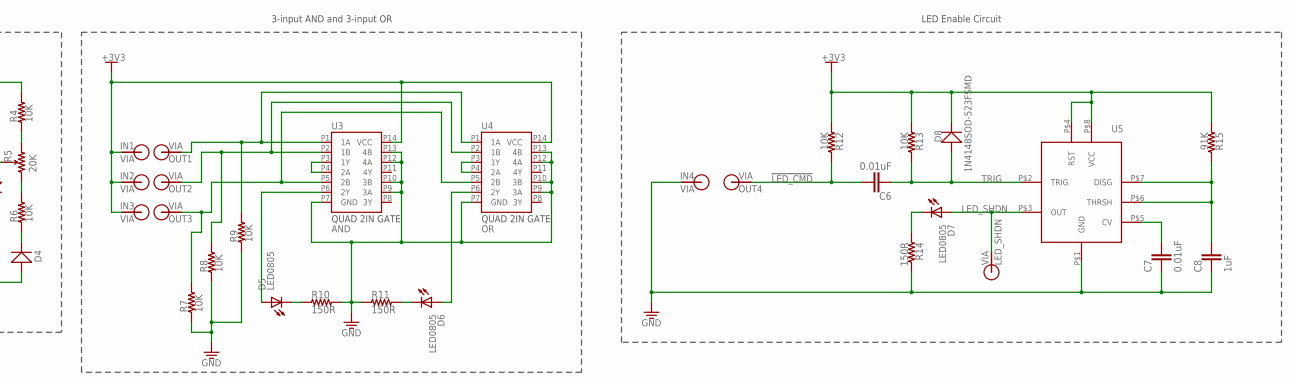
[picture p169: schematic PracticeBoardV1.sch, part in row 1, column 2]

Parts:
B1, B2: 1.5 V; BCAAPC-BATT-HOLDER
C1, C3: 10uF; 0805
C2: 0.1uF; 0805
C4: 1nF; 0805
C5: 0.1mF; 0805
C6, C7: 0.01uF; 0805
C8: 1uF; 0805
D1, D2, D5, D6, D7: LED0805; 0805-D
D3, D4: 1N4148THRU-HOLE; 1N4148
D8: 1N4148SOD-523FSMD; SOD-523F
L1: 2.2uH; L3225M
R1: 100R; 0805
R2: 330R; 0805
R3, R10, R11, R14: 150R; 0805
R4, R6, R7, R8, R9, R12, R13: 10K; 0805
R5: 20K; P160KN
R15: 91K; 0805
U1: TPS63001; QFN10_POWERPAD
U2, U5: TLC555; SO-8
U3: AND; VQFN-14
U4: OR; TSSOP-14
V1: BATT; VIA-60MIL-SQ
V2: PWR-; VIA-60MIL-SQ
V3: INPUT; VIA-60MIL-SQ
V4: PWR+; VIA-60MIL-SQ
V5: +3V3; VIA-60MIL-SQ
V6: ASTABLE_OUT; VIA-60MIL-SQ
V7: IN1; VIA-60MIL-SQ
V8: IN2; VIA-60MIL-SQ
V9: IN3; VIA-60MIL-SQ
V10: OUT1; VIA-60MIL-SQ
V11: OUT2; VIA-60MIL-SQ
V12: OUT3; VIA-60MIL-SQ
V13: IN4; VIA-60MIL-SQ
V14: OUT4; VIA-60MIL-SQ
V15: LED_SHDN; VIA-60MIL-SQ
V16: GND; VIA-60MIL-SQ

Connections:
!LED_CMD!: C6.1, R12.2, V14.P$1
+3V3: C3.1, D8.C, R2.2, R4.2, R12.1, R13.1, R15.1, U1.P$1 (VOUT), U1.P$10 (FB), U2.P$4 (RST), U2.P$8 (VCC), U3.P14 (VCC), U4.P14 (VCC), U5.P$4 (RST), U5.P$8 (VCC), V5.P$1, V7.P$1, V8.P$1, V9.P$1
ASTABLE_OUT: D2.A, U2.P$3 (OUT), V6.P$1
GND: B1.MINUS, C1.2, C2.2, C3.2, C4.2, C5.2, C7.2, C8.2, D1.C, R3.1, R7.1, R8.1, R9.1, R10.2, R11.1, R14.2, U1.P$3 (PGND), U1.P$9 (GND), U2.P$1 (GND), U3.P7 (GND), U3.P9 (3A), U3.P10 (3B), U3.P12 (4A), U3.P13 (4B), U4.P7 (GND), U4.P9 (3A), U4.P10 (3B), U4.P12 (4A), U4.P13 (4B), U5.P$1 (GND), V2.P$1, V13.P$1, V16.P$1
LED_SHDN: D7.A, U5.P$3 (OUT), V15.P$1
unnamed: B1.PLUS, B2.MINUS
unnamed: C4.1, U2.P$5 (CV)
unnamed: C5.1, D3.C, D4.A, U2.P$2 (TRIG), U2.P$6 (THRSH)
unnamed: D5.C, R10.1
unnamed: L1.1, U1.P$4 (L1)
unnamed: L1.2, U1.P$2 (L2)
unnamed: R4.1, R5.P2 (2)
unnamed: D6.C, R11.2
unnamed: C2.1, R1.1, U1.P$6 (EN), U1.P$7 (PS/SYNC), U1.P$8 (VINA)
unnamed: R9.2, U3.P1 (1A), U4.P1 (1A), V10.P$1
unnamed: R8.2, U3.P2 (1B), U4.P2 (1B), V11.P$1
unnamed: R7.2, U3.P5 (2B), U4.P5 (2B), V12.P$1
unnamed: U4.P3 (1Y), U4.P4 (2A)
unnamed: U3.P3 (1Y), U3.P4 (2A)
unnamed: B2.PLUS, V1.P$1
unnamed: D3.A, R5.P3, U2.P$7 (DISG)
unnamed: R5.P1 (1), R6.2
unnamed: D7.C, R14.1
unnamed: C8.1, R15.2, U5.P$6 (THRSH), U5.P$7 (DISG)
unnamed: D5.A, U3.P6 (2Y)
unnamed: D2.C, R3.2
unnamed: C7.1, U5.P$5 (CV)
unnamed: D6.A, U4.P6 (2Y)
unnamed: D4.C, R6.1
unnamed: D1.A, R2.1
TRIG: C6.2, D8.A, R13.2, U5.P$2 (TRIG)
VIN: C1.1, R1.2, U1.P$5 (VIN), V3.P$1, V4.P$1

Notes on the sheet:
3V3 Regulator
Astable Timing Circuit
3-input AND and 3-input OR
LED Enable Circuit
Power Supply
INPUT RANGE: 1.8 - 5.5 V
