BrownSpaceEngineering/EquiSat-EAGLE/projects/RadioAdapterBoard/RadioAdapterBoardV4_0.sch

## EAGLE design projects/RadioAdapterBoard/RadioAdapterBoardV4_0.sch (2016-12-11)

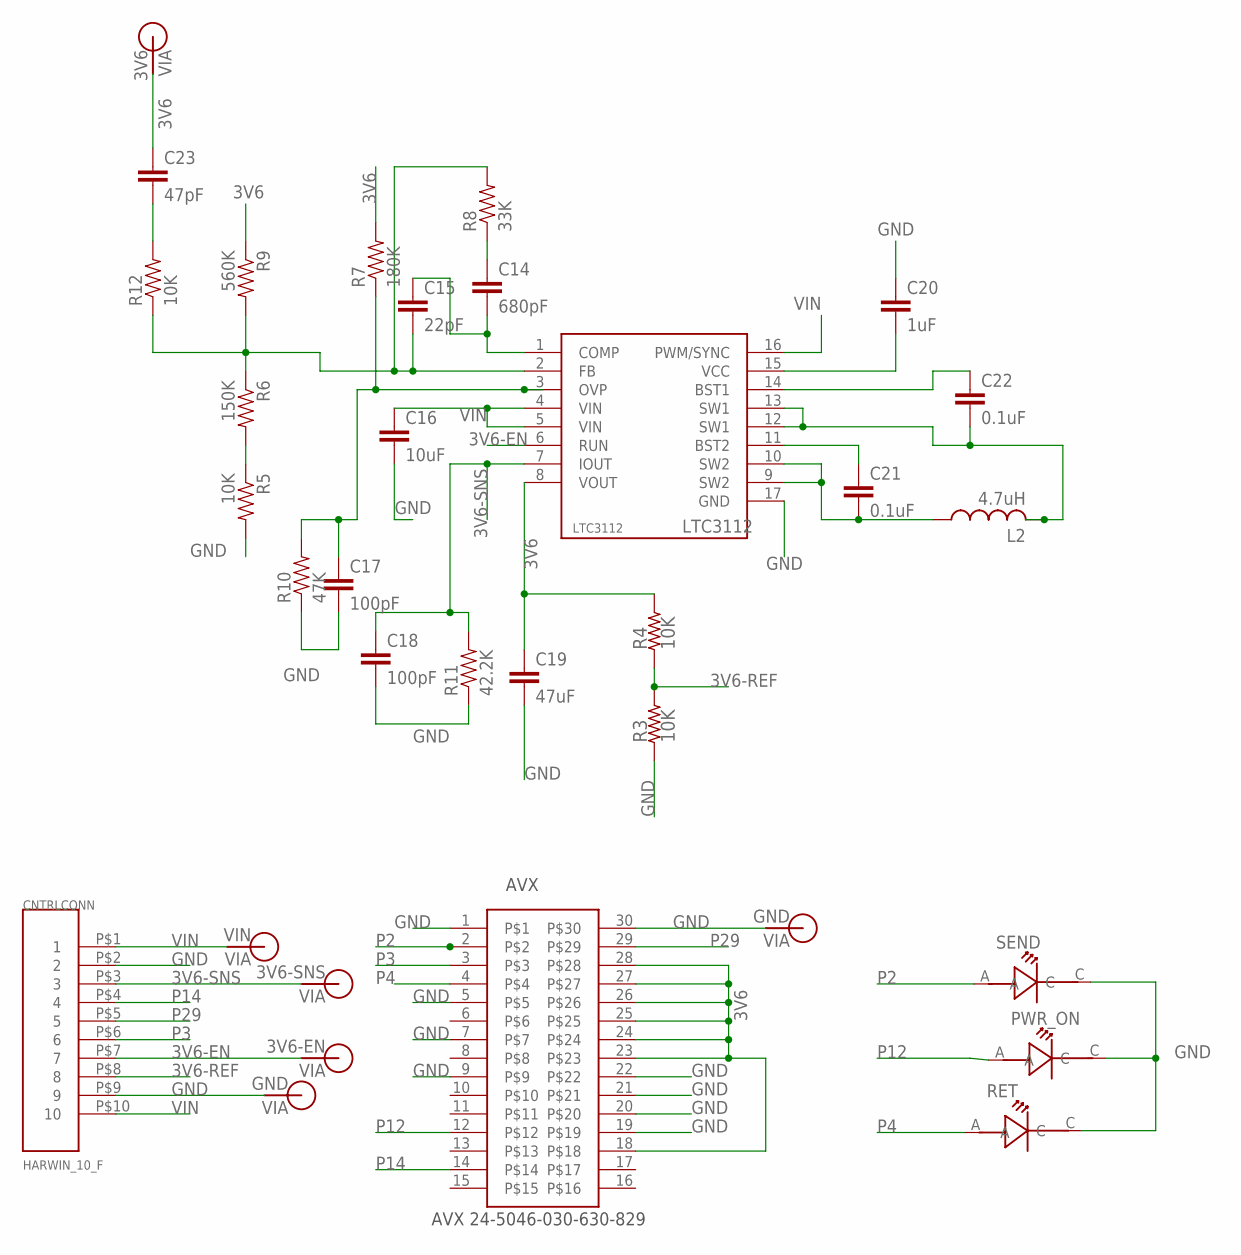
[picture p170: schematic RadioAdapterBoardV4_0.sch]

Parts:
AVX: AVX-24-5046-030-630-829; AVX-24-5046-630-829
C14: 680pF; 0805
C15: 22pF; 0805
C16: 10uF; 0805
C17, C18: 100pF; 0805
C19: 47uF; 0805
C20: 1uF; 0805
C21, C22: 0.1uF; 0805
C23: 47pF; 0805
CNTRLCONN: HARWIN_10_F; HARWIN_DATAMATE_10_F
L2: 4.7uH; L3225M
LTC3112: LTC3112; DHD16
PWR_ON: LT-T673-Q1R2-25-Z; PLCC-2
R3, R4, R5, R12: 10K; 0805
R6: 150K; 0805
R7: 180K; 0805
R8: 33K; 0805
R9: 560K; 0805
R10: 47K; 0805
R11: 42.2K; 0805
RET: LT-T673-Q1R2-25-Z; PLCC-2
SEND: LT-T673-Q1R2-25-Z; PLCC-2
V1: VIN; VIA-60MIL-SQ
V2: 3V6-SNS; VIA-60MIL-SQ
V3, V4: GND; VIA-60MIL-SQ
V5: 3V6; VIA-60MIL-SQ
V6: 3V6-EN; VIA-60MIL-SQ

Connections:
3V6: AVX.18, AVX.23, AVX.24, AVX.25, AVX.26, AVX.27, AVX.28, C19.1, C23.1, LTC3112.8 (VOUT), R4.2, R7.2, R9.1, V5.P$1
3V6-EN: CNTRLCONN.P$7 (7), LTC3112.6 (RUN), V6.P$1
3V6-REF: CNTRLCONN.P$8 (8), R3.2, R4.1
3V6-SNS: C18.1, CNTRLCONN.P$3 (3), LTC3112.7 (IOUT), R11.2, V2.P$1
COMP: C14.2, C15.1, LTC3112.1 (COMP)
FB: C15.2, LTC3112.2 (FB), R6.1, R8.2, R9.2, R12.1
GND: AVX.1, AVX.5, AVX.7, AVX.9, AVX.19, AVX.20, AVX.21, AVX.22, AVX.30, C16.2, C17.2, C18.2, C19.2, C20.1, CNTRLCONN.P$2 (2), CNTRLCONN.P$9 (9), LTC3112.17 (GND), PWR_ON.C, R3.1, R5.2, R10.1, R11.1, RET.C, SEND.C, V3.P$1, V4.P$1
unnamed: C14.1, R8.1
unnamed: C23.2, R12.2
unnamed: R5.1, R6.2
unnamed: C20.2, LTC3112.15 (VCC)
unnamed: C22.1, LTC3112.14 (BST1)
unnamed: C22.2, L2.2, LTC3112.12 (SW1), LTC3112.13 (SW1)
unnamed: C21.2, L2.1, LTC3112.9 (SW2), LTC3112.10 (SW2)
unnamed: C21.1, LTC3112.11 (BST2)
OVP: C17.1, LTC3112.3 (OVP), R7.1, R10.2
P2: AVX.2, SEND.A
P3: AVX.3, CNTRLCONN.P$6 (6)
P4: AVX.4, RET.A
P12: AVX.12, PWR_ON.A
P14: AVX.14, CNTRLCONN.P$4 (4)
P29: AVX.29, CNTRLCONN.P$5 (5)
VIN: C16.1, CNTRLCONN.P$1 (1), CNTRLCONN.P$10 (10), LTC3112.4 (VIN), LTC3112.5 (VIN), LTC3112.16 (PWM/SYNC), V1.P$1
