BrownSpaceEngineering/EquiSat-EAGLE/projects/SolarPanels/ABF Panel/ABFPanelV1.sch

## EAGLE design projects/SolarPanels/ABF Panel/ABFPanelV1.sch (2017-08-15)

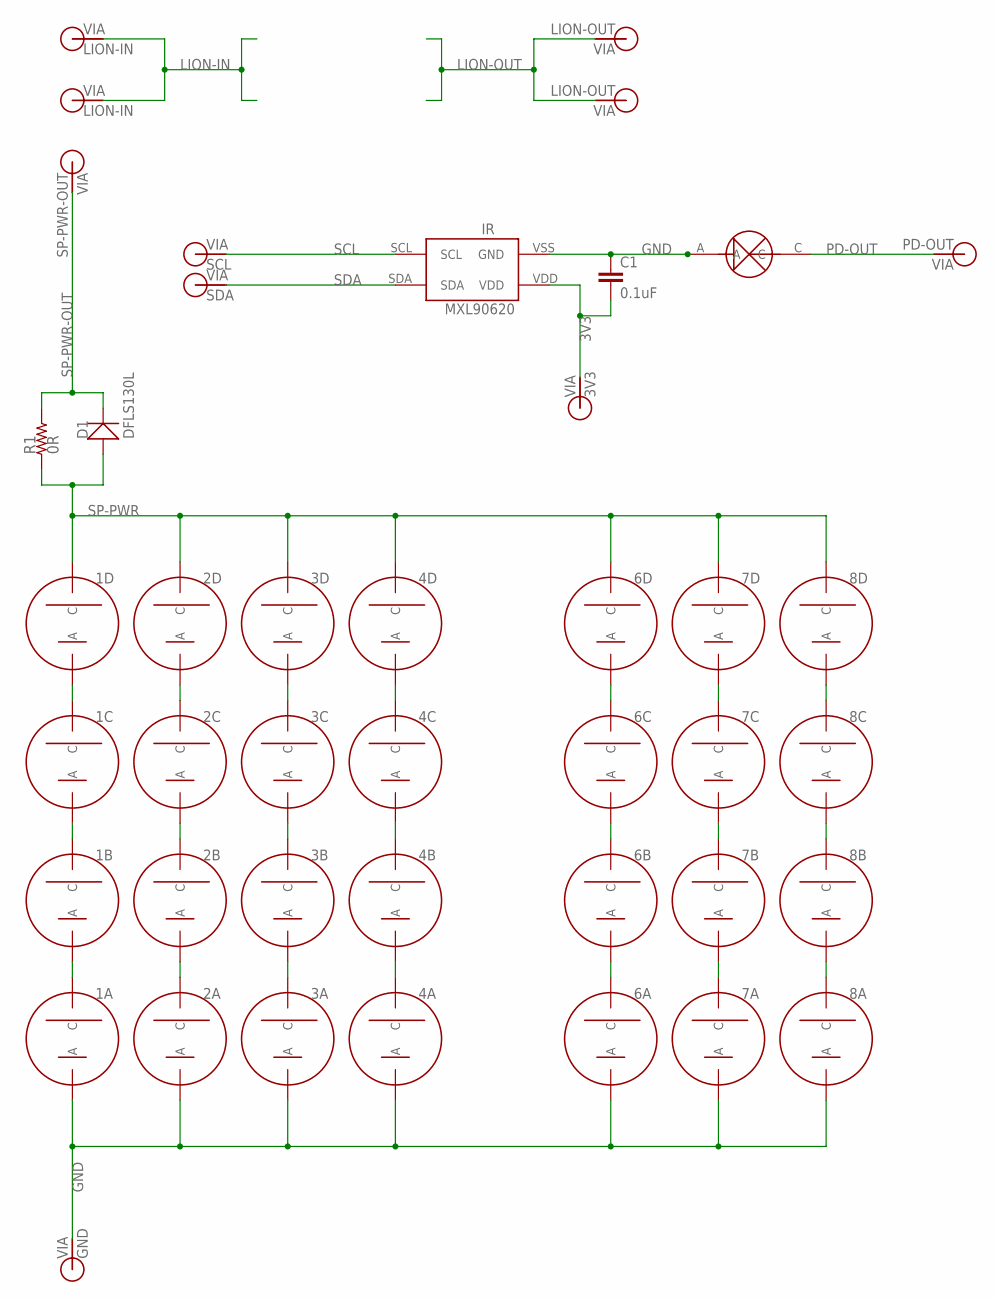
[picture p171: schematic ABFPanelV1.sch]

Parts:
1A, 1B, 1C, 1D, 2A, 2B, 2C, 2D, 3A, 3B, 3C, 3D, 4A, 4B, 4C, 4D, 6A, 6B, 6C, 6D, 7A, 7B, 7C, 7D, 8A, 8B, 8C, 8D: SOLARCELLV3; TRISOLX-V3
3V3: 3V3; VIA-60MIL
C1: 0.1uF; 0805
D1: DFLS130L; PWRDI-123
GND: GND; VIA-60MIL
IR: MXL90620
PD: PHOTODETECTOR; PHOTODECTORDEVICE2
PD-OUT: PD-OUT; VIA-60MIL
PWR-OUT: SP-PWR-OUT; VIA-60MIL
R1: 0R; 1210
SCL: SCL; VIA-60MIL
SDA: SDA; VIA-60MIL
V1, V2: LION-IN; VIA-60MIL
V3, V4: LION-OUT; VIA-60MIL

Connections:
3V3: 3V3.P$1, C1.2, IR.VDD
GND: 1A.ANODE (A), 2A.ANODE (A), 3A.ANODE (A), 4A.ANODE (A), 6A.ANODE (A), 7A.ANODE (A), 8A.ANODE (A), C1.1, GND.P$1, IR.VSS (GND), PD.A
LION-IN: V1.P$1, V2.P$1
LION-OUT: V3.P$1, V4.P$1
unnamed: 2C.CATHODE (C), 2D.ANODE (A)
unnamed: 1C.CATHODE (C), 1D.ANODE (A)
unnamed: 1B.CATHODE (C), 1C.ANODE (A)
unnamed: 1A.CATHODE (C), 1B.ANODE (A)
unnamed: 2B.CATHODE (C), 2C.ANODE (A)
unnamed: 2A.CATHODE (C), 2B.ANODE (A)
unnamed: 3C.CATHODE (C), 3D.ANODE (A)
unnamed: 3B.CATHODE (C), 3C.ANODE (A)
unnamed: 3A.CATHODE (C), 3B.ANODE (A)
unnamed: 4C.CATHODE (C), 4D.ANODE (A)
unnamed: 4B.CATHODE (C), 4C.ANODE (A)
unnamed: 4A.CATHODE (C), 4B.ANODE (A)
unnamed: 6C.CATHODE (C), 6D.ANODE (A)
unnamed: 6B.CATHODE (C), 6C.ANODE (A)
unnamed: 6A.CATHODE (C), 6B.ANODE (A)
unnamed: 7C.CATHODE (C), 7D.ANODE (A)
unnamed: 7B.CATHODE (C), 7C.ANODE (A)
unnamed: 7A.CATHODE (C), 7B.ANODE (A)
unnamed: 8C.CATHODE (C), 8D.ANODE (A)
unnamed: 8B.CATHODE (C), 8C.ANODE (A)
unnamed: 8A.CATHODE (C), 8B.ANODE (A)
PD-OUT: PD.C, PD-OUT.P$1
SCL: IR.SCL, SCL.P$1
SDA: IR.SDA, SDA.P$1
SP-PWR: 1D.CATHODE (C), 2D.CATHODE (C), 3D.CATHODE (C), 4D.CATHODE (C), 6D.CATHODE (C), 7D.CATHODE (C), 8D.CATHODE (C), D1.A, R1.P$1 (1)
SP-PWR-OUT: D1.C, PWR-OUT.P$1, R1.P$2 (2)
