BrownSpaceEngineering/EquiSat-EAGLE/(commit log)

2016-07-10 Initial commit of existing EquiSat EAGLE files
    [3518-eagle.sch, 3518.sch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]
2016-09-02 added side solar panel
    [ProcessorTestBoardV1_0_TEST.brd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]
2016-09-03 Added top panel v4
    [SIDEPANEL-V4.brd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]
2016-09-03 Touched up top and side panels
    [TopPanel-V4.brd]
2016-09-03 touched up side and top panels
    [TopPanel-V4.brd]
2016-09-07 Updated with processor test board V2
    [CntrlBoardV2_0.brd, CntrlBoardV2_0.sch, FlashPanelV6_2.brd, FlashPanelV6_2.sch, LEDDriverBoardV1.1.brd, ProcessorTestBoardV2.brd, ProcessorTestBoardV2.sch, SIDEPANEL-V4.brd]
2016-09-08 Top and Side Panels, Proc Test Board prepared for production
    [ProcessorTestBoardV2.brd, ProcessorTestBoardV2.sch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]
2016-10-16 Started Battery Board and fixes to library
    [ProcessorTestBoardV1_0_TEST.brd, ProcessorTestBoardV2.brd, ProcessorTestBoardV2.sch, battery_board.sch]
2016-10-16 added new library
    [BatteryBoardV1.sch, OLDbattery_board.sch]
2016-10-27 Added 3V6-SNS, 3V6-EN, 3V6-REF to Radio Adapter Board
    [RadioAdapterBoardV4_0.brd, RadioAdapterBoardV4_0.sch]
2016-10-27 Added LTC3112 to Radio Adaptor Board
    [RadioAdapterBoardV4_0.brd, RadioAdapterBoardV4_0.sch]
2016-10-27 Changes to Radio Adapter Board V4
    Moved LEDs to Radio Adapter Board
    Flipped the connection to the radio so the radio is pointing into the
    board
    [RadioAdapterBoardV4_0.brd, RadioAdapterBoardV4_0.sch]
2016-10-30 changes to Radio Adapter Board V4
    Added the connections to LTC3112
    [RadioAdapterBoardV4_0.brd, RadioAdapterBoardV4_0.sch]
2016-10-30 Changes to Radio Adapter Board v4
    In process of reordering physical components.
    [RadioAdapterBoardV4_0.brd]
2016-10-30 Changes to Radio Adapter Board
    In Process of Optimizing the Physical Layout
    [RadioAdapterBoardV4_0.brd]
2016-11-03 Radio Adaptor Board Minor Updates
    [RadioAdapterBoardV4_0.brd]
2016-11-04 Updates to Battery charging solar panel front end and start of charging schematics. Updates to BSE library
    [BatteryBoardV1.sch]
2016-11-05 Battery Board Li-Ion charging circuit finished.
    [BatteryBoardV1.sch]
2016-11-05 Li-ion batteries added to battery charging
    [BatteryBoardV1.sch]
2016-11-05 Added Battery Board Li-Ion Diode ORing and began LiFePO4 charging circuitry
    [BatteryBoardV1.sch]
2016-11-06 Continued work on LiFePO4 charging and library updates
    [BatteryBoardV1.sch]
2016-11-06 Updates to the Radio Adapter Board
    [RadioAdapterBoardV4_0.brd, RadioAdapterBoardV4_0.sch]
2016-11-07 Some minor updates
    [BatteryBoardV1.sch]
2016-11-13 small edit
    [RadioAdapterBoardV4_0.brd]
2016-11-13 Radio Control Board Preliminary Wiring Completed
    [RadioAdapterBoardV4_0.brd]
2016-11-13 Fixed Radio Adaptor Board
    [RadioAdapterBoardV4_0.brd]
2016-11-14 LiFePO4 Balancing added
    [BatteryBoardV1.sch, CntrlBoardV2_0.brd, CntrlBoardV2_0.sch]
2016-11-17 Radio Adapter Board Design in Progress
    Still working on routing
2016-11-17 added usb 24 pin connector part
2016-11-18 Fixed access panel connector and updated libraires
    [FlashPanelV6_2.brd]
2016-11-20 Small updates to Flash Panel V6.2
    [FlashPanelV6_2.brd, FlashPanelV6_2.sch]
2016-11-20 Radio Adapter Board Layout Almost Done
    [RadioAdapterBoardV4_0.brd]
2016-11-20 Small Updates to Battery Board and BSE library
    [BatteryBoardV1.sch]
2016-11-20 Started updating Driver Board, made V1.2
    [LEDDriverBoardV1.2.brd, LEDDriverBoardV1.2.sch]
2016-11-22 Cleaned up Git tracked files. Changes/additions to libraries. Addition of missing LED library part. Began Battery Board layout.
    [BatteryBoardV1.brd, BatteryBoardV1.sch, FlashPanelV6_2.brd, FlashPanelV6_2.sch, RadioAdapterBoardV4_0.brd, RadioAdapterBoardV4_0.sch]
2016-11-24 finished prelim Radio Adapter Board layout
2016-11-27 Nearly finished placement of battery board, continued library updates and touch ups on all active boards/schematics.
    [BatteryBoardV1.brd, BatteryBoardV1.sch, LEDDriverBoardV1_1.brd, LEDDriverBoardV1_1.sch, LEDDriverBoardV1_2.brd, LEDDriverBoardV1_2.sch]
2016-11-28 Finished Battery Board layout and first draft of routing. Ready for final review. Additional library updates.
    [BatteryBoardV1.brd, BatteryBoardV1.sch]
2016-11-28 Polishing up Battery Board layout
    [BatteryBoardV1.brd, BatteryBoardV1.sch]
2016-11-28 Finished second round of Battery Board Layout
    [BatteryBoardV1.brd, BatteryBoardV1.sch]
2016-11-29 Small fixes to Battery Board Layout
    [BatteryBoardV1.brd, BatteryBoardV1.sch]
2016-11-29 Fixed shaped of Battery Board, additional layout fixes for DFM.
    [BatteryBoardV1.brd]
2016-11-30 Finalized Battery Board - board has been ordered.
    [BatteryBoardV1.brd, BatteryBoardV1.sch]
2016-12-01 Updates to driverboard and driverboard library
    [LEDDriverBoardV1.2.brd, LEDDriverBoardV1.2.sch]
2016-12-01 Radio Adapter Board V4 Remix
    WIP
    [RadioAdapterBoardV4_0.brd]
2016-12-01 Small updates to driverboard lib
2016-12-04 Worked on updating Driver Board,e V1.2
    [LEDDriverBoardV1_2.brd, LEDDriverBoardV1_2.sch]
2016-12-04 started updating flash panel V6.2
    [FlashPanelV6_2.brd]
2016-12-04 began updating flash panel V6.2
    [LEDDriverBoardV1_2.brd, LEDDriverBoardV1_2.sch]
2016-12-04 Added connector to driverboard lib
2016-12-04 Finished Radio Adapter Board V4 Layout
    Requires checking
    [RadioAdapterBoardV4_0.brd]
2016-12-08 Revert to 34566699e3a693507405c41ff6389c8b0b8f54b4
    [LEDDriverBoardV1_2.sch, RadioAdapterBoardV4_0.brd]
2016-12-08 added archive files
    [EngineeringModelBoard(6_2015).GBL, EngineeringModelBoard(6_2015).GBO, EngineeringModelBoard(6_2015).GBS, EngineeringModelBoard(6_2015).GTL, EngineeringModelBoard(6_2015).GTO, EngineeringModelBoard(6_2015).GTP, EngineeringModelBoard(6_2015).GTS]
2016-12-08 Deleted problematic files
    [EngineeringModelBoard(6_2015).GBL, EngineeringModelBoard(6_2015).GBO, EngineeringModelBoard(6_2015).GBS, EngineeringModelBoard(6_2015).GTL, EngineeringModelBoard(6_2015).GTO, EngineeringModelBoard(6_2015).GTP, EngineeringModelBoard(6_2015).GTS]
2016-12-08 Deleted more problematic files
    [EngineeringModelBoard(6:2015).brd, EngineeringModelBoard(6:2015).sch]
2016-12-11 Finished RAB Layout . . . again
    Needs to be checked by Ryan!!
    Labels might need to be moved around.
    [RadioAdapterBoardV4_0.brd]
2016-12-11 Moving toward final RAB PCB
    Working on Labels
    Need Gerber, etc.
    [RadioAdapterBoardV4_0.brd, RadioAdapterBoardV4_0.sch]
2016-12-12 Radio Adapter Board PCB Ready
    Also, minor edits to 0805 package, L3255M package, and job
    sfe-ger274x.cam
    [RadioAdapterBoardV4.brd, RadioAdapterBoardV4.sch]
2016-12-20 Initial Commit of Equisat Simulator
    [EquisatSimulatorV1.sch]
2017-01-12 Completion of AccessPanelV3 and updates to libraries. Renamed SidePanelV4 to match standard.
    [AccessPanelV3.brd, AccessPanelV3.sch, SIDEPANELV4.brd, SIDEPANELV4.sch]
2017-01-12 Actual commit with library changes and renaming
    [SIDEPANEL-V4.brd, SIDEPANEL-V4.sch]
2017-01-23 Updates to Radio Adapter Board, Driver Board, Flash Panel. Somebody forgot to commit for a whole week or so....
    [AccessPanelV3.brd, FlashPanelV6_2.brd, FlashPanelV6_2.sch, LEDDriverBoardV1_2.brd, LEDDriverBoardV1_2.sch, RadioAdapterBoardV4.brd, RadioAdapterBoardV4.sch]
2017-01-29 Bill of Materials text for Access Panel V3
2017-01-29 Removed txt document and some continued Flash and Driver board updates.
    [LEDDriverBoardV1_2.brd, LEDDriverBoardV1_2.sch]
2017-02-05 Cleaning up RABV4 Schematic
2017-02-09 Completed all changes to Flash Panel and Driver Board. Additional library changes and additions for antenna deployment detection circuitry.
    [AccessPanelV3.brd, AccessPanelV3.sch, FlashPanelV6_2.brd, FlashPanelV6_2.sch, LEDDriverBoardV1_2.brd, LEDDriverBoardV1_2.sch]
2017-02-09 Initial commit of Control Board V3 and library updates to support that.
    [CntrlBoardV3.sch, ProcessorTestBoardV2.sch]
2017-02-12 Continued Control Board and library updates.
    [CntrlBoardV3.sch]
2017-02-13 Finalized Flash Panel and Driver Board
    [FlashPanelV6_2.brd, LEDDriverBoardV1_2.brd]
2017-02-14 Added in the pcb borders to flash panel and driver board for fab.
    [FlashPanelV6_2.brd, LEDDriverBoardV1_2.brd]
2017-02-16 Added external memories and library updates.
    [CntrlBoardV3.sch, LEDDriverBoardV1_2.brd]
2017-02-21 Continued Control Board Updates and library updates. Added Multiplexers, Opamps, Diodes, multiplexing circuitry, instrumentation circuitry, and remote ADC.
    [CntrlBoardV3.sch]
2017-02-21 Added photodiode instrumentation circuit
    [CntrlBoardV3.sch]
2017-02-26 Finished control board schematic. Completed preliminary component layout and board dimensions. Also includes library updates to support added components and connectors.
    [CntrlBoardV3.brd, CntrlBoardV3.sch]
2017-02-26 Completed first round of cntrl board placement for all components.
    [CntrlBoardV3.brd, CntrlBoardV3.sch]
2017-02-27 Continued work on Control Board layout - modification of some connector types and connector pinouts to optimize routing, initial power and ground routing.
    [CntrlBoardV3.brd, CntrlBoardV3.sch]
2017-02-27 Continued routing of Control Board.
    [CntrlBoardV3.brd, CntrlBoardV3.sch]
2017-02-27 Completed first round of Control Board routing and silkscreen marker placement. Gonna sleep on it and see how I like it in the morning.
    [CntrlBoardV3.brd, CntrlBoardV3.sch]
2017-02-27 Added test vias and LEDs for testing and monitoring. Cleaned up asthetics and added documentation on silkscreen
    [CntrlBoardV3.brd, CntrlBoardV3.sch]
2017-02-27 Cleaned up a few small things and corrected for errors discovered in DRC check.
    [CntrlBoardV3.brd]
2017-02-28 Fixed problem with processor pin mapping, rerouted accordingly. Final adjustments for production. Ready to order.
    [CntrlBoardV3.brd, CntrlBoardV3.sch]
2017-02-28 Forgot to give values to 3 resistors. Doesn't impact board at all - just BOM
    [CntrlBoardV3.brd, CntrlBoardV3.sch]
2017-04-09 Side Panel V5
    [SIDEPANELV5.brd, SIDEPANELV5.sch]
2017-05-12 Programmer Board
    V1
    [ProgrammerBoardV1.brd, ProgrammerBoardV1.sch]
2017-05-12 V1
    fixed a wire
    [ProgrammerBoardV1.brd]
2017-07-07 Programmer Board V1.1
    [ProgrammerBoardV1_1.brd, ProgrammerBoardV1_1.sch]
2017-07-16 Battery Test Board V1
    For Ryan to have a look at when he can
    [BatteryTestBoard V1.sch]
2017-07-23 moved connector + rearranged vias
    USB connector now as close to edge as possible, vias arranged so
    grounds are more spread out and board is more compact
    [ProgrammerBoardV1_1.brd]
2017-07-25 added protection circuit AP9211
2017-07-25 Adding circuitry
    LT4121.42 correctly wired, vias properly connected, added AP9211
    [BatteryTestBoard V1.sch]
2017-07-26 adding AD8418 current sense amp
2017-07-26 Adding more circuitry
    Fixed Li-ion protection circuit
    Added option of pullup (0R) resistor to INVCC for FREQ pins, and added
    option of pulldown (10K) resistor to ground for FREQ
    Added current sense circuitry to Li-ion and Lifepo bank
    [BatteryTestBoard V1.sch]
2017-07-27 Added PTC fuse part
2017-07-27 Added finishing circuitry
    Added PTC fuses
    Added vias for all charging inputs and outputs
    [BatteryTestBoard V1.sch]
2017-07-29 Adding zener diode BZX84C7V5LT1G and fixing part names
2017-07-29 Made changes suggested by Ryan
    [BatteryTestBoard V1.sch]
2017-07-29 Different zener diode to meet current reqs
    [BatteryTestBoard V1.sch]
2017-07-29 adding zener diode SMBJ5343B-TP
2017-07-29 Cleaned up old solar panel files
    [SIDEPANEL3.2test.brd, SIDEPANEL3.2test.sch, TopPanelV4.brd, TopPanelV4.sch, toppanel2.brd, toppanel2.sch]
2017-07-30 side panel v5 WIP
    updated cells
    still figuring out cell layout
    [SIDEPANELV5(old).brd, SIDEPANELV5(old).sch]
2017-07-31 Side Panel V5 Finished (?)
    Ready to be checked
    [SIDEPANELV5(old).brd, SIDEPANELV5(old).sch, SIDEPANELV5.brd, SIDEPANELV5.sch]
2017-08-01 Side Panel V5 In Review (Part Deux)
    Fixed the things Ryan commented on.
    Warning: back of via 1D will need to be taped as the board is now!
    [SIDEPANELV5.brd, SIDEPANELV5.sch]
2017-08-03 Side Panel V5 In Review (Part III)
    > Added diode and 0R resistor in parallel between the cells' output and
    PWR-OUT (this circuit is being moved from Battery Board V1).
    > Top layer is now the CELL-OUT signal.
    > Put C1 on bottom layer.
    > Moved all the vias further away from the cells.
    > Connected the corner screw holes to GND.
    > Readjusted exposed copper pads to cover chassis rails and tabs with
    ~0.5 mm extra space on all sides.
    > Shifted all components slightly left so that 1D is the only non-GND
    via that will be in contact with the chassis (and thus will need to be
    covered with insulating tape).
    > Fixed traces to come out of the cell pads perpindicularly.
    [SIDEPANELV5.brd, SIDEPANELV5.sch]
2017-08-03 LifePo separated out
    this is by no means anywhere near complete - i just put the lifepo
    stuff on one side and gave it a basic layout. any feedback is welcome
    though
    [BatteryTestBoard V1.brd]
2017-08-04 Fixed ERC issues
    ERC still complains about some power connections but I think these are
    fine
    [BatteryTestBoard V1.brd]
2017-08-04 Side Panel V5 Finished
    > Added +Z and -Z direction labels.
    [SIDEPANELV5.brd]
2017-08-06 Added battery protection circuit LC05111C13MTTTG
2017-08-06 Added LC05111C13MTTTG as an alternate to AP9211SA-AG-HAC-7
    I am still a little skeptical on the AP9211SA-AG-HAC-7’s discharge
    current limit. LC05111C13MTTTG explicitly defines it as 3A, which is a
    lot more reassuring than what the AP9211SA-AG-HAC-7 has to say about it.
    For AP9211SA-AG-HAC-7, maximum discharge current was found by
    V_overdischargelimit / R_SS(on). Gives an answer that works out with
    power limit, but it’s still weird that the maximum discharge is not
    given explicitly on data sheet (nor is the seemingly basic calculation
    mentioned)
    [BatteryTestBoard V1.sch]
2017-08-06 Lifepo layout improved a bit (nothing major this time)
    [BatteryTestBoard V1.brd]
2017-08-06 Top Panel V5 WIP
    > Copied from Access Panel V3.
    > Deleted the umbilical connector and associated vias.
    > NEEDS FINALIZED DIMENSIONS BEFORE MORE WORK CAN BE DONE
    [TopPanelV5.brd, TopPanelV5.sch]
2017-08-06 Li-ion basic layout
    Trello cards to be updated soon
    [BatteryTestBoard V1.brd, BatteryTestBoard V1.sch]
2017-08-08 about to play with the autorouter
    [ProgrammerBoardV1.brd]
2017-08-08 hand-routed high current paths
    [BatteryTestBoard V1.brd]
2017-08-08 Optimized vias, routed high current paths
    [BatteryTestBoard V1.brd, BatteryTestBoard V1.sch]
2017-08-08 Autorouted board (with islands to be fixed)
    [BatteryTestBoard V1.brd, BatteryTestBoard V1.sch]
2017-08-09 Manually routed most of board
    [BatteryTestBoard V1.brd, BatteryTestBoard V1.sch]
2017-08-09 Routed board
    [BatteryTestBoard V1.brd, BatteryTestBoard V1.sch]
2017-08-09 Silkscreen information
    [BatteryTestBoard V1.brd, BatteryTestBoard V1.sch]
2017-08-12 Incorporated majority of comments on trello card
    [BatteryTestBoard V1.brd, BatteryTestBoard V1.sch]
2017-08-13 More comments incorp.
    [BatteryTestBoard V1.brd, BatteryTestBoard V1.sch]
2017-08-14 Completed TopPanelV5 with new board dimensions and cells. Ready for rewview/fab
    [TopPanelV5.brd, TopPanelV5.sch]
2017-08-14 Initial commit of Access Panel V4 schematic and board.
    [AccessPanelV4.brd, AccessPanelV4.sch]
2017-08-14 Modified Top Panel V5 layout to optimize for wiring.
    [TopPanelV5.brd]
2017-08-14 Additional edits to Access Panel V4 layout. Just needs the access connector.
    [AccessPanelV4.brd, AccessPanelV4.sch]
2017-08-15 Edits to TopPanelV5 per Caelan's suggestions.
    [TopPanelV5.brd, TopPanelV5.sch]
2017-08-15 Added new access panel connector and completed AccessPanelV4.
    [AccessPanelV4.brd, AccessPanelV4.sch]
2017-08-15 Initial commit of ABFPanelV1 and cosmetic changes to SidePanelV5 (change square vias to circular).
    [ABFPanelV1.brd, ABFPanelV1.sch]
2017-08-15 Continued work on ABFPanelV1. Just needs final selection on ABF mechanism. Room already allocated on panel for it.
    [ABFPanelV1.brd, ABFPanelV1.sch]
2017-08-16 Giving layout another shot (Li-ion done)
    [BatteryTestBoard V1.brd, BatteryTestBoard V1.sch]
2017-08-16 Swapping pads on battery chargers per Trello card
2017-08-18 Bit of work on LifePo
    [BatteryTestBoard V1.brd, ProgrammerBoardV1.sch]
2017-08-18 Board ready for Ryan review
    [BatteryTestBoard V1.brd, BatteryTestBoard V1.sch]
2017-08-18 Board NOW ready for Ryan review
    [BatteryTestBoard V1.brd]
2017-08-19 included Ryan feedback
    [BatteryTestBoard V1.brd, BatteryTestBoard V1.sch]
2017-08-23 Incorporating Ryan comments
    [BatteryTestBoard V1.brd, BatteryTestBoard V1.sch]
2017-08-23 Better current sense routing
    [BatteryTestBoard V1.brd]
2017-08-24 Created PracticeBoardV1; removed .l# files cluttering the lib_dr folder
    > Added 3V3 regulator from ControlBoardV3 to schematic of PracticeBoardV1
    [PracticeBoardV1.brd, PracticeBoardV1.sch]
2017-08-24 Added the SN74LV04A-Hex-Inverter and corresponding package 14-TSSOP to BSE lib
    > Also worked on prepping the PracticeBoardV1 board a tiny bit
    [PracticeBoardV1.brd, PracticeBoardV1.sch]
2017-08-25 Final changes to board
    [BatteryTestBoard V1.brd]
2017-08-25 Silkscreen text vectorized
    [BatteryTestBoard V1.brd]
2017-08-25 Fixing FreeDFM clearance issues with AP9211
    [BatteryTestBoard V1.brd]
2017-08-25 Fixing some ERC
    [BatteryTestBoard V1.sch]
2017-08-26 Added coin battery holder to lib; Added astable timer and AND/OR led circuit to PracticeBoardV1
    Still need the LED enable circuit from ControlBoard ???
    [PracticeBoardV1.brd, PracticeBoardV1.sch]
2017-08-27 PracticeBoardV1 Schematic Review
    Added led enable circuit and nonfunctional components
    [PracticeBoardV1.brd, PracticeBoardV1.sch]
2017-08-28 PracticeBoardV1 Schematic Review II
    > Added thru-hole diode and potentiometer to library
    > Added via "switch" to the battery
    > Added a second battery in series (each one has end-to-end voltage of
    ~2V)
    > Removed unnecessary components
    > Fixed (?) astable timing circuit
    > Added 150R resistors in series with each LED
    [PracticeBoardV1.brd, PracticeBoardV1.sch]
2017-08-29 Added RBF switches to library. (changed ABF to RBF) Added RBF switches and routing to RBF Panel. Vectorized all text on solar panel boards and rearranged as needed.
    [AccessPanelV4.brd, RBFPanelV1.brd, RBFPanelV1.sch, SIDEPANELV5.brd, TopPanelV5.brd]
2017-08-29 PracticeBoardV1 Board Review
    Library
    > Removed the quad 2in AND gate symbol and replaced with the other
    generic quad 2in gate symbol
    > Consolidated quad 2in gates into one symbol and device with multiple
    package variants
    > Changed diode to part 1N4148; added it's thru-hole package as a
    package variant to the existing 1N4148 device (and changed the existing
    package's name to SMD)
    ControlBoardV3
    > Updated the 1N4148 diode to reflect the change in the package
    variant's name
    PracticeBoardV1
    > Minor changes to schematic
    > Board layout started and finished
    [CntrlBoardV3.sch, PracticeBoardV1.brd, PracticeBoardV1.sch]
2017-08-30 Adjusted board layout for sizing. Added notes to silkscreen for ease of operation. Removed bottom silkscreen. Added 10k pull-down resistors to logic inputs.
    [PracticeBoardV1.brd, PracticeBoardV1.sch]
2017-08-30 Added keepout zones on battery part package. Update libraries in parts to implement.
2017-08-30 PracticeBoardV1--Added 2 series 2AA batteries--Added pwr supply option--Changed board layout to reflect those additions
    [PracticeBoardV1.brd, PracticeBoardV1.sch]
2017-08-30 PracticeBoardV1--renumbered parts
    [PracticeBoardV1.brd, PracticeBoardV1.sch]
2017-08-31 Touch ups to Practice Board to fix DFM problems. Changed the TPS63001 package to get rid of DFM errors.
    [PracticeBoardV1.brd, PracticeBoardV1.sch]
2017-08-31 Adding all of the latest gerbers. Going to expand on this, but this is a first step to having a back-ed up version on github of every board and it's manufacturing files exactly as ordered.
    [AccessPanelV4.GBL, AccessPanelV4.GBO, AccessPanelV4.GBS, AccessPanelV4.GTL, AccessPanelV4.GTO, AccessPanelV4.GTS, PracticeBoardV1.GBL, PracticeBoardV1.GBO]
2017-09-01 Fixed bottom silkscreen of RBFPanelV1 that refered to it as ABF Panel. Added Gerber .zip files to directories. All Solar Panels and Practice board are ready for order
    [RBFPanelV1.brd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]
2017-09-03 Updates to programmer board with correct connector, addition of TVS diodes, modified layout, and updated silkscreen.
    [ProgrammerBoardV1_1.brd, ProgrammerBoardV1_1.sch]
2017-09-04 Initial commit of Battery Board V2. Removed almost all V1 layout, changed lion chargers to -4.2 PN but not updated circuitry. Rotated lion batteries. Removed superfluous vias. Started LDO circuit all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
    [BatteryBoardV2.brd, BatteryBoardV2.sch]
2017-09-05 Finished programmer board and added output files to repo. Addiong of LDOs and continued fixes and updates to battery board v2.
    [BatteryBoardV2.brd, BatteryBoardV2.sch, ProgrammerBoardV1_1.brd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]
2017-09-05 Continued addition of changes to battery board v2. Small updates to library including some part descriptions.
    [BatteryBoardV2.brd, BatteryBoardV2.sch]
2017-09-10 Continued improvements to the Battery Board schematic. Board reshaped.
    [BatteryBoardV2.brd, BatteryBoardV2.sch]
2017-09-19 Added #2 MTG part to BSE libary. Added 2016L PTC fuse part to BSE library. Adjusted BSE libary part descriptions. Added net classes, lifepo current sense and fusing, schematic clean up, mounting part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
    [BatteryBoardV2.brd, BatteryBoardV2.sch]
2017-09-20 Fixed the VQFN-14 Package (pins were reversed)
    Note, the AND circuit of the PracticeBoardV1 will not function
2017-09-24 Addition of zener diodes. Updates to some resistor values. Inital layout of all Li-ion circuitry.
    [BatteryBoardV2.brd, BatteryBoardV2.sch]
2017-09-25 Finished inital placement of all components on the battery board. Updated pull-down values for high-side switch input resistor.
    [BatteryBoardV2.brd, BatteryBoardV2.sch]
2017-09-29 Continued routing of Battery Board V2. Addition of a few extra debugging vias. Addition of resistor dividers on li-ion charge commands.
    [BatteryBoardV2.brd, BatteryBoardV2.sch]
2017-09-29 Finished Battery Board V2. Verified all nets connected, silkscreens are readable, axes identified, no overlapping polygons. Created Gerber files, Gerber zip, and schematic pdf.
    [BatteryBoardV2.brd, BatteryBoardV2.sch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]
2017-09-30 Fixing board outline problem for manufacturability.
    [BatteryBoardV2.brd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]
2017-10-26 Addition of CntrlBoardV3 Version B files, which are assembly variants of the the board (i.e. no pcb change).
    [CntrlBoardV3B.brd, CntrlBoardV3B.sch]
2017-12-19 Updating schematic for battery board, adding schematic for flight configuration
    [BatteryBoardV2B.brd, BatteryBoardV2B.sch]
2017-12-20 putting in correct directory
    [BatteryBoardV2B.brd, BatteryBoardV2B.sch]
2017-12-20 take 4
    [BatteryBoardV2B.brd]
2018-01-27 Initial Commit of Battery Board V3. Made all changes in schematic and removed invalid polygon pours on board.
    [BatteryBoardV3.brd, BatteryBoardV3.sch]
2018-01-28 Placing diodes and some resistors/caps
    Diodes placed + routed, as close to their respective chargers as
    possible
    [BatteryBoardV3.brd]
2018-01-28 Adding soldering footprint for LiFePo current sense resistor
2018-01-28 Completed layout
    [BatteryBoardV3.sch]
2018-01-29 100K pulldowns for unused GPIO expander pins
    [BatteryBoardV3.brd, BatteryBoardV3.sch]
2018-01-29 move R64 silkscreen
    [BatteryBoardV3.brd]
2018-01-29 one GPIO pin wasn't connected
    [BatteryBoardV3.brd]
2018-01-30 Fixed a polygon collision. Produced output files for Battery Board V3. Running DFM check now.
    [BatteryBoardV3.brd, BatteryBoardV3.sch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]
2018-04-09 +LM2576 regulator
2018-04-09 Package fixes, small updates to schematic
    [RomeBoardV1.brd, RomeBoardV1.sch]
2018-04-10 12V->5V regulator
    Adding 12V->5V regulator circuit to schematic. All parts added to
    library
    [RomeBoardV1.brd, RomeBoardV1.sch]
2018-04-11 Adding more parts + moving layout around
    [RomeBoardV1.brd, RomeBoardV1.sch]
2018-04-11 Reorganizing regulator
    [RomeBoardV1.brd]
2018-04-13 Adding connectors + LED circuits
    [RomeBoardV1.brd, RomeBoardV1.sch]
2018-04-13 NPN -> NMOS
    [RomeBoardV1.brd, RomeBoardV1.sch]
2018-04-17 Board layed out but unrouted
    [RomeBoardV1.sch]
2018-04-21 Updating inductor and diode
2018-04-23 Board + Schematic routed
    [RomeBoardV1.brd, RomeBoardV1.sch]
2018-04-24 Improved routing, added silkscreen infos
    [RomeBoardV1.brd, RomeBoardV1.sch]
2018-04-24 bottom side of board was not straight
    [RomeBoardV1.brd]
2018-04-25 Small improvements
    [RomeBoardV1.brd]
2018-04-27 V1.1 initial commit
    [RomeBoardV1.1.brd, RomeBoardV1.1.sch]
2018-04-27 fixing air wire + updating library
    [RomeBoardV1.1.brd, RomeBoardV1.1.sch]
2018-04-30 for review
    [RomeBoardV1.1.brd]
2018-04-30 Adding fan connectors to board, increasing board size, re-routing some stuff
    [RomeBoardV1.1.brd, RomeBoardV1.1.sch]
2018-04-30 Adding gate pulldowns for NPNs
    [RomeBoardV1.1.brd, RomeBoardV1.1.sch]
2018-04-30 adding vias and moving silkscreen around a bit
    [RomeBoardV1.1.brd, RomeBoardV1.1.sch]
2018-04-30 Adding rev B board
    Major change - Pi no longer soldered to board, but instead a ribbon
    cable is used to connect the Pi to the board.
    [RomeBoardV1.1B.brd, RomeBoardV1.1B.sch]
2018-05-02 final version of 1.1B (pending very minor changes)
    [RomeBoardV1.1.brd, RomeBoardV1.1B.brd, RomeBoardV1.1B.sch]
2018-05-04 Silkscreen + Via
    [RomeBoardV1.1B.brd, RomeBoardV1.1B.sch]
2018-05-04 small change
    [RomeBoardV1.1B.brd]
2018-07-16 Adding RomeBoard v1.2
    [RomeBoardV1.2.brd, RomeBoardV1.2.sch]
2018-07-18 Rome Board v1.2 updates
    [RomeBoardV1.2.brd, RomeBoardV1.2.sch]
2018-07-19 Silkscreen tweaks
    [RomeBoardV1.2.brd]
2019-03-11 Added edge connector to new FutureSat library; added MotherBoardV1 (WIP); reorgainzed all folders to separate EQUiSat and FutureSat
    [3518-eagle.sch, 3518.sch, AccessPanelV1.brd, AccessPanelV1.sch, AccessPanelV2.brd, AccessPanelV2.sch, AccessPanelV3.brd, AccessPanelV3.sch]
2019-03-18 Edge connector
    EM12DRXH
    RBB30DHHN
2019-04-01 Add edge connector (WIP)
